nbruite/vacuum/2-采购合同/塑料件/塑料模具报价单/塑料模具报价清单-何国芳.jpg

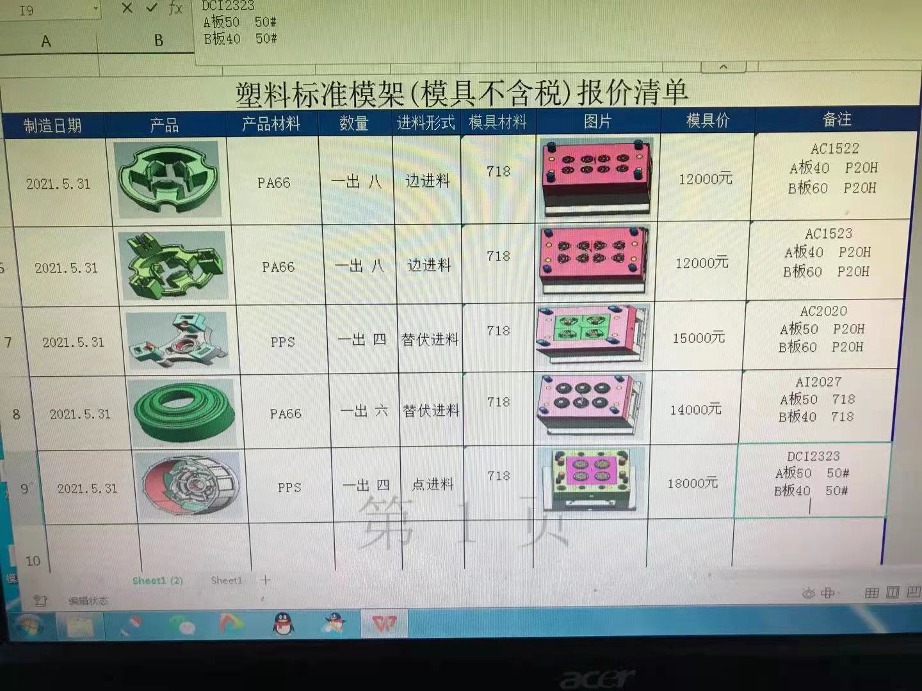
2-采购合同/塑料件/塑料模具报价单/塑料模具报价清单-何国芳.jpg
