nbruite/vacuum/2-采购合同/胶水/科宝胶水1.jpg

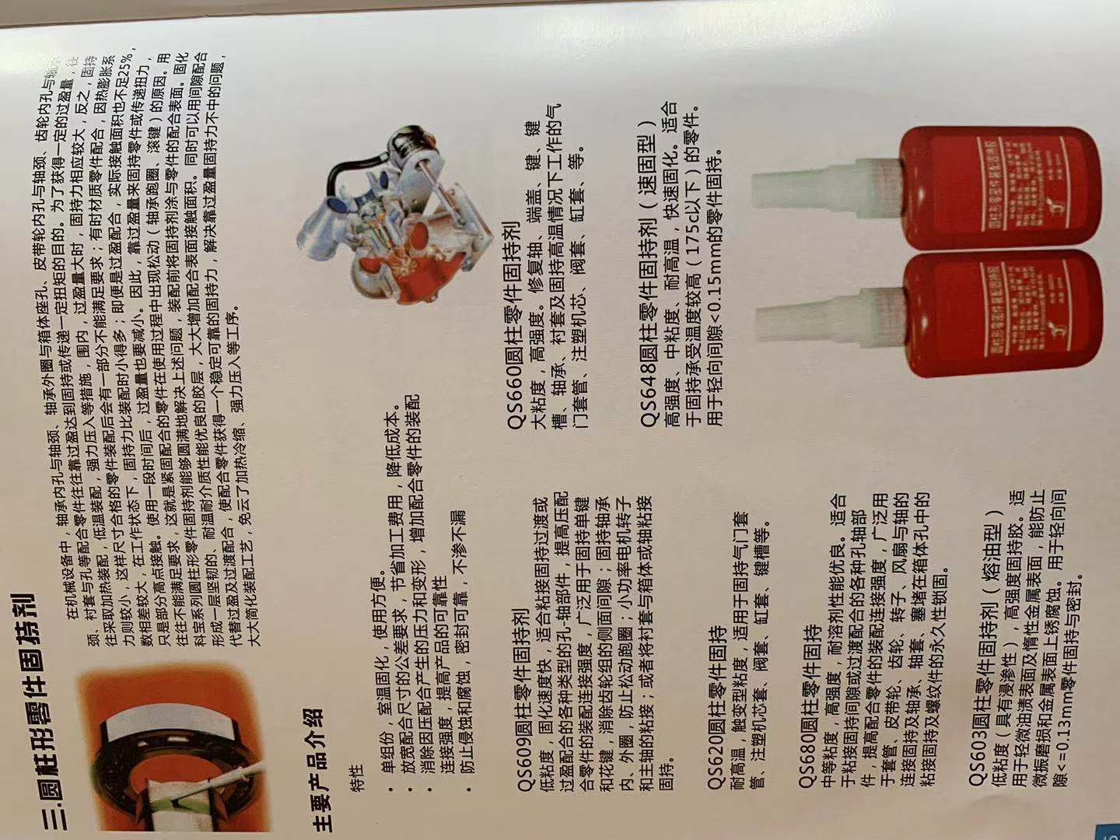
2-采购合同/胶水/科宝胶水1.jpg
