nbruite/vacuum/README.md

# vacuum
吸尘器电机项目 
### 样品阶段  
- 每日更新`吸尘器风机BOM`  
- 每日更新`当前进展&问题`
