nbruite/vacuum/3-加工图纸/2-晨光（A型）/4-方案四/方案4-2021.5.20/方案四图纸说明.txt

方案四图纸说明：
1、T型垫片，由于3D打印误差，高度暂时改为3.5mm，后续开模需要改为3mm；
2、前后端盖部分尺寸由于3D打印误差而放大，后续开模需要重新校对尺寸
