nbruite/vacuum/4-电机测试/塑料成分分析/宁波市海曙锐特冲压制品 成分分析报告2021.6.9前端盖.pdf

# 检 测 报 告

报告编号：NBPTC2106078001005-002MA | 第 1 页 共 2 页

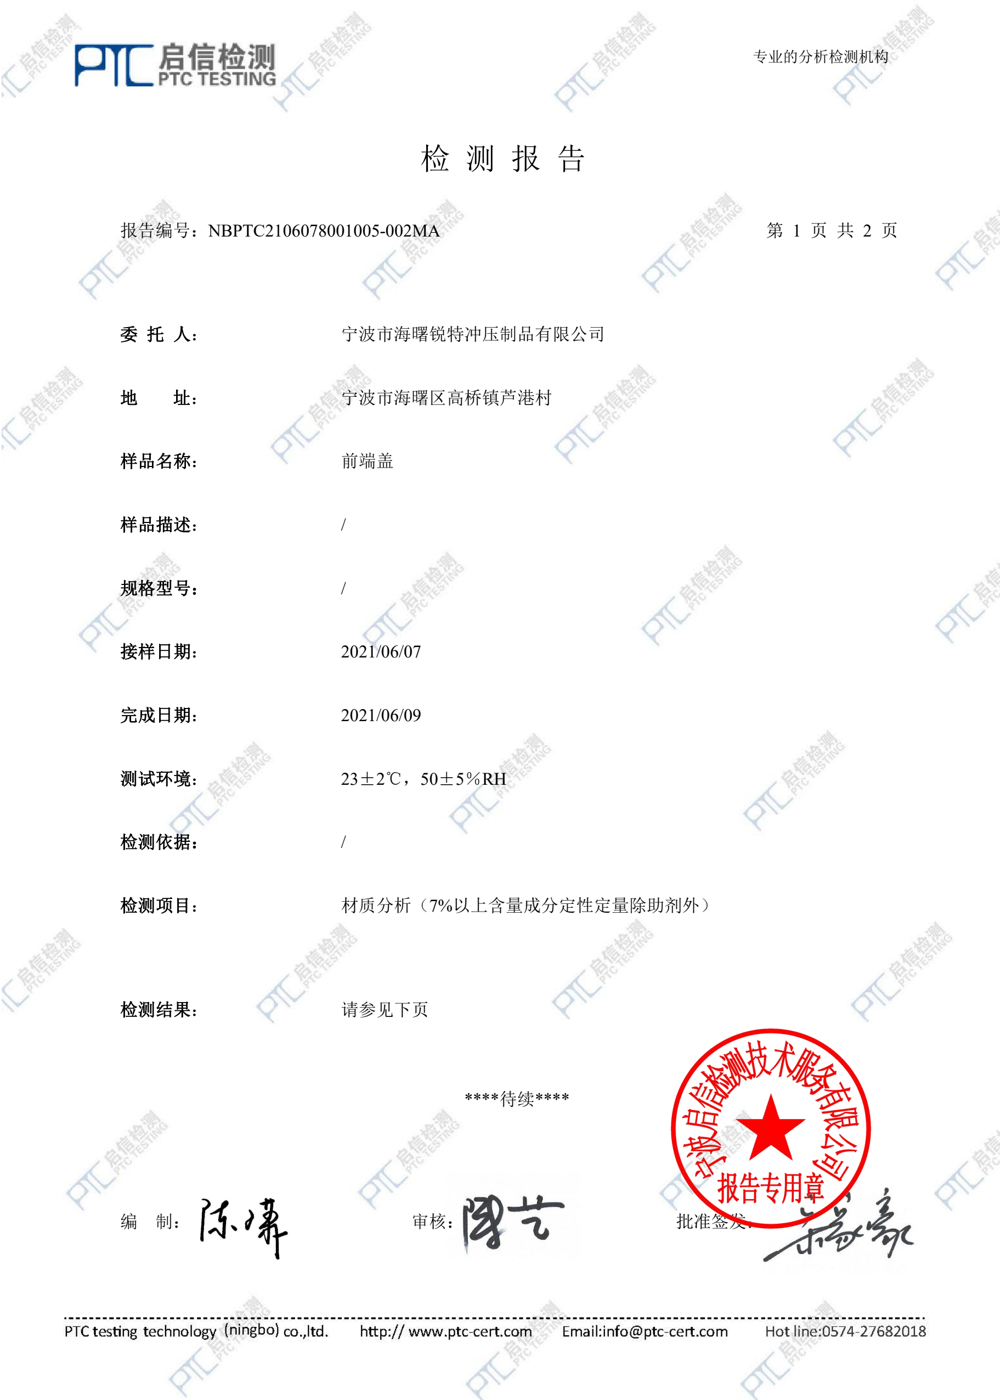
[picture p5: page 1]

专业的分析检测机构

委 托 人： | 宁波市海曙锐特冲压制品有限公司
地 | 址： | 宁波市海曙区高桥镇芦港村
样品名称： | 前端盖
样品描述： | /
规格型号： | /
接样日期： | 2021/06/07
完成日期： | 2021/06/09
测试环境： | 23±2℃，50±5％RH
检测依据： | /
检测项目： | 材质分析（7%以上含量成分定性定量除助剂外）
检测结果： | 请参见下页
****待续**** 编 制： | 审核： | 批准签发：

# 检 测 报 告

报告编号：NBPTC2106078001005-002MA | 第 2 页 共 2 页

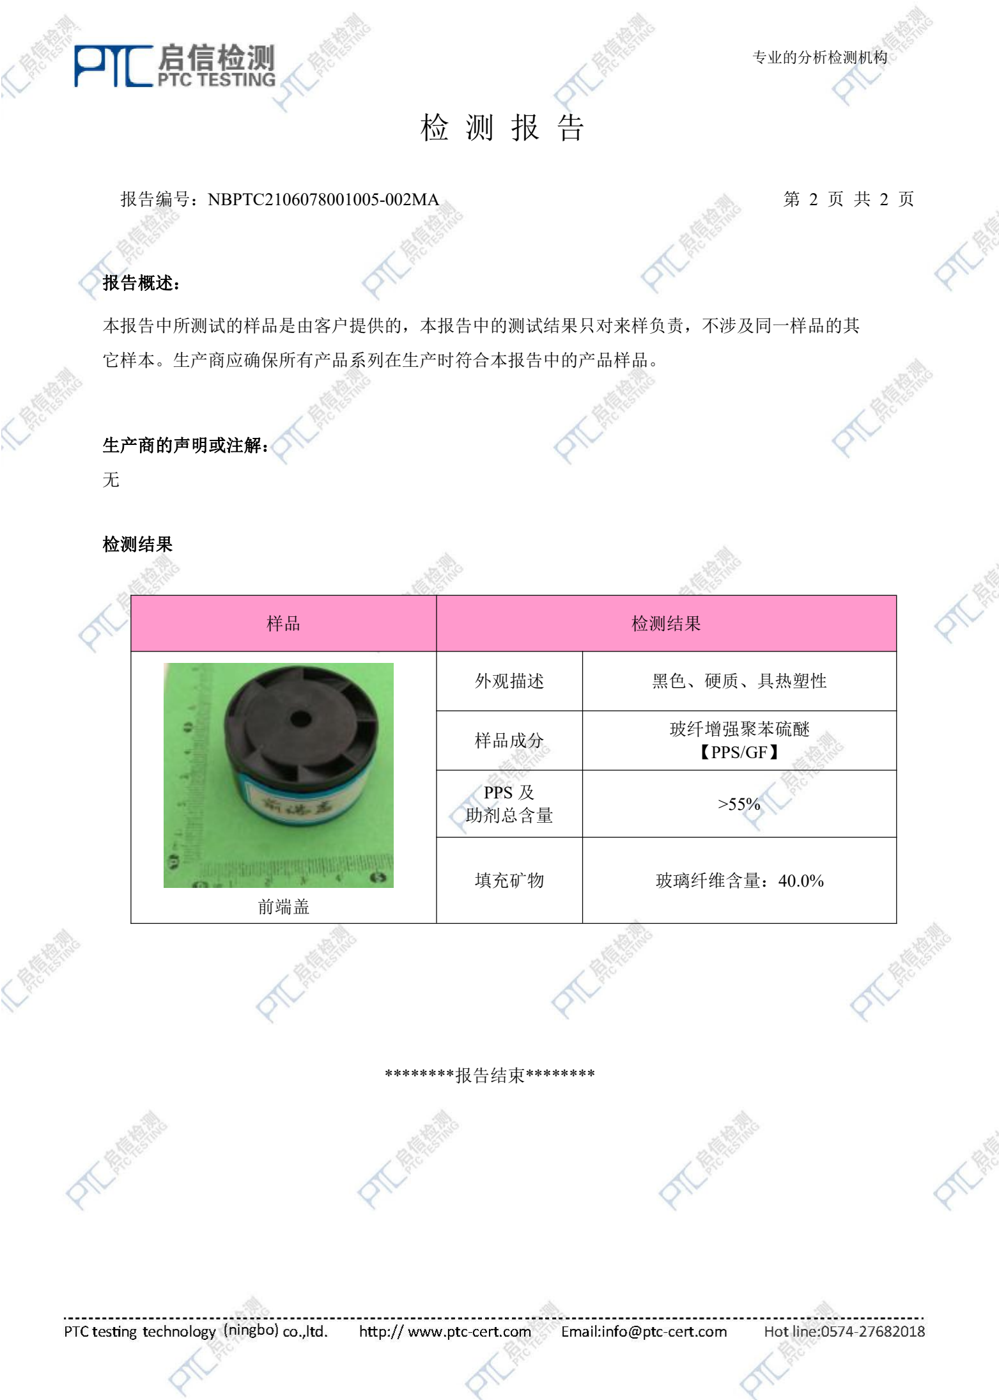
[picture p6: page 2]

专业的分析检测机构

报告概述：

本报告中所测试的样品是由客户提供的，本报告中的测试结果只对来样负责，不涉及同一样品的其

它样本。生产商应确保所有产品系列在生产时符合本报告中的产品样品。

生产商的声明或注解：

无

检测结果

## ********报告结束********

样品 | 检测结果
前端盖 | 外观描述 | 黑色、硬质、具热塑性
| 样品成分 | 玻纤增强聚苯硫醚 【PPS/GF】
| PPS 及 助剂总含量 | >55%
| 填充矿物 | 玻璃纤维含量：40.0%
