nbruite/vacuum/当前进展&问题.md

# 进展说明  

-----
## 2021.3.11  
### 进展：  
1. **磁钢**询问金科和鑫丰磁业，由于尺寸特殊，金科没有现货，鑫丰预计<b><font color=red>3月底</font></b>做完，等待询问永久磁业；  
2. 测绘晨光电机和戈雷姆电机的**前端盖**，<b><font color=red>下周一</font></b>取图纸； 
3. **T型垫柱**买铝棒车，**圆垫片**买铝片激光切割，**铜端子**买铜片激光切割，<b><font color=red>本周</font></b>完成；  
4. **定子铁芯**已出图纸，等待激光切割，<b><font color=red>本周</font></b>完成。    

### 遗留问题：  
1. **nmb轴承**当前零售采购价`3.2元/个`，价格较高，后期需要与厂家协商降低成本；  
2. 等待下周一出图纸后，联系浙大老师评估三款**前端盖风道**好坏；  
3. `M3厚度为4`的**六角螺母**标准件支持最大厚度`2.4`，测试暂时用2个螺母叠加；  
4. 晨光电机使用**漆包线**外径`<0.71`，测试统一暂用`0.71`。  

## 2021.3.12  
### 进展：  
1. **叶轮**联系合丰电器，预计**下周一**寄出`5个`样品；  
2. **风罩**、**前后端盖**、**上下骨架**联系宁波创辉3D打印公司制作，先做`1套`样品，**四个工作日**完成。  

### 遗留问题：  
1. **nmb轴承**当前零售采购价`3.2元/个`，价格较高，后期需要与厂家协商降低成本；  
2. 等待下周一出图纸后，联系浙大老师评估三款**前端盖风道**好坏；  
3. `M3厚度为4`的**六角螺母**标准件支持最大厚度`2.4`，测试暂时用2个螺母叠加；  
4. 晨光电机使用**漆包线**外径`<0.71`，测试统一暂用`0.71`；  
5. 轴承厂还在寻找找到合适的。 

## 2021.3.15  
### 进展：  
1. **叶轮**已发货；  
2. **风道**扫描出图纸，已经联系浙大老师评估；  

### 遗留问题：  
1. **nmb轴承**当前零售采购价`3.2元/个`，价格较高，后期需要与厂家协商降低成本；  
2. `M3厚度为4`的**六角螺母**标准件支持最大厚度`2.4`，测试暂时用2个螺母叠加；  
3. 晨光电机使用**漆包线**外径`<0.71`，测试统一暂用`0.71`；  
4. 轴承厂目前只有宁波奉化荣锋悦五金厂可以做；  
5. **叶轮**需要联系合丰电器要`9个`叶片的样品。   

## 2021.3.16  
### 进展：  
1. 联系合丰电器定了`8`叶片的**叶轮**，苏州弗来特询问后不愿意做；  
2. 新联系**轴**厂家，明天报价。  

### 遗留问题：  
1. **nmb轴承**当前零售采购价`3.2元/个`，价格较高，后期需要与厂家协商降低成本；  
2. `M3厚度为4`的**六角螺母**标准件支持最大厚度`2.4`，测试暂时用2个螺母叠加；  
3. 晨光电机使用**漆包线**外径`<0.71`，测试统一暂用`0.71`。  

## 2021.3.17  
### 进展：  
1. 合丰电器`8`叶片的**叶轮**样品已寄出；  
2. 新联系的**轴**厂家生产任务排满，批量做报价`1.2元`；  
3. 激光切割件预计`3.22`完成；  
4. 3D打印和精雕件已完成，安排寄出。  

### 遗留问题：  
1. **nmb轴承**当前零售采购价`3.2元/个`，价格较高，后期需要与厂家协商降低成本；  
2. `M3厚度为4`的**六角螺母**标准件支持最大厚度`2.4`，测试暂时用2个螺母叠加；  
3. 晨光电机使用**漆包线**外径`<0.71`，测试统一暂用`0.71`。  

## 2021.3.18  
### 进展：  
1. 合丰电器`8`叶片**叶轮**已收到；  
2. 3D打印和精雕件已收到；  
3. 当前除**轴**和**磁钢**要月底左右到位，其余零部件下周内均可到位，可以启动安装调试。  

### 遗留问题：  
1. **nmb轴承**当前零售采购价`3.2元/个`，价格较高，后期需要与厂家协商降低成本；  
2. `M3厚度为4`的**六角螺母**标准件支持最大厚度`2.4`，测试暂时用2个螺母叠加；  
3. 晨光电机使用**漆包线**外径`<0.71`，测试统一暂用`0.71`；  
4. **轴**厂家需要再寻找，月底前完成。  

## 2021.3.26  
### 进展：  
1. 新增`吸尘器电机测试方案`;  
2. **轴**采购订单已下，预计4.12左右完成；  
3. 明天开始定转子装配测试  

### 遗留问题：  
1. **nmb轴承**当前零售采购价`3.2元/个`，价格较高，后期需要与厂家协商降低成本；  
2. `M3厚度为4`的**六角螺母**标准件支持最大厚度`2.4`，测试暂时用2个螺母叠加；  
3. 晨光电机使用**漆包线**外径`<0.71`，测试统一暂用`0.71`；  
4. 测试设备待协调；  
5. **轴**和**磁钢**到位较慢，先暂时用原有拆机件测试
