nbruite/vacuum/2-采购合同/T型垫片&六角螺母/单位名称.docx

单位名称：宁波市海曙古林明顺五金厂

税 号：92330203MA283KTA5Q

地 址：宁波市海曙区古林镇张家潭村 15158345558

开户银行及账号：宁波鄞州农村商业银行股份有限公司古林支行布政分理处 81260201302178626
