nbruite/vacuum/2-采购合同/塑料件/采 购 合 同(1).docx

采 购 合 同

买方：宁波市海曙锐特冲压制品有限公司

卖方：慈溪市掌起镇发发塑料五金厂

一.

产品名称 | 计量单位 | 数量 | 单价 | 备注
绝缘骨架 | 套 | 按订单 | 0.2元 | 上骨架0.07元，下骨架0.13元。上下2个为一套

2． 质量要求，技术标准：卖方按买方提供的技术图纸要求生产供货。
3． 包装标准：双方待定
4． 交货运输：卖方承担
5． 货款结算方式及期限：买方收到发票后，30天内支付货款
6． 解决合同纠纷约定法式：双方协商处理，协商不成依法向人民法院起诉。
7． 其他未尽事宜，双方另行协商。合同一式两份，双方各执一份。双方签字盖章后生效。

买方 ：宁波市海曙锐特冲压制品有限公司 卖方：慈溪市掌起镇发发塑料五金厂

地址： 地址：慈溪市掌起镇青山北1

电话： 电话：

联系人： 联系人：
