nbruite/vacuum/2-采购合同/T型垫片&六角螺母/PO2021080404-明顺五金-扫描.pdf

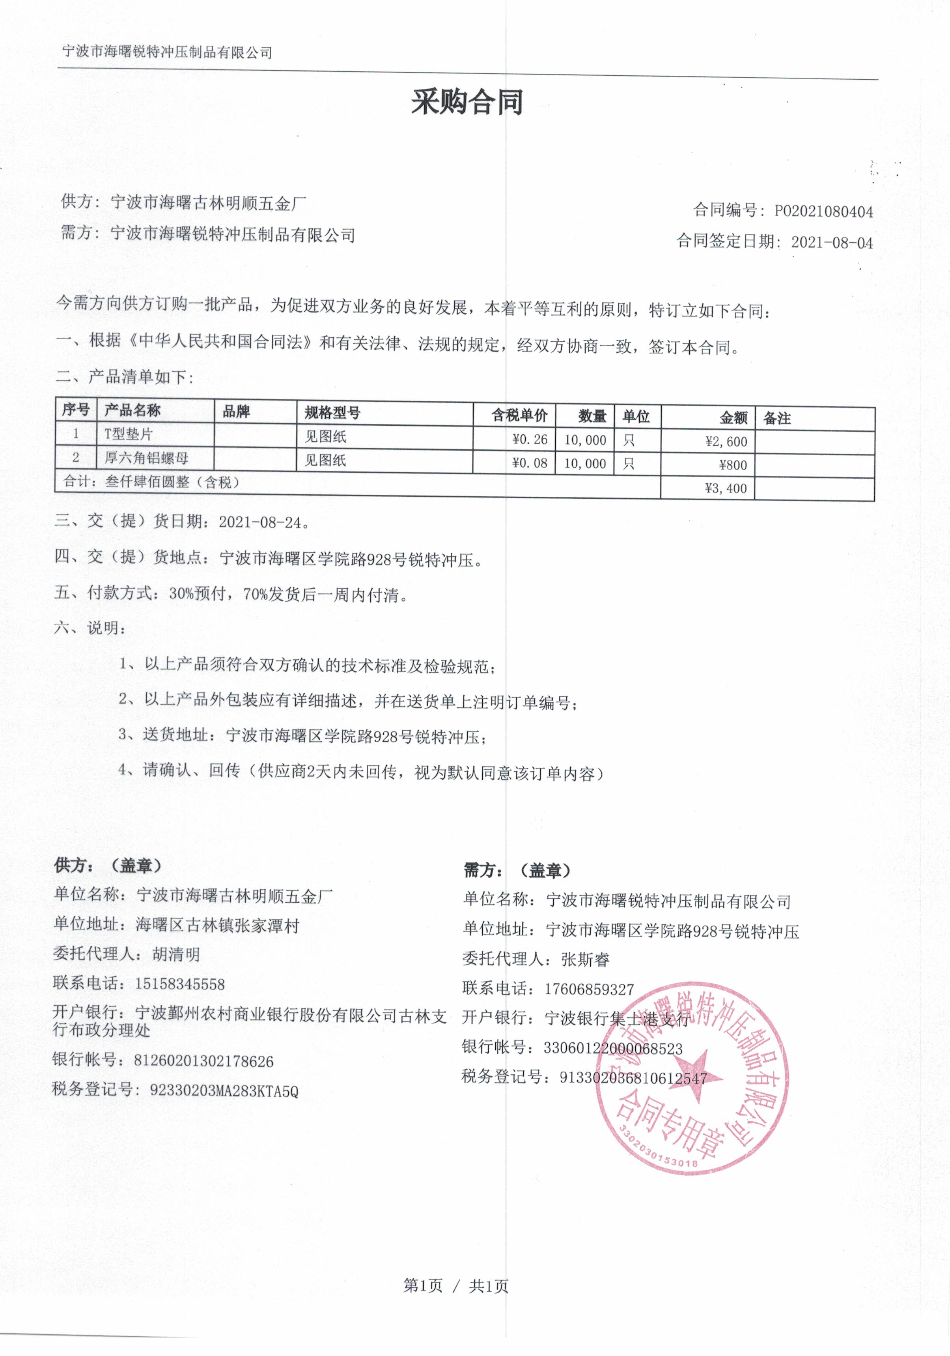
[picture p20: page 1]
