nbruite/vacuum/2-采购合同/动叶轮/C11382100DKCZ图纸-签字盖章.pdf

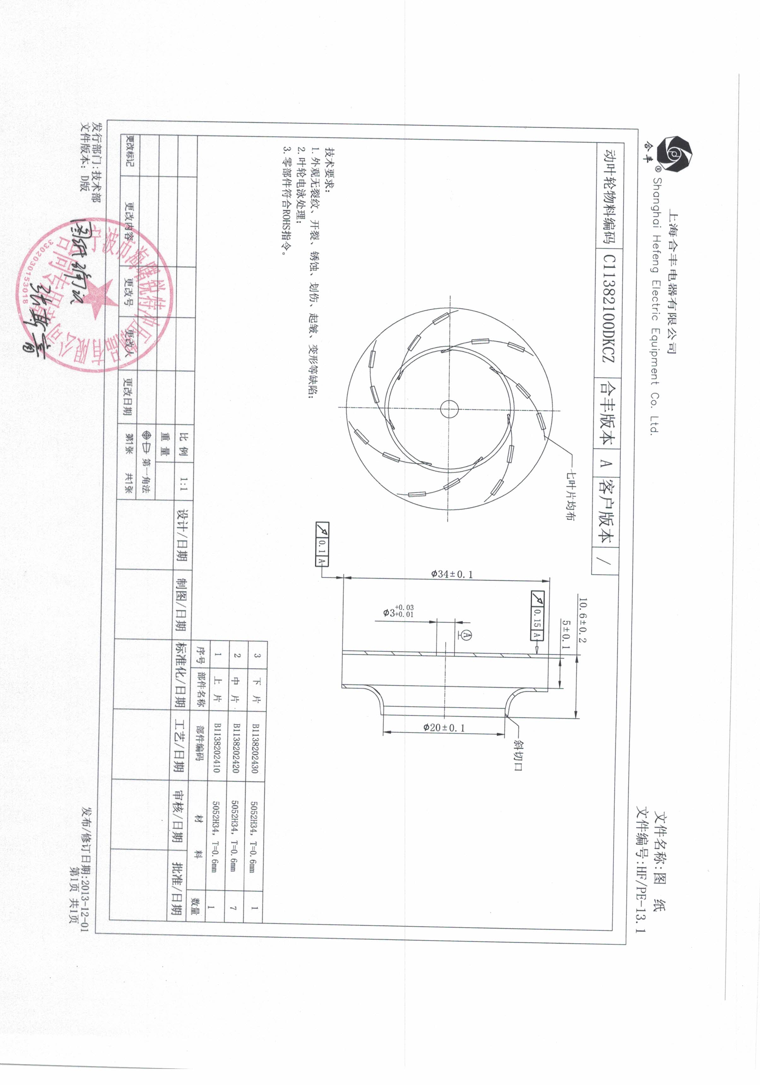
[picture p21: page 1]
