nbruite/vacuum/2-采购合同/动叶轮/PO2021080303-合丰电器采购合同-确认.pdf

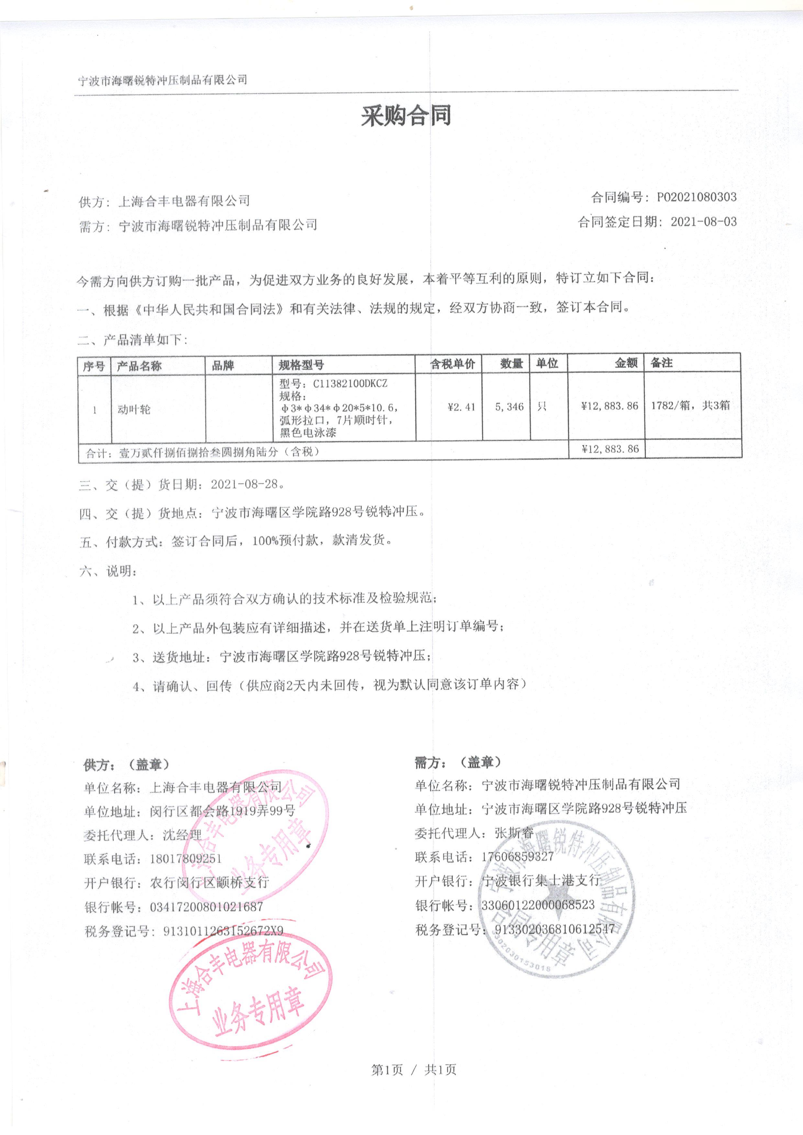
[picture p23: page 1]
