nbruite/vacuum/2-采购合同/动平衡机/动平衡机扫描合同.pdf

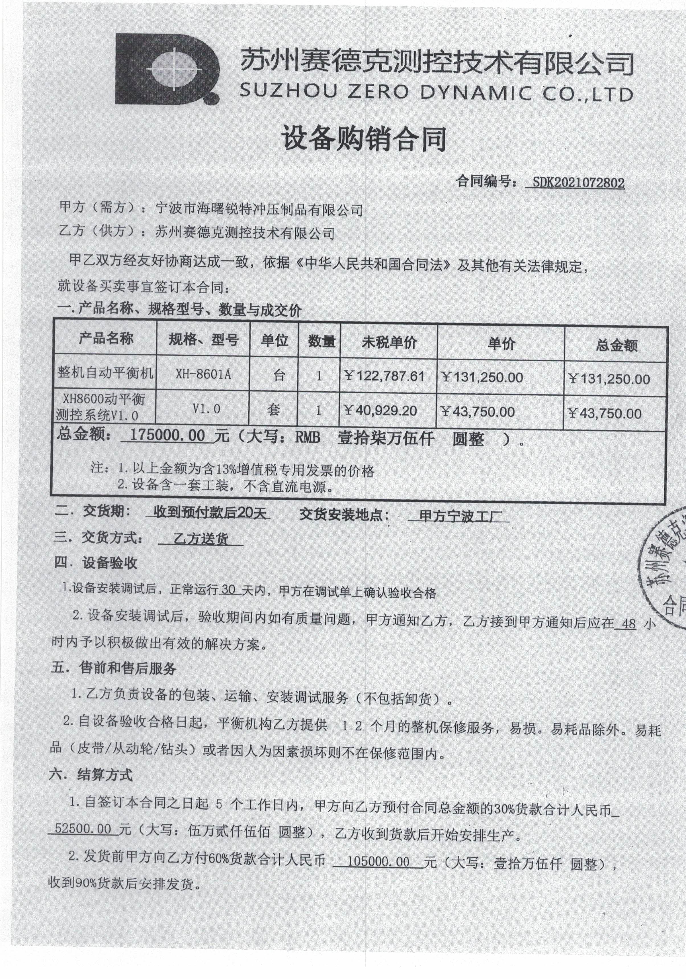
[picture p24: page 1]
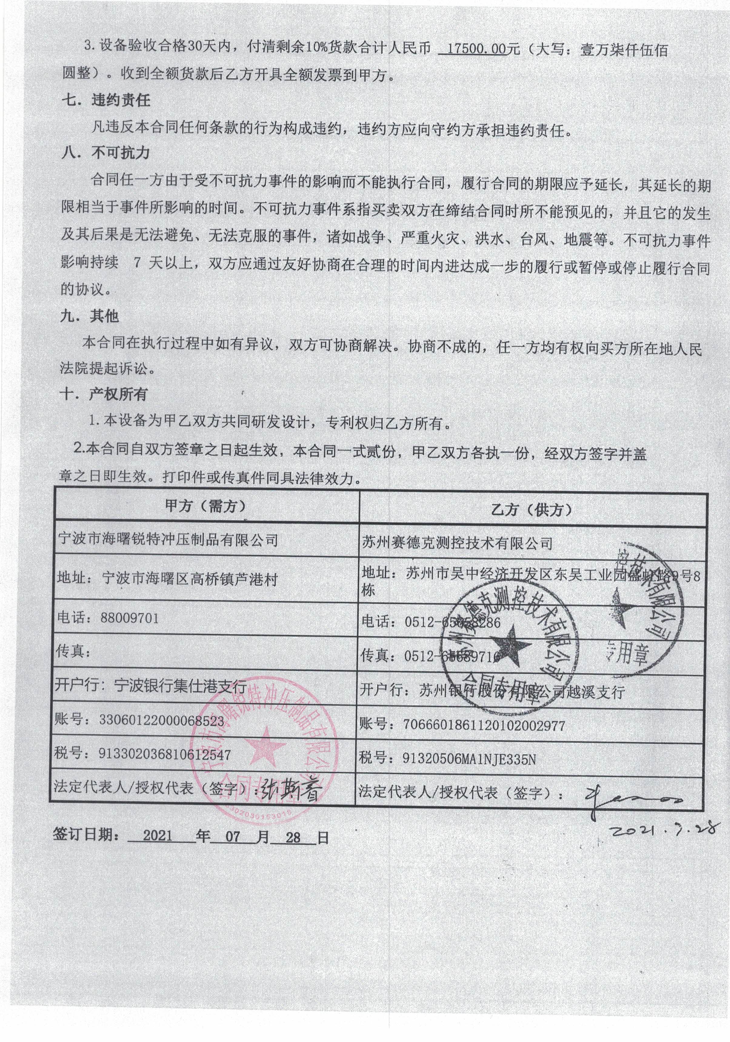
[picture p25: page 2]
