nbruite/vacuum/2-采购合同/磁钢/PO2021080405-慕磁-扫描.pdf

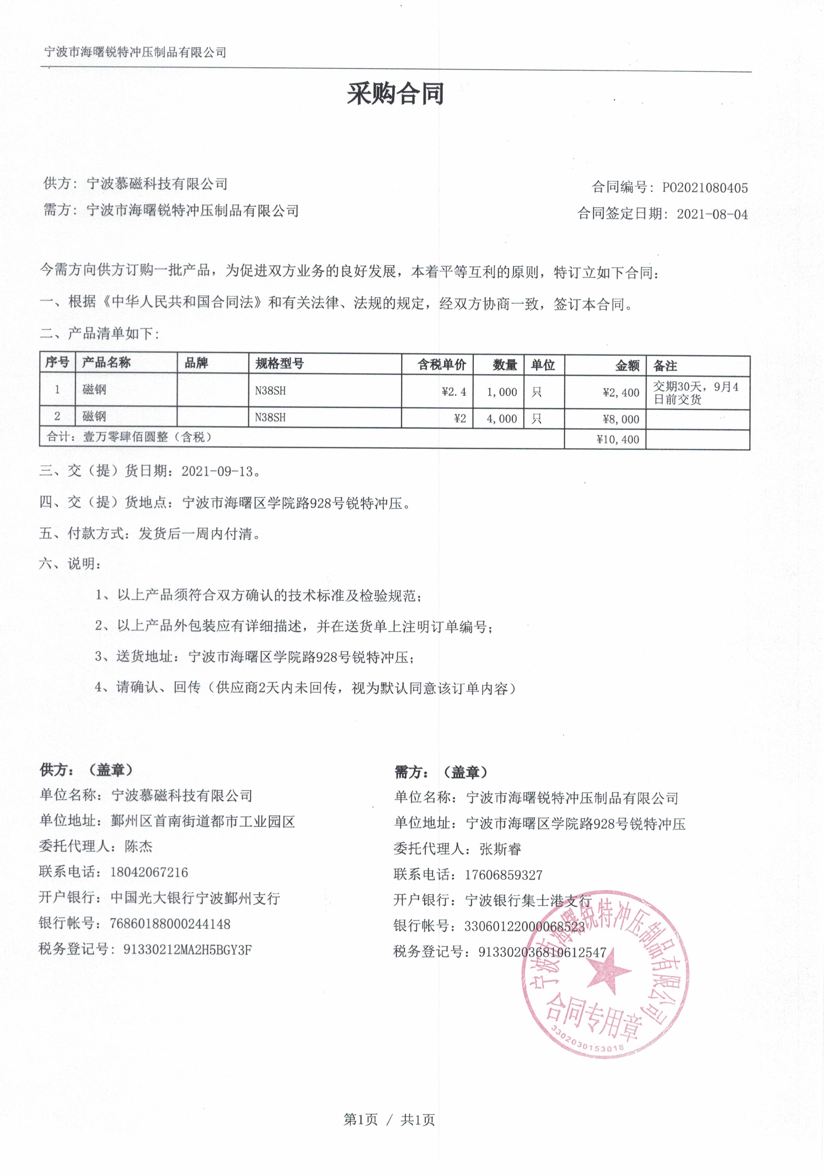
[picture p26: page 1]
