nbruite/vacuum/2-采购合同/磁钢/慕磁开票资料.pdf

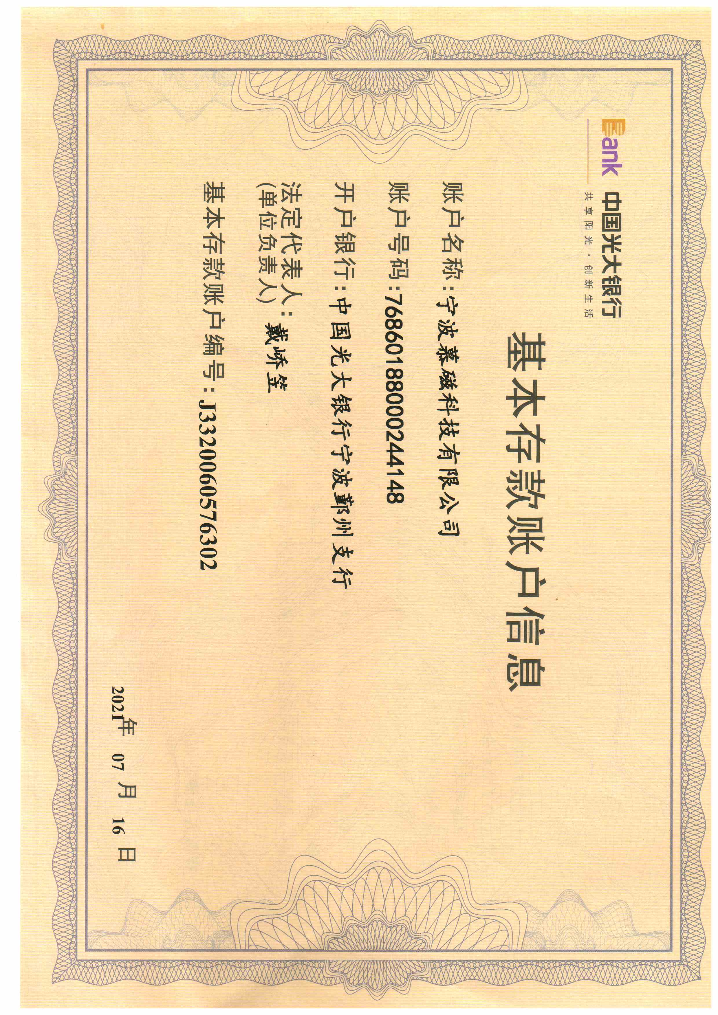
[picture p27: page 1]
