nbruite/vacuum/2-采购合同/磁钢/慕磁营业执照.pdf

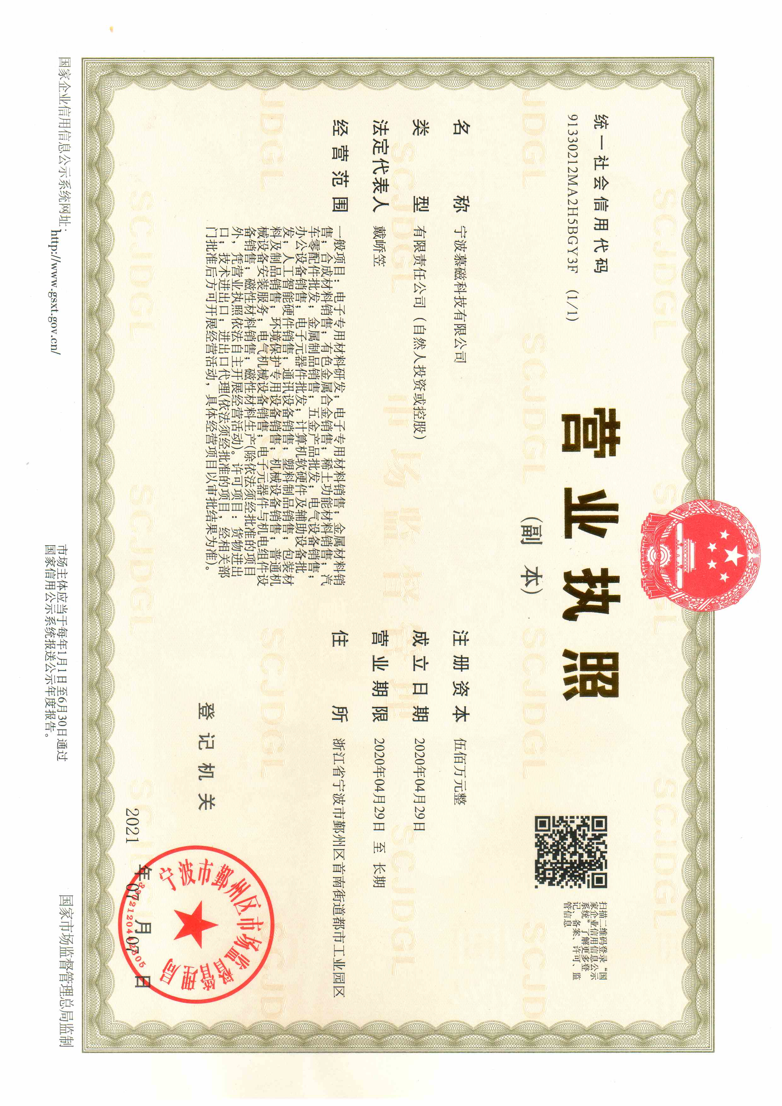
[picture p28: page 1]
