nbruite/vacuum/2-采购合同/紧固件/PO2021081001-利华紧固件-扫描.pdf

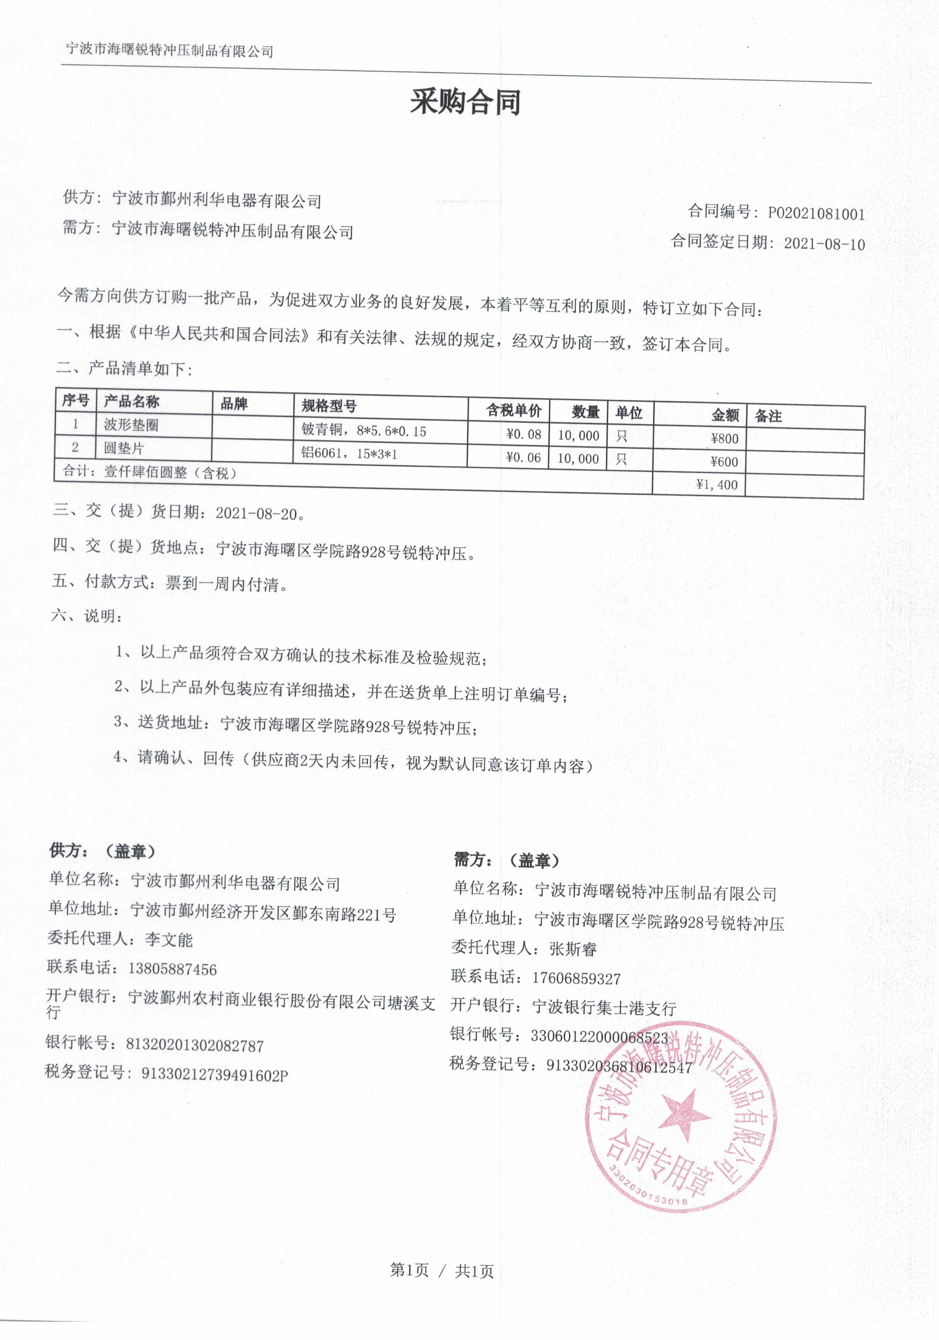
[picture p29: page 1]
