nbruite/vacuum/2-采购合同/轴/PO2021080501-科盛轴业-扫描.pdf

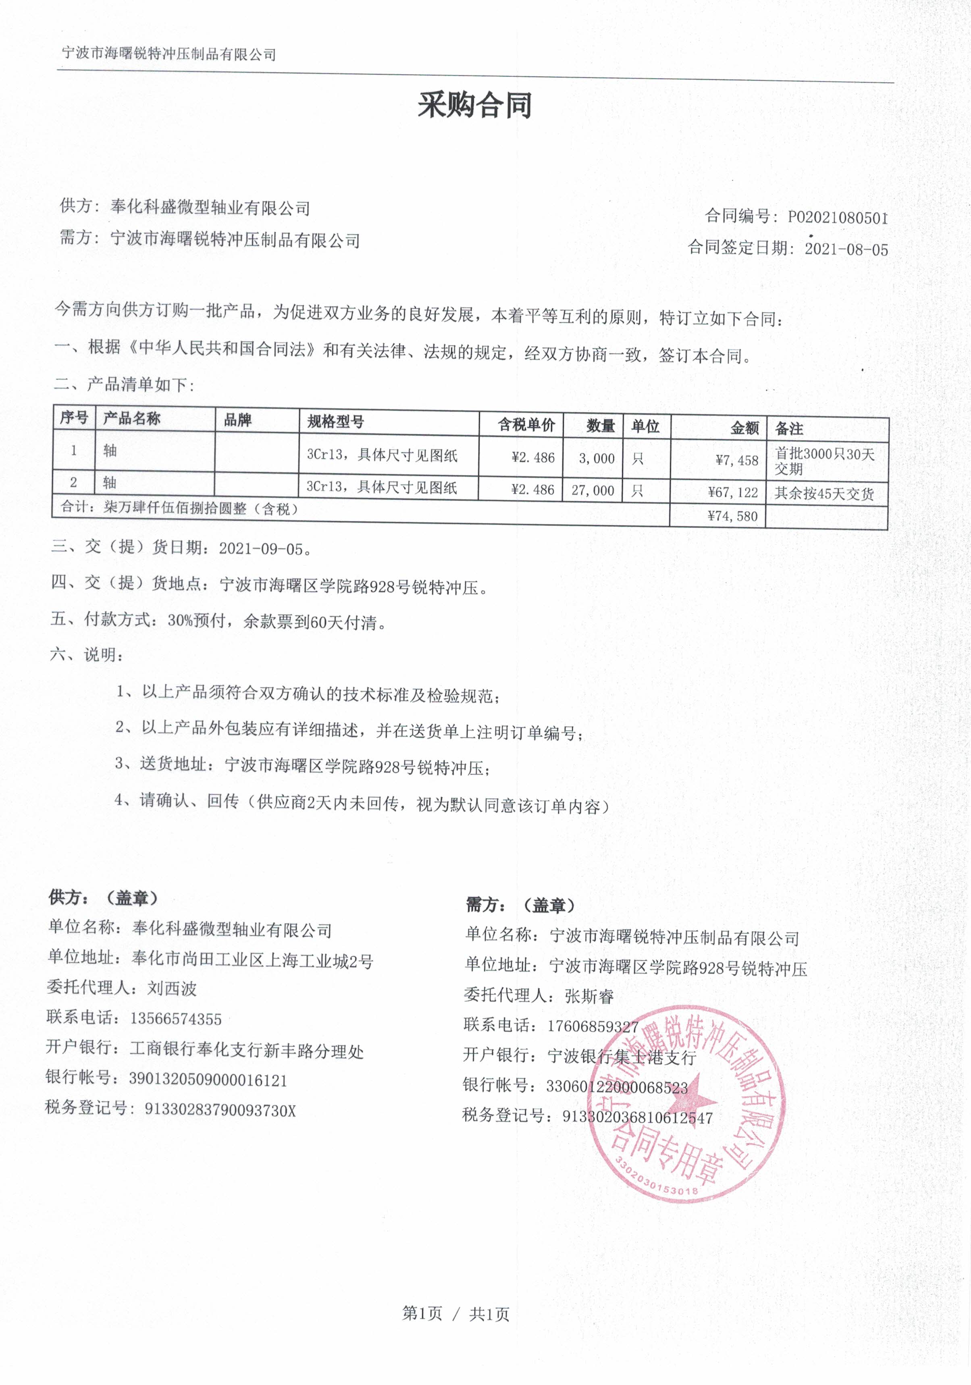
[picture p30: page 1]
