nbruite/vacuum/2-采购合同/轴/奉化科盛IATF16949证书.pdf

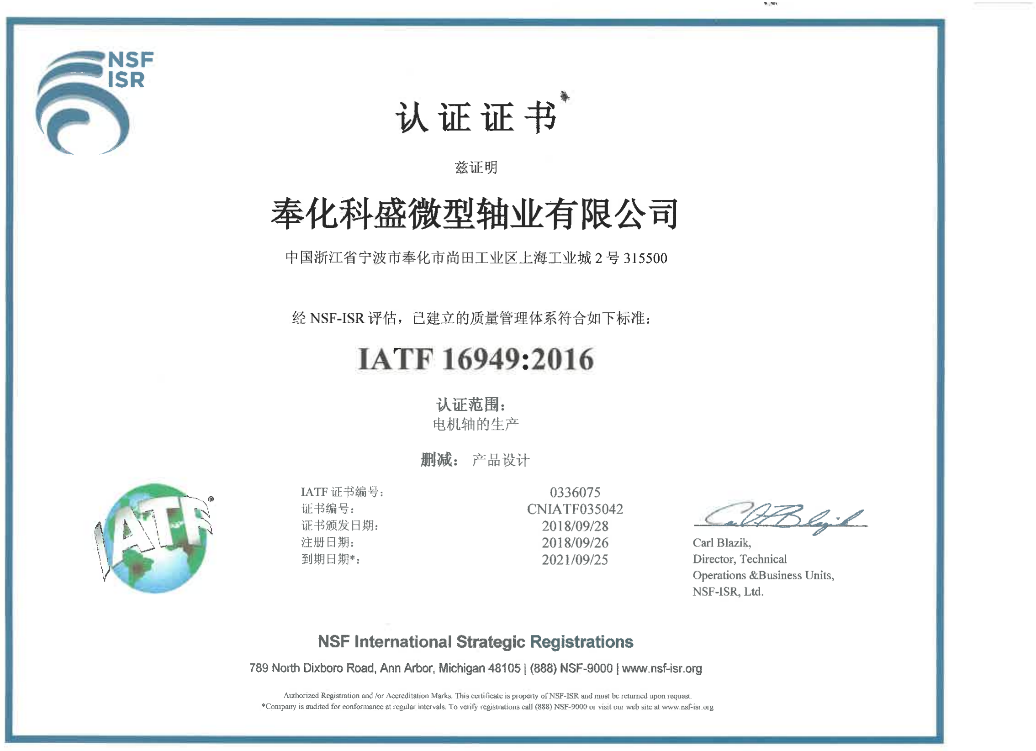
[picture p31: page 1]
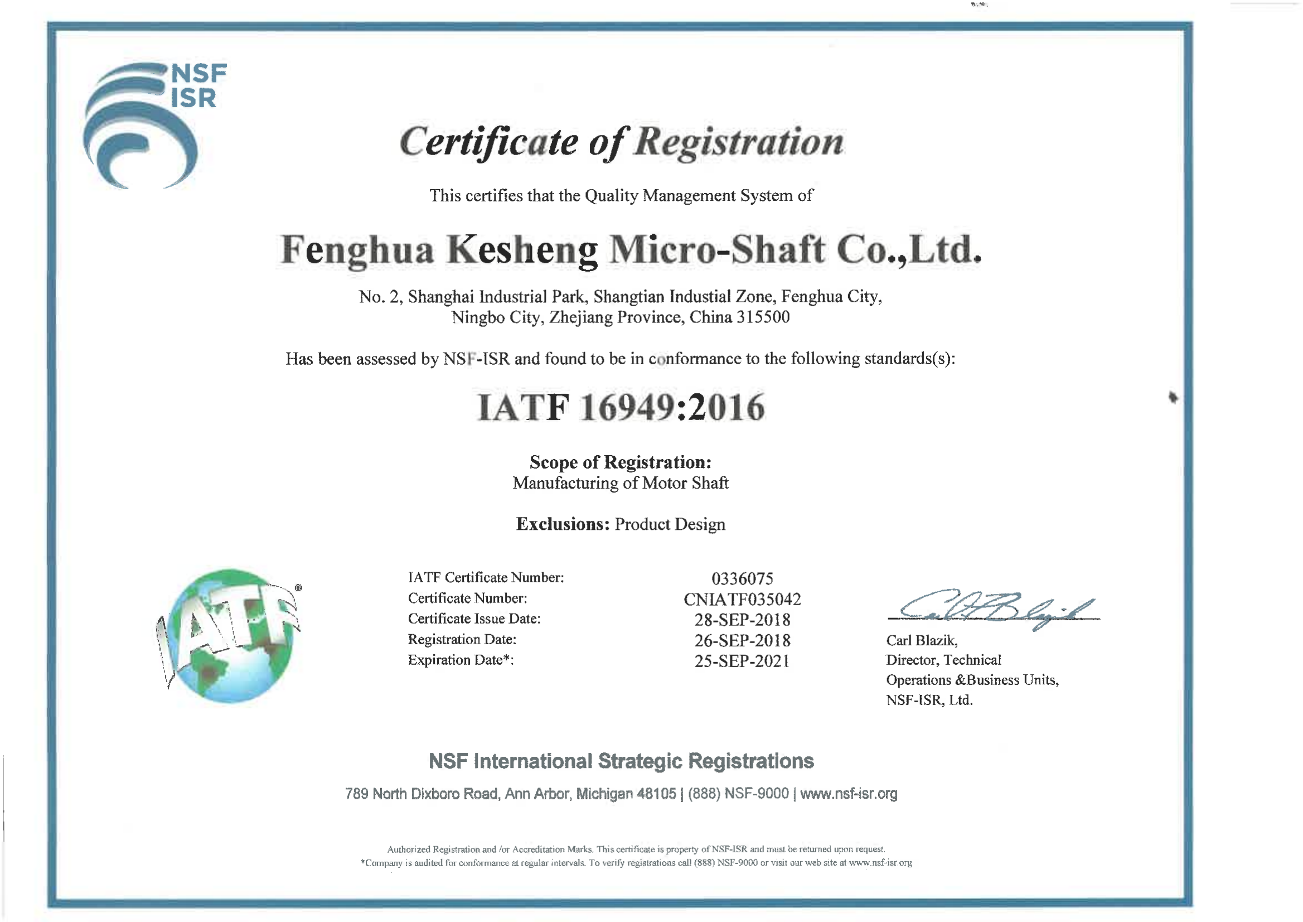
[picture p32: page 2]
