nbruite/vacuum/2-采购合同/动平衡机/8601A合同.pdf

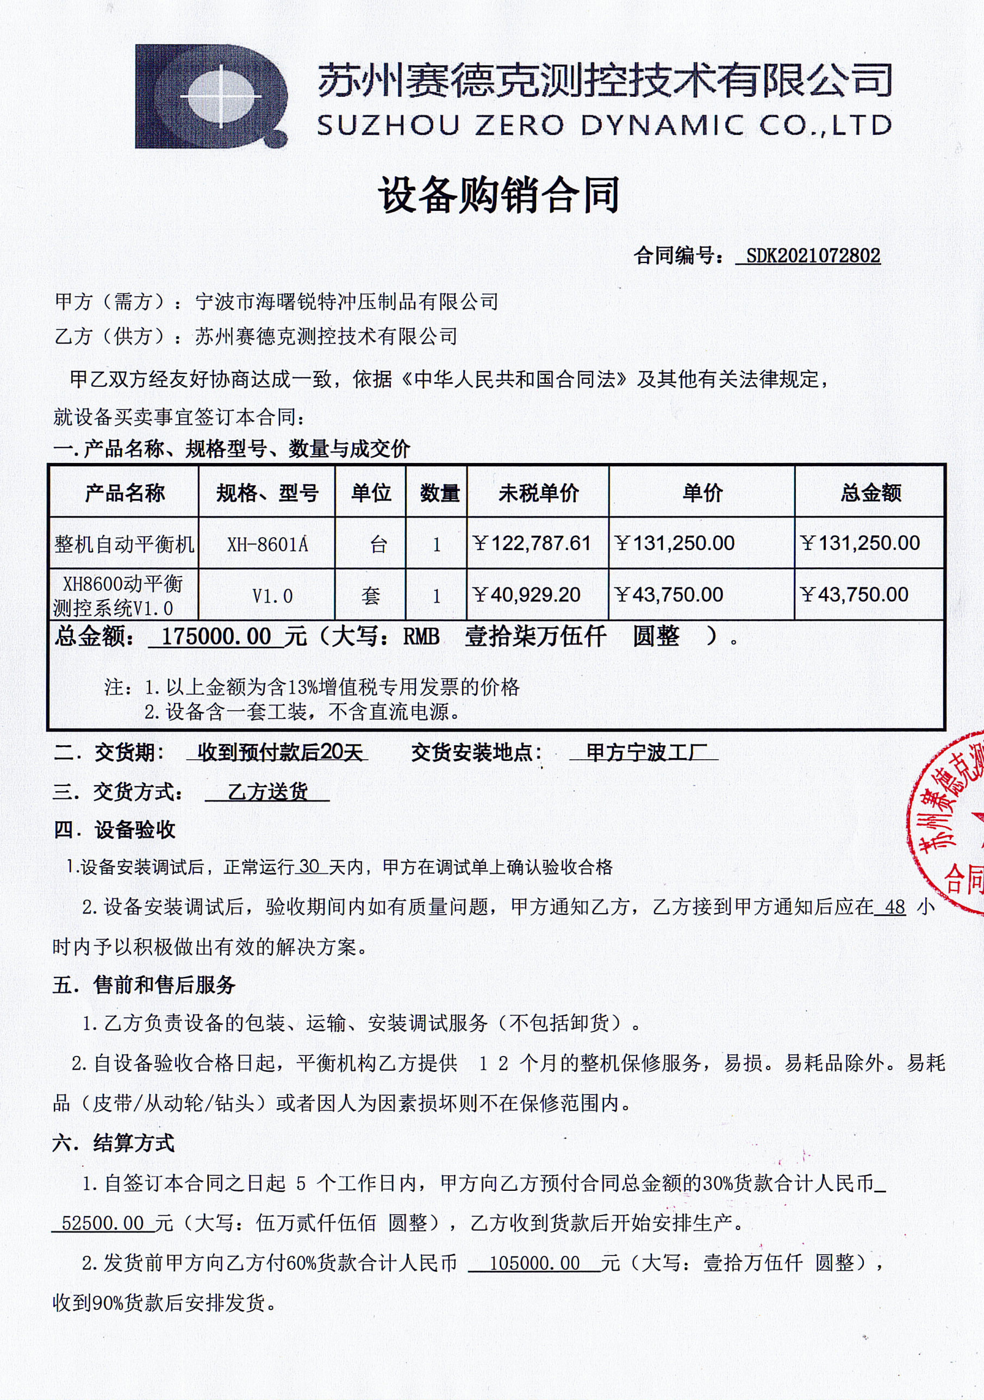
[picture p33: page 1]
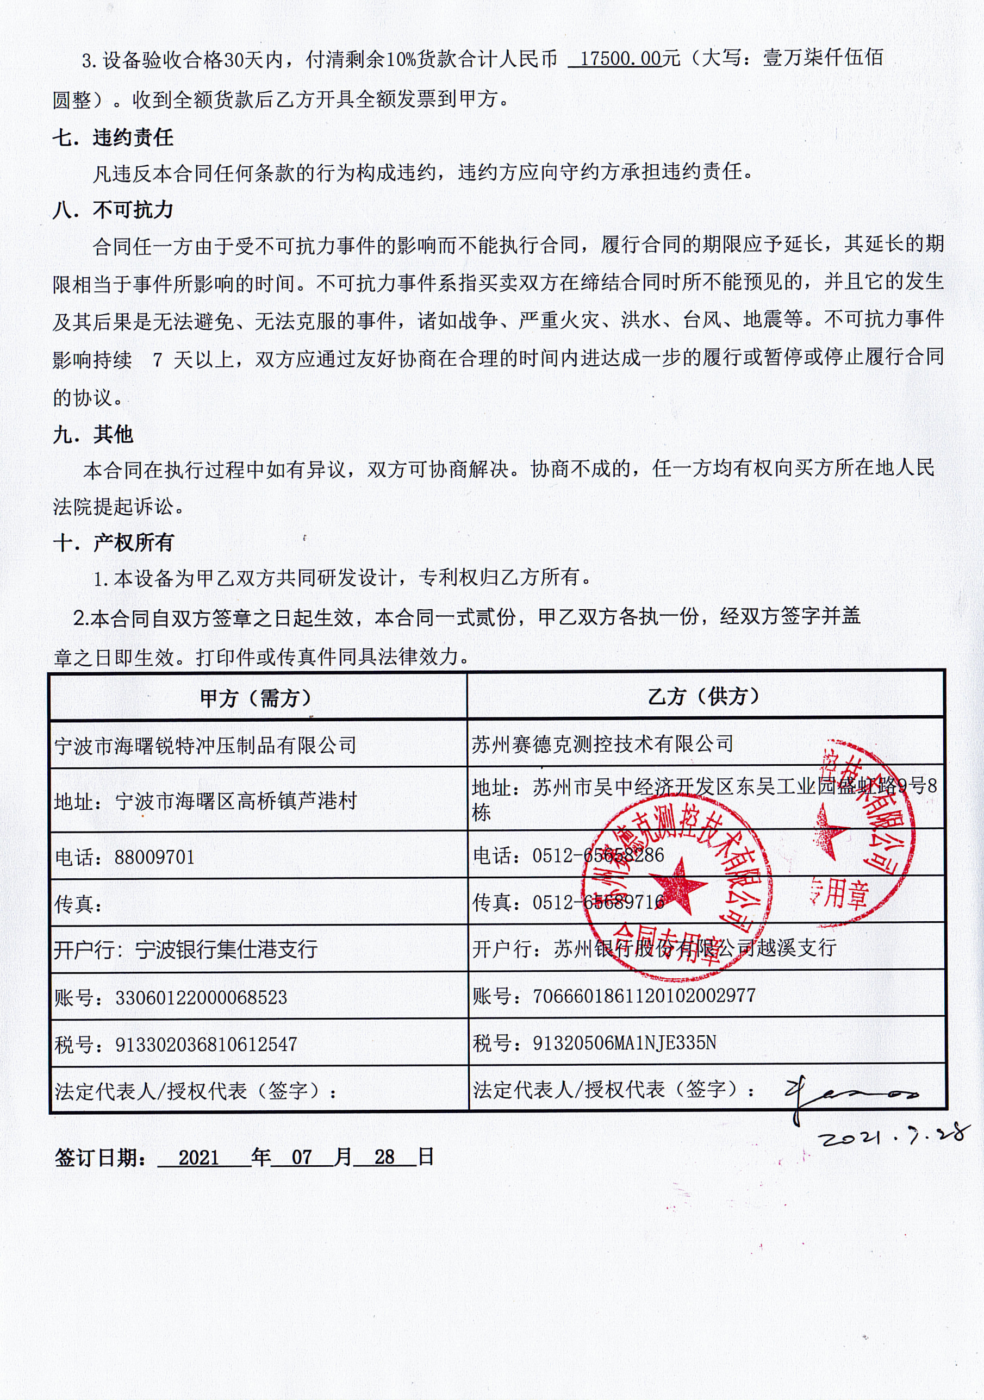
[picture p34: page 2]
