nbruite/vacuum/2-采购合同/磁钢/磁钢检验报告-2021.4.9.pdf

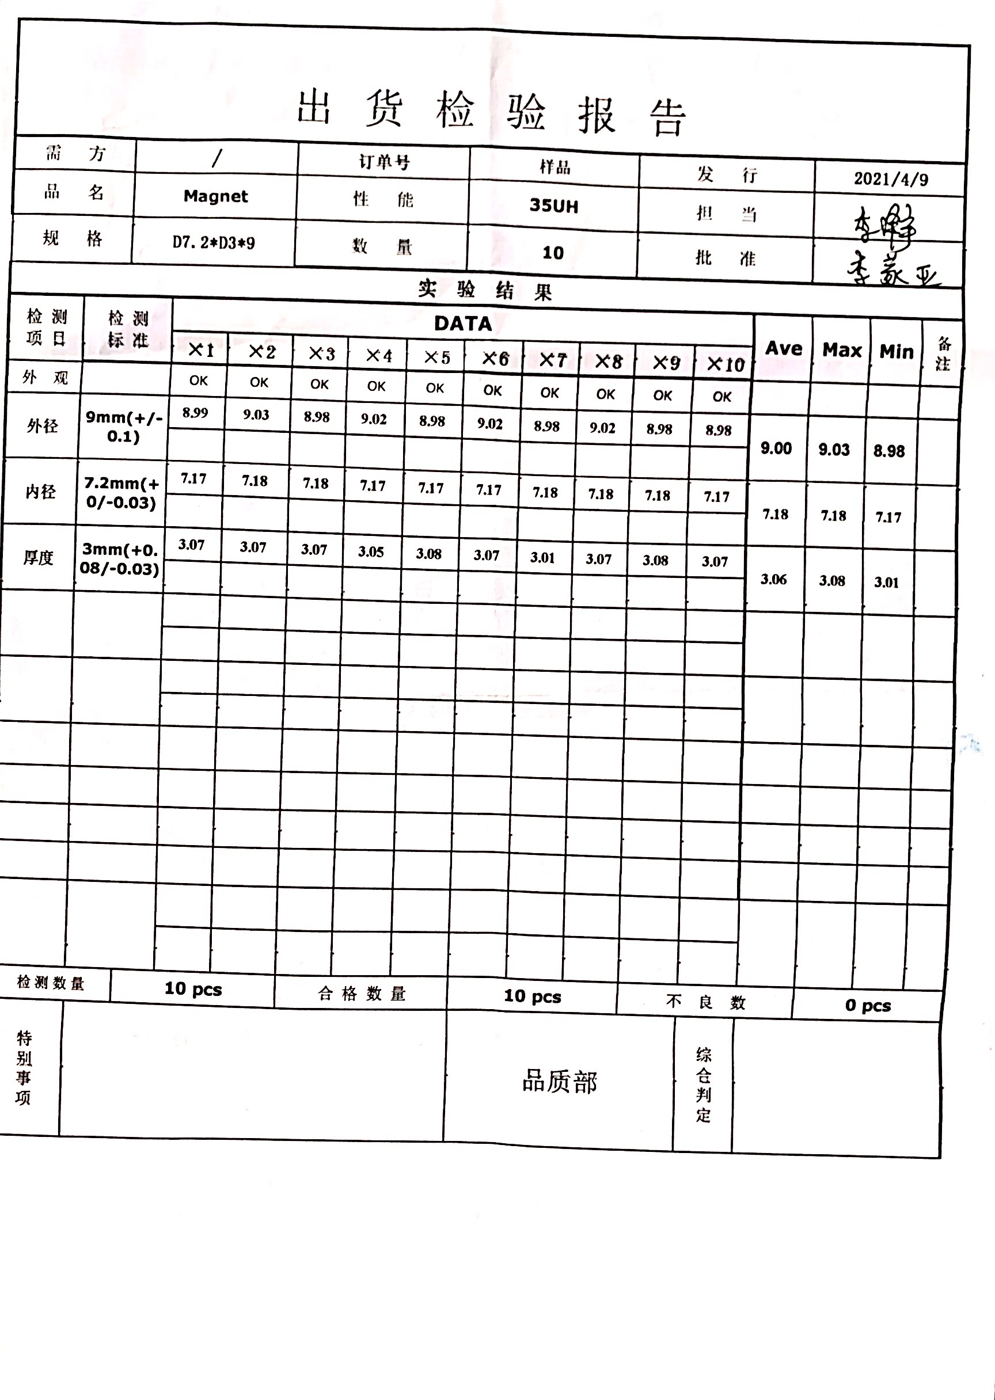
[picture p35: page 1]
