nbruite/vacuum/2-采购合同/磁钢/鑫丰磁业装箱单-2021.4.9.pdf

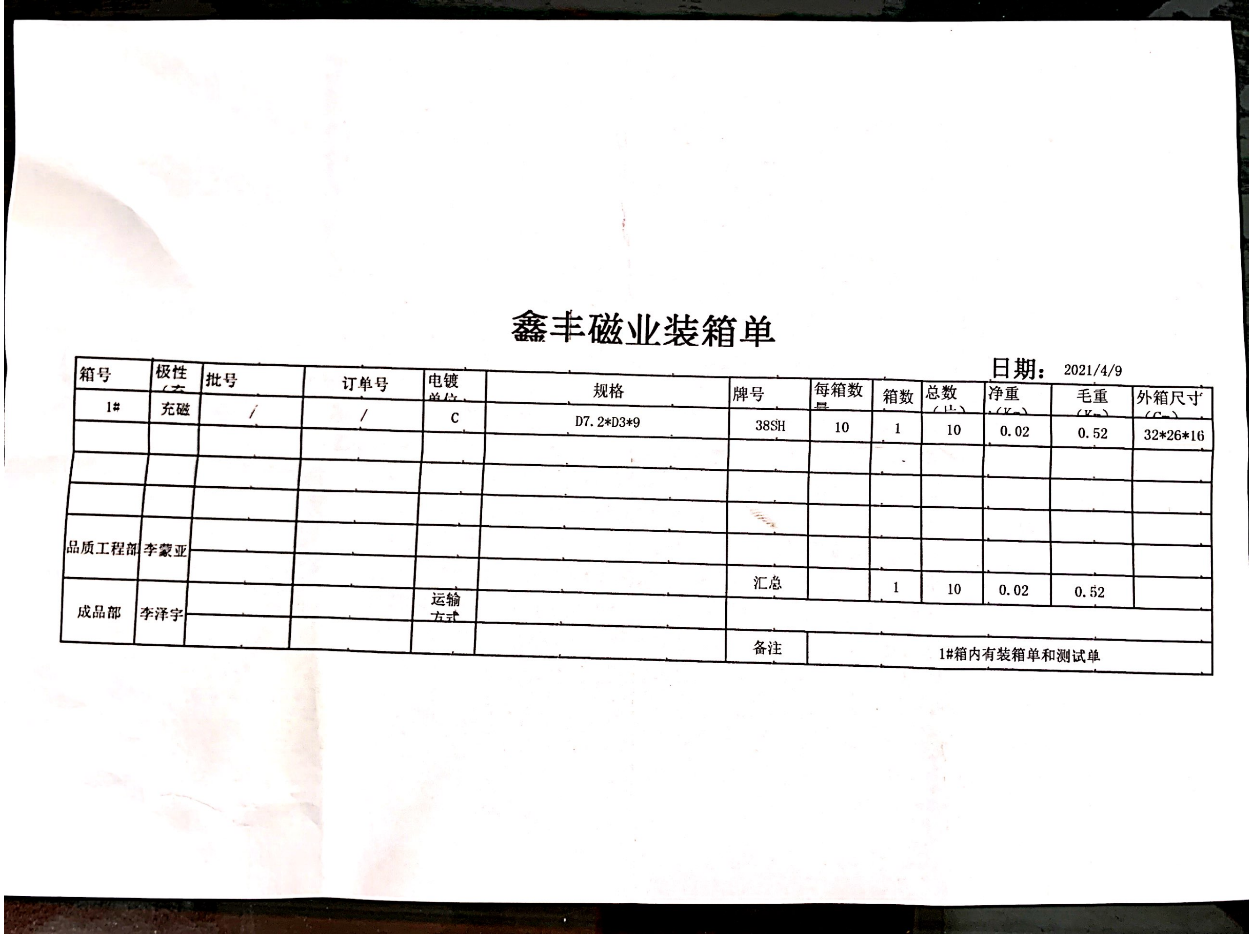
[picture p36: page 1]
