nbruite/vacuum/2-采购合同/轴/科盛电机轴检验报告.pdf

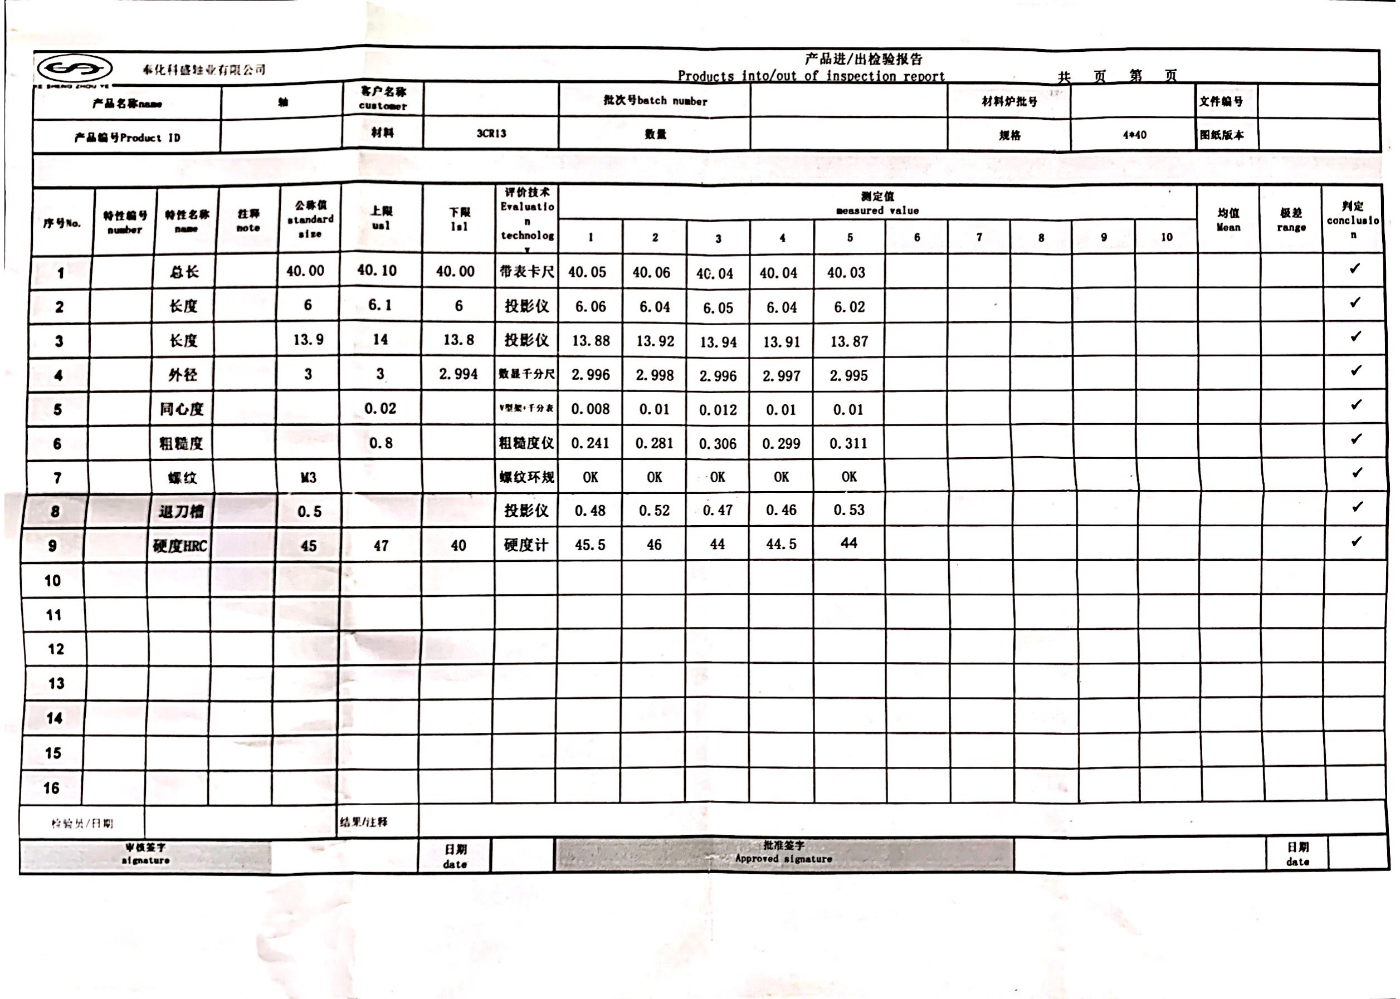
[picture p37: page 1]
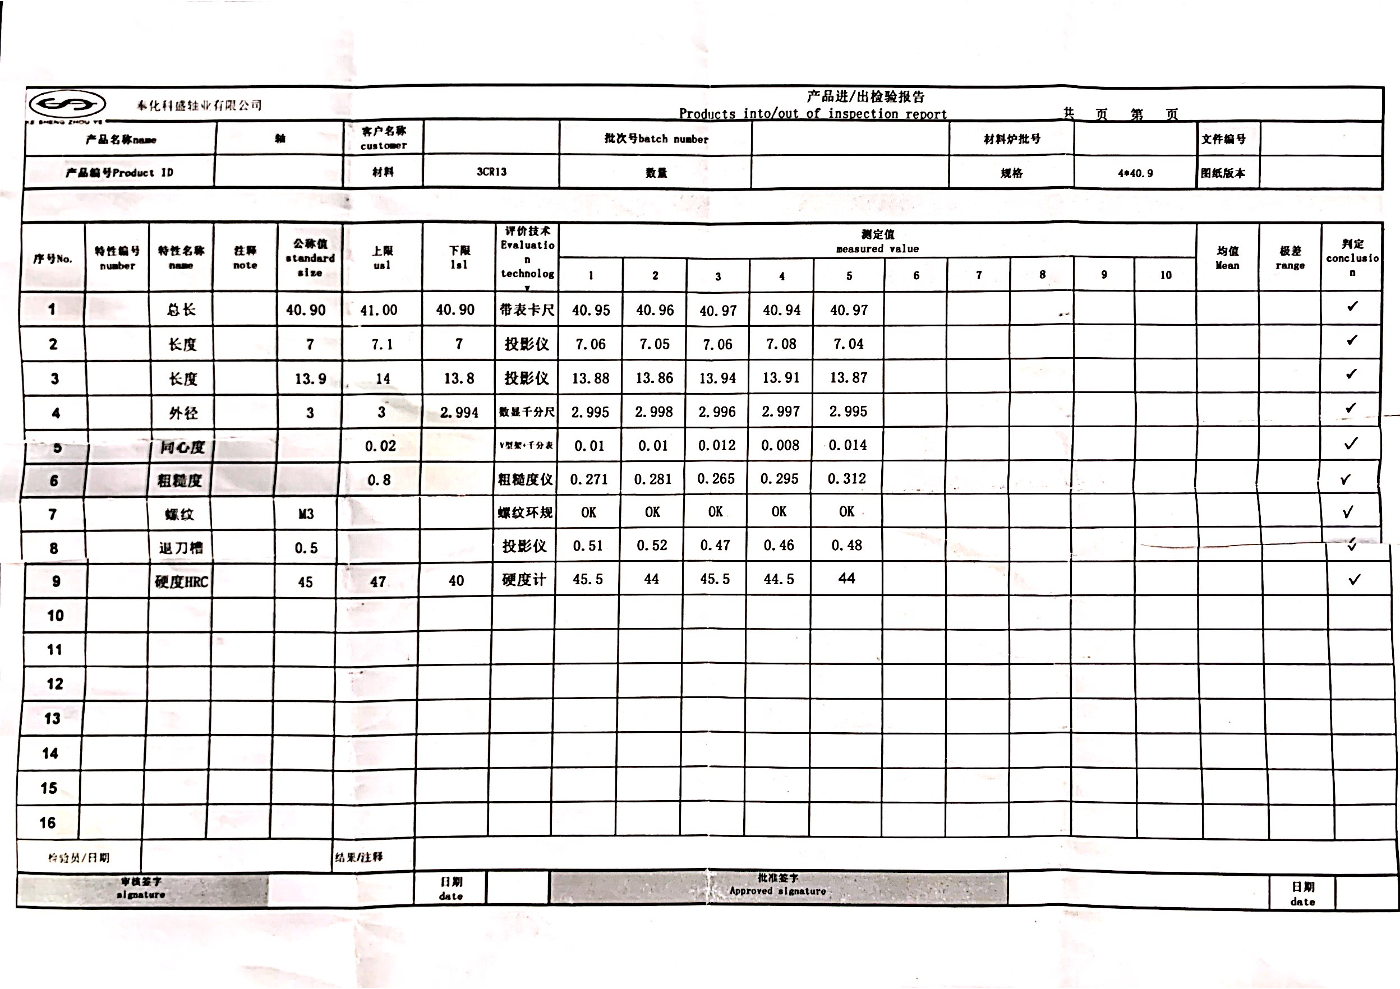
[picture p38: page 2]
