nbruite/vacuum/2-采购合同/动平衡机/XH5601A.pdf

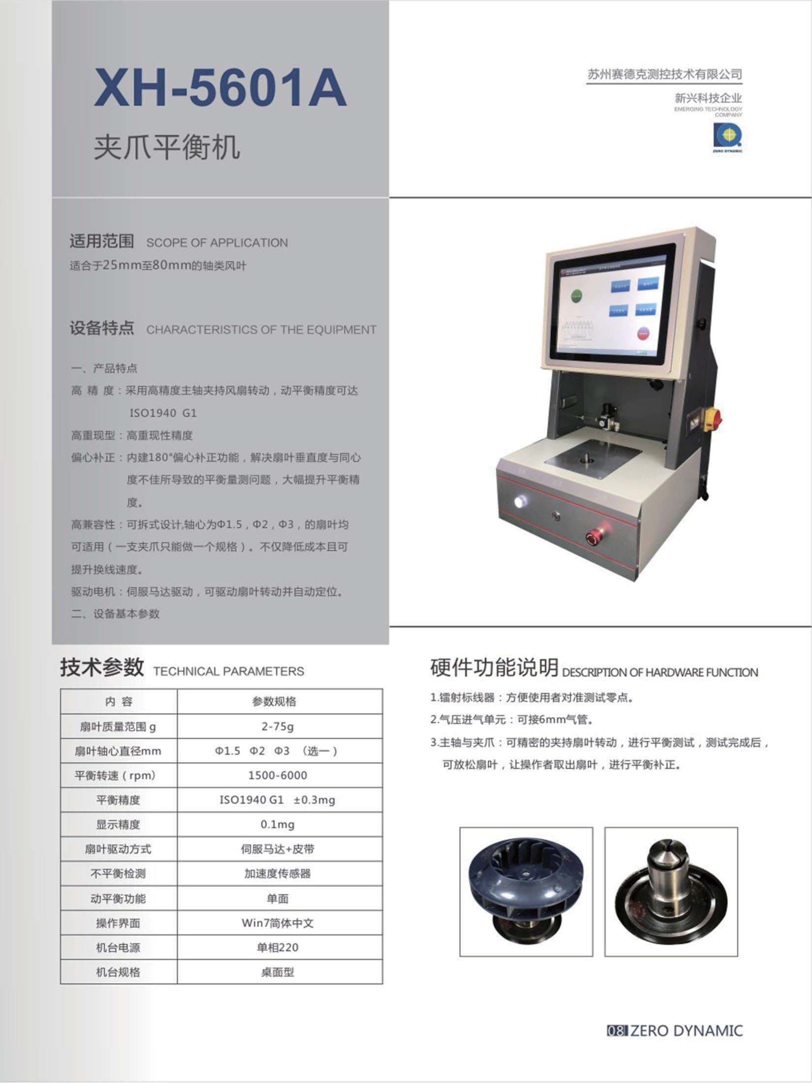
[picture p39: page 1]
