nbruite/vacuum/2-采购合同/动平衡机/动平衡机XH-8601A.pdf

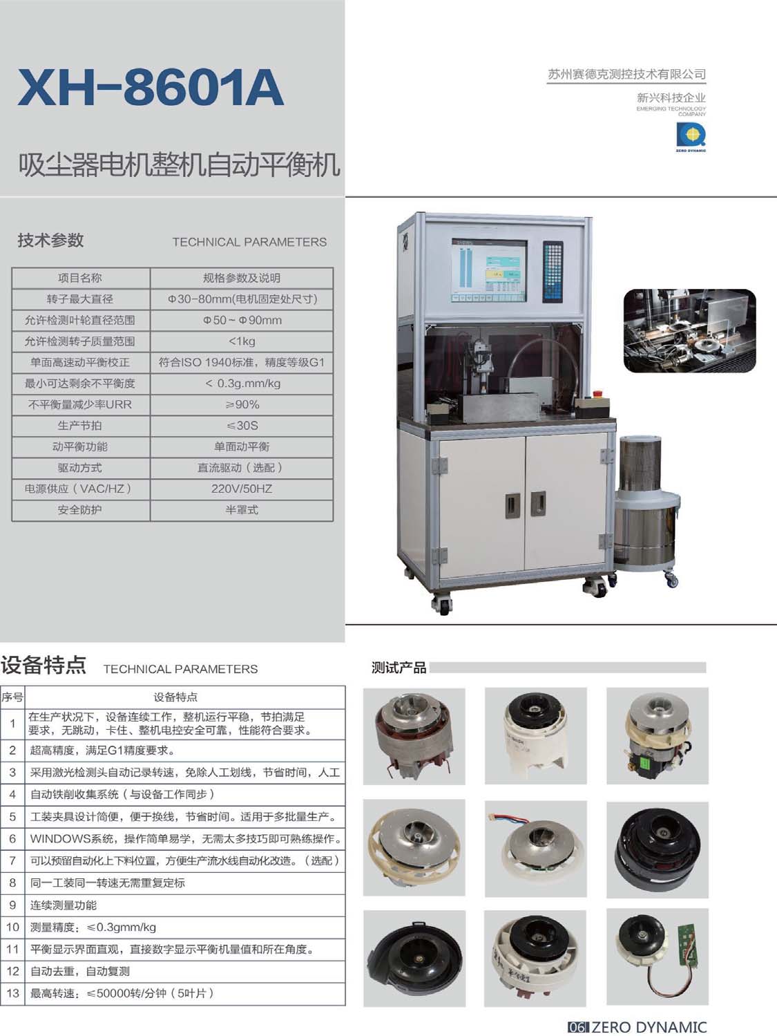
[picture p40: page 1]
