nbruite/vacuum/2-采购合同/轴/宁波锐特公司-轴采购订单.pdf

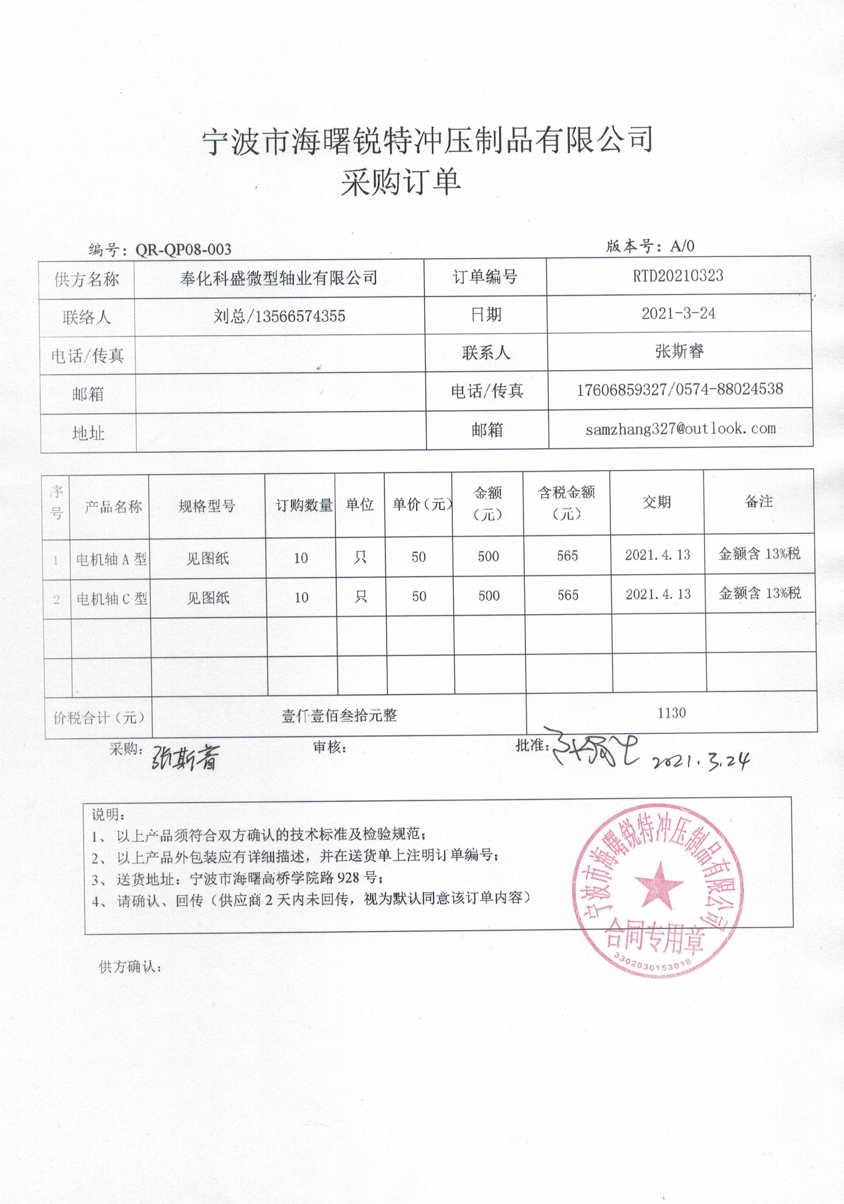
[picture p41: page 1]
