nbruite/vacuum/2-采购合同/塑料件/上下骨架/上下骨架模具合同.pdf

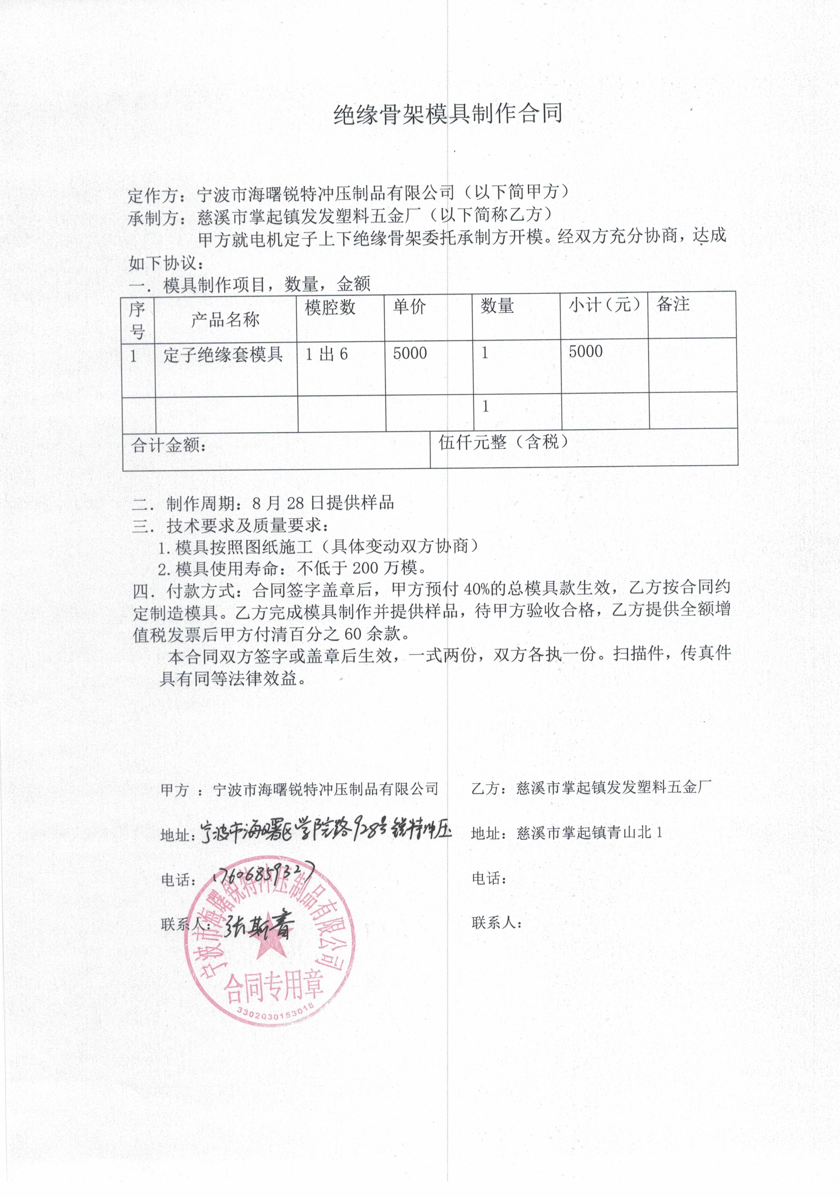
[picture p42: page 1]
