nbruite/vacuum/2-采购合同/塑料件/上下骨架/上下骨架采购合同.pdf

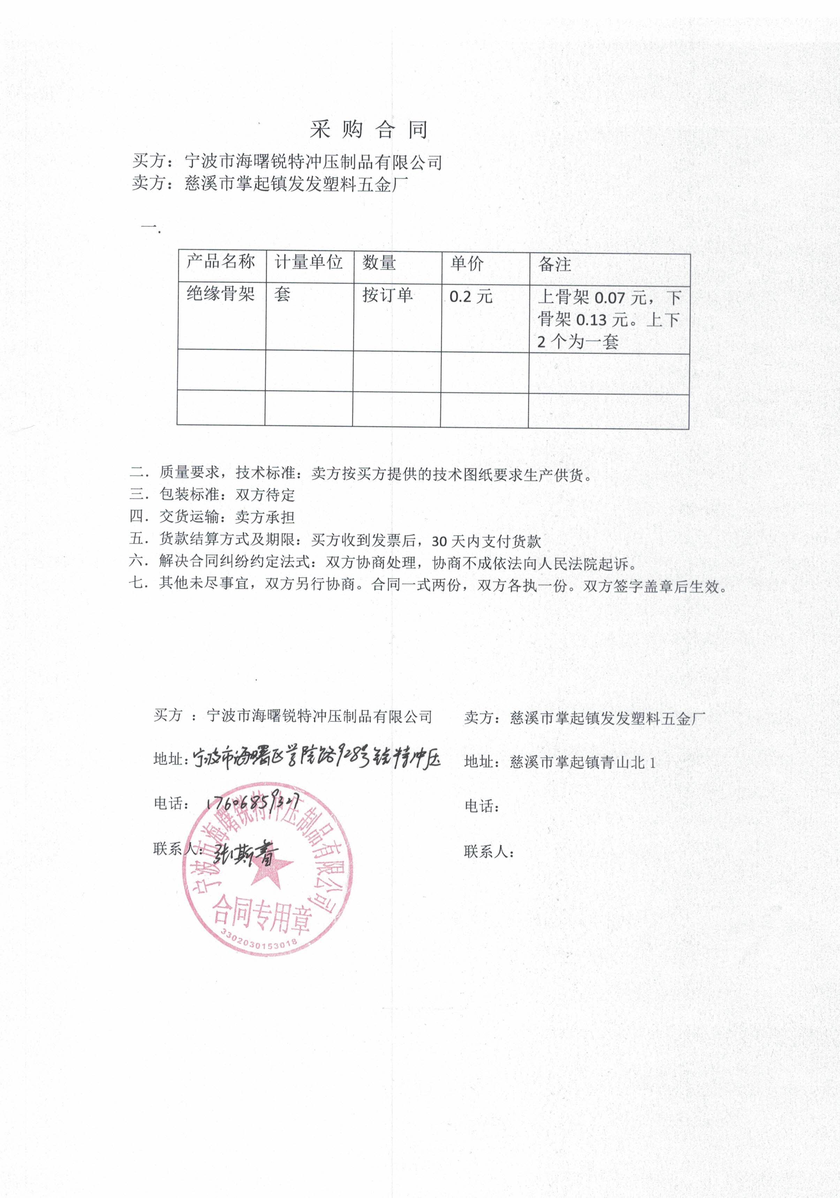
[picture p43: page 1]
