nbruite/vacuum/2-采购合同/铜端子/温州相昱科技/相昱开票资料.pdf.pdf

## 浙江相昱科技有限公司

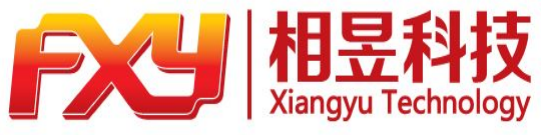
[picture p44: figure]

## 关于更改企业税号的通知

尊敬的客户：

根据国家统一实行五证合一政策，我公司办理五证合一后

随之税号也更改，更改后的新税号为 91330382741047092B 共

### 18 位，老税号为：330382741047092 共 15 位，地址变更为乐

清市清江镇棉花塘村，渡头村。因而自 2016 年 2 月 18 日

后公司统一使用新的税号， 老税号停止使用，企业不接受用老

税号开来的增值税发票及普通发票，望请谅解。谢谢合作！

新开票资料如下：

单位名称：浙江相昱科技有限公司

税 号：91330382741047092B

地址电话：乐清市清江镇棉花塘村，渡头村 0577-62317333

开户行： 工商银行温州乐清虹桥支行

帐 号：1203282419200188857

浙江相昱科技有限公司
财务部

2016-02-18
