nbruite/vacuum/2-采购合同/铜端子/温州相昱科技/采购合同-扫描.pdf

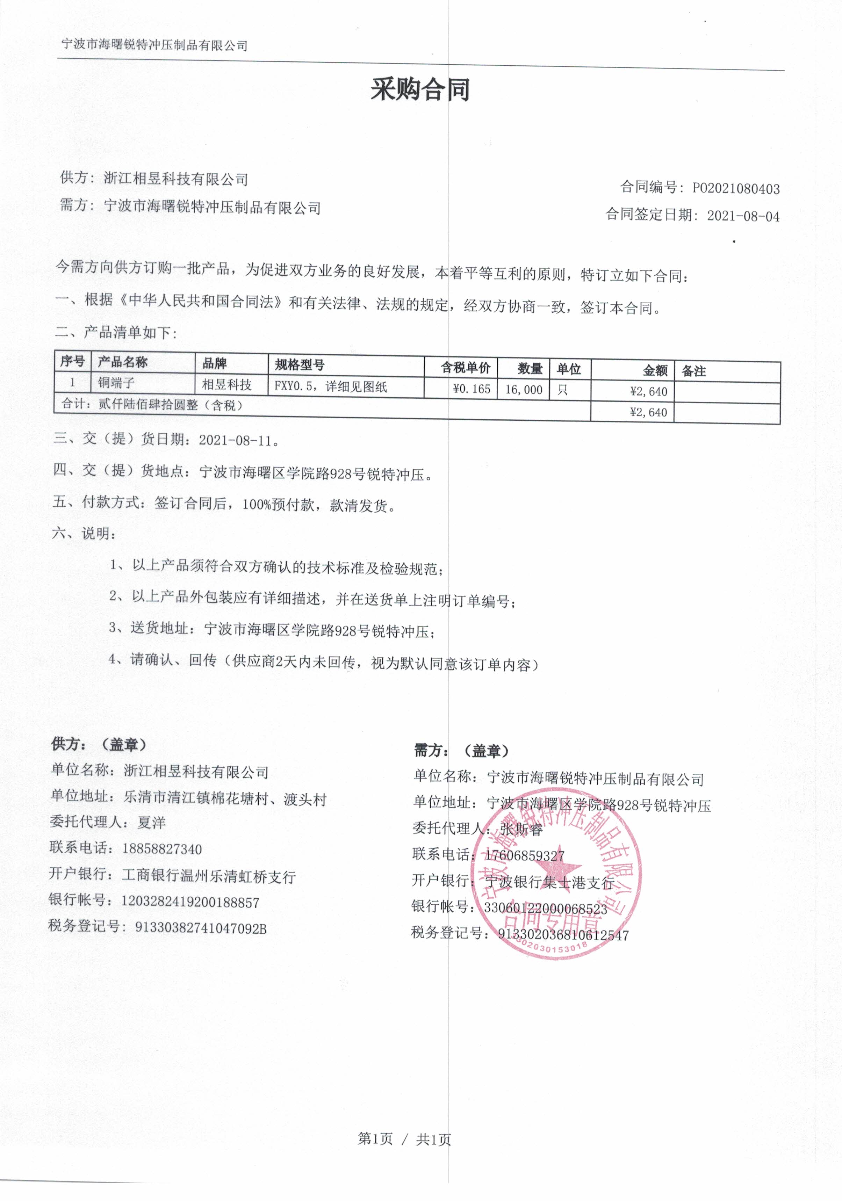
[picture p45: page 1]
