nbruite/vacuum/2-采购合同/绕线机/深圳专诚达/深圳专诚达绕线机合同V3.pdf

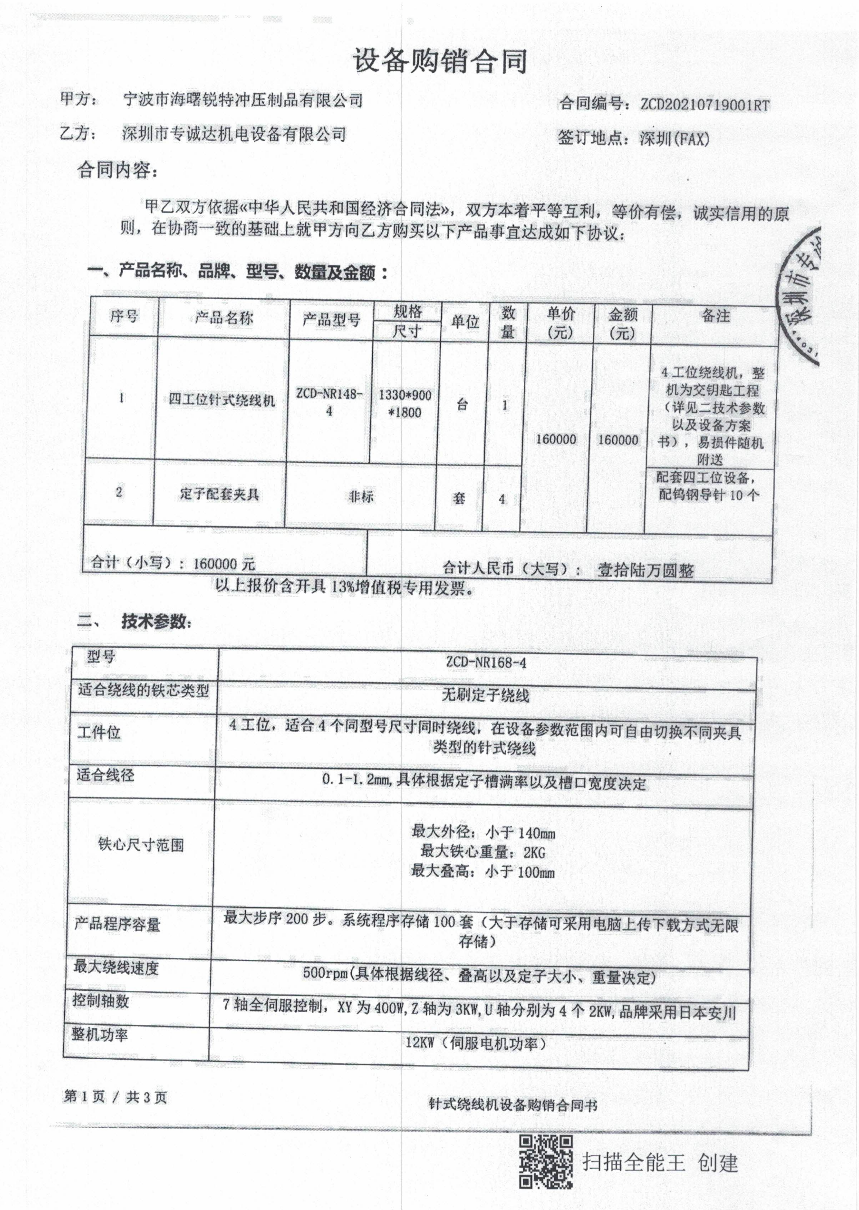
[picture p46: page 1]
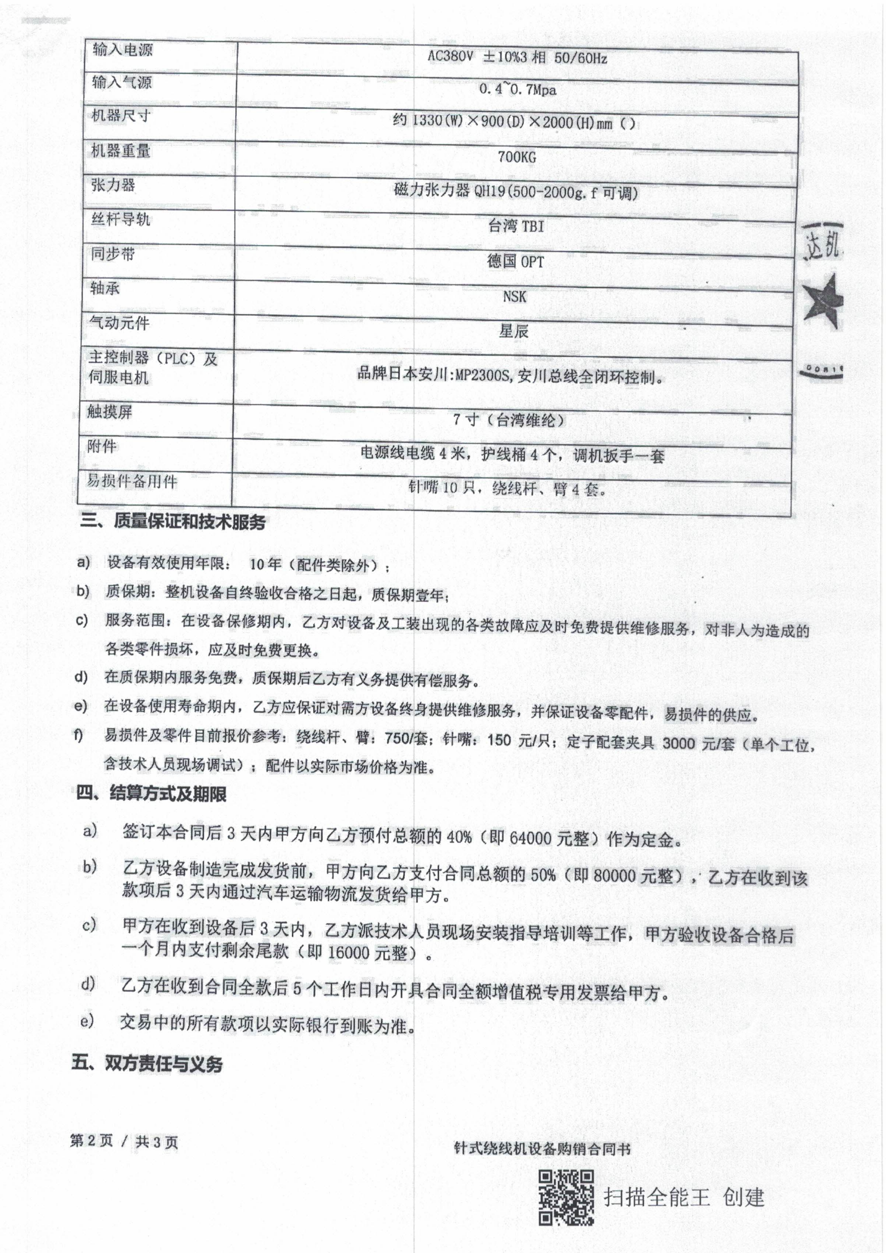
[picture p47: page 2]
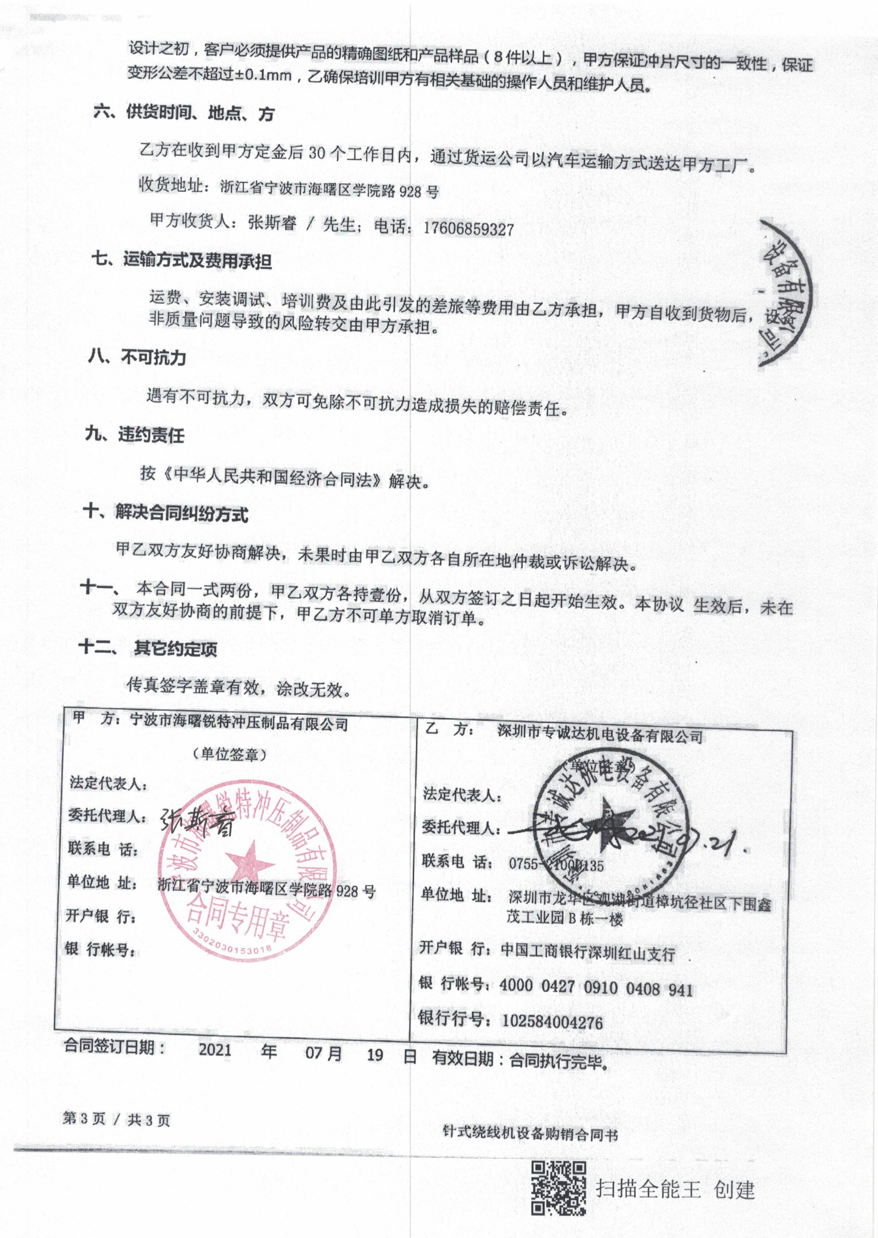
[picture p48: page 3]
