nbruite/vacuum/2-采购合同/轴承/南通山口/山口轴承检验报告.pdf

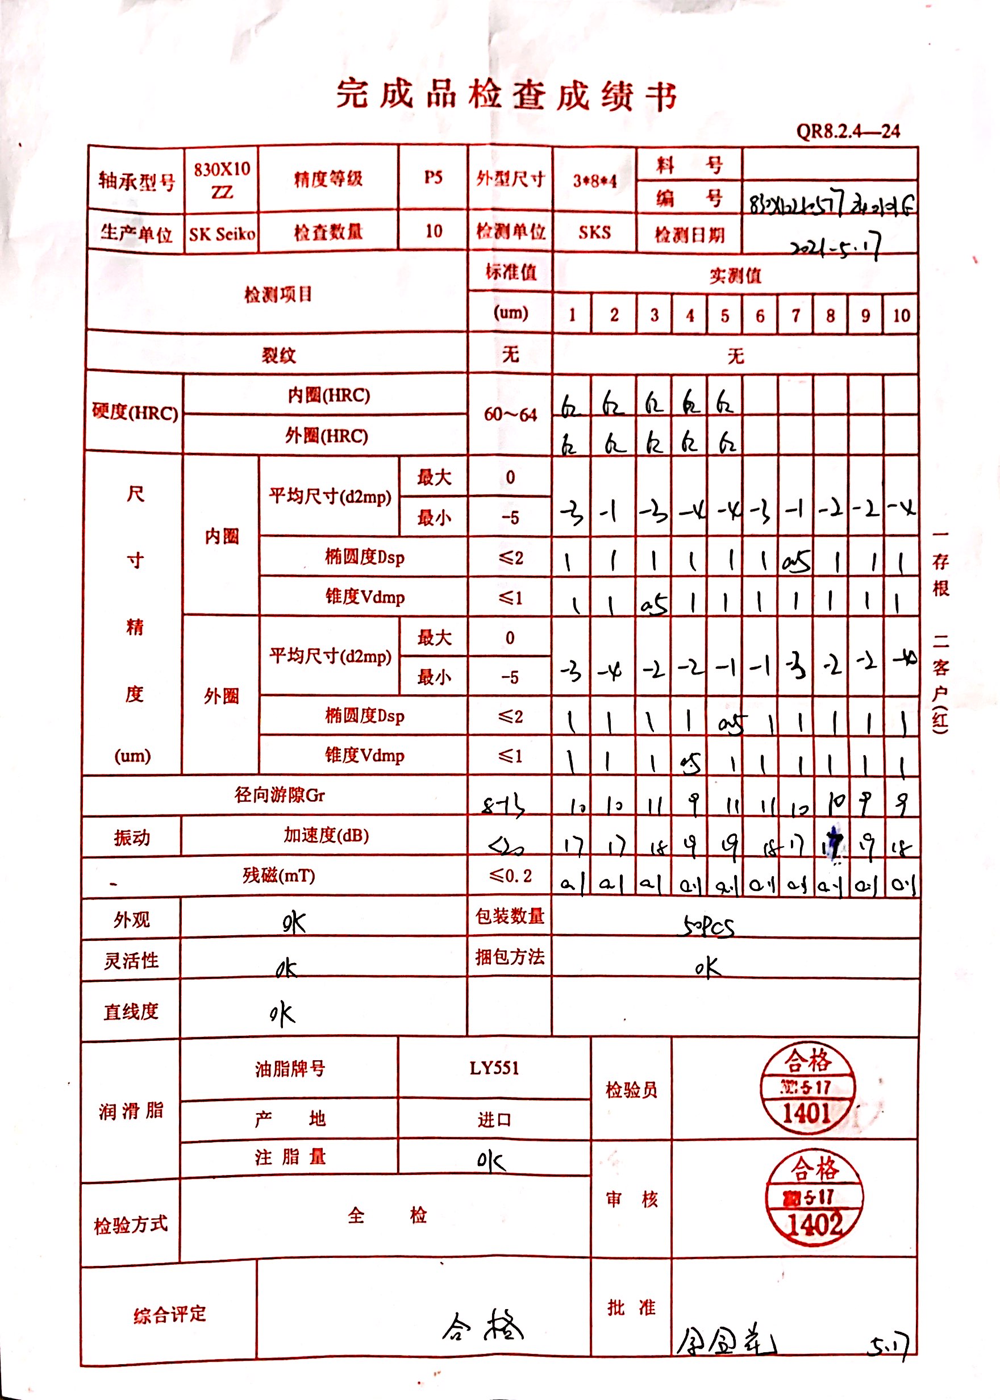
[picture p49: page 1]
