nbruite/vacuum/5-其他/4-行业参考/2-管理参考/品质异常联络单（弗莱斯卡）.pdf

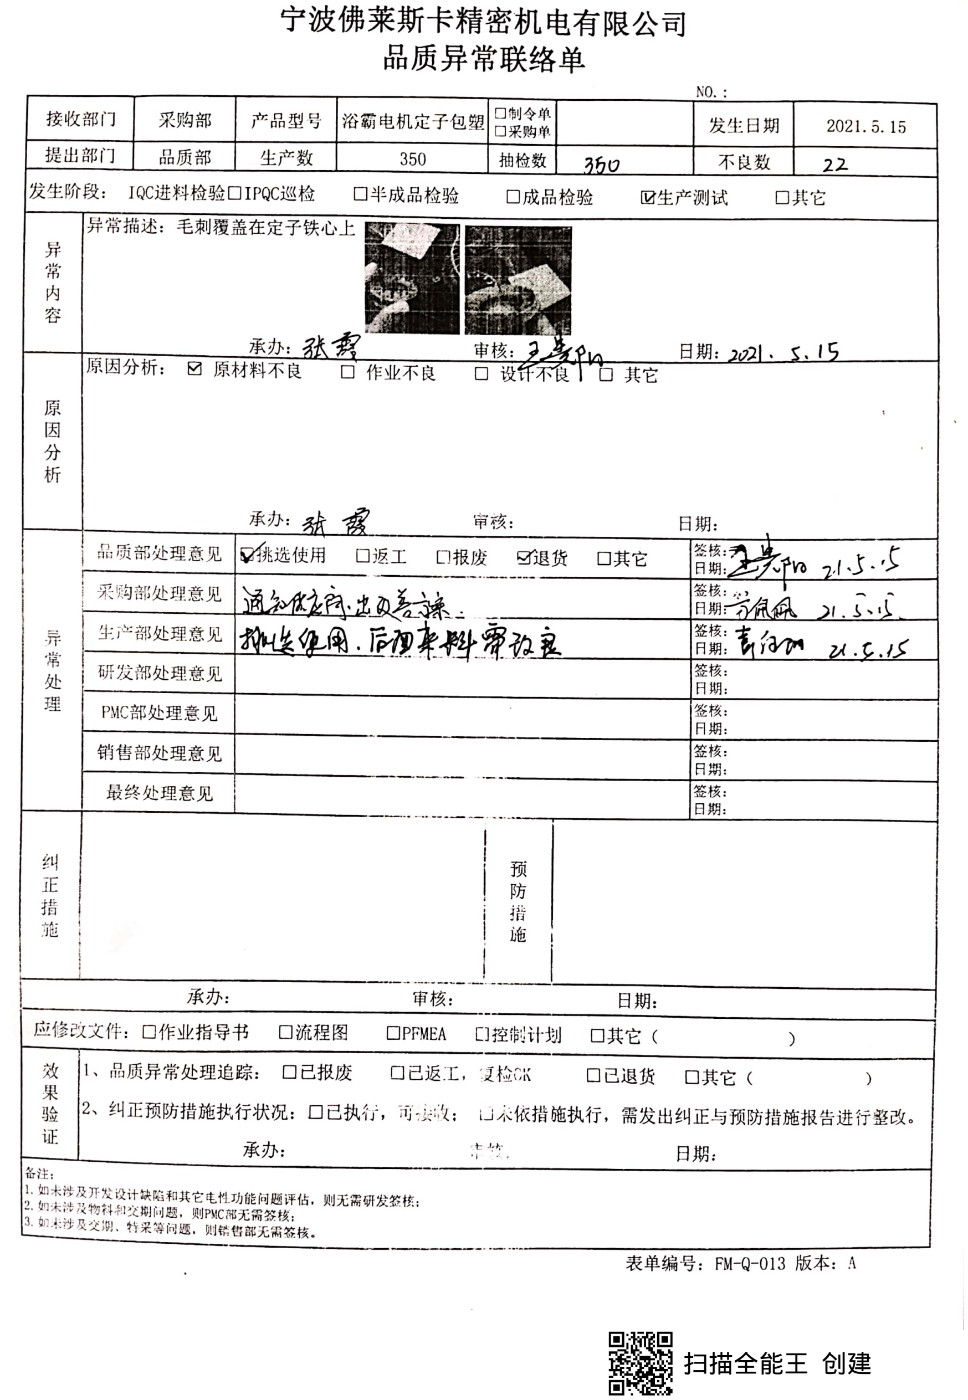
[picture p50: page 1]

扫描全能王 创建
