nbruite/vacuum/5-其他/1-专利/1-晨光专利/CN201721778438-定子固位牢固的直流无刷电机-实用新型.pdf

(19)中华人民共和国国家知识产权局

## (12)实用新型专利

(10)授权公告号
(45)授权公告日
(21)申请号 201721778438 .8

(22)申请日 2017 .12 .19

(73)专利权人 舟山晨光电器有限公司
地址 316200 浙江省舟山市岱山县浪激渚
工业经济开发区

(72)发明人 金建军

(51)Int .Cl .
H02K 1/18(2006 .01)
H02K 11/30(2016 .01)
H02K 3/46(2006 .01)
H02K 1/28(2006 .01)
H02K 9/06(2006 .01)
H02K 5/16(2006 .01)

(54)实用新型名称
定子固位牢固的直流无刷电机
(57)摘要
一种定子固位牢固的直流无刷电机，包括支
架，定子，能相对定子转动的转子，能通电产生磁
场的线圈和控制线圈通电的电路控制板，线圈缠
绕于定子上，线圈、电路控制板与电源构成回路，
定子固定在支架内，转子穿过线圈、定子能转动
地设置在支架上，支架包括上支架与下支架，上
支架与下支架通过螺栓相固定，定子卡置在上支
架与下支架之间，定子侧壁上与螺栓对应位置处
设置有能卡入螺栓杆体的限位凹槽。其优点在
于：定子夹置在上支架与下支架之间，结构牢固，
固定稳定，不易松脱，定子侧壁上设置有能卡入
螺栓杆体的限位凹槽，限位凹槽能将定子定位，
进一步提高定子固定的牢固程度，避免定子松
脱、晃动，能将定子固位牢固的直流无刷电机应
用在高频振动的环境中。

权利要求书2页 说明书4页 附图18页

CN 207782511 U
2018.08.28

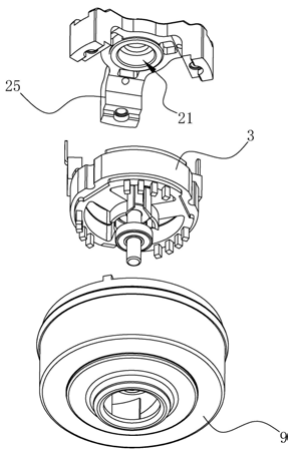
[picture p51: figure]

CN 207782511 U

1 .一种定子固位牢固的直流无刷电机，包括支架(2)，定子(3)，能相对定子(3)转动的 转子(5)，能通电产生磁场的线圈(4)和控制线圈(4)通电的电路控制板(1)，所述线圈(4)缠 绕于定子(3)上，所述线圈(4)、电路控制板(1)与电源构成回路，所述定子(3)固定在支架 (2)内，所述转子(5)穿过线圈(4)、定子(3)能转动地设置在支架(2)上，其特征在于：所述支 架(2)包括上支架与下支架，所述上支架与下支架通过螺栓相固定，所述定子(3)卡置在上 支架与下支架之间，定子侧壁上与螺栓对应位置处设置有能卡入螺栓杆体的限位凹槽 (38)。
2 .根据权利要求1所述的直流无刷电机，其特征在于：所述上支架的周边间隔设置有上 凸部(25)，所述下支架的顶部设置有连接凸环，所述连接凸环的内壁上对应设置有下凸部 (26)，所述定子的上表面顶触在上凸部(25)的底面，所述定子的下表面顶触在下凸部(26) 的顶面，用于连接上支架与下支架的螺栓将上凸部(25)与下凸部(26)插接在一起。
3 .根据权利要求2所述的直流无刷电机，其特征在于：所述上支架的底面与下支架的顶 面上分别设置有上凹腔(21)与下凹腔(22)，所述上凹腔(21)与下凹腔(22)中分别设置有上 轴承(23)与下轴承(24)，所述转子(5)中插置有输出轴(51)，所述输出轴(51)的一端插置在 上轴承(23)中，所述输出轴(51)的另一端穿过下轴承(24)与下凹腔(22)而伸出下支架。 4 .根据权利要求3所述的直流无刷电机，其特征在于：所述输出轴(51)的中部设置有限 位凸部(52)，所述转子(5)的一端面顶触在限位凸部(52)上。
5 .根据权利要求1至4中任一所述的直流无刷电机，其特征在于：所述定子(3)的中部设 置有连接通孔，所述连接通孔的内壁上间隔地向内延伸出支撑臂(31)，所述支撑臂(31)的 端部形成能穿过转子(5)的定位孔(32)，所述定子(3)设置在限位架中，所述限位架固定在 支架(2)内，所述线圈(4)缠绕在支撑臂(31)对应的限位架上，所述限位架上设置有阻止线 圈(4)与转子(5)接触的线圈挡板(33)。
6 .根据权利要求5所述的直流无刷电机，其特征在于：所述限位架的上部设置有导电插 片(6)，电路控制板(1)上与导电插片(6)对应位置处设置有插孔(11)，所述导电插片(6)伸 入电路控制板(1)的插孔(11)中而与电路控制板(1)焊接固定在一起。
7 .根据权利要求6所述的直流无刷电机，其特征在于：所述限位架的上部设置有插架 (34)，所述插架(34)的顶部设置有插槽，所述导电插片(6)能脱卸地插置在插槽中，所述线 圈(4)的端部穿过插架(34)与导电插片(6)相连接。
8 .根据权利要求7所述的直流无刷电机，其特征在于：所述限位架包括上架体(35)与下 架体(36)，所述插架(34)设置在上架体(35)的顶面上，所述下架体(36)的底面上设置有能 缠绕导线防止线圈(4)松脱的绕线柱(37)，所述定子(3)设置在上架体(35)与下架体(36)对 合形成的限位架中。
9 .根据权利要求3或4所述的直流无刷电机，其特征在于：所述输出轴(51)的下端伸出 支架(2)与风叶轮(7)相连接，所述风叶轮(7)包括上盘体(71)，下盘体(72)和间隔设置在上 盘体(71)与下盘体(72)之间的叶片(73)，所述下盘体(72)的中部设置有盘体通孔(74)，所 述上盘体(71)与转子的下端相连接，相邻叶片(73)之间形成的间隙与下盘体(72)的盘体通 孔(74)相连通。
10 .根据权利要求8所述的直流无刷电机，其特征在于：风叶轮侧壁的外侧设置有定叶 轮(8)，所述定叶轮(8)的侧边上间隔设置有将空气引向叶片(73)的导流片(81)，所述支架
权　利　要　求　书 | 1/2 页
CN 207782511 U

(2)的底部设置有连接凸台(28)，所述定叶轮(8)的内壁卡扣在连接凸台(28)上，所述支架 (2)的底部能脱卸地设置有电机罩体(9)，所述电机罩体(9)的底部设置有连通电机罩体内 外的连通孔，所述定叶轮(8)与风叶轮(7)设置在连通孔上部的电机罩体(9)内腔中。

权　利　要　求　书 | 2/2 页

定子固位牢固的直流无刷电机

技术领域
[0001] 本实用新型涉及一种电机制作技术领域，尤其指一种结构紧凑的定子固位牢固的 直流无刷电机。

背景技术
[0002] 现有一种申请号为CN201610952649 .2名称为《一种家用风扇的DC三相无刷电机》 的中国发明专利申请公开了一种家用风扇的DC三相具有转子限位结构的直流无刷电机，包 括有绕线组、磁框、轴承和PCB板，还包括有磁石和基座，所述磁框设置有轴芯，所述绕线组 套设于轴芯，所述磁框套设于绕线组的外表面，所述磁石位于磁框与绕线组之间；所述绕线 组与PCB板连接，所述基座套设于轴芯并穿设于绕线组的内孔，所述基座的一端与磁框接 触，所述基座的另一端凸出于PCB板，所述轴承套设于轴芯并安装于基座内。该发明能够将 220V的AC电压转换成5V的DC电压，并保证该发明在5V电压的驱动下能够达到AC电机的运行 转速及风压风量，既节约了电能，又能满足散热的效果。然而，该装置PCB板靠近绕线组，绕 线组磁场会对PCB板产生磁场干扰影响PCB的正常工作，而且基座、基架和弹性定位片可能 磨损轴芯，进而影响电机的使用寿命，因此该装置的结构还需进一步改进。

发明内容
[0003] 本实用新型所要解决的技术问题是针对上述现有技术现状而提供一种结构紧凑， 坚固耐用，使用寿命长的定子固位牢固的直流无刷电机。
[0004] 本实用新型解决上述技术问题所采用的技术方案为：本定子固位牢固的直流无刷 电机，包括支架，定子，能相对定子转动的转子，能通电产生磁场的线圈和控制线圈通电的 电路控制板，所述线圈缠绕于定子上，所述线圈、电路控制板与电源构成回路，所述定子固 定在支架内，所述转子穿过线圈、定子能转动地设置在支架上，其特征在于：所述支架包括 上支架与下支架，所述上支架与下支架通过螺栓相固定，所述定子卡置在上支架与下支架 之间，定子侧壁上与螺栓对应位置处设置有能卡入螺栓杆体的限位凹槽。
[0005] 作为改进，所述上支架的周边可优选间隔设置有上凸部，所述下支架的顶部设置 有连接凸环，所述连接凸环的内壁上对应设置有下凸部，所述定子的上表面顶触在上凸部 的底面，所述定子的下表面顶触在下凸部的顶面，用于连接上支架与下支架的螺栓将上凸 部与下凸部插接在一起。
[0006] 进一步改进，所述上支架的底面与下支架的顶面上可优选分别设置有上凹腔与下 凹腔，所述上凹腔与下凹腔中分别设置有上轴承与下轴承，所述转子中插置有输出轴，所述 输出轴的一端插置在上轴承中，所述输出轴的另一端穿过下轴承与下凹腔而伸出下支架。
[0007] 进一步改进，所述输出轴的中部可优选设置有限位凸部，所述转子的一端面顶触 在限位凸部上。
[0008] 作为改进，所述定子的中部可优选设置有连接通孔，所述连接通孔的内壁上间隔 地向内延伸出支撑臂，所述支撑臂的端部形成能穿过转子的定位孔，所述定子设置在限位
说　明　书 | 1/4 页

架中，所述限位架固定在支架内，所述线圈缠绕在支撑臂对应的限位架上，所述限位架上设 置有阻止线圈与转子接触的线圈挡板。
[0009] 进一步改进，所述限位架的上部可优选设置有导电插片，电路控制板上与导电插 片对应位置处设置有插孔，所述导电插片伸入电路控制板的插孔中而与电路控制板焊接固 定在一起。
[0010] 进一步改进，所述限位架的上部可优选设置有插架，所述插架的顶部设置有插槽， 所述导电插片能脱卸地插置在插槽中，所述线圈的端部穿过插架与导电插片相连接。
[0011] 进一步改进，所述限位架包括上架体与下架体，所述插架设置在上架体的顶面上， 所述下架体的底面上设置有能缠绕导线防止线圈松脱的绕线柱，所述定子设置在上架体与 下架体对合形成的限位架中。
[0012] 作为改进，所述输出轴的下端伸出支架与风叶轮相连接，所述风叶轮包括上盘体， 下盘体和间隔设置在上盘体与下盘体之间的叶片，所述下盘体的中部设置有盘体通孔，所 述上盘体与转子的下端相连接，相邻叶片之间形成的间隙与下盘体的盘体通孔相连通。
[0013] 进一步改进，风叶轮侧壁的外侧可优选设置有定叶轮，所述定叶轮的侧边上间隔 设置有将空气引向叶片的导流片，所述支架的底部设置有连接凸台，所述定叶轮的内壁卡 扣在连接凸台上，所述支架的底部能脱卸地设置有电机罩体，所述电机罩体的底部设置有 连通电机罩体内外的连通孔，所述定叶轮与风叶轮设置在连通孔上部的电机罩体内腔中。
[0014] 与现有技术相比，本实用新型采用支架包括上支架与下支架，所述上支架与下支 架通过螺栓相固定，所述定子卡置在上支架与下支架之间，定子侧壁上与螺栓对应位置处 设置有能卡入螺栓杆体的限位凹槽，这种结构的优点在于：定子夹置在上支架与下支架之 间，结构牢固，固定稳定，不易松脱，定子侧壁上设置有能卡入螺栓杆体的限位凹槽，限位凹 槽能将定子定位，进一步提高定子固定的牢固程度，避免定子松脱、晃动，从而能将定子固 位牢固的直流无刷电机应用在高频振动的环境中；上支架隔开了定子与电路控制板，套置 在定子上的线圈与电路控制板距离较远，线圈通电时对电路控制板的影响减弱，确保电路 控制板正常工作；线圈套置在支撑臂上，与转子之间距离短，磁感传递效果好，较小能耗实 现转子的快速旋转，提高定子固位牢固的直流无刷电机的使用效率；线圈套置在支撑臂上， 不易松脱，更可以通过线圈挡板进一步限制线圈的位置，功率输出更稳定，使用效果更好； 而且线圈较少地占用除定子以外的支架空间，使定子固位牢固的直流无刷电机结构紧凑， 在不影响转子输出功率的前提下，制作出体积更小的定子固位牢固的直流无刷电机；还有 定子的连接通孔能够减轻定子的重量，进而减轻定子固位牢固的直流无刷电机的重量，降 低制作、运输成本；电路控制板通过插孔与导电插片相插接，线圈通过导电插片与电路控制 板连接相对于线圈的导线端直接与电路控制板连接具有不易断裂，导电性能好，更换方便， 固定稳定，焊接方便的优点；输出轴上设置有限位凸部，限位凸部能顶触在转子上，输出轴 受到外力作用向上移动时，限位凸部能推动转子与输出轴一同移动，避免两者之间发生位 移，保证转子输出稳定，应用效果好；输出轴的上部与下部均套置有轴承，轴承能减小输出 轴与支架之间的磨损，延长输出轴的使用寿命；定叶轮能引导气流沿一个方向向风叶轮流 动，有助于在风叶轮周围形成漩涡加快气流的流动速度，提高电机的效率，导流片能阻挡颗 粒物进入风叶轮，减少杂质的影响，风叶轮不易损坏，延长风叶轮的使用寿命，定叶轮能脱 卸地设置在连接凸台上更换清洗方便；叶片固定在上盘体与下盘体之间，上盘体与下盘体
说　明　书 | 2/4 页

能加固叶片，提高风叶轮的强度，更为坚固耐用；上盘体与输出轴相连接，上盘体与输出轴 的连接面积更大，连接更为稳定，确保风叶轮平稳转动，使用效果更好；风叶轮能降低电机 罩体内空气的温度，减缓电机升温，并在电机罩体内形成上下的气流循环，提高电机的工作 效率。

附图说明
[0015] 图1为本实用新型实施例的立体图；
[0016] 图2为图1的俯视图；
[0017] 图3是图2中沿A-A线的剖面图；
[0018] 图4是图1的结构分解图；
[0019] 图5是图4的进一步结构分解图；
[0020] 图6是图5中未分解部分的结构分解图；
[0021] 图7是图5处于另一个角度的结构分解图；
[0022] 图8是图6中未分解部分的结构分解图；
[0023] 图9是图6处于另一个角度的结构分解图；
[0024] 图10是图8中未分解部分的结构分解图；
[0025] 图11是图10中未分解部分的结构分解图；
[0026] 图12是图4中未分解部分的结构分解图；
[0027] 图13是图4处于另一个角度的结构分解图；
[0028] 图14是图10中转子与输出轴配合的立体图；
[0029] 图15是图14的结构分解图；
[0030] 图16是图10中风叶轮的正面投影图；
[0031] 图17是图16中沿B-B线的剖面图；
[0032] 图18是图8中定叶轮的仰视图。

具体实施方式
[0033] 以下结合附图实施例对本实用新型作进一步详细描述。
[0034] 如图1至图18所示，本实施例的定子固位牢固的直流无刷电机，包括支架2，定子3， 能相对定子3转动的转子5，能通电产生磁场的线圈4和控制线圈4通电的电路控制板1，所述 线圈4缠绕于定子3上，所述线圈4、电路控制板1与电源构成回路，所述定子3固定在支架2 内，所述转子5穿过线圈4、定子3能转动地设置在支架2上，所述支架2包括上支架与下支架， 所述上支架与下支架通过螺栓相固定，所述定子3卡置在上支架与下支架之间，定子侧壁上 与螺栓对应位置处设置有能卡入螺栓杆体的限位凹槽38。所述上支架的周边间隔设置有上 凸部25，所述下支架的顶部设置有连接凸环，所述连接凸环的内壁上对应设置有下凸部26， 所述定子的上表面顶触在上凸部25的底面，所述定子的下表面顶触在下凸部26的顶面，用 于连接上支架与下支架的螺栓将上凸部25与下凸部26插接在一起。所述上支架的底面与下 支架的顶面上分别设置有上凹腔21与下凹腔22，所述上凹腔21与下凹腔22中分别设置有上 轴承23与下轴承24，所述转子5中插置有输出轴51，所述输出轴51的一端插置在上轴承23 中，所述输出轴51的另一端穿过下轴承24与下凹腔22而伸出下支架。所述输出轴51的中部
说　明　书 | 3/4 页

设置有限位凸部52，所述转子5的一端面顶触在限位凸部52上。
[0035] 定子3的中部设置有连接通孔，所述连接通孔的内壁上间隔地向内延伸出支撑臂 31，所述支撑臂31的端部形成能穿过转子5的定位孔32，所述定子3设置在限位架中，所述限 位架固定在支架2内，所述线圈4缠绕在支撑臂31对应的限位架上，所述限位架上设置有阻 止线圈4与转子5接触的线圈挡板33。所述限位架的上部设置有导电插片6，电路控制板1上 与导电插片6对应位置处设置有插孔11，所述导电插片6伸入电路控制板1的插孔11中而与 电路控制板1焊接固定在一起。所述限位架的上部设置有插架34，所述插架34的顶部设置有 插槽，所述导电插片6能脱卸地插置在插槽中，所述线圈4的端部穿过插架34与导电插片6相 连接。所述限位架包括上架体35与下架体36，所述插架34设置在上架体35的顶面上，所述下 架体36的底面上设置有能缠绕导线防止线圈4松脱的绕线柱37，所述定子3设置在上架体35 与下架体36对合形成的限位架中。
[0036] 输出轴51的下端伸出支架2与风叶轮7相连接，所述风叶轮7包括上盘体71，下盘体 72和间隔设置在上盘体71与下盘体72之间的叶片73，所述下盘体72的中部设置有盘体通孔 74，所述上盘体71与转子的下端相连接，相邻叶片73之间形成的间隙与下盘体72的盘体通 孔74相连通。风叶轮侧壁的外侧设置有定叶轮8，所述定叶轮8的侧边上间隔设置有将空气 引向叶片73的导流片81，所述支架2的底部设置有连接凸台28，所述定叶轮8的内壁卡扣在 连接凸台28上，所述支架2的底部能脱卸地设置有电机罩体9，所述电机罩体9的底部设置有 连通电机罩体内外的连通孔，所述定叶轮8与风叶轮5设置在连通孔上部的电机罩体9内腔 中。所述支架2的顶部设置有凸起部27，所述电路控制板1的板体上设置有连接孔，所述连接 孔通过螺钉与相应的凸起部27相连接。导电插片6的底部设置有插接部61，所述插接部61插 置在插接凸部34顶部的插槽中。所述凸起部27为圆柱体，所述圆柱体的中心设置有能与连 接孔相连接的圆柱通孔，所述圆柱体为三个，三个圆柱体分别位于等边三角形的三个顶角 上。
[0037] 工作原理：电路控制板控制线圈通电，在线圈处产生磁场，推动转子转动，输出轴 转动从而带动风叶轮转动，使本定子固位牢固的直流无刷电机正常工作。
说　明　书 | 4/4 页

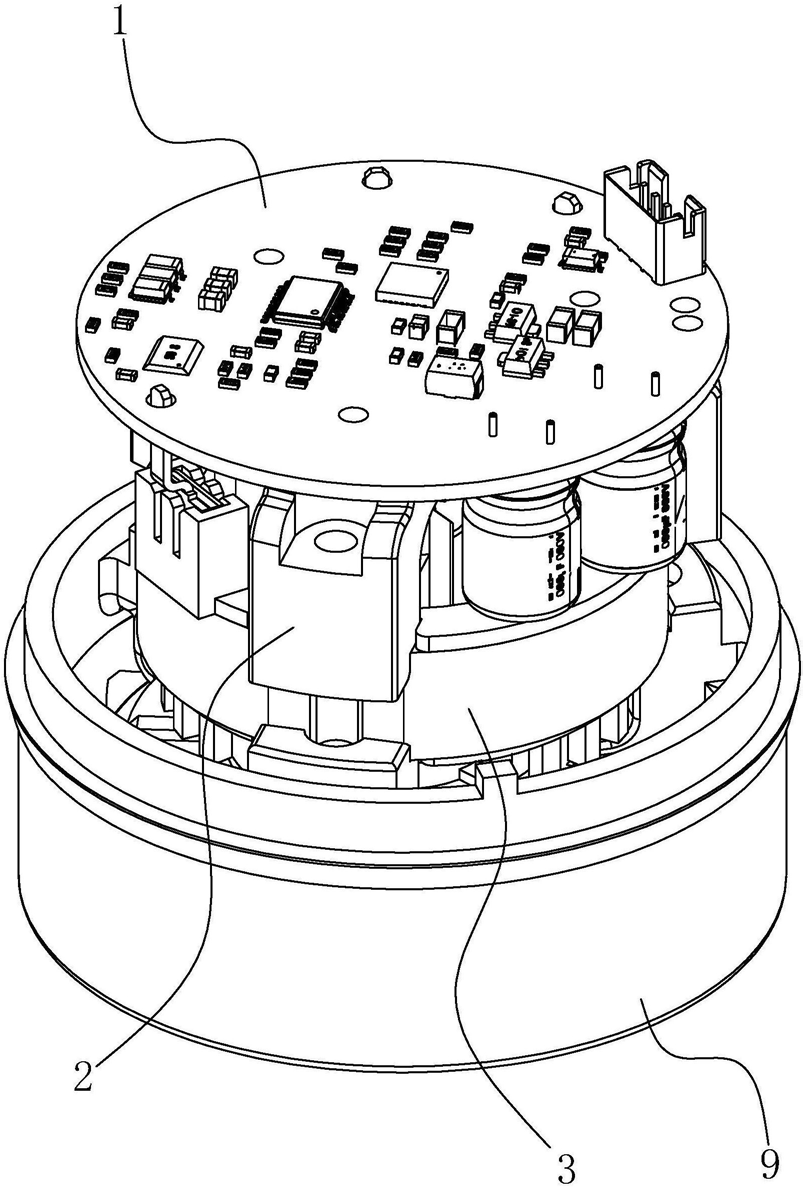
[picture p52: figure]

图1

说　明　书　附　图 | 1/18 页

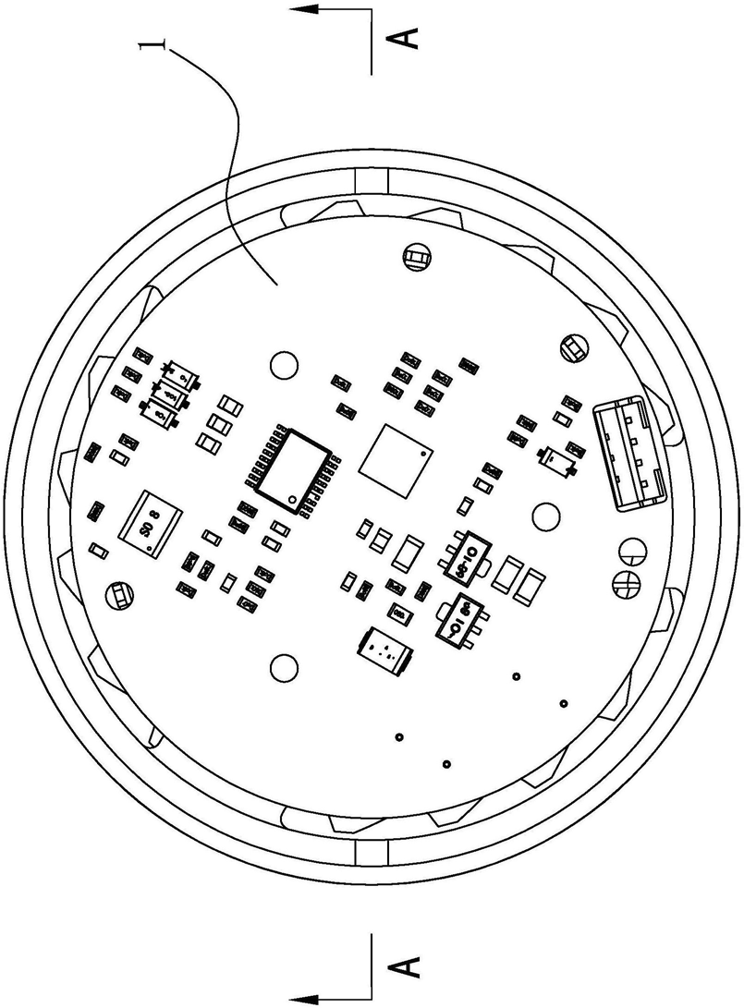
[picture p53: figure]

图2

说　明　书　附　图 | 2/18 页

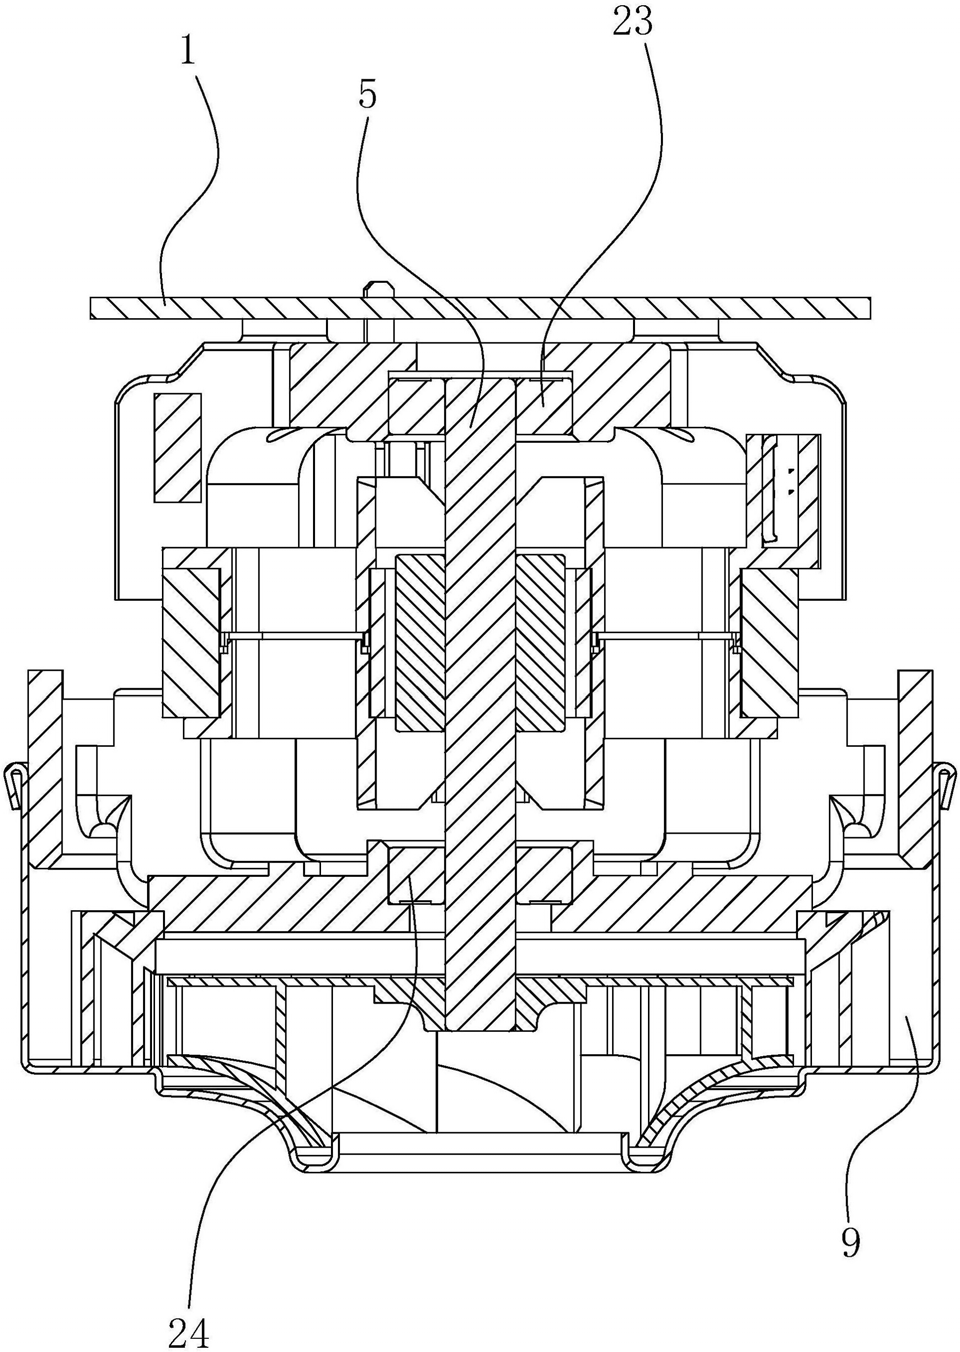
[picture p54: figure]

图3

说　明　书　附　图 | 3/18 页

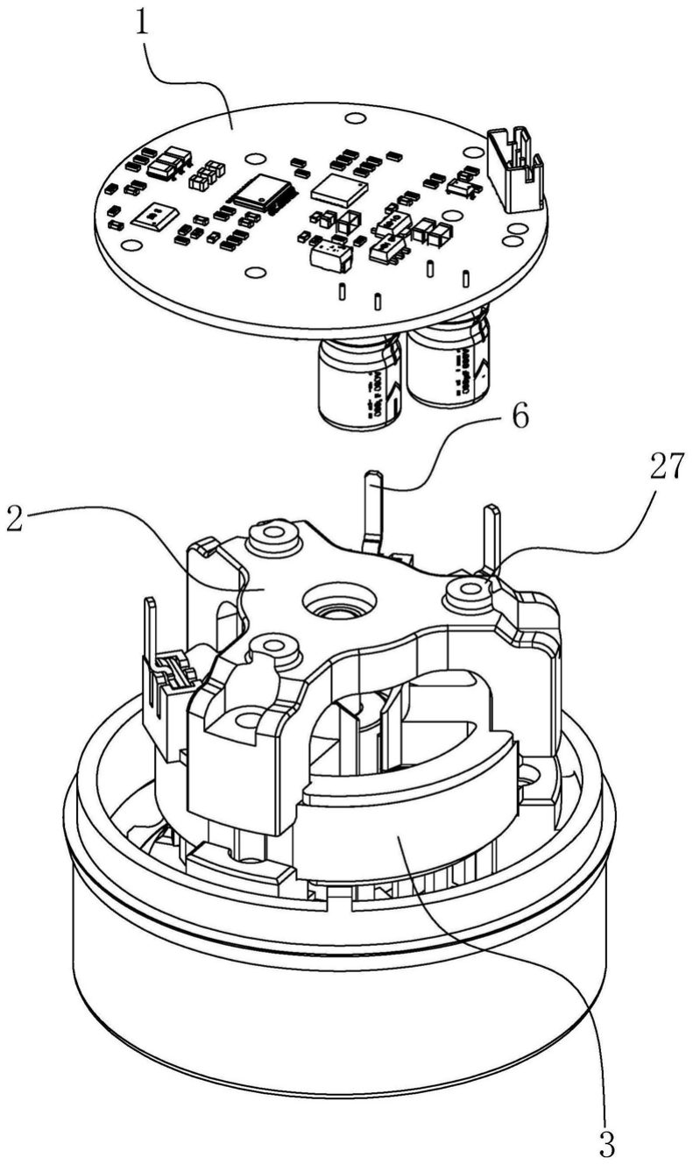
[picture p55: figure]

图4

说　明　书　附　图 | 4/18 页

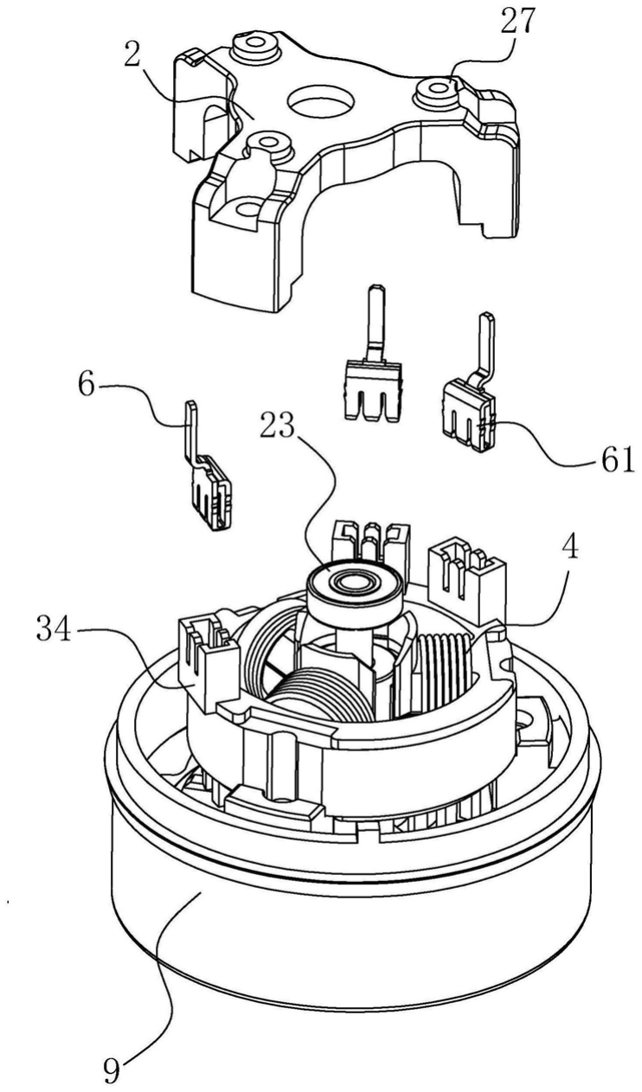
[picture p56: figure]

图5

说　明　书　附　图 | 5/18 页

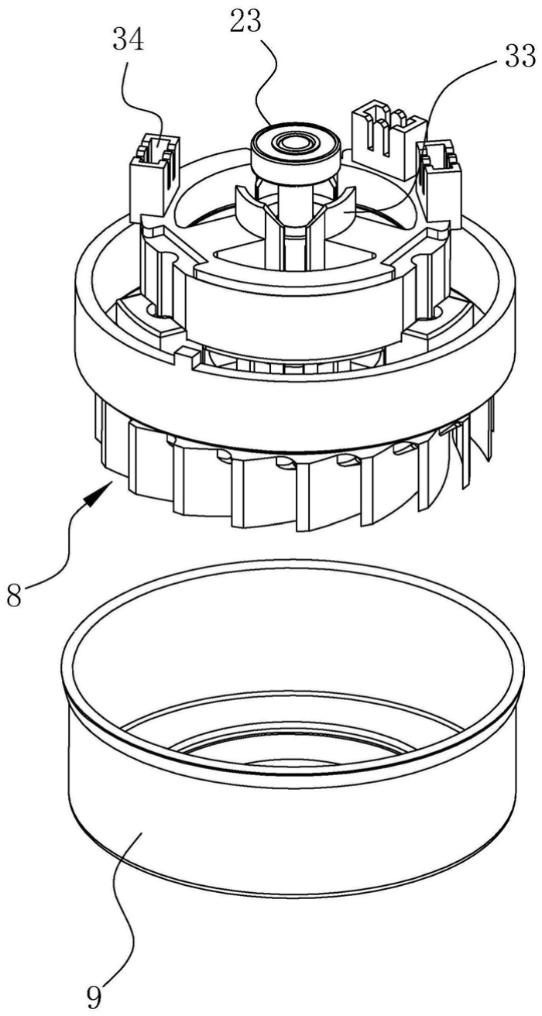
[picture p57: figure]

图6

说　明　书　附　图 | 6/18 页

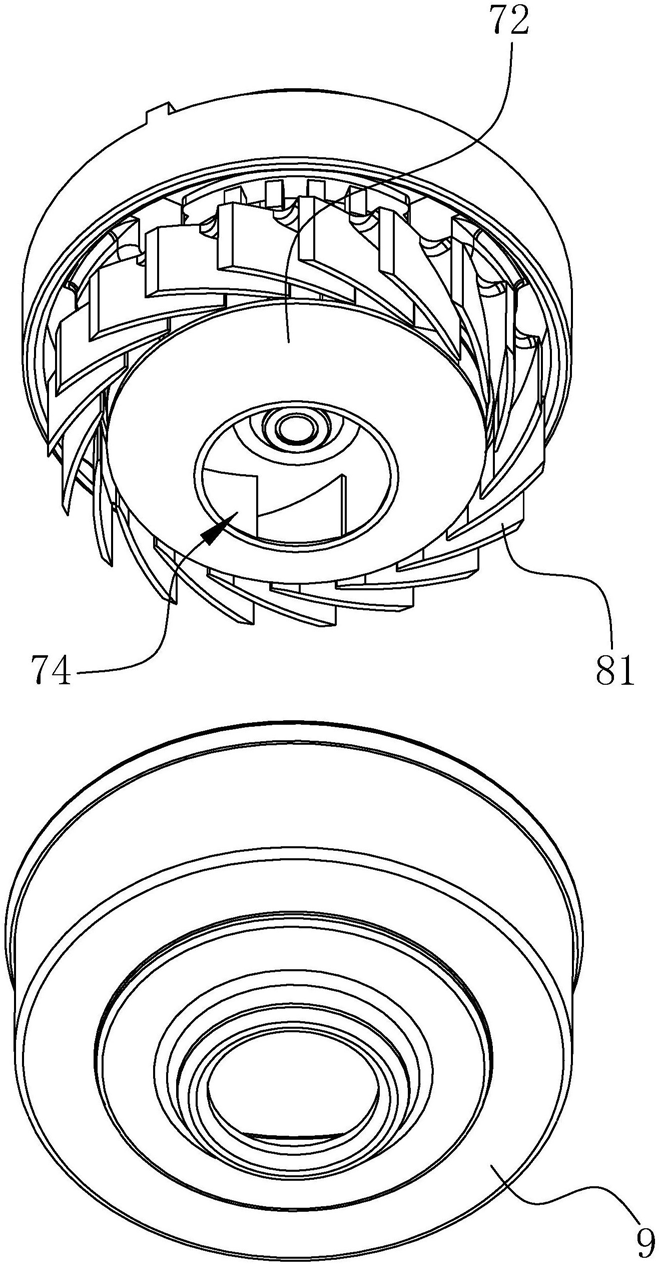
[picture p58: figure]

图7

说　明　书　附　图 | 7/18 页

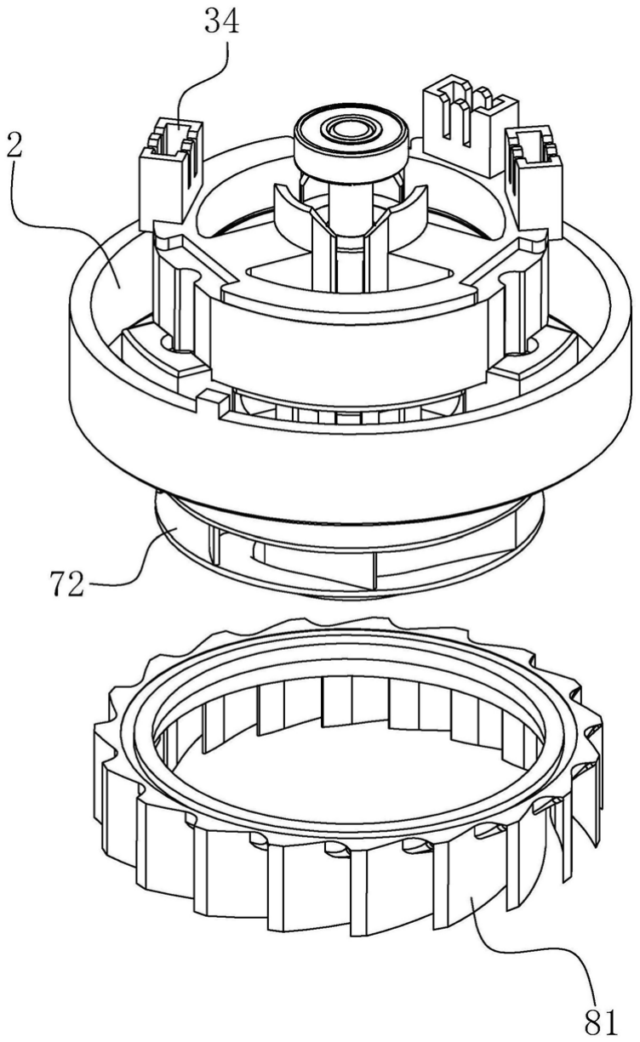
[picture p59: figure]

图8

说　明　书　附　图 | 8/18 页

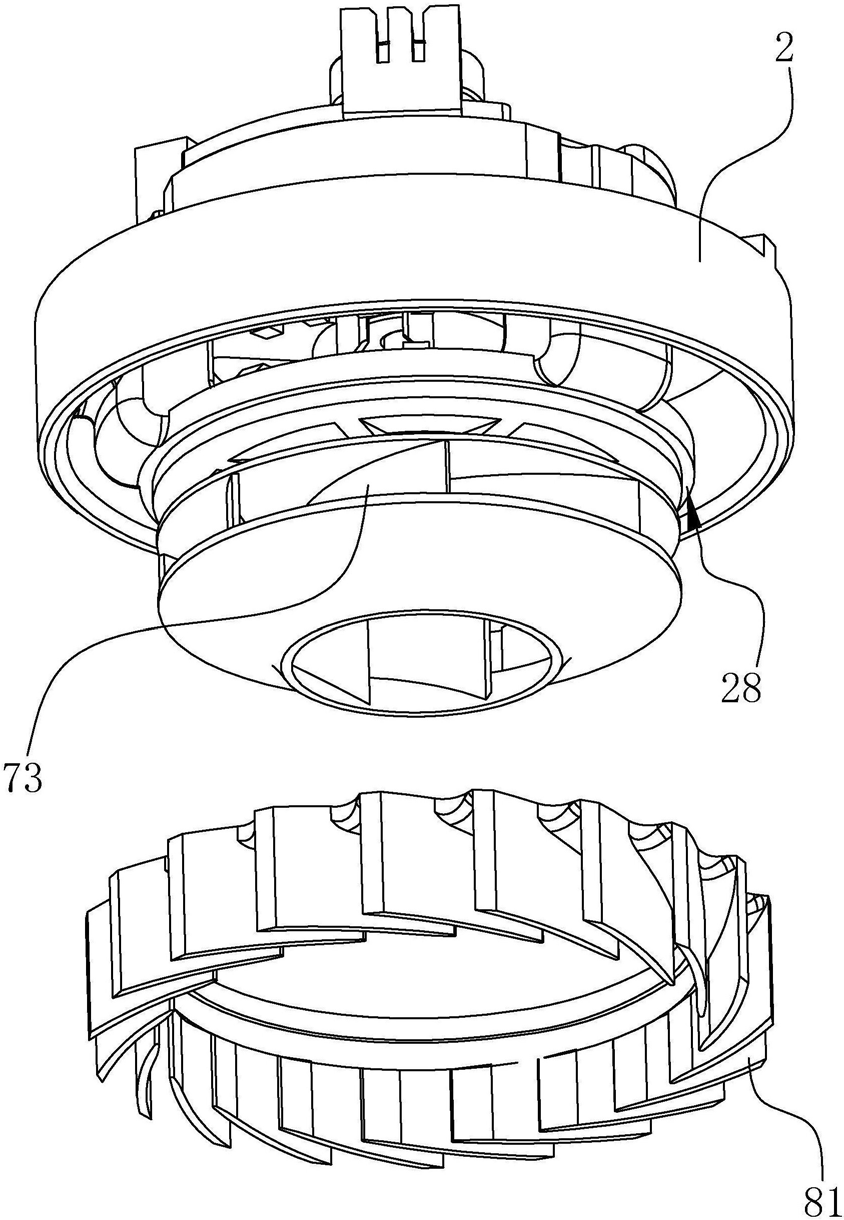
[picture p60: figure]

图9

说　明　书　附　图 | 9/18 页

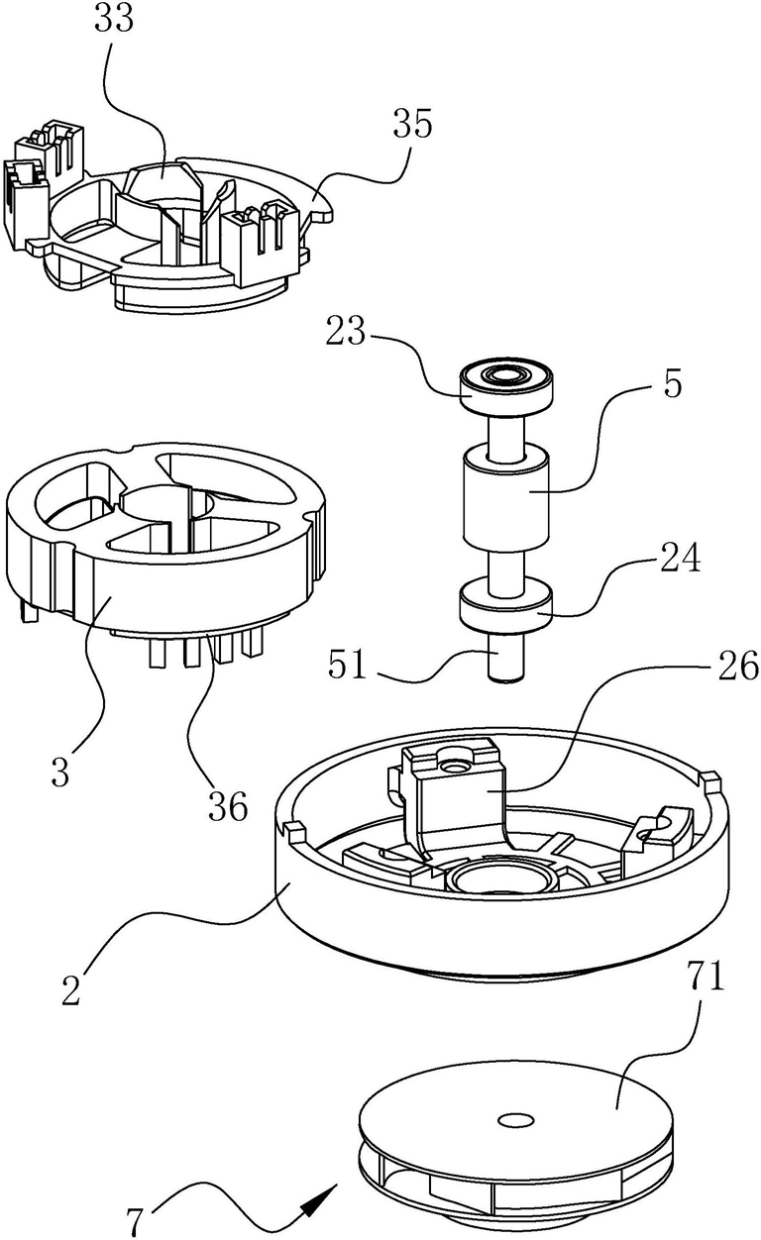
[picture p61: figure]

图10

说　明　书　附　图 | 10/18 页

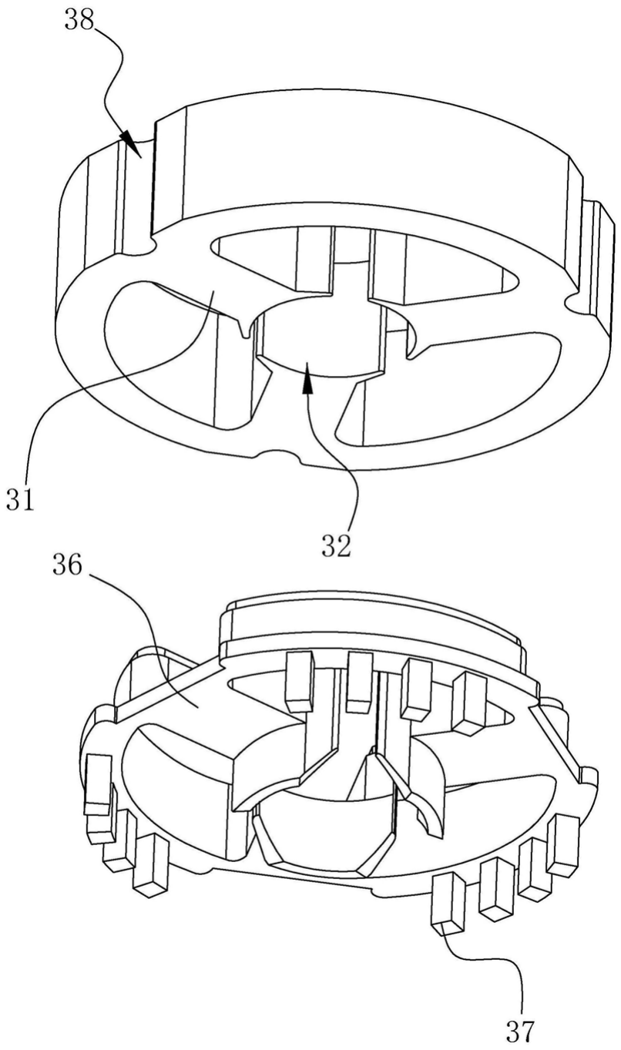
[picture p62: figure]

图11

说　明　书　附　图 | 11/18 页

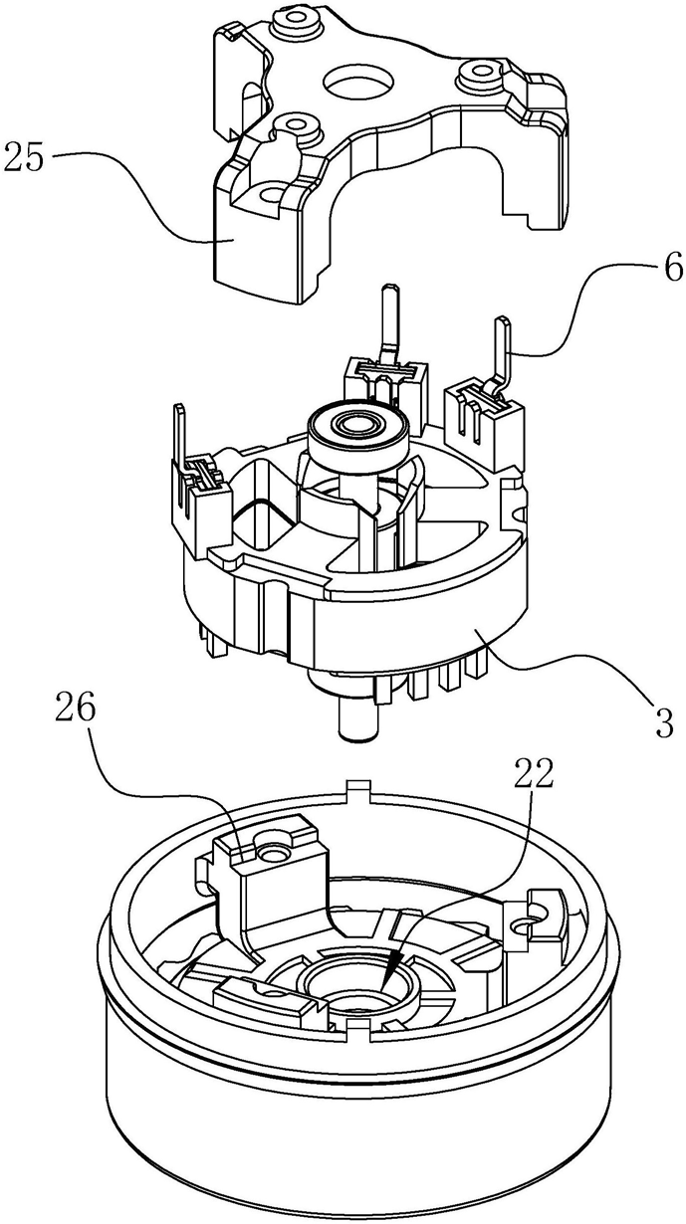
[picture p63: figure]

图12

说　明　书　附　图 | 12/18 页

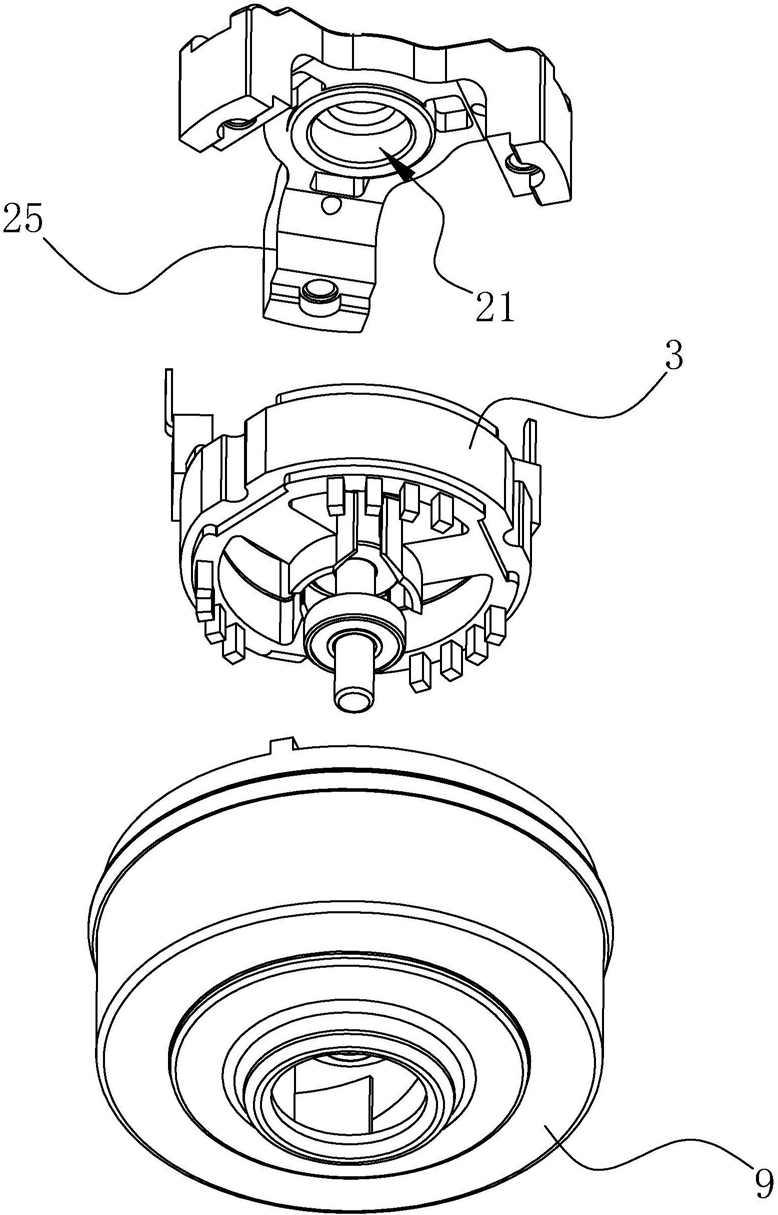
[picture p64: figure]

图13

说　明　书　附　图 | 13/18 页

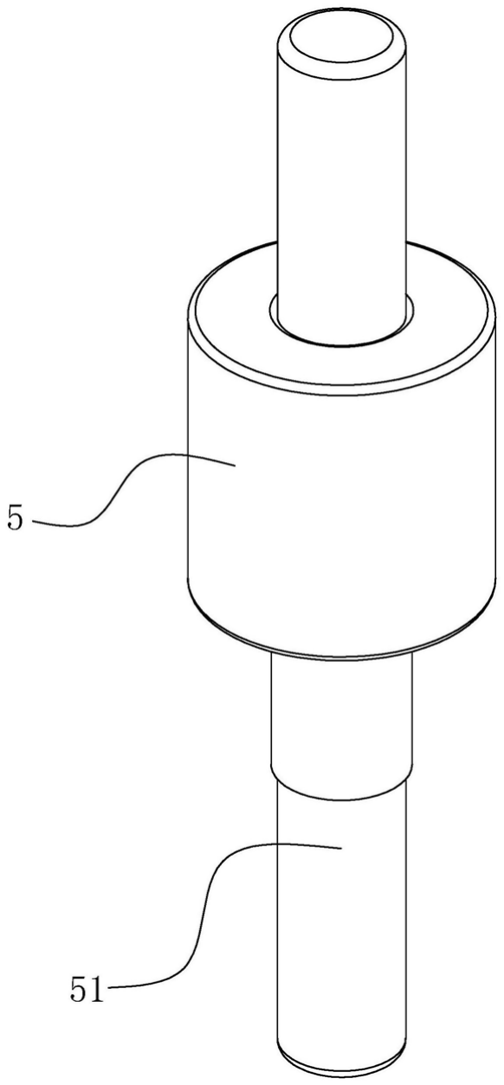
[picture p65: figure]

图14

说　明　书　附　图 | 14/18 页

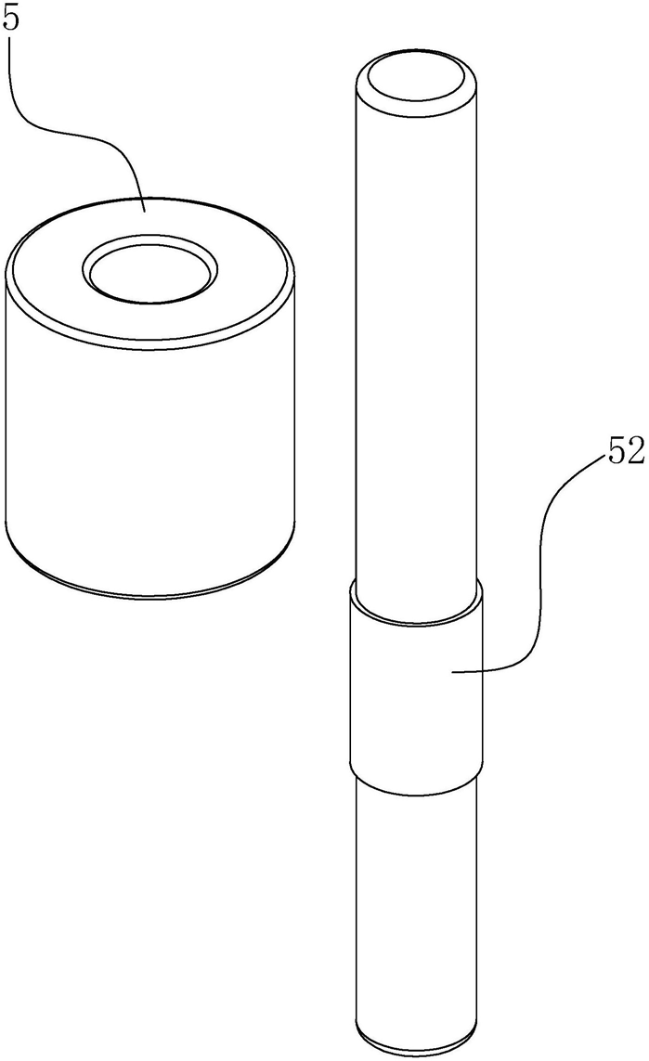
[picture p66: figure]

图15

说　明　书　附　图 | 15/18 页

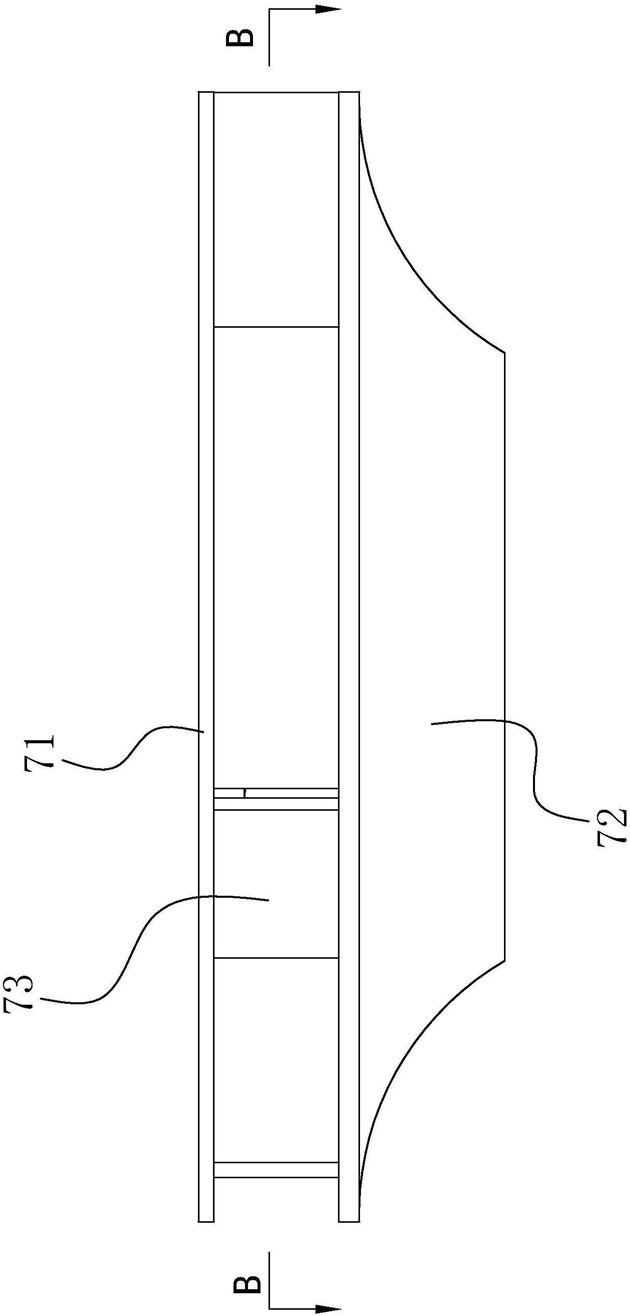
[picture p67: figure]

图16

说　明　书　附　图 | 16/18 页

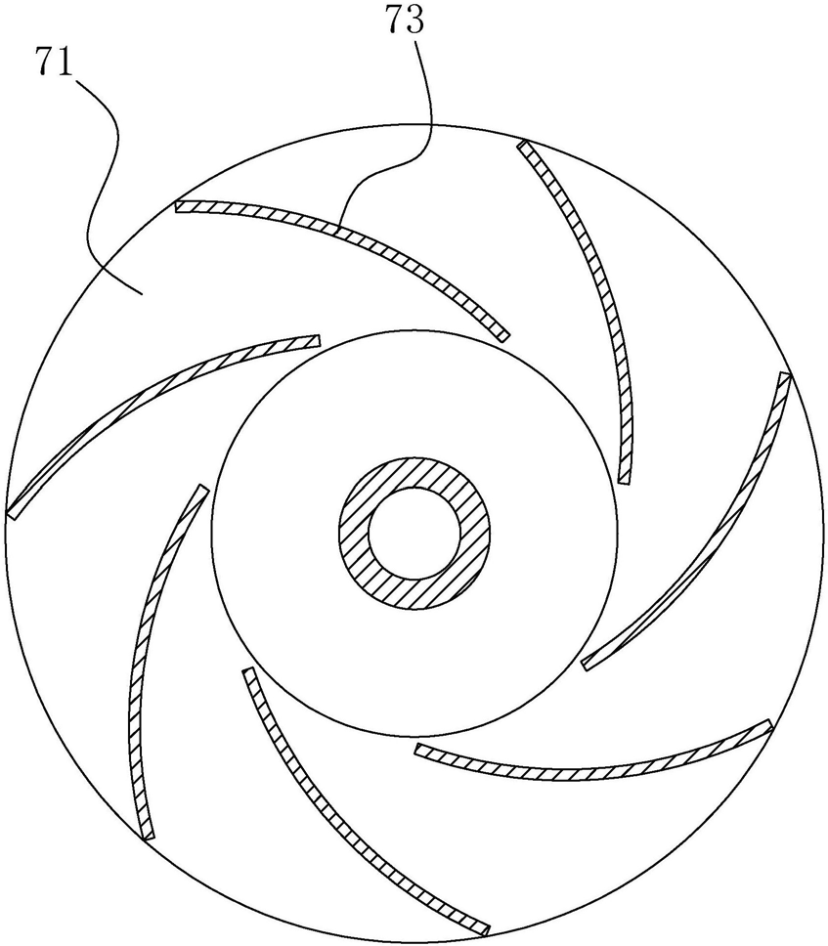
[picture p68: figure]

图17

说　明　书　附　图 | 17/18 页

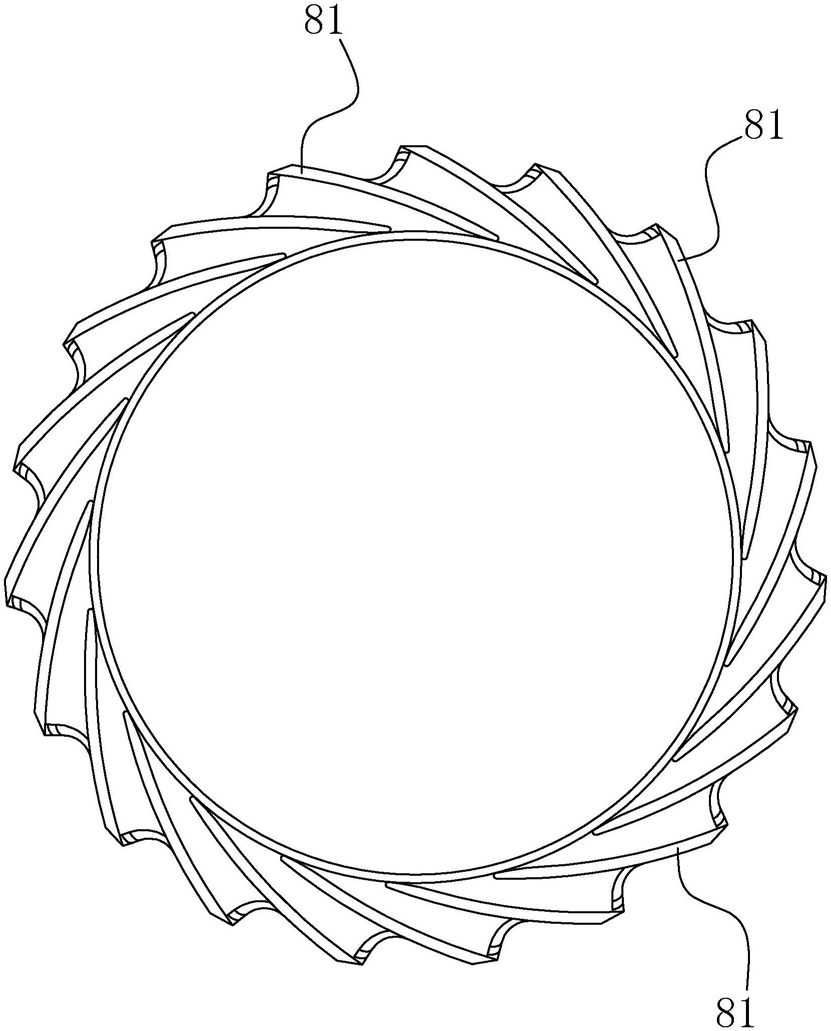
[picture p69: figure]

图18

说　明　书　附　图 | 18/18 页
