nbruite/vacuum/5-其他/1-专利/1-晨光专利/CN201721778645-定叶轮连接结构的无刷电机-实用新型.pdf

(19)中华人民共和国国家知识产权局

## (12)实用新型专利

(10)授权公告号
(45)授权公告日
(21)申请号 201721778645 .3

(22)申请日 2017 .12 .19

(73)专利权人 舟山晨光电器有限公司
地址 316200 浙江省舟山市岱山县浪激渚
工业经济开发区

(72)发明人 金建军

(51)Int .Cl .
H02K 7/14(2006 .01)

(54)实用新型名称
定叶轮连接结构的无刷电机
(57)摘要
一种定叶轮连接结构的无刷电机，包括支
架，定子，能相对定子转动的转子，能产生磁场的
线圈和控制线圈通电的电路控制板，线圈缠绕于
定子上，所述线圈、电路控制板与电源构成回路，
定子固定在支架内，转子穿过线圈、定子能转动
地设置在支架上，转子中插置有转轴，转轴的一
端穿过支架与风叶轮相连接，风叶轮外周面的外
部支架端面上设置有定叶轮，定叶轮的侧边上间
隔设置有将空气引向风叶轮的导风片。其优点在
于：定叶轮能引导气流沿一个方向向风叶轮流
动，有助于在风叶轮周围形成漩涡加快气流的流
动速度，提高电机的效率，并起到冷却电机降低
电机温度的作用，导风片还能阻挡颗粒物进入风
叶轮，减少杂质的影响，风叶轮不易损坏，延长风
叶轮的使用寿命。

权利要求书2页 说明书4页 附图16页

CN 207968200 U
2018.10.12

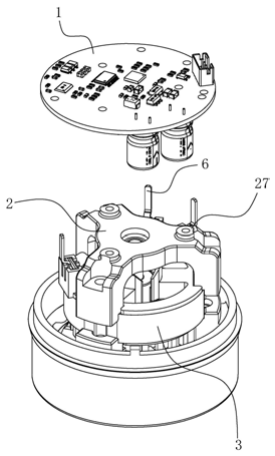
[picture p70: figure]

CN 207968200 U

1 .一种定叶轮连接结构的无刷电机，包括支架(2)，定子(3)，能相对定子(3)转动的转 子(5)，能通电产生磁场的线圈(4)和控制线圈(4)通电的电路控制板(1)，所述线圈(4)缠绕 于定子(3)上，所述线圈(4)、电路控制板(1)与电源构成回路，所述定子(3)固定在支架(2) 内，所述转子(5)穿过线圈(4)、定子(3)能转动地设置在支架(2)上，其特征在于：所述转子 (5)中插置有转轴(51)，所述转轴(51)的一端穿过支架(2)与风叶轮(7)相连接，风叶轮(7) 外周面的外部支架端面上设置有定叶轮(8)，所述定叶轮(8)的侧边上间隔设置有将空气引 向风叶轮的导风片(81)。
2 .根据权利要求1所述的无刷电机，其特征在于：所述导风片(81)等间隔地设置在定叶 轮(8)的侧边上，所述导风片(81)的俯视投影呈弧形，且相邻导风片(81)侧壁之间形成的通 道进口宽而出口窄。
3 .根据权利要求2所述的无刷电机，其特征在于：所述支架(2)的底部设置有连接凸台 (28)，所述定叶轮(8)的内壁卡扣在连接凸台(28)上。
4 .根据权利要求1至3中任一所述的无刷电机，其特征在于：所述支架(2)的底部能脱卸 地设置有电机罩体(9)，所述电机罩体(9)的底部设置有连通电机罩体内外的连通孔，所述 定叶轮(8)与风叶轮(7)设置在连通孔上部的电机罩体(9)内腔中。
5 .根据权利要求1至3中任一所述的无刷电机，其特征在于：所述定子(3)的中部设置有 连接通孔，所述连接通孔的内壁上间隔地向内延伸出支撑臂(31)，所述支撑臂(31)的端部 形成能穿过转子(5)的定位孔(32)，所述定子(3)设置在限位架中，所述限位架固定在支架 (2)内，所述线圈(4)缠绕在支撑臂(31)对应的限位架上，所述限位架上设置有阻止线圈(4) 与转子(5)接触的线圈挡板(33)。
6 .根据权利要求5所述的无刷电机，其特征在于：所述限位架的上部设置有导电插片 (6)，电路控制板(1)上与导电插片(6)对应位置处设置有插孔(11)，所述导电插片(6)伸入 电路控制板(1)的插孔(11)中而与电路控制板(1)焊接固定在一起。
7 .根据权利要求6所述的无刷电机，其特征在于：所述限位架的上部设置有插接凸部 (34)，所述插接凸部(34)的顶端设置有插槽，所述导电插片(6)能脱卸地插置在插槽中，所 述线圈(4)的端部穿过插接凸部(34)与导电插片(6)相连接。
8 .根据权利要求7所述的无刷电机，其特征在于：所述限位架包括上架体(35)与下架体 (36)，所述插接凸部(34)设置在上架体(35)的顶面上，所述下架体(36)的底面上设置有能 缠绕导线防止线圈(4)松脱的绕线柱(37)，所述定子(3)设置在上架体(35)与下架体(36)对 合后形成的限位架中。
9 .根据权利要求1至3中任一所述的无刷电机，其特征在于：所述风叶轮(7)包括上盘体 (71)，下盘体(72)和间隔设置在上盘体(71)与下盘体(72)之间的叶片(73)，所述下盘体 (72)的中部设置有盘体通孔(74)，所述上盘体(71)与转子的下端相连接，相邻叶片(73)之 间形成的间隙与下盘体(72)的盘体通孔(74)相连通。
10 .根据权利要求1至3中任一所述的无刷电机，其特征在于：所述支架(2)包括上支架 与下支架，所述上支架与下支架通过螺栓相固定，所述定子卡置在上支架与下支架之间，所 述控制板(1)连接在上支架的顶面上，所述上支架的底面与下支架的顶面上分别设置有上 凹腔(21)与下凹腔(22)，所述上凹腔(21)与下凹腔(22)中分别设置有上轴承(23)与下轴承 (24)，所述转轴(51)的一端插入上轴承(23)中，所述转轴(51)的另一端穿过下轴承(24)与
权　利　要　求　书 | 1/2 页
CN 207968200 U

下凹腔(22)而伸出下支架。

权　利　要　求　书 | 2/2 页

定叶轮连接结构的无刷电机

技术领域
[0001] 本实用新型涉及一种电机制作技术领域，尤其指一种定叶轮连接结构的无刷电 机。

背景技术
[0002] 现有一种申请号为CN201610952649 .2名称为《一种家用风扇的DC三相无刷电机》 的中国发明专利申请公开了一种家用风扇的DC三相具有转子限位结构的直流无刷电机，包 括有绕线组、磁框、轴承和PCB板，还包括有磁石和基座，所述磁框设置有轴芯，所述绕线组 套设于轴芯，所述磁框套设于绕线组的外表面，所述磁石位于磁框与绕线组之间；所述绕线 组与PCB板连接，所述基座套设于轴芯并穿设于绕线组的内孔，所述基座的一端与磁框接 触，所述基座的另一端凸出于PCB板，所述轴承套设于轴芯并安装于基座内。该发明能够将 220V的AC电压转换成5V的DC电压，并保证该发明在5V电压的驱动下能够达到AC电机的运行 转速及风压风量，既节约了电能，又能满足散热的效果。然而，该无刷电机的冷却结构不合 进，即冷却效果差，因此该装置的结构还需进一步改进。

发明内容
[0003] 本实用新型所要解决的技术问题是针对上述现有技术现状而提供一种定叶轮连 接结构的无刷电机，本无刷电机的定叶轮连接结构巧妙、合理，固定牢固，进风效果好且不 易损坏，使用寿命长。
[0004] 本实用新型解决上述技术问题所采用的技术方案为：本定叶轮连接结构的无刷电 机，包括支架，定子，能相对定子转动的转子，能通电产生磁场的线圈和控制线圈通电的电 路控制板，所述线圈缠绕于定子上，所述线圈、电路控制板与电源构成回路，所述定子固定 在支架内，所述转子穿过线圈、定子能转动地设置在支架上，其特征在于：所述转子中插置 有转轴，所述转轴的一端穿过支架与风叶轮相连接，风叶轮外周面的外部支架端面上设置 有定叶轮，所述定叶轮的侧边上间隔设置有将空气引向风叶轮的导风片。
[0005] 作为改进，所述导风片可优选等间隔地设置在定叶轮的侧边上，所述导风片的俯 视投影呈弧形，且相邻导风片侧壁之间形成的通道进口宽而出口窄。
[0006] 进一步改进，所述支架的底部设置有连接凸台，所述定叶轮的内壁卡扣在连接凸 台上。
[0007] 作为改进，所述支架的底部可优选能脱卸地设置有电机罩体，所述电机罩体的底 部设置有连通电机罩体内外的连通孔，所述定叶轮与风叶轮设置在连通孔上部的电机罩体 内腔中。
[0008] 作为改进，所述定子的中部可优选设置有连接通孔，所述连接通孔的内壁上间隔 地向内延伸出支撑臂，所述支撑臂的端部形成能穿过转子的定位孔，所述定子设置在限位 架中，所述限位架固定在支架内，所述线圈缠绕在支撑臂对应的限位架上，所述限位架上设 置有阻止线圈与转子接触的线圈挡板。
说　明　书 | 1/4 页

[0009] 进一步改进，所述限位架的上部可优选设置有导电插片，电路控制板上与导电插 片对应位置处设置有插孔，所述导电插片伸入电路控制板的插孔中而与电路控制板焊接固 定在一起。
[0010] 进一步改进，所述限位架的上部可优选设置有插接凸部，所述插接凸部的顶端设 置有插槽，所述导电插片能脱卸地插置在插槽中，所述线圈的端部穿过插接凸部与导电插 片相连接。
[0011] 进一步改进，所述限位架包括上架体与下架体，所述插接凸部设置在上架体的顶 面上，所述下架体的底面上设置有能缠绕导线防止线圈松脱的绕线柱，所述定子设置在上 架体与下架体对合后形成的限位架中。
[0012] 作为改进，所述风叶轮可优选为风叶轮，所述风叶轮包括上盘体，下盘体和间隔设 置在上盘体与下盘体之间的叶片，所述下盘体的中部设置有盘体通孔，所述上盘体与转子 的下端相连接，相邻叶片之间形成的间隙与下盘体的盘体通孔相连通。
[0013] 作为改进，所述支架包括上支架与下支架，所述上支架与下支架通过螺栓相固定， 所述定子卡置在上支架与下支架之间，所述控制板连接在上支架的顶面上，所述上支架的 底面与下支架的顶面上分别设置有上凹腔与下凹腔，所述上凹腔与下凹腔中分别设置有上 轴承与下轴承，所述转轴的一端插入上轴承中，所述转轴的另一端穿过下轴承与下凹腔而 伸出下支架。
[0014] 与现有技术相比，本实用新型采用转子中插置有转轴，所述转轴的一端穿过支架 与风叶轮相连接，风叶轮外周面的外部支架端面上设置有定叶轮，所述定叶轮的侧边上间 隔设置有将空气引向风叶轮的导风片，这种结构的优点在于：定叶轮能引导气流沿一个方 向向风叶轮流动，有助于在风叶轮周围形成漩涡加快气流的流动速度，提高电机的效率，并 起到冷却电机降低电机温度的作用，导风片还能阻挡颗粒物进入风叶轮，减少杂质的影响， 风叶轮不易损坏，延长风叶轮的使用寿命，定叶轮能脱卸地设置在连接凸台上更换清洗方 便；叶片固定在上盘体与下盘体之间，上盘体与下盘体能加固叶片，提高风叶轮的强度，更 为坚固耐用，还能减缓叶片的损坏，延长叶片的使用寿命；上盘体与转轴相连接，连接面积 更大，连接更为稳定，确保风叶轮平稳转动，使用效果更好；下盘体的中部设置有盘体通孔， 从风叶轮侧部进入风叶轮的气流能从盘体通孔中排出，从而在风叶轮下部形成上下的气流 循环，提高电机的工作效率。

附图说明
[0015] 图1为为本实用新型实施例的立体图；
[0016] 图2为图1的俯视图；
[0017] 图3是图2中沿A-A线的剖面图；
[0018] 图4是图1的结构分解图；
[0019] 图5是图4的进一步结构分解图；
[0020] 图6是图5中未分解部分的结构分解图；
[0021] 图7是图5处于另一个角度的结构分解图；
[0022] 图8是图6中未分解部分的结构分解图；
[0023] 图9是图6处于另一个角度的结构分解图；
说　明　书 | 2/4 页

[0024] 图10是图8中未分解部分的结构分解图；
[0025] 图11是图10中未分解部分的结构分解图；
[0026] 图12是图4中未分解部分的结构分解图；
[0027] 图13是图4处于另一个角度的结构分解图；
[0028] 图14是图10中风叶轮的正面投影图；
[0029] 图15是图14中沿B-B线的剖面图；
[0030] 图16是图8中定叶轮的仰视图。

具体实施方式
[0031] 以下结合附图实施例对本实用新型作进一步详细描述。
[0032] 如图1至图16所示，本实施例的定叶轮连接结构的无刷电机，包括支架2，定子3，能 相对定子3转动的转子5，能通电产生磁场的线圈4和控制线圈4通电的电路控制板 1，所述 线圈4缠绕于定子3上，所述线圈4、电路控制板1与电源构成回路，所述定子 3固定在支架2 内，所述转子5穿过线圈4、定子3能转动地设置在支架2上，所述转子5中插置有转轴51，所述 转轴51的一端穿过支架2与风叶轮相连接，风叶轮外周面的外部支架端面上设置有定叶轮 8，所述定叶轮8的侧边上间隔设置有将空气引向风叶轮的导风片81。所述导风片81等间隔 地设置在定叶轮8的侧边上，所述导风片81的俯视投影呈弧形，且相邻导风片81侧壁之间形 成的通道进口宽而出口窄。所述支架2的底部设置有连接凸台28，所述定叶轮8的内壁卡扣 在连接凸台28上。
[0033] 支架2的底部能脱卸地设置有电机罩体9，所述电机罩体9的底部设置有连通电机 罩体内外的连通孔，所述定叶轮8与风叶轮7设置在连通孔上部的电机罩体9内腔中。定子3 的中部设置有连接通孔，所述连接通孔的内壁上间隔地向内延伸出支撑臂31，所述支撑臂 31的端部形成能穿过转子5的定位孔32，所述定子3设置在限位架中，所述限位架固定在支 架2内，所述线圈4缠绕在支撑臂31对应的限位架上，所述限位架上设置有阻止线圈4与转子 5接触的线圈挡板33。所述限位架的上部设置有导电插片6，电路控制板1上与导电插片6对 应位置处设置有插孔11，所述导电插片6伸入电路控制板1的插孔11中而与电路控制板1焊 接固定在一起。所述限位架的上部设置有插接凸部34，所述插接凸部34的顶端设置有插槽， 所述导电插片6能脱卸地插置在插槽中，所述线圈4的端部穿过插接凸部34与导电插片6相 连接。所述限位架包括上架体35与下架体36，所述插接凸部34设置在上架体35的顶面上，所 述下架体36的底面上设置有能缠绕导线防止线圈4松脱的绕线柱37，所述定子3设置在上架 体35与下架体36 对合后形成的限位架中。
[0034] 上述风叶轮7包括上盘体71，下盘体72和间隔设置在上盘体71与下盘体72之间的 叶片73，所述下盘体72的中部设置有盘体通孔74，所述上盘体71与转子的下端相连接，相邻 叶片73之间形成的间隙与下盘体72的盘体通孔74相连通。所述支架2包括上支架与下支架， 所述上支架与下支架通过螺栓相固定，所述定子卡置在上支架与下支架之间，所述控制板1 连接在上支架的顶面上，所述上支架的底面与下支架的顶面上分别设置有上凹腔21与下凹 腔22，所述上凹腔21与下凹腔22中分别设置有上轴承23 与下轴承24，所述转轴51的一端插 入上轴承23中，所述转轴51的另一端穿过下轴承 24与下凹腔22而伸出下支架。所述上支架 的周边间隔设置有上凸部25，所述下支架的顶部设置有连接凸环，所述连接凸环的内壁上
说　明　书 | 3/4 页

对应设置有下凸部26，所述定子的上表面顶触在上凸部25的底面，所述定子的下表面顶触 在下凸部26的顶面，用于连接上支架与下支架的螺栓将上凸部25与下凸部26插接在一起。 所述定子的侧壁上设置有限位凹槽38，用以固定上支架与下支架的螺栓的杆体卡置在限位 凹槽38中。转轴中部的设置有限位凸部，所述转子5的下表面顶触在限位凸部上。所述支架2 的顶部设置有凸起部 27，所述电路控制板1的板体上设置有连接孔，所述连接孔通过螺钉 与相应的凸起部27 相连接。导电插片6的底部设置有插接部61，所述插接部61插置在插接 凸部34顶部的插槽中。所述凸起部27为圆柱体，所述圆柱体的中心设置有能与连接孔相连 接的圆柱通孔，所述圆柱体为三个，三个圆柱体分别位于等边三角形的三个顶角上。

说　明　书 | 4/4 页

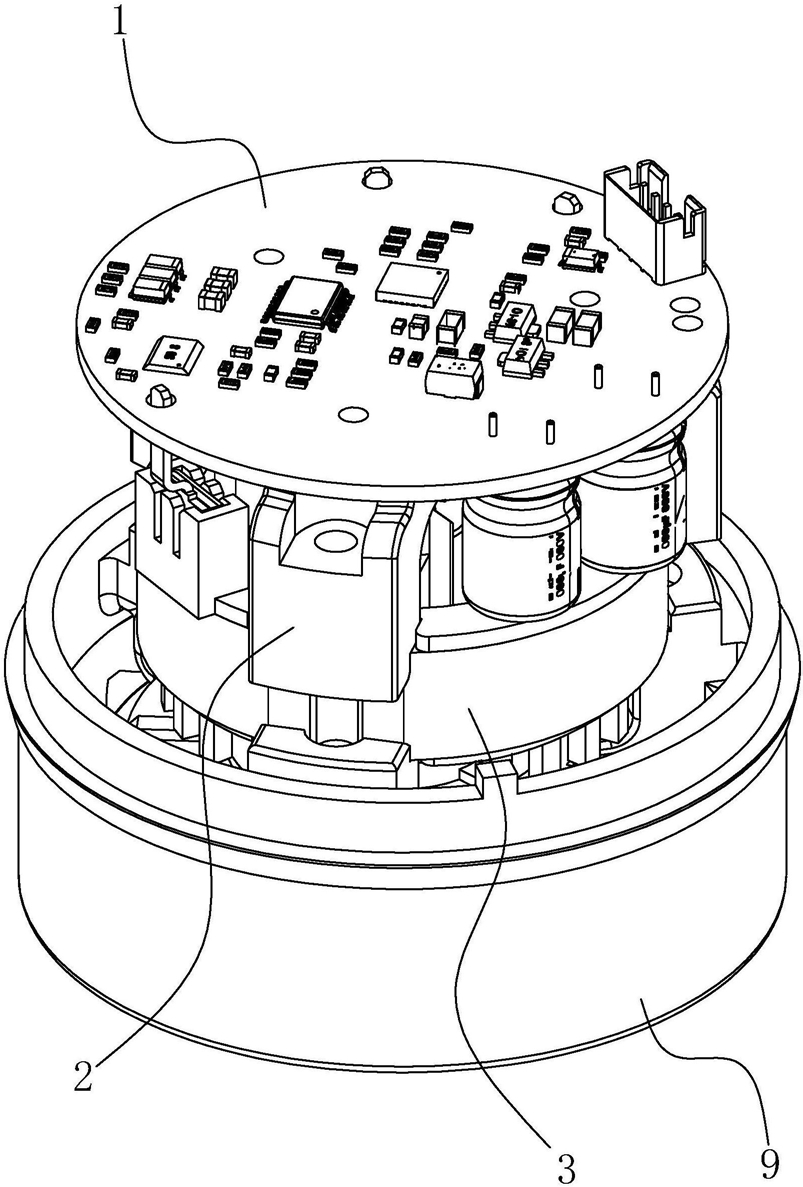
[picture p71: figure]

图1

说　明　书　附　图 | 1/16 页

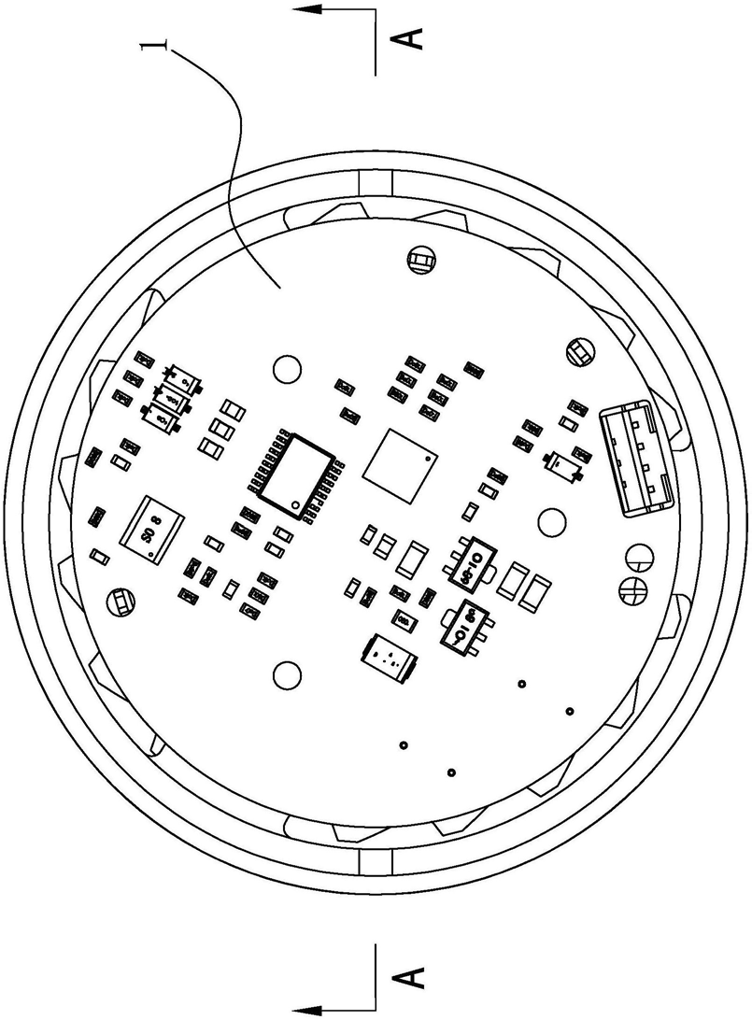
[picture p72: figure]

图2

说　明　书　附　图 | 2/16 页

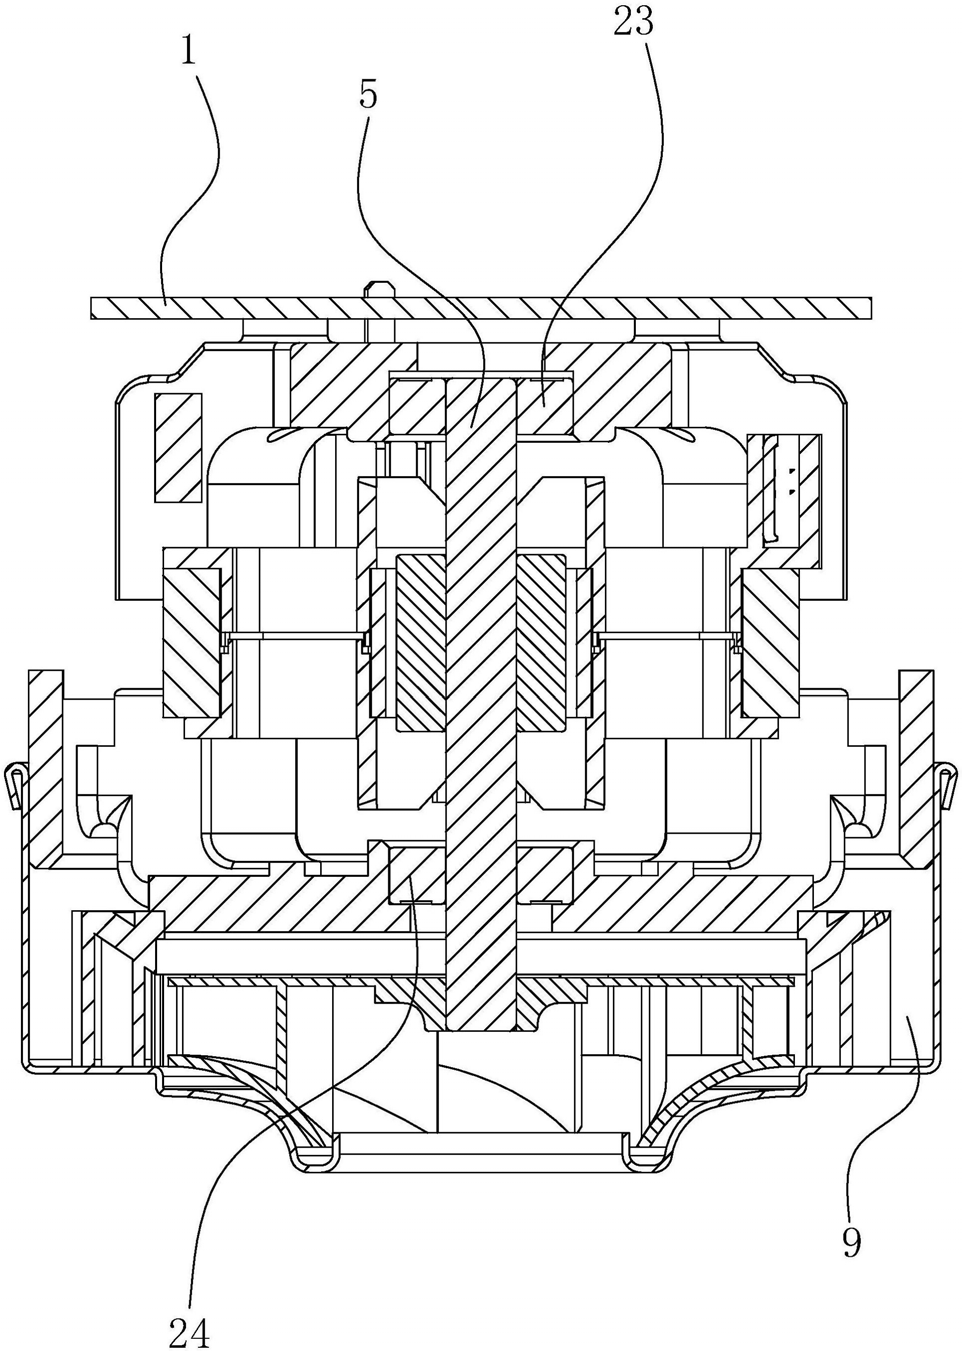
[picture p73: figure]

图3

说　明　书　附　图 | 3/16 页

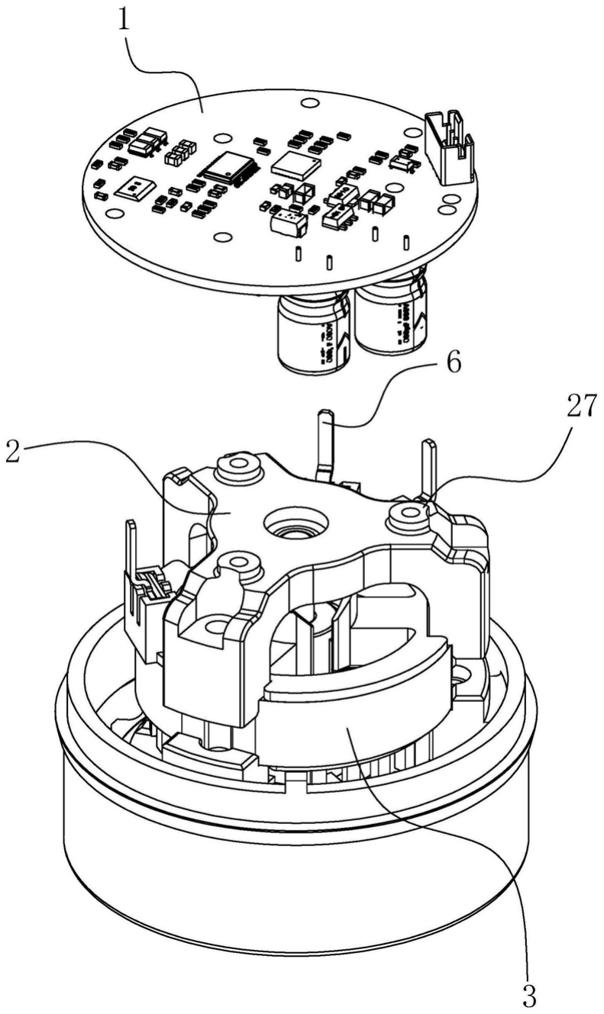
[picture p74: figure]

图4

说　明　书　附　图 | 4/16 页

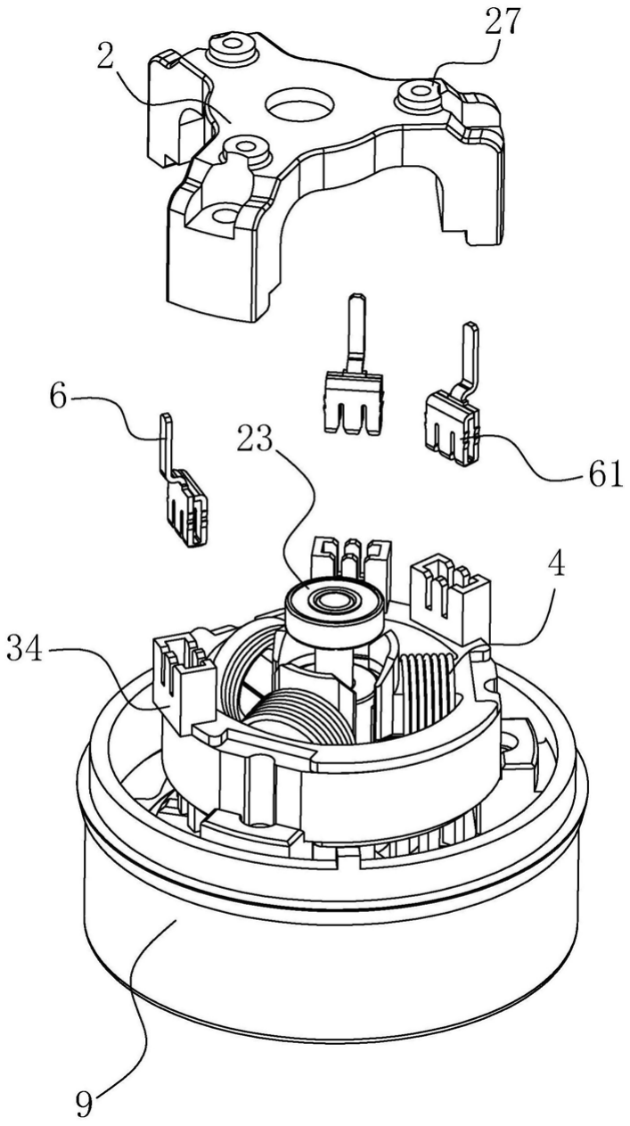
[picture p75: figure]

图5

说　明　书　附　图 | 5/16 页

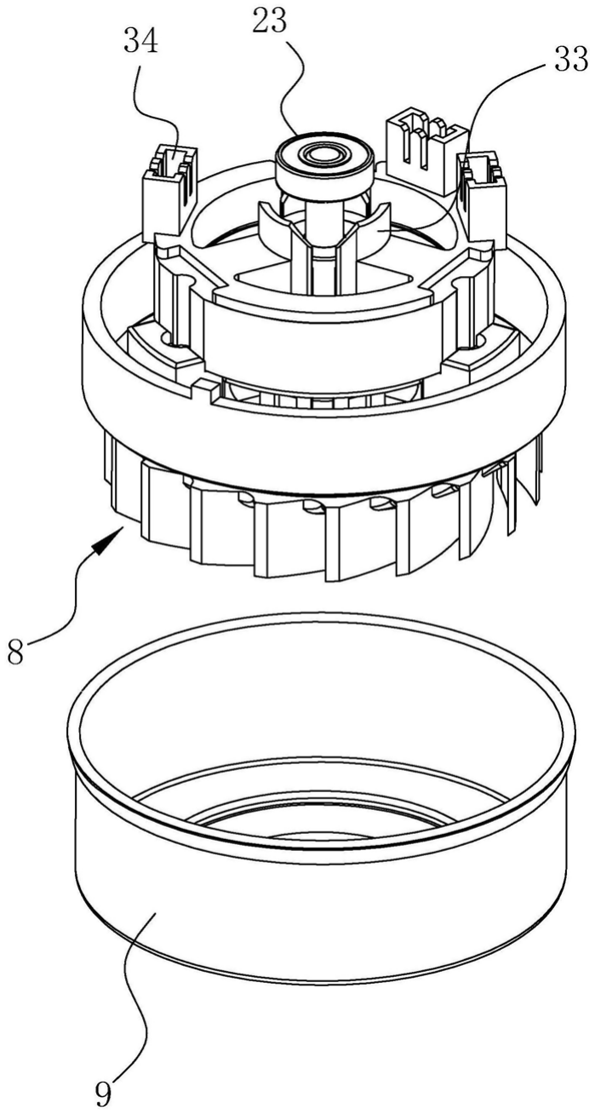
[picture p76: figure]

图6

说　明　书　附　图 | 6/16 页

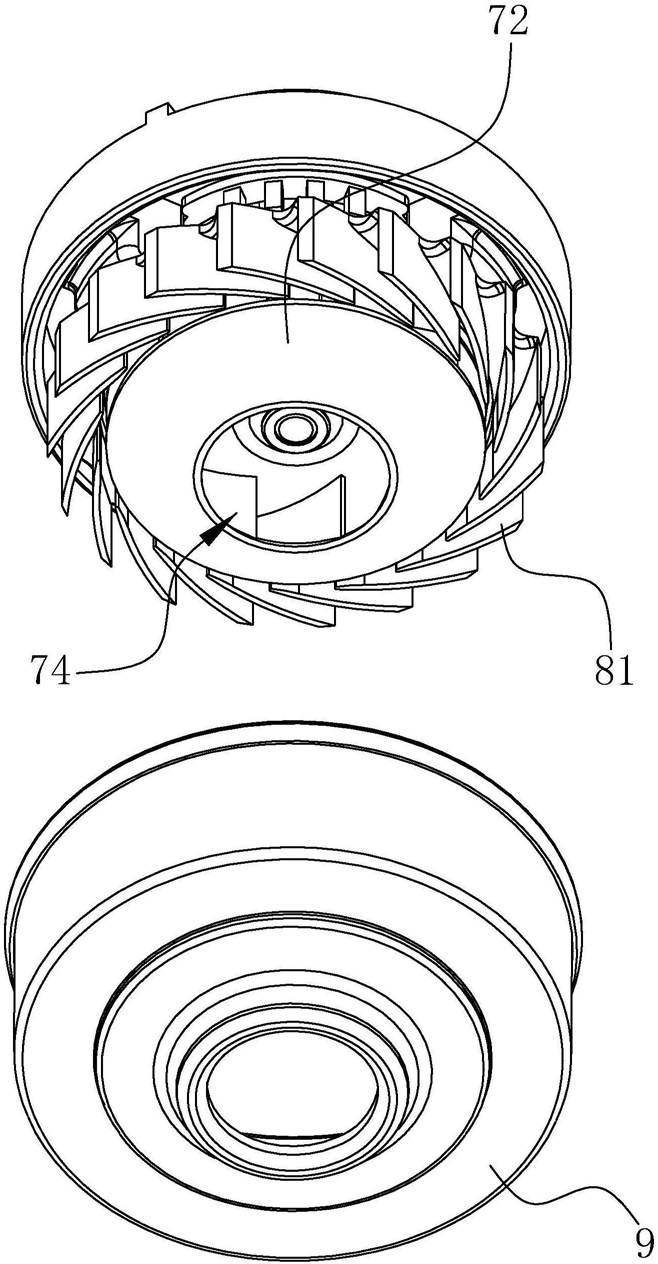
[picture p77: figure]

图7

说　明　书　附　图 | 7/16 页

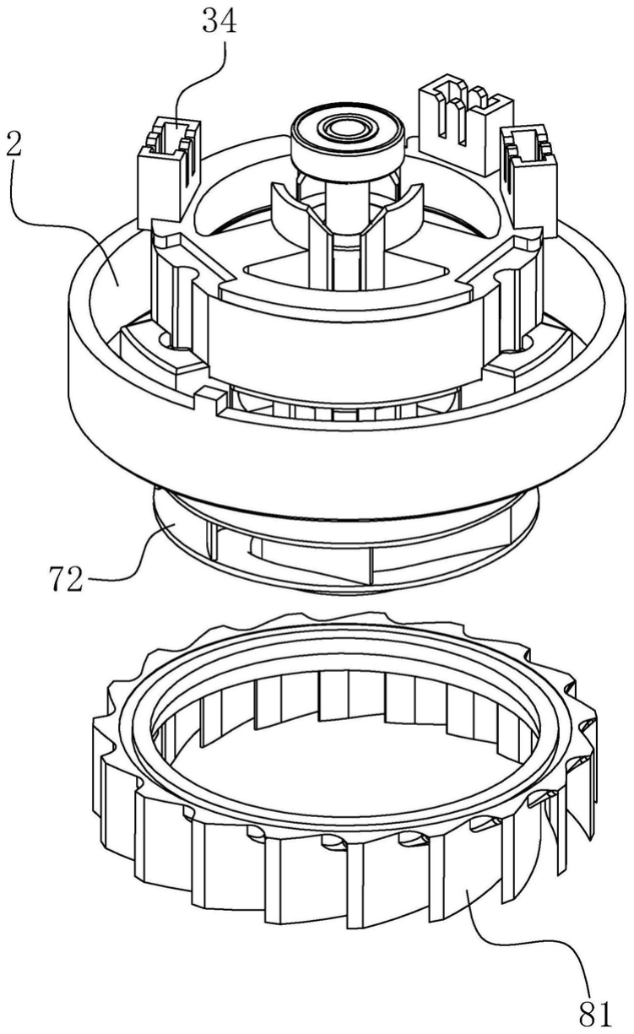
[picture p78: figure]

图8

说　明　书　附　图 | 8/16 页

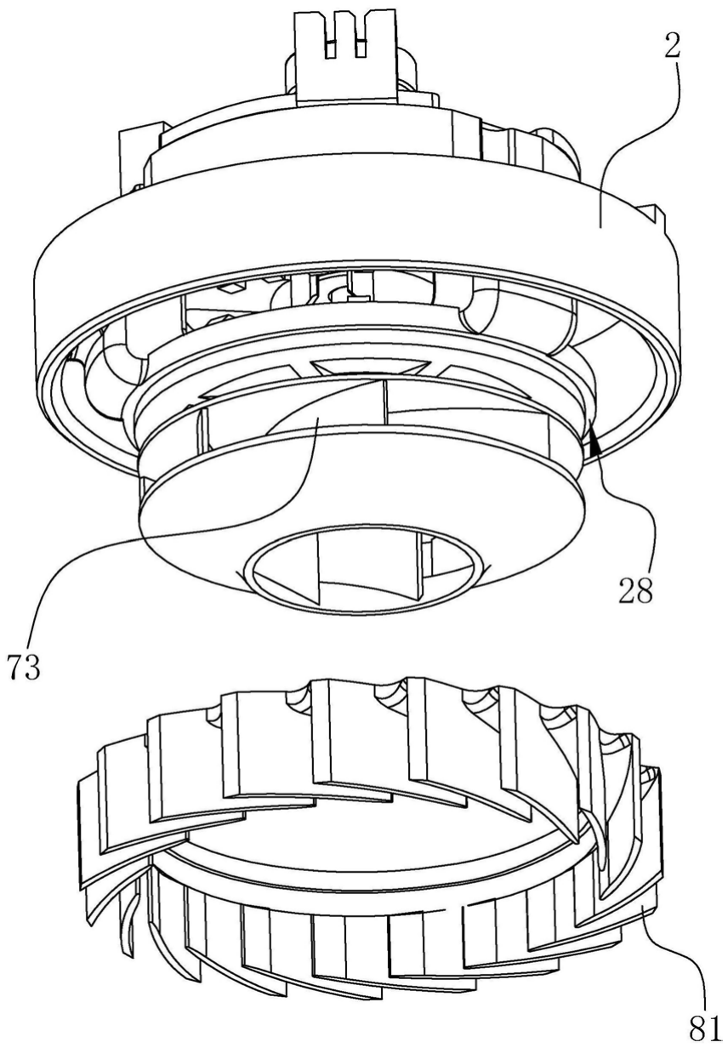
[picture p79: figure]

图9

说　明　书　附　图 | 9/16 页

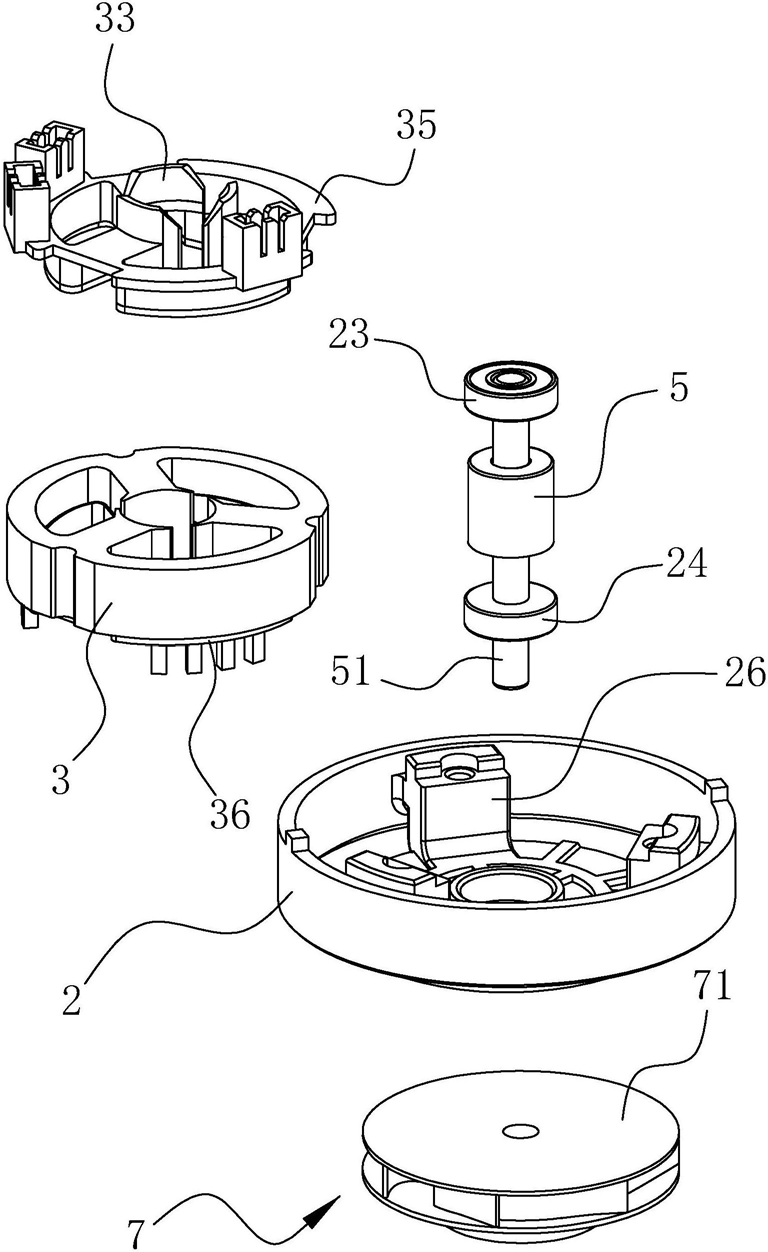
[picture p80: figure]

图10

说　明　书　附　图 | 10/16 页

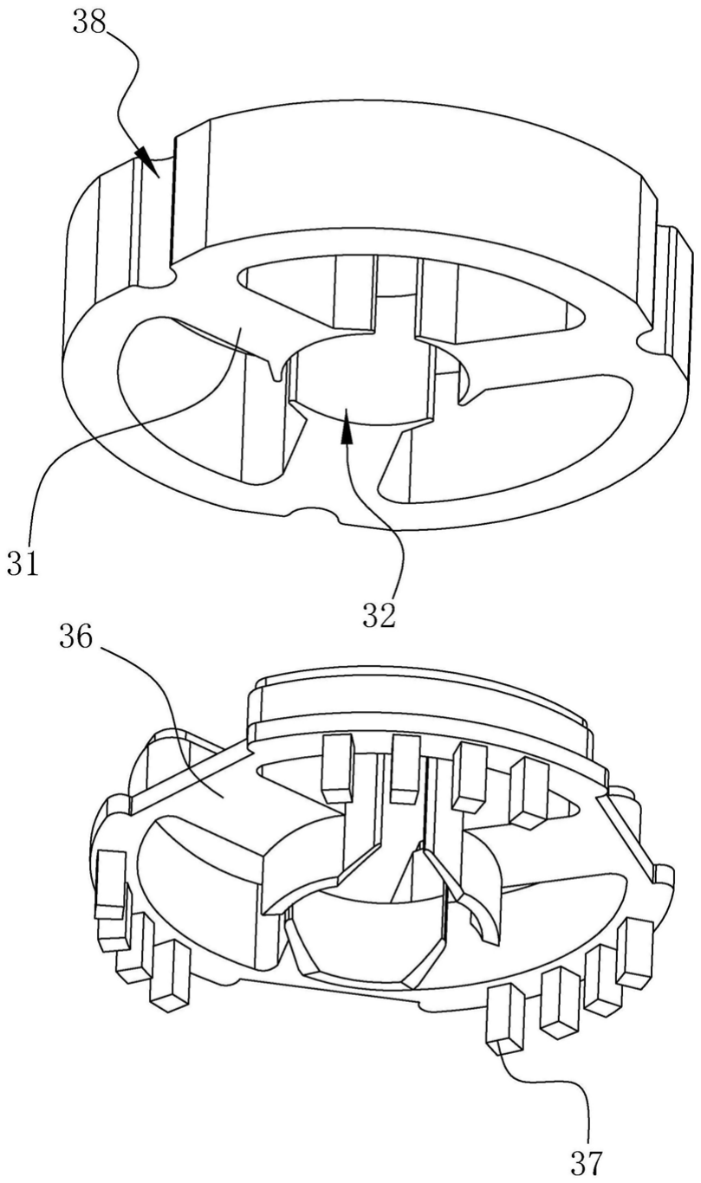
[picture p81: figure]

图11

说　明　书　附　图 | 11/16 页

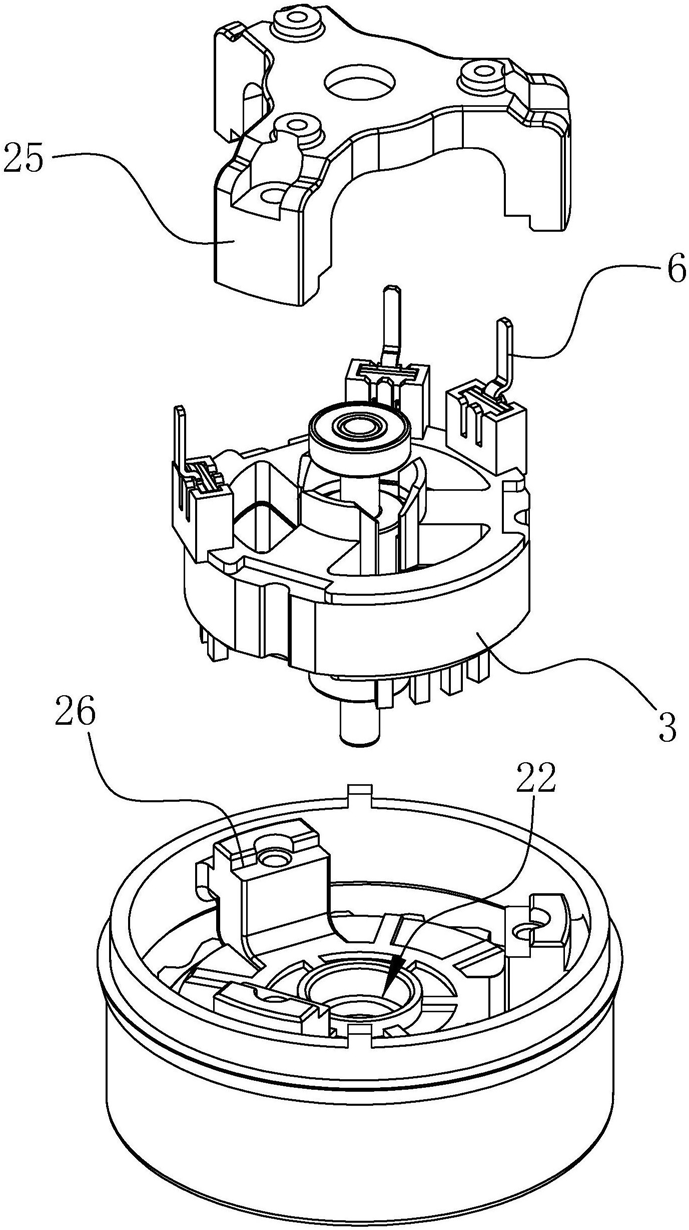
[picture p82: figure]

图12

说　明　书　附　图 | 12/16 页

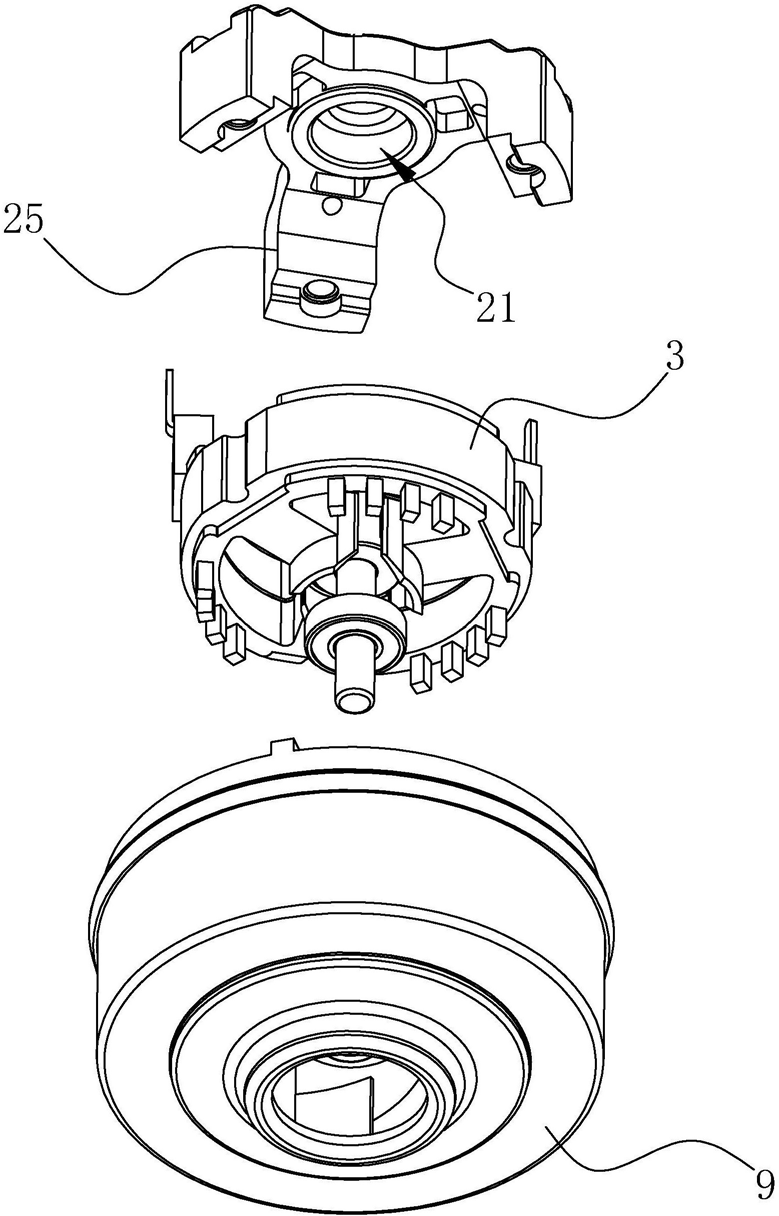
[picture p83: figure]

图13

说　明　书　附　图 | 13/16 页

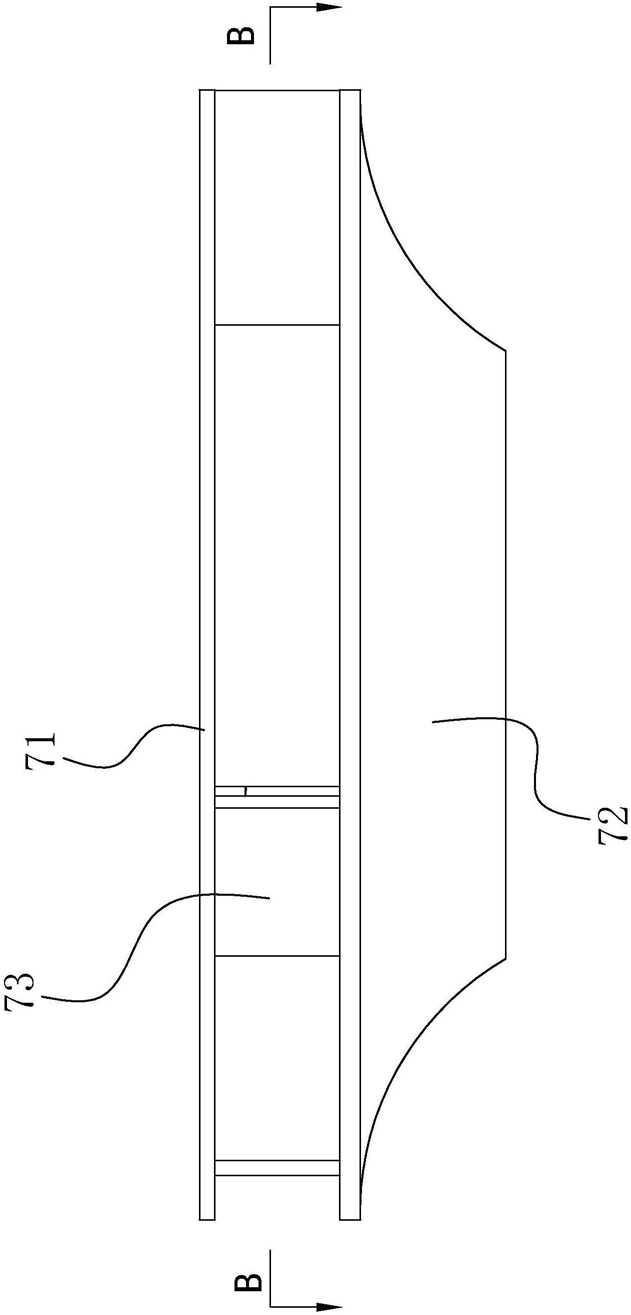
[picture p84: figure]

图14

说　明　书　附　图 | 14/16 页

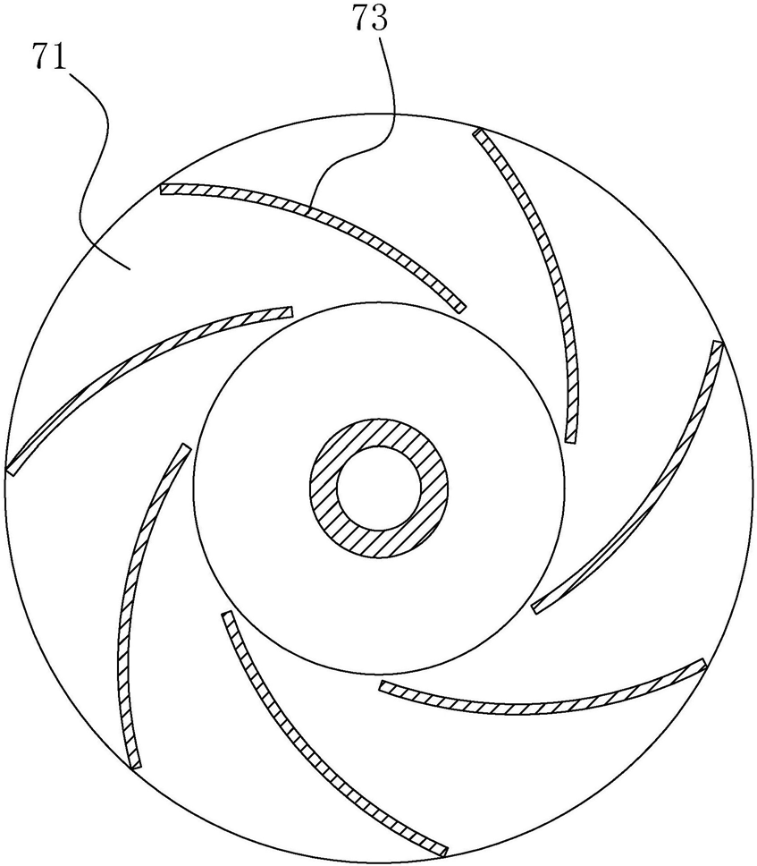
[picture p85: figure]

图15

说　明　书　附　图 | 15/16 页

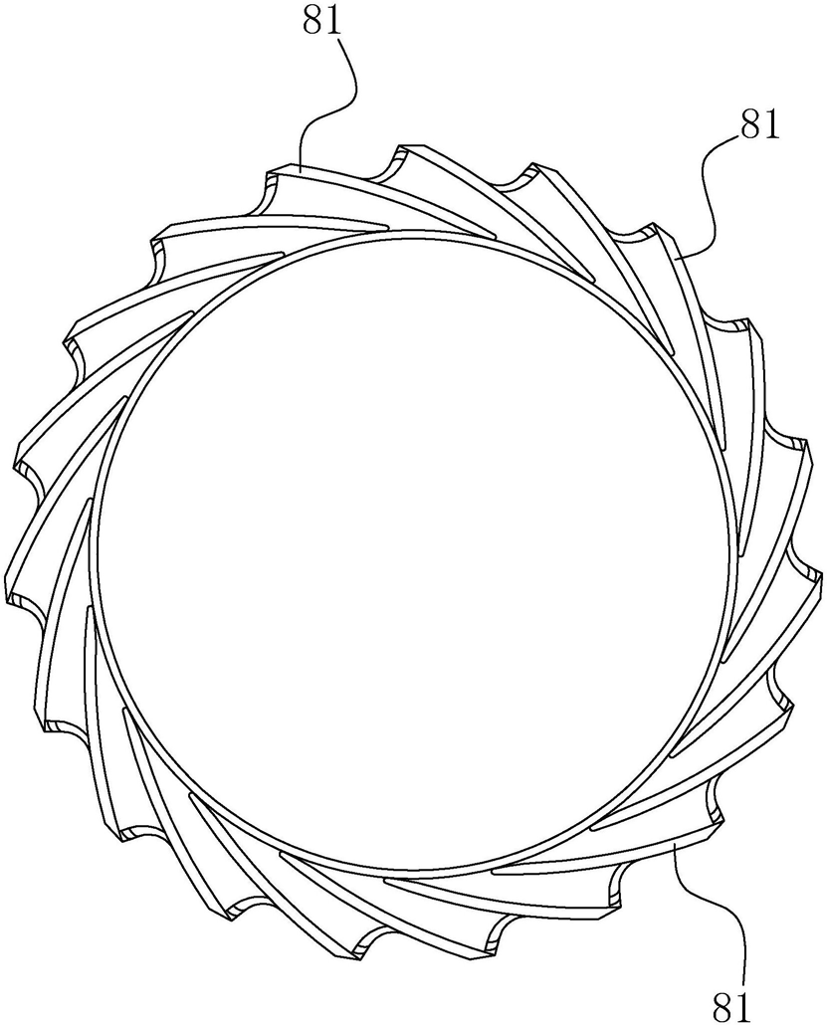
[picture p86: figure]

图16

说　明　书　附　图 | 16/16 页
