nbruite/vacuum/2-采购合同/T型垫片&六角螺母/营业执照-明顺五金.jpg

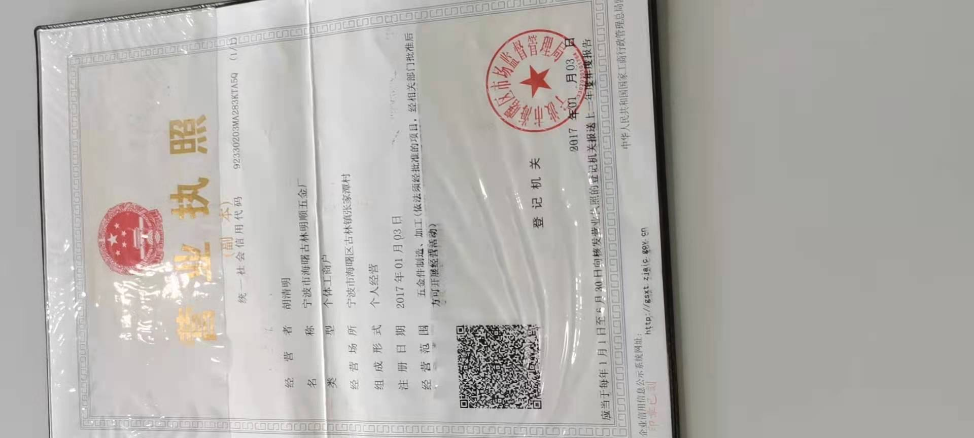
2-采购合同/T型垫片&六角螺母/营业执照-明顺五金.jpg
