nbruite/vacuum/2-采购合同/T型垫片&六角螺母/采购合同20210804.jpg

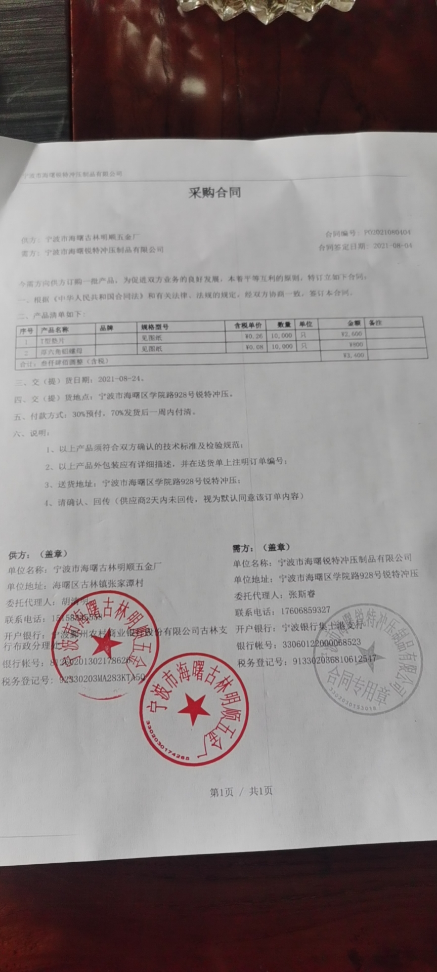
2-采购合同/T型垫片&六角螺母/采购合同20210804.jpg
