nbruite/vacuum/2-采购合同/塑料件/上下骨架/模具合同（双方盖章）.jpg

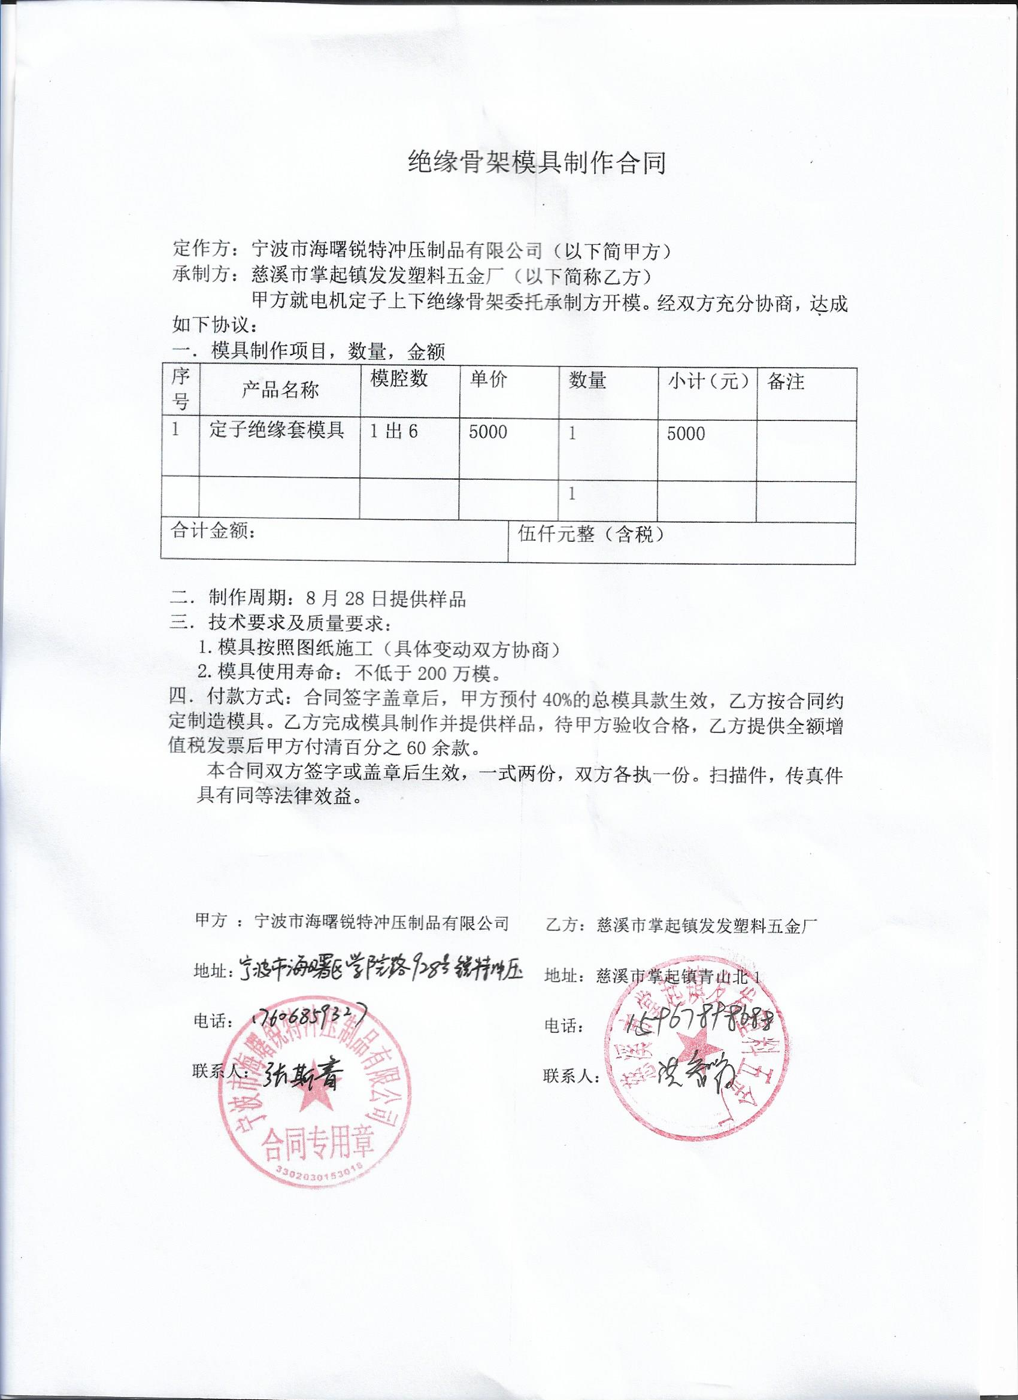
2-采购合同/塑料件/上下骨架/模具合同（双方盖章）.jpg
