nbruite/vacuum/2-采购合同/塑料件/上下骨架/营业执照-发发.jpg

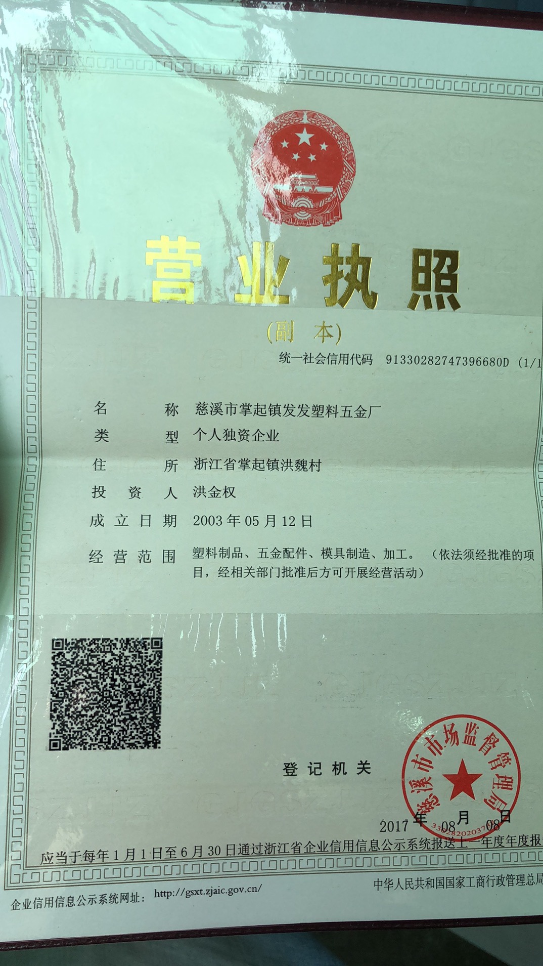
2-采购合同/塑料件/上下骨架/营业执照-发发.jpg
