nbruite/vacuum/2-采购合同/磁钢/磁钢.jpg

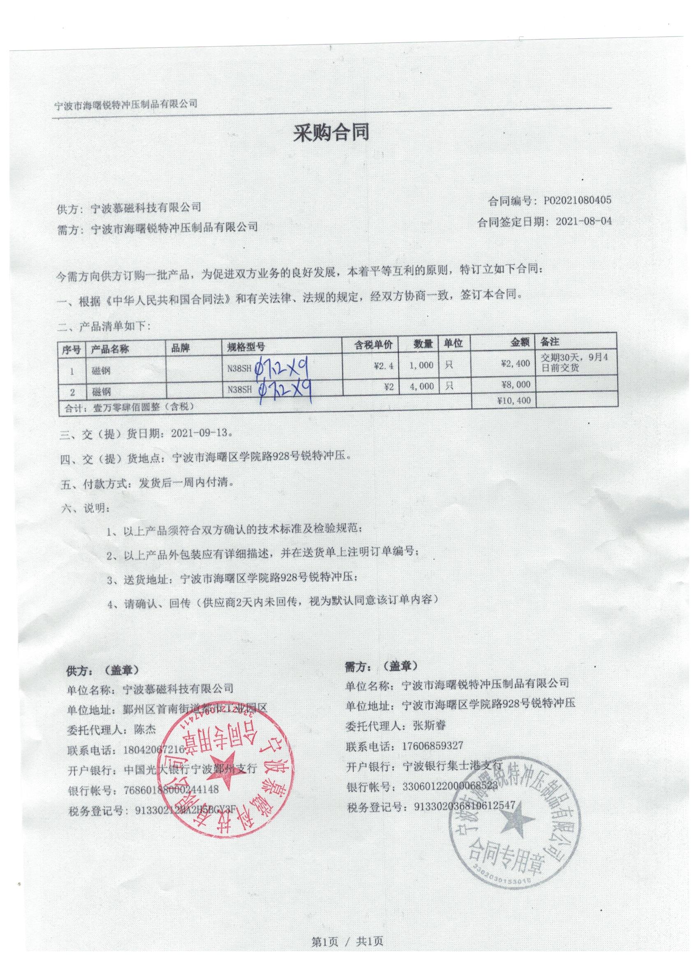
2-采购合同/磁钢/磁钢.jpg
