nbruite/vacuum/2-采购合同/紧固件/营业执照-鄞州利华.jpg

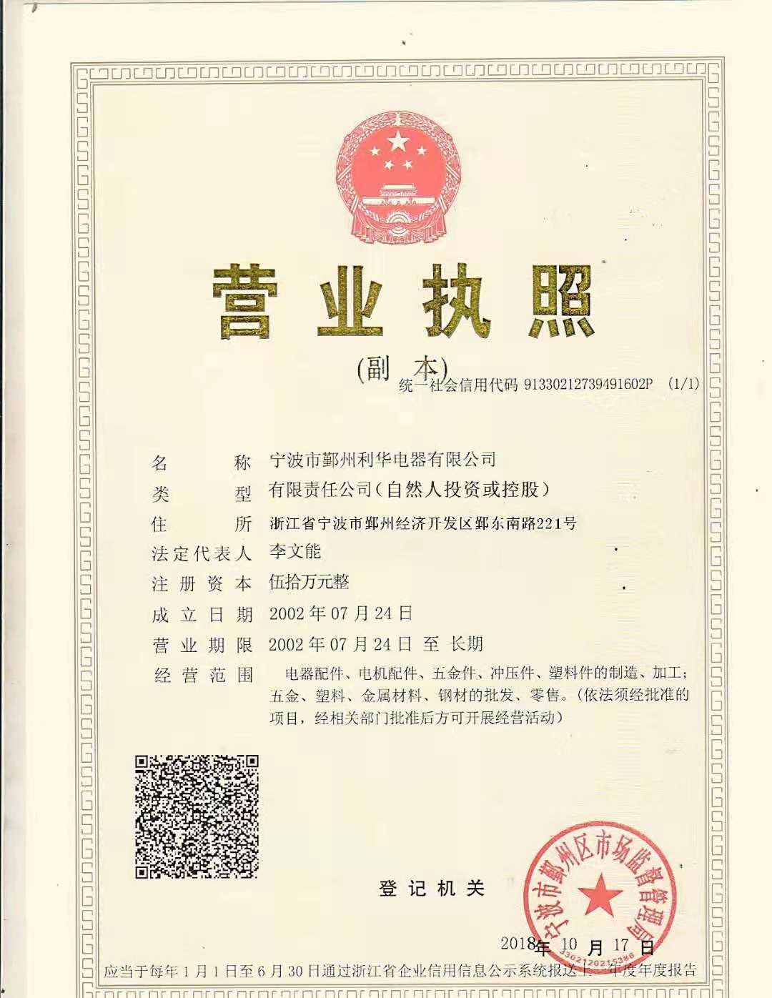
2-采购合同/紧固件/营业执照-鄞州利华.jpg
