nbruite/vacuum/2-采购合同/紧固件/采购合同.jpg

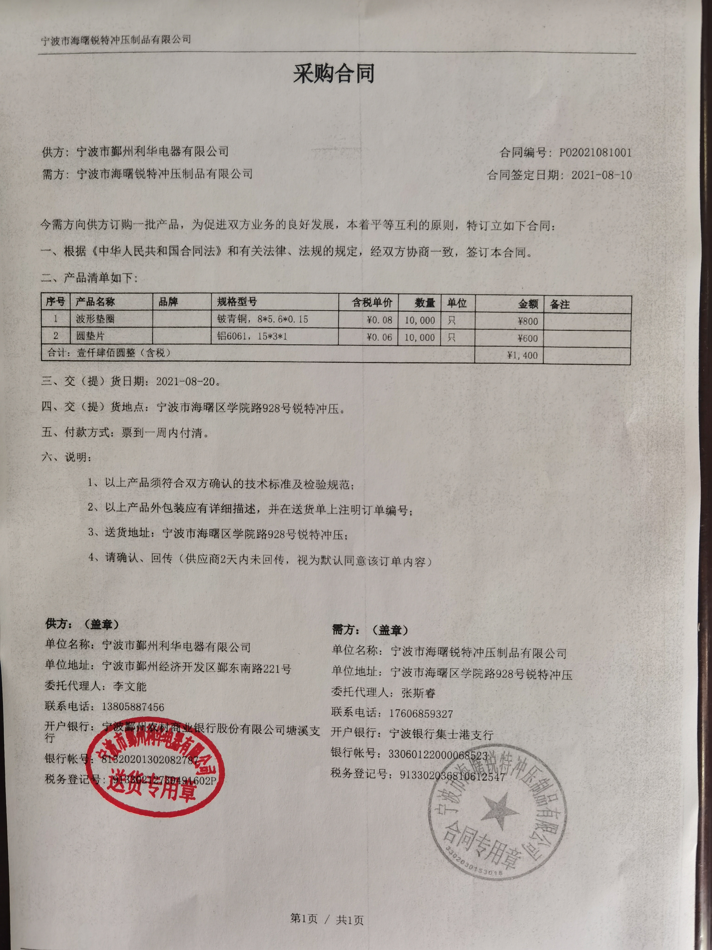
2-采购合同/紧固件/采购合同.jpg
