nbruite/vacuum/2-采购合同/胶水/科宝胶水3.jpg

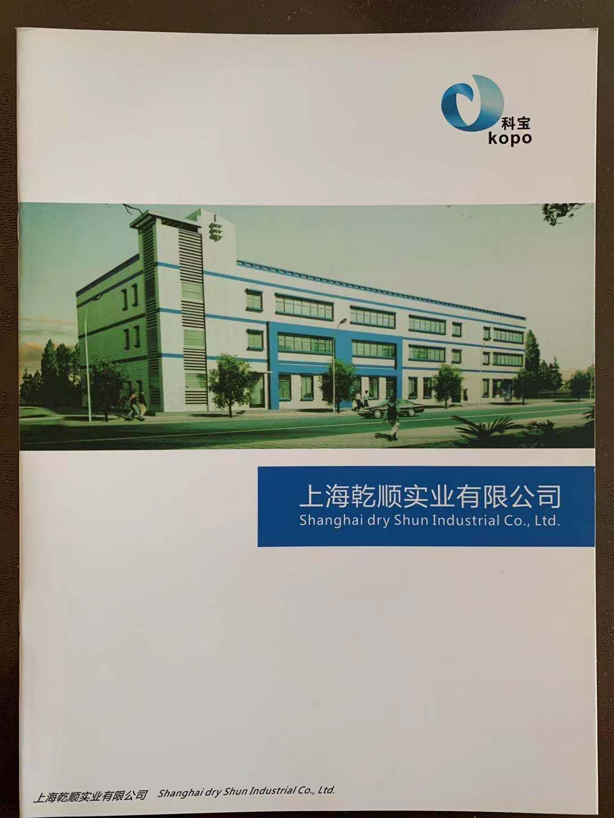
2-采购合同/胶水/科宝胶水3.jpg
