nbruite/vacuum/2-采购合同/轴/PO2021080501-科盛轴业-确认.jpg

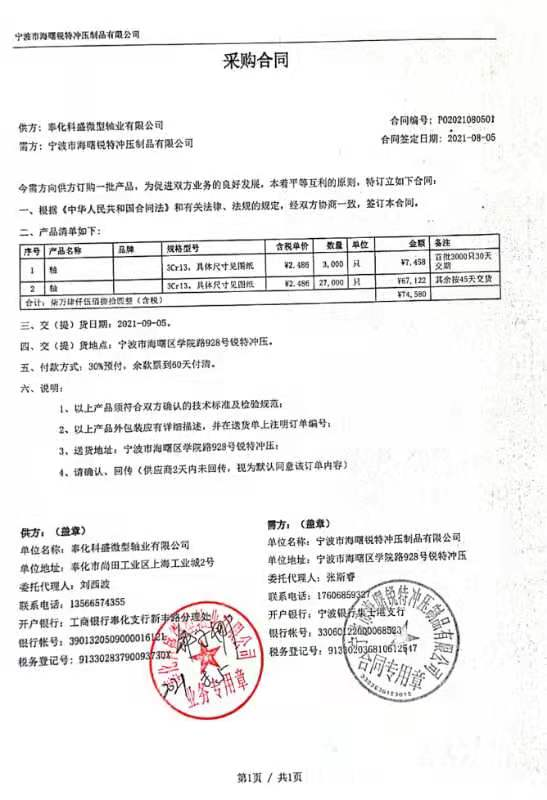
2-采购合同/轴/PO2021080501-科盛轴业-确认.jpg
