nbruite/vacuum/2-采购合同/轴/营业执照.jpg

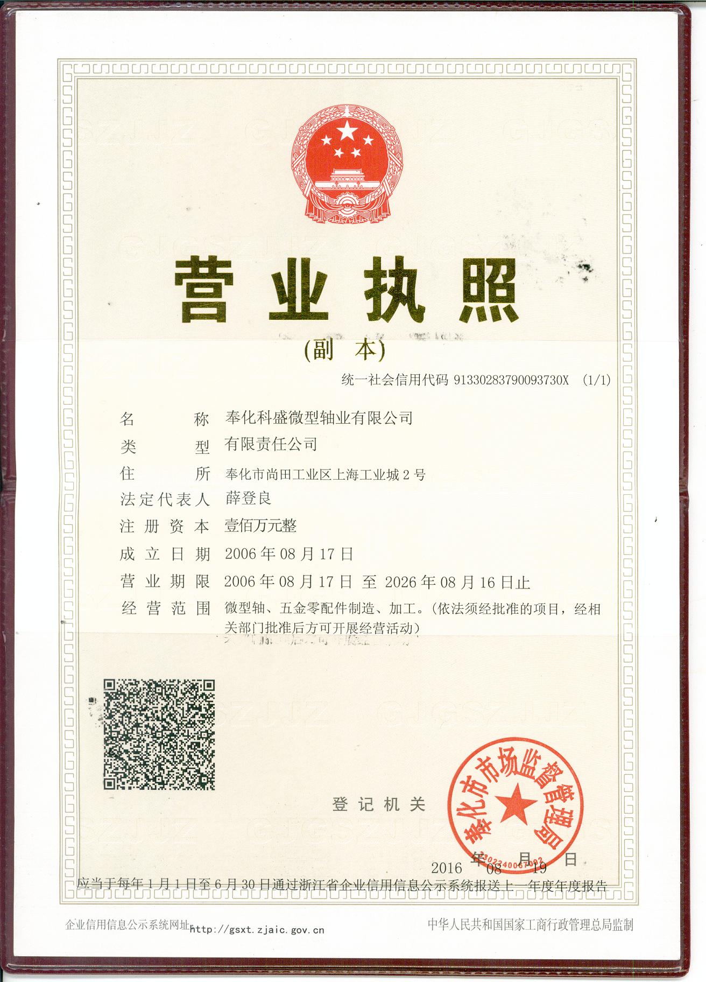
2-采购合同/轴/营业执照.jpg
