nbruite/vacuum/2-采购合同/铜端子/乐清市恒邦电气有限公司/名片.jpg

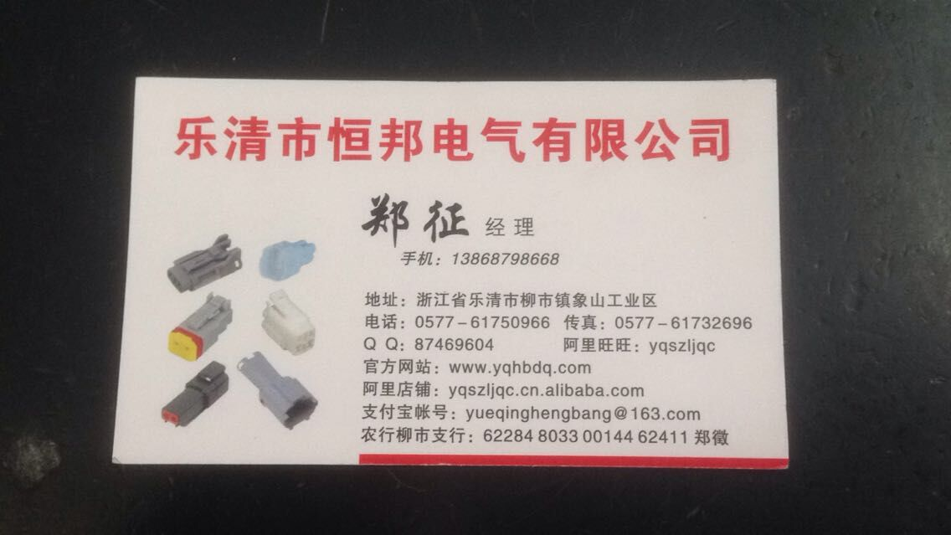
2-采购合同/铜端子/乐清市恒邦电气有限公司/名片.jpg
