nbruite/vacuum/2-采购合同/铜端子/温州相昱科技/铜端子图纸.png

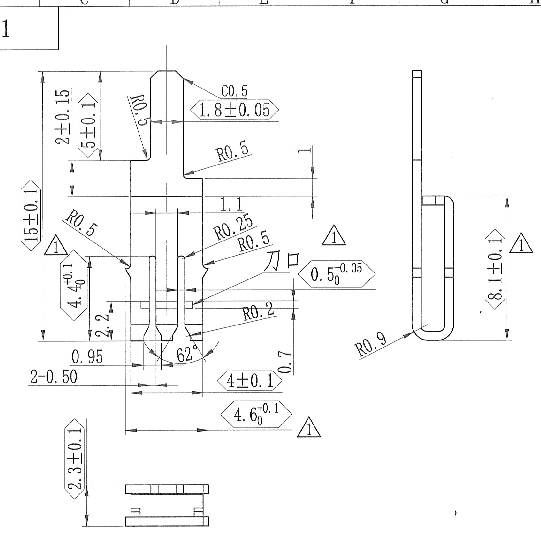
2-采购合同/铜端子/温州相昱科技/铜端子图纸.png
