nbruite/vacuum/3-加工图纸/1-冉工提供（C型）/图片/下骨架4.jpg

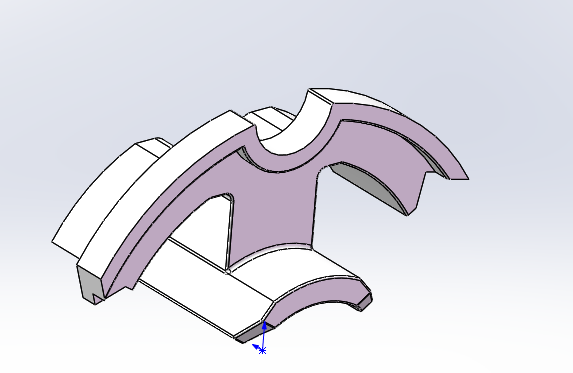
3-加工图纸/1-冉工提供（C型）/图片/下骨架4.jpg
