nbruite/vacuum/3-加工图纸/1-冉工提供（C型）/图片/后端盖3.jpg

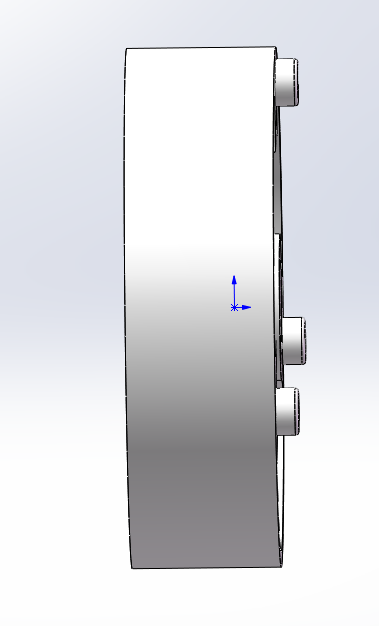
3-加工图纸/1-冉工提供（C型）/图片/后端盖3.jpg
