nbruite/vacuum/3-加工图纸/1-冉工提供（C型）/图片/风罩2.jpg

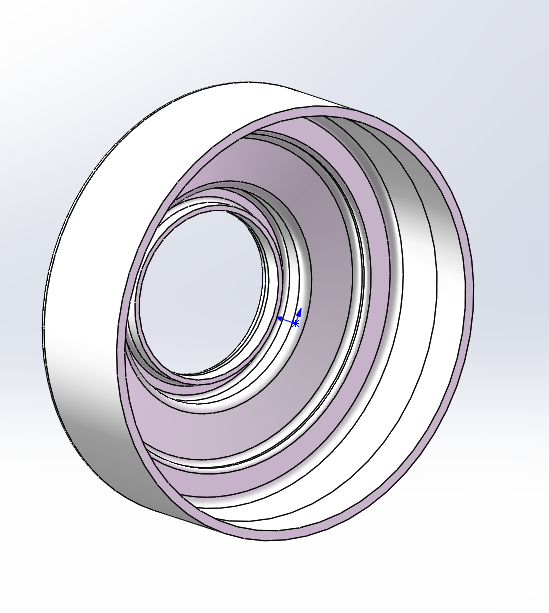
3-加工图纸/1-冉工提供（C型）/图片/风罩2.jpg
