nbruite/vacuum/3-加工图纸/2-晨光（A型）/磁钢退磁曲线.jpg

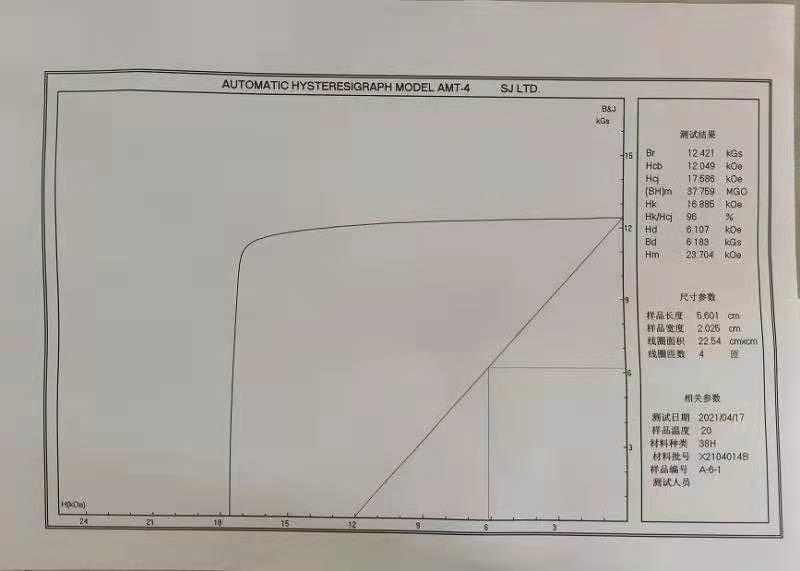
3-加工图纸/2-晨光（A型）/磁钢退磁曲线.jpg
