nbruite/vacuum/4-电机测试/电机工作安排.png

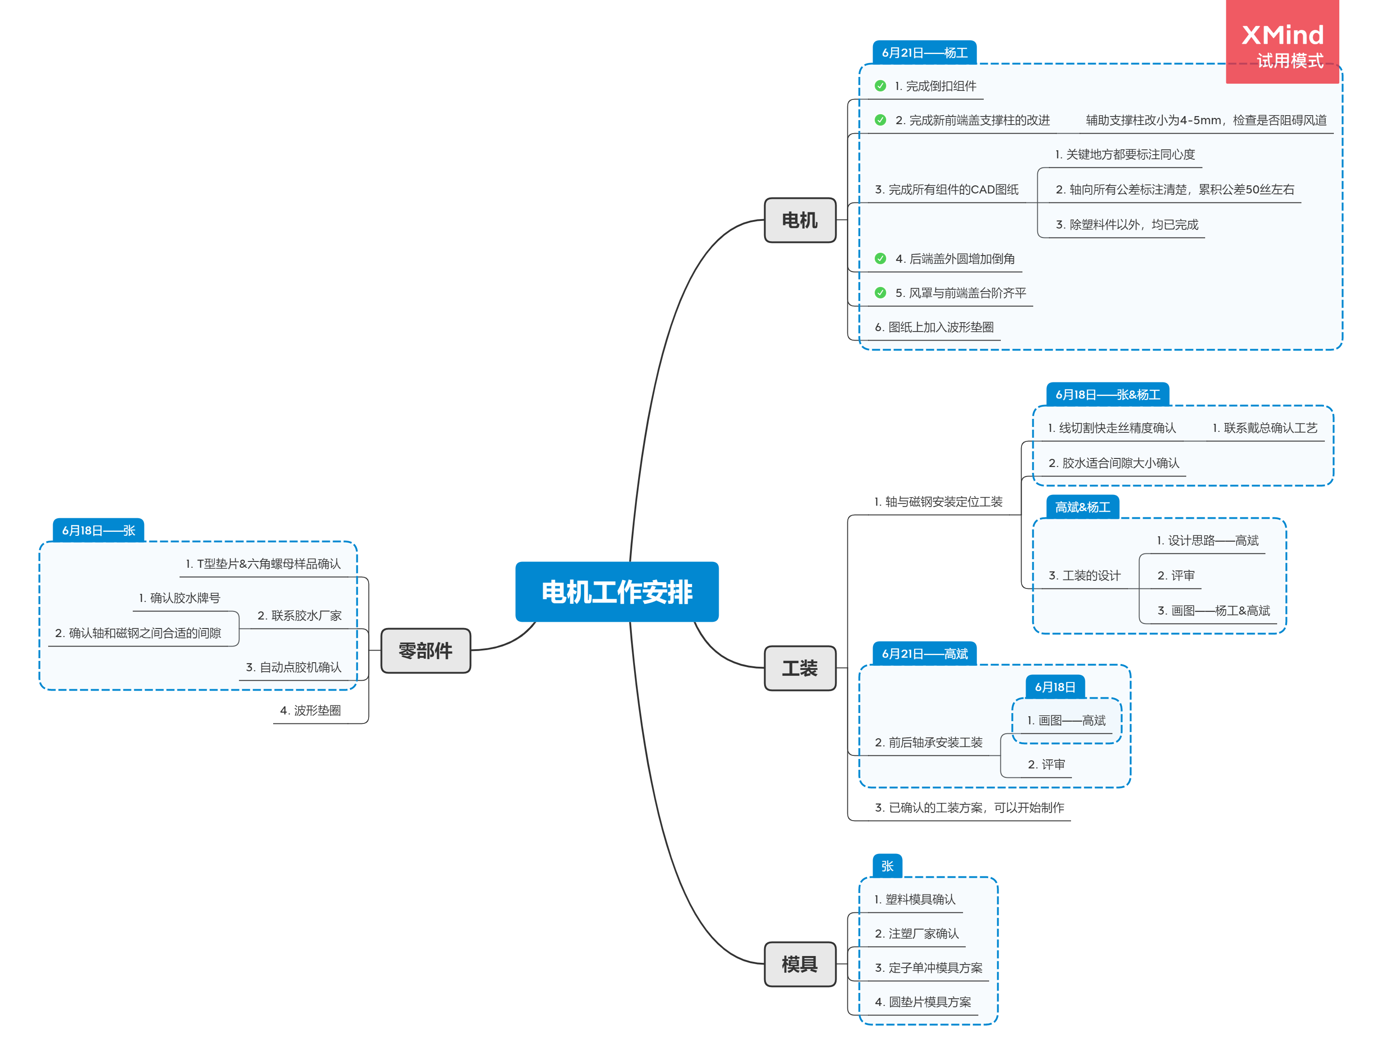
4-电机测试/电机工作安排.png
