nbruite/vacuum/5-其他/5-3C认证/3C认证-冉工/龚佳.jpg

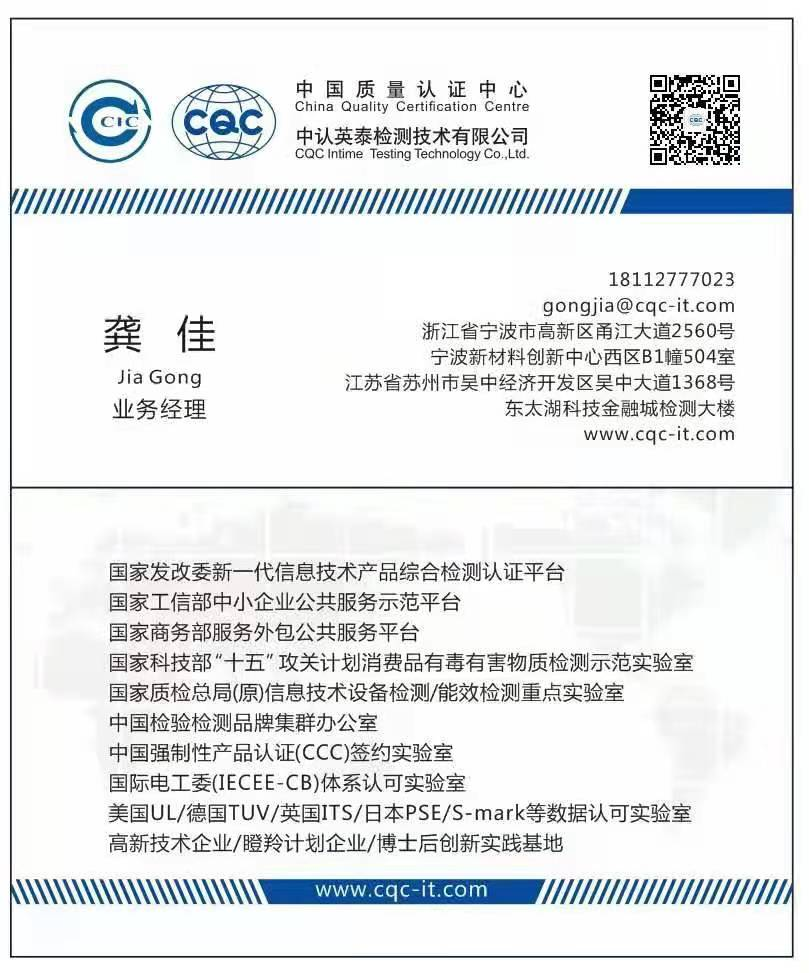
5-其他/5-3C认证/3C认证-冉工/龚佳.jpg
