nbruite/vacuum/5-其他/5-3C认证/3C认证-冉工/认监委/附件1. 不再实施强制性产品认证管理的产品清单.docx

附件1

不再实施强制性产品认证管理的产品清单

序号 | 产品名称
| 产品大类 | 产品种类和代码
1 | 电线电缆 | 交流额定电压3kV及以下铁路机车车辆用电线电缆（0103）
2 | 电动工具 | 电动螺丝刀和冲击扳手（0502）
3 | | 砂光机（0504）
4 | | 圆锯（0505）
5 | 电焊机 | 小型交流弧焊机（0601）
6 | | 交流弧焊机（0602）
7 | | 埋弧焊机（0606）
8 | | 等离子弧焊机（0608）
9 | | 弧焊变压器防触电装置（0609）
10 | | 焊接电缆耦合装置（0610）
11 | | 电阻焊机（0611）
12 | 音视频设备 | 各种广播波段的调谐接收机、收音机（0804）
13 | | 监视器（0809）
14 | 机动车辆及 安全附件 | 汽车内饰件（1111）
15 | | 汽车门锁及门保持件（1112）
16 | 安全玻璃 | 铁道车辆安全玻璃（1303）
17 | 电信终端设备 | 固定电话终端及电话机附加装置（1603）
18 | | 集团电话（1605）
