nbruite/vacuum/1-零件清单/A型电机BOM（批量阶段）.xlsx

Sheet: 锐特
A型电机批量生产BOM表（锐特）
序号 | 名称 | 材料/型号 | 数量 | 单位 | 单价 | 合计 | 模具费用/一次性投入 | 备注
1 | 风罩 | PPS+40%GF | 1 | PCS | 1.15 | 1.15 |  | 10g
2 | 叶轮 |  | 1 | PCS | 2.4 | 2.4 | 0 | 上海合丰电器直接采购
3 | 六角螺母 | 铝6061 | 1 | PCS | 0.08 | 0.08 | 0 | M3，厚度4
4 | 圆垫片 | 铝6061 | 1 | PCS | 0.06 | 0.06 | 0
5 | T型垫片 | 铝6061 | 1 | PCS | 0.26 | 0.26 | 0
6 | 波形垫片 | 铍青铜 | 1 | PCS | 0.08 | 0.08 | 0
7 | 前端盖 | PPS+40%GF | 1 | PCS | 1.85 | 1.85 |  | 17g
8 | 轴承 | NMB:R830ZZ | 2 | PCS | 3 | 6 | 0 | 备选：南通山口、镇海银球
9 | 定子铁芯 | B20AT1500 | 1 | PCS |  |  | 70000
10 | 上骨架 | PA66+30%GF | 1 | PCS | 0.07 | 0.07 | 5000 | 发发
11 | 下骨架 | PA66+30%GF | 1 | PCS | 0.13 | 0.13 | 5500 | 发发
12 | 漆包线 | 铜 | 15 | g |  |  | 0 | φ0.65
13 | 轴 | 3Cr13 | 1 | PCS | 2.2 | 2.2 | 0 | 奉化科盛轴业，2元/只（不含税）
14 | 磁钢 | 钕铁硼N38SH | 1 | PCS | 2 | 2 | 0 | 戴总报价1.7元
15 | 后端盖 | PPS+40%GF | 1 | PCS | 0.7 | 0.7 |  | 5.5g
16 | 接线端子 | 镀锡磷青铜 | 3 | PCS | 0.165 | 0.495 | 0 | 温州相昱科技（含税）
17 | 自攻螺丝 | 镀锌 | 3 | PCS |  |  | 0 | M3*20
18 | 密封垫圈 |  | 1 | PCS |  |  | 0
19 | 泰克示波器 | TBS1202C | 1 | SET | 6799 |  | 6799
20 | 迈斯泰克直流电源 | DP6020 | 1 | SET | 1398 |  | 1398
21 | 威博真空度测量仪 | WB-2C | 1 | SET | 1860 |  | 1860
22 | 温度测量仪 | 8路/热电偶 | 1 | SET | 1750 |  | 1750
23 | 整机动平衡机 |  | 1 | SET | 185000 |  | 185000 | 苏州赛德克
24 | 4工位自动绕线机 |  | 1 | SET | 170000 |  | 170000 | 深圳专诚达
25 | 自动甩胶机 |  | 1 | SET | 15000 |  | 15000 | 嵊州三科
26 | 自动点胶机 |  | 1 | SET | 25000 |  | 25000
 |  |  |  |  | 合计： | 17.475 | 487307
备注： | 黄色表示核心零部件，绿色表示塑料件，蓝色表示仪器设备

Sheet: 冉工
A型电机批量生产BOM表（冉工参考）
序号 | 名称 | 材料/型号 | 数量 | 单位 | 单价 | 合计 | 模具费用/一次性投入 | 备注
1 | 风罩 | PPA+30%GF | 1 | PCS | 2 | 2 | 8000
2 | 叶轮 |  | 1 | PCS | 2 | 2 | 10000
3 | 六角螺母 | 铝 | 1 | PCS | 0.1 | 0.1
4 | 圆垫片 | 铝 | 1 | PCS | 0.08 | 0.08
5 | T型垫片 | 铝 | 1 | PCS | 0.5 | 0.5
6 | 前端盖 | PPA+30%GF | 1 | PCS | 4.5 | 4.5 | 30000
7 | 轴承 | NMB:R830ZZ | 2 | PCS | 4 | 8
8 | 定子铁芯 | B20AT1500 | 1 | PCS | 2.5 | 2.5 | 70000
9 | 上骨架 | PA66+30%GF | 1 | PCS | 0.9 | 0.9 | 6000
10 | 下骨架 | PA66+30%GF | 1 | PCS | 0.9 | 0.9
11 | 漆包线 | 铜 | 15 | g | 0.1 | 1.5
12 | 轴 | 3Cr13 | 1 | PCS | 2 | 2
13 | 磁钢 | 钕铁硼N38SH | 1 | PCS | 2.5 | 2.5
14 | 后端盖 | PPS+30%GF | 1 | PCS | 2.5 | 2.5 | 8000
15 | 后盖 |  | 1 | PCS | 1.5 | 1.5 | 3000
16 | 接线端子 | 黄铜 | 3 | PCS | 0.5 | 1.5 | 2000
17 | 驱动器 |  | 1 | PCS
18 | 包装 |  | 1 | PCS | 0.5 | 0.5
19 | 泰克示波器 | TBS1202C | 1 | SET | 6799 |  | 6799
20 | 迈斯泰克直流电源 | DP6020 | 1 | SET | 1398 |  | 1398
21 | 威博真空度测量仪 | WB-2C | 1 | SET | 1860 |  | 1860
22 | 温度测量仪 | 8路/热电偶 | 1 | SET | 1750 |  | 1750
23 | 叶轮动平衡机 |  | 1 | SET | 60000 |  | 60000
24 | 整机动平衡机 |  | 1 | SET | 60000 |  | 60000
25 | 4工位自动绕线机 |  | 1 | SET | 120000 |  | 120000
26 | 自动点胶机 |  | 1 | SET
 |  |  |  |  | 合计： | 31.98 | 388807
备注： | 黄色表示核心零部件，绿色表示塑料件，蓝色表示仪器设备
