nbruite/vacuum/1-零件清单/来电科技前期投入费用汇总.xlsx

Sheet: 汇总
来电智能科技电机前期费用投入
固定资产 | 模具 | 零部件采购 | 打样 | 其他 | 总计
346807 | 111000 |  | 7826.4 | 20000 | 485633.4

Sheet: 固定资产
固定资产投入
费用总计： |  |  | 346807
序号 | 名称 | 时间 | 单价（含税） | 数量 | 总价 | 采购单位 | 用途 | 备注
1 | 绕线机 | 2021-07-21 | 160000 | 1 | 160000 | 深圳专诚达 | 定转子绕线 | 先支付64000元定金；发货前再支付80000元；收到货后支付16000元
2 | 动平衡机 | 2021-07-28 | 175000 | 1 | 175000 | 苏州赛德克 | 整机动平衡
3 | 示波器 | 2021-05-01 | 6799 | 1 | 6799 | 泰克 | 测转速
4 | 直流电源 | 2021-05-02 | 1398 | 1 | 1398 | 迈斯泰克 | 电源
5 | 真空度测量仪 | 2021-05-03 | 1860 | 1 | 1860 | 威博 | 真空度测量
6 | 热电偶温度测量仪 | 2021-05-04 | 1750 | 1 | 1750 |  | 电机测温

Sheet: 模具
模具投入
费用总计： |  |  | 111000
序号 | 名称 | 时间 | 规格 | 价格 | 厂家 | 备注
1 | 前端盖模具 | 2021-07-12 | 1出2 | 17000 | 庆钢模塑 | 2021年7月21日支付模具款25500元，剩下50%产品合格后支付
2 | 风罩模具 |  | 1出4 | 16000
3 | 后端盖模具 |  | 1出4 | 18000
4 | 定子高速冲模具 | 2021-07-28 | 1出2 | 60000 | 宁波华誉模具科技有限公司
5 | 上下骨架模具

Sheet: 零部件采购
零部件采购

Sheet: 打样
样品研发费用
费用总计： |  |  | 7826.4
序号 | 名称 | 规格 | 单价（含税） | 数量 | 总价 | 采购商 | 备注
1 | 3D打印 | ABS |  |  | 4170 | 创辉3D打印
2 | 轴 | 见图纸 | 56.5 | 20 | 1130 | 奉化科盛微型轴业有限公司
3 | 轴承 | NMB830ZZ | 3.2 | 42 | 134.4 | 上海新日升传动科技股份有限公司
4 | 塑料成分检测 | 常规 | 636 | 2 | 1272 | 宁波启信检测技术服务有限公司
5 | 塑料件扫描建模 | 常规 | 300 | 2 | 600 | 宁波汉克三维
6 | 无线吹尘枪 | 普通款 | 251 | 1 | 251 | awkici | 拆解研发用
7 | 无线吹尘枪 | 普通款 | 269 | 1 | 269 | OPOLAR

Sheet: 其他
其他费用支出
费用总计： |  | 20000
序号 | 名称 | 时间 | 总价 | 用途描述 | 备注
1 | 冉工研发支出 | 2021-05-01 | 20000 | 冉工研发费用
