nbruite/vacuum/6-新电机/崔总小风机BOM.xlsx

小风机 B O M 表
机种 |  | 发行日期 | 2021-07-21 | 版次 | V01
序号 | 名称 | 材料 | 规格 | 数量 | 单位 | 预估单价 | 合计 | 模具费用 | 备注
1 | 定子铁芯 | B35A270 | 见图纸 | 1 | PCS | ￥1.50 | ￥1.50 | 80000
2 | 漆包线 | 铜 | QZY-2/180 xxx |  | g | ￥1.80 | ￥1.80
3 | 定子铜支架 | 黄铜 | 见图纸 | 1 | PCS | ￥3.00 | ￥3.00
4 | 定子上下骨架 | PA66+30GF |  | 1 | PCS | ￥0.30 | ￥0.30 | 15000
5 | 安装板 | 铁镀锌 |  | 1 | PCS | ￥0.65 | ￥0.65 | 10000
6 | 磁环 | 粘接钕铁硼 | 见图纸 | 1 | PCS | ￥6.50 | ￥6.50 | 3000
7 | 轴 | GCr15 | 见图纸 | 1 | PCS | ￥2.00 | ￥2.00
8 | 铁骨架 | SPCC | 见图纸 | 1 | PCS | ￥1.30 | ￥1.30 | 15000
9 | 轴承 | 轴承钢 |  | 2 | PCS | ￥3.00 | ￥6.00
10 | 上风罩 | PC | 见图纸 | 1 | PCS | ￥1.10 | ￥1.10 | 12000
11 | 下风罩 | PC | 见图纸 | 1 | PCS | ￥1.30 | ￥1.30 | 18000
12 | 叶轮 | PPS+30GF | 见图纸 | 1 | PCS | ￥2.00 | ￥2.00 | 20000
13 | 铜T型垫圈 |  |  | 1 | PCS | ￥0.50 | ￥0.50
14 | 自攻螺钉 | SUS304 |  | 3 | PCS | ￥0.05 | ￥0.15
15 | 乐泰326胶水 |  |  |  |  | ￥0.20 | ￥0.20
16 | 乐泰螺纹紧固胶 |  |  |  |  | ￥0.10 | ￥0.10
 |  |  |  |  |  | 合计 | 28.4 | ¥173000.00
