nbruite/vacuum/6-新电机/戴总小电机BOM.xlsx

小电机BOM
序号 | 名称 | 材料 | 数量 | 单位 | 预估单价 | 合计 | 备注
1 | 壳体 |  | 1
 | 轴 |  | 1
 | 铁芯（包含涂覆） |  | 1
 | 漆包线 |  | 1
 | 轴承 |  | 2
 | 轴承套 |  | 1
 | 波形垫圈 |  | 1
 | 卡扣 |  | 1
