nbruite/vacuum/6-新电机/小风机BOM.xlsx

小风机 B O M 表
机种 |  |  |  | 发行日期 | 2021-07-20 | 版次 | V01
序号 | 物料代码 | 件号 | 名称 | 材料 | 规格 | 数量 | 单位 | 预估单价 | 合计 | 模具费用 | 备注 | 样机加工方式 | 供应商 | 联系方式
1 |  |  | 定子铁芯（涂覆绝缘） | 20WTG1500 | 见图纸 | 1 | PCS | ￥3.50 | ￥3.50
2 |  |  | 漆包线 | 铜 | QZY-2/180 xxx |  | g | ￥2.00 | ￥2.00
3 |  |  | 定子支架 | 黄铜 | 见图纸 | 1 | PCS | ￥3.50 | ￥3.50
4 |  |  | PCB连接板 | Fr4 |  | 1 | PCS | ￥1.50 | ￥1.50
5 |  |  | 霍尔元件（贴片霍尔） |  |  | 3 | PCS | ￥0.80 | ￥2.40
6 |  |  | 磁环 | 粘接钕铁硼 | 见图纸 | 1 | PCS | ￥4.50 | ￥4.50
7 |  |  | 轴 | GCr15 | 见图纸 | 1 | PCS | ￥3.00 | ￥3.00
8 |  |  | 机壳 | SPCC | 见图纸 | 1 | PCS | ￥2.50 | ￥2.50
9 |  |  | 轴承 | 轴承钢 |  | 2 | PCS | ￥4.00 | ￥8.00
10 |  |  | 上风罩 | PC | 见图纸 | 1 | PCS | ￥4.00 | ￥4.00
11 |  |  | 下风罩 | PC | 见图纸 | 1 | PCS | ￥4.00 | ￥4.00
12 |  |  | 叶轮 |  | 见图纸 | 1 | PCS | ￥5.00 | ￥5.00
13 |  |  | 线束（含接插件） |  |  | 1 | PCS | ￥2.00 | ￥2.00
14 |  |  | 自攻螺钉 | SUS304 |  | 3 | PCS | ￥0.05 | ￥0.15 |  | 上下风罩连接
15 |  |  | 乐泰326胶水 |  |  |  |  | ￥0.20 | ￥0.20 |  | 粘磁钢 |  |  |  | 或者市场件也可
16 |  |  | 乐泰螺纹紧固胶 |  |  |  |  | ￥0.10 | ￥0.10
 |  |  |  |  |  |  |  | 合计 | 46.35
