nbruite/vacuum/1-零件清单/吸尘器电机零部件库存明细.xlsx

电机零部件库存明细
序号 | 名称 | 数量 | 单位 | 备注
1 | 叶轮8-电泳 | 5 | 个
2 | 叶轮8-锁螺母 | 5 | 个
3 | 叶轮7-电泳 | 5 | 个
4 | 定子C | 5 | 个
5 | 定子A | 5 | 个
6 | 风罩C-铝合金 | 1 | 个
7 | 后端盖C-铝合金 | 1 | 个
8 | 前端盖A-尼龙玻纤 | 1 | 个
9 | 前端盖B-尼龙玻纤 | 1 | 个
10 | 上骨架C-尼龙玻纤 | 4 | 套 | 每套3只，已废弃
11 | 下骨架C-尼龙玻纤 | 4 | 套 | 每套3只，已废弃
12 | 上骨架A-ABS | 9 | 套 | 每套1只
13 | 下骨架A-ABS | 9 | 套 | 每套1只
14 | 前端盖A-ABS | 1 | 个
15 | 前端盖C-ABS | 1 | 个
16 | 上骨架C-ABS | 3 | 套 | 每套3只
17 | 下骨架C-ABS | 3 | 套 | 每套3只
18 | 圆垫片-铝 | 10 | 个
19 | T型垫片-铝 | 10 | 个
20 | 康达5050胶水 | 1 | 瓶
21 | 康达5071胶水 | 1 | 瓶
22 | 风罩A-ABS | 3 | 个
23 | 风罩B-ABS | 3 | 个
24 | 风罩C-ABS | 3 | 个
25 | 前端盖A-ABS | 3 | 个
26 | 前端盖C-ABS | 3 | 个
