nbruite/vacuum/2-采购合同/塑料件/塑料模具报价单/塑料模具报价清单-余姚.xlsx

塑料模具（不含税）报价清单
序号 | 产品名称 | 产品材料 | 进料方式 | 模具穴数 | 模具材料 | 模具价格 | 备注
1 | 前端盖 | PPS+40%GF | 边进料 | 1出2 | S136 | 1.8W
2 | 风罩 | PPS+40%GF | 边进料 | 1出2 | S136 | 1.8W
3 | 后端盖 | PPS+40%GF | 边进料 | 1出4 | S136 | 1.6W
