nbruite/vacuum/2-采购合同/塑料件/塑料模具报价单/塑料模具报价清单-发发.xlsx

塑料标准模架（模具不含税）报价清单
序号 | 产品名称 | 产品材料 | 进料形式 | 模具穴数 | 模具材料 | 模具价格 | 备注
1 | 前端盖 | PPS+40%GF | 待定 | 一模三穴 | H13 | 10000
2 | 风罩 | PPS+40%GF | 待定 | 一模六穴 | H13 | 6000
3 | 后端盖 | PPS+40%GF | 待定 | 一模六穴 | H13 | 5000
4 | 上骨架 | PA66+30%GF | 待定 | 一模六穴 | H13 | 5000
5 | 下骨架 | PA66+30%GF | 待定 | 一模六穴 | H13 | 5500
