nbruite/vacuum/2-采购合同/塑料件/塑料模报价单+图纸/塑料模具报价清单.xlsx

塑料标准模架（模具不含税）报价清单
序号 | 产品名称 | 产品材料 | 进料形式 | 模具穴数 | 模具材料 | 模具价格 | 备注
1 | 前端盖 | PPS+40%GF
2 | 风罩 | PPS+40%GF
3 | 后端盖 | PPS+40%GF
