nbruite/vacuum/3-加工图纸/2-晨光（A型）/4-方案四/PPS打印/塑料模具报价/塑料模具报价清单.xlsx

塑料标准模架（模具不含税）报价清单
序号 | 产品名称 | 产品材料 | 进料形式 | 模具穴数 | 模具材料 | 模具价格 | 备注
1 | 前端盖 | PPS+40%GF
2 | 风罩 | PPS+40%GF
3 | 后端盖 | PPS+40%GF
4 | 上骨架 | PA66+30%GF
5 | 下骨架 | PA66+30%GF
