nbruite/vacuum/3-加工图纸/2-晨光（A型）/2-方案二/吸尘器-电机+风叶--方案A/装配体-叶轮.SLDASM

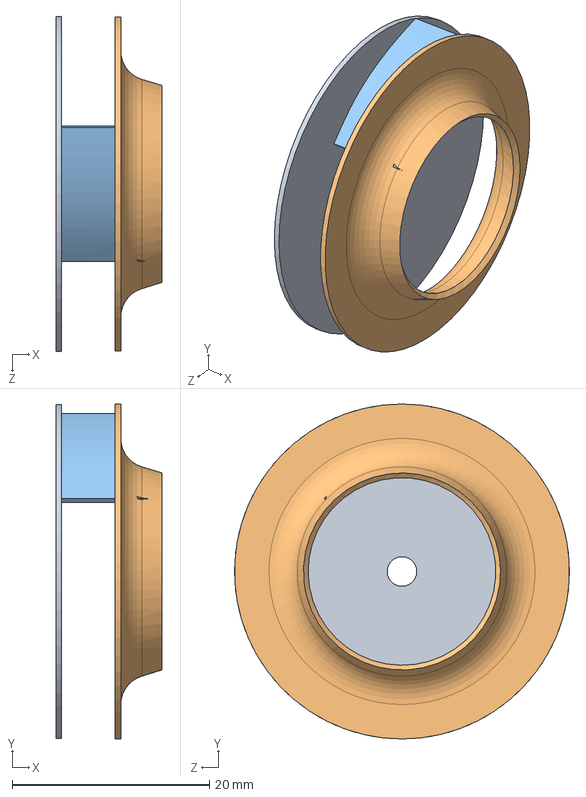
[picture p141: CAD file, 2021-05-14]
3-加工图纸/2-晨光（A型）/2-方案二/吸尘器-电机+风叶--方案A/装配体-叶轮.SLDASM
10.8 x 34.0 x 34.0 mm
风叶轮-1
风叶轮-2
叶片-1
