nbruite/vacuum/3-加工图纸/2-晨光（A型）/4-方案四/倒扣/装配体-前端子自扣.SLDASM

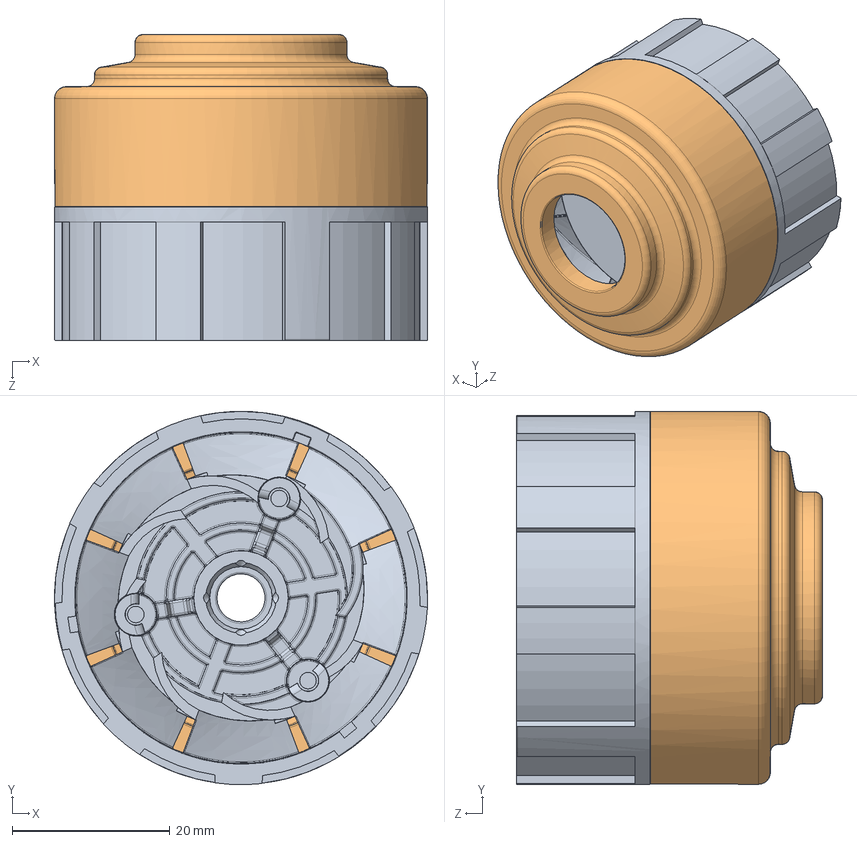
[picture p142: CAD file, 2021-06-11]
3-加工图纸/2-晨光（A型）/4-方案四/倒扣/装配体-前端子自扣.SLDASM
47.3 x 47.3 x 38.8 mm
前端盖A-RT-自扣结构
前端风罩-塑料-斜面-RT--自扣结构
