nbruite/vacuum/3-加工图纸/2-晨光（A型）/1-原厂方案/晨光方案3D图纸/装配体-晨光.SLDASM

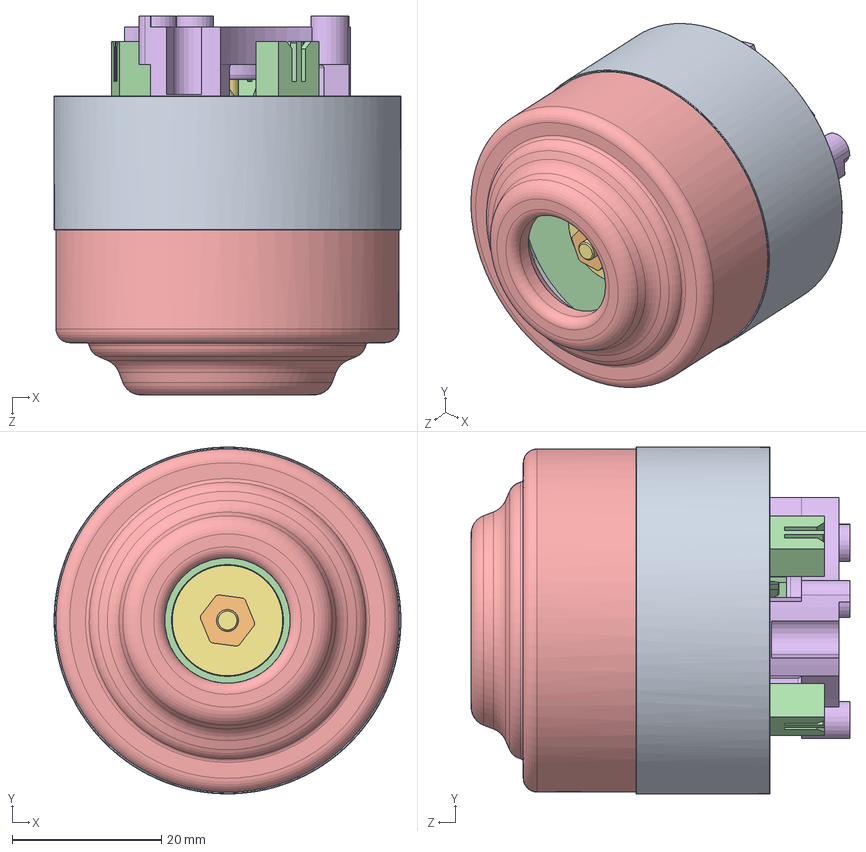
[picture p144: CAD file, 2021-05-14]
3-加工图纸/2-晨光（A型）/1-原厂方案/晨光方案3D图纸/装配体-晨光.SLDASM
46.5 x 46.5 x 50.8 mm
前端盖A-晨光-设计-2021.4.16
电机定子铁芯-201500-A型
电机绕线骨架1-A型
电机绕线骨架2-带接线头-A型
前端风罩-A型-晨光-加厚-塑料
后端盖-A型-晨光-测绘
轴A-晨光
磁环A-晨光
轴承3x8x4-晨光 x 2
M3螺母（厚）-A晨光
T型垫柱A-晨光
风叶轮-1
风叶轮-2
叶片-1
圆垫片3x15x1
