nbruite/vacuum/3-加工图纸/2-晨光（A型）/1-原厂方案/晨光方案3D图纸/装配体1-晨光安装+冉工偏心.SLDASM

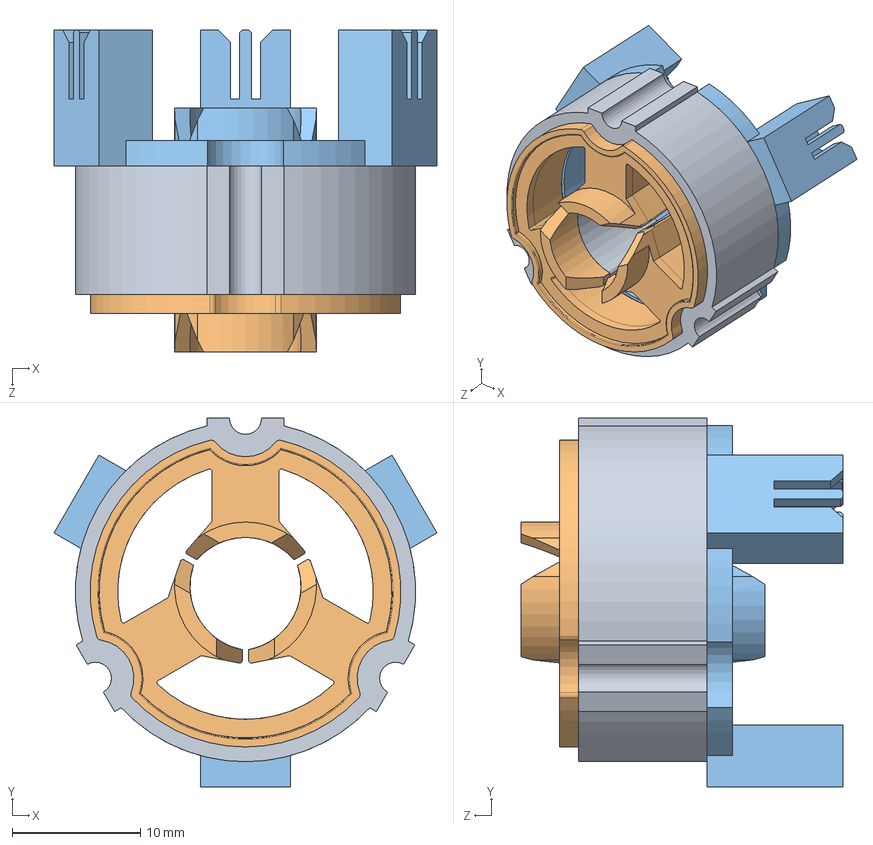
[picture p145: CAD file, 2021-05-14]
3-加工图纸/2-晨光（A型）/1-原厂方案/晨光方案3D图纸/装配体1-晨光安装+冉工偏心.SLDASM
29.8 x 28.7 x 25.1 mm
吸尘器电机-定子-结构-晨光安装+冉工偏心
电机绕线骨架1-A型-角度82
电机绕线骨架2-带接线头-A型-角度82
