nbruite/vacuum/3-加工图纸/2-晨光（A型）/3-方案三/吸尘器-电机+风叶--方案A/装配体-叶轮-方案3.SLDASM

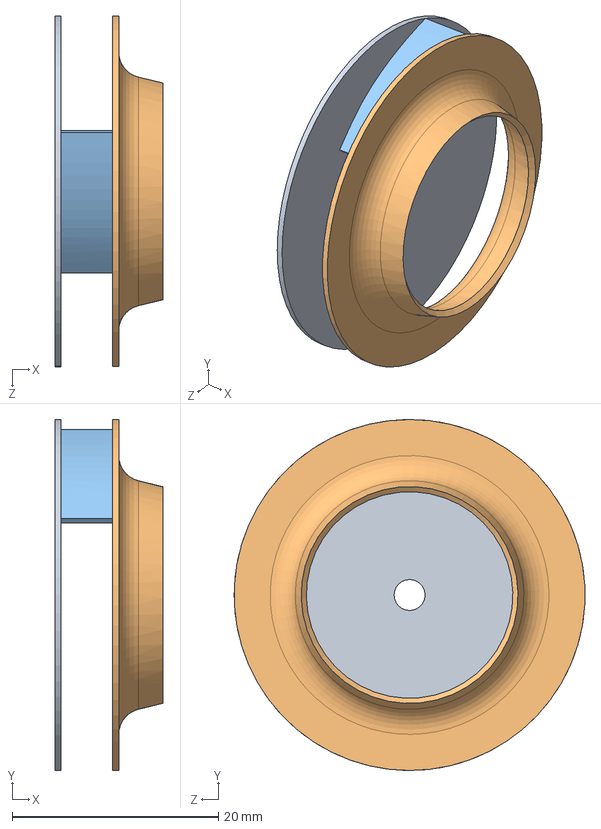
[picture p146: CAD file, 2021-05-14]
3-加工图纸/2-晨光（A型）/3-方案三/吸尘器-电机+风叶--方案A/装配体-叶轮-方案3.SLDASM
10.5 x 34.0 x 34.0 mm
风叶轮-1-方案3
风叶轮-2-方案3
叶片-1-方案3
