nbruite/vacuum/3-加工图纸/2-晨光（A型）/6-方案六/01/定子组件/装配体-电机定子-RT.SLDASM

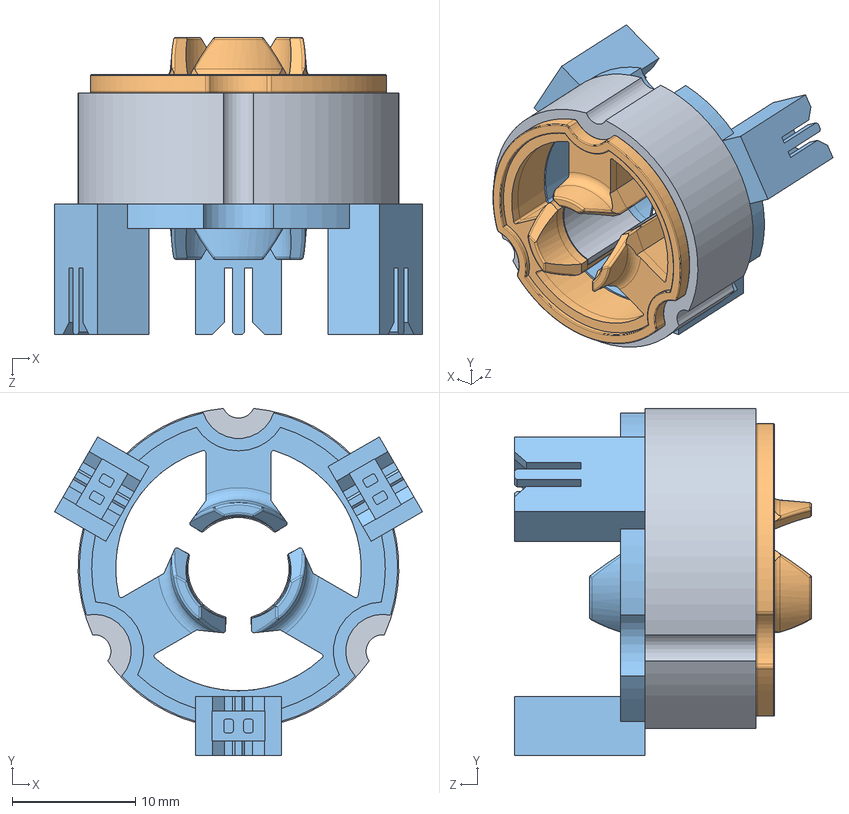
[picture p147: CAD file, 2021-07-22]
3-加工图纸/2-晨光（A型）/6-方案六/01/定子组件/装配体-电机定子-RT.SLDASM
29.8 x 28.1 x 24.1 mm
电机定子铁芯-RT-方案5
电机绕线骨架1-RT-方案5
电机绕线骨架2-带接线头-RT-方案5
