nbruite/vacuum/3-加工图纸/2-晨光（A型）/4-方案四/方案4-2021.5.20/装配体1-电机定子-A型-方案3-方案4.SLDASM

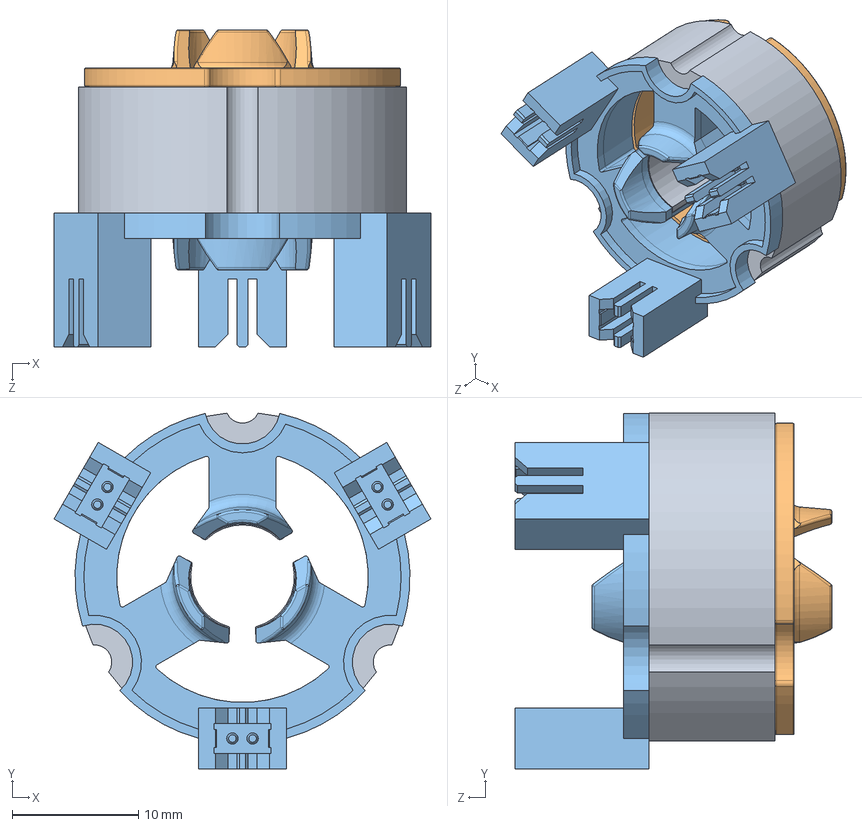
[picture p148: CAD file, 2021-05-22]
3-加工图纸/2-晨光（A型）/4-方案四/方案4-2021.5.20/装配体1-电机定子-A型-方案3-方案4.SLDASM
29.8 x 28.1 x 25.1 mm
电机定子铁芯-201500-A型-方案3-方案4
电机绕线骨架1-A型-方案3-方案4
电机绕线骨架2-带接线头-A型-方案3-方案4
