nbruite/vacuum/3-加工图纸/2-晨光（A型）/4-方案四/方案4-2021.5.20/装配体-晨光-方案2-方案3-方案4.SLDASM

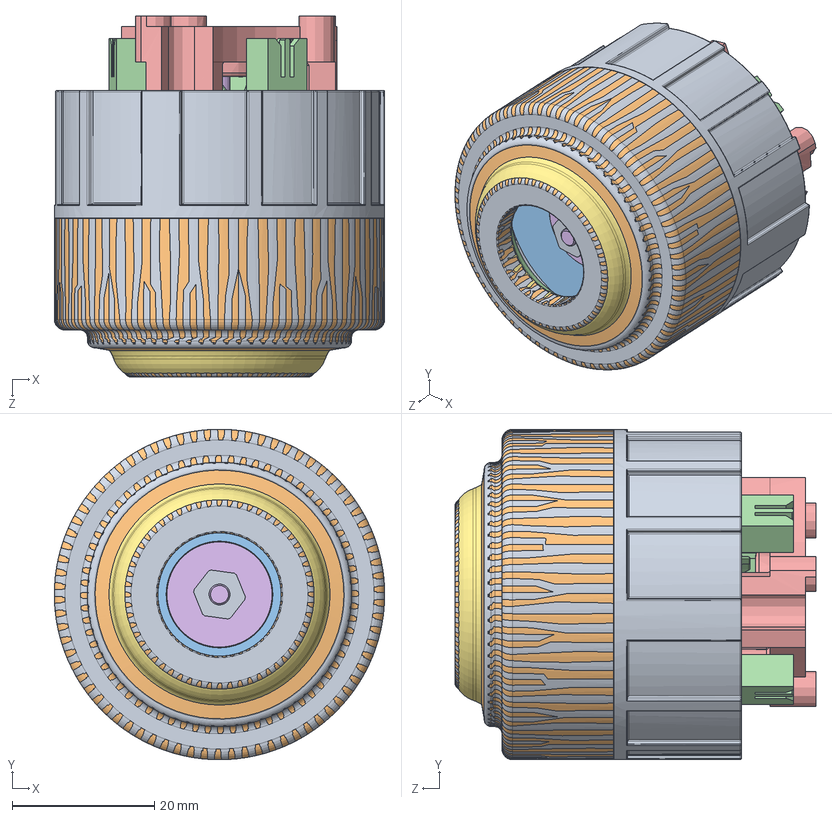
[picture p150: CAD file, 2021-05-22]
3-加工图纸/2-晨光（A型）/4-方案四/方案4-2021.5.20/装配体-晨光-方案2-方案3-方案4.SLDASM
46.5 x 46.5 x 50.8 mm
前端盖A-晨光-设计-2021.4.16+圆周筋条-方案3-方案4
电机定子铁芯-201500-A型-方案3-方案4
电机绕线骨架1-A型-方案3-方案4
电机绕线骨架2-带接线头-A型-方案3-方案4
后端盖-A型-晨光-测绘+圆周定位-方案3-方案4
轴A-晨光-方案3-方案4
磁环A-晨光-方案3-方案4
轴承3x8x4-晨光-方案3-方案4 x 2
M3螺母（厚）-A晨光-方案3-方案4
T型垫柱A-晨光-方案3-方案4
风叶轮-1-方案3-方案4
风叶轮-2-方案3-方案4
叶片-1-方案3-方案4
圆垫片3x15x1-方案3-方案4
密封棉-方案3-方案4
前端风罩-塑料-斜面-方案3-方案4
