nbruite/vacuum/3-加工图纸/2-晨光（A型）/1-原厂方案/晨光方案3D图纸/装配体1.SLDASM

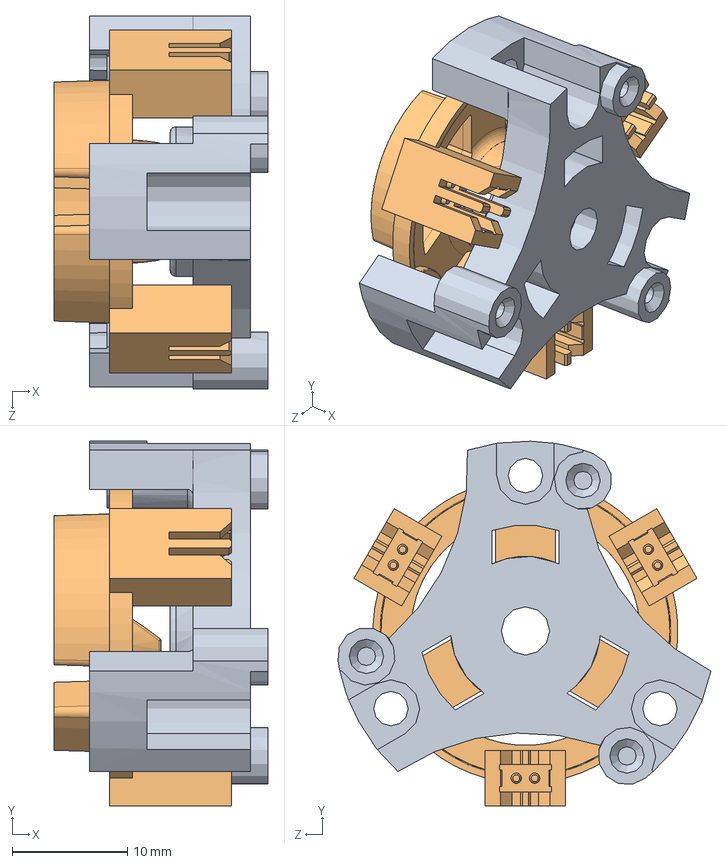
[picture p151: CAD file, 2021-05-14]
3-加工图纸/2-晨光（A型）/1-原厂方案/晨光方案3D图纸/装配体1.SLDASM
18.6 x 31.7 x 32.4 mm
后端盖-A型-晨光-测绘
电机绕线骨架2-带接线头-A型-2021.3.25
