nbruite/vacuum/3-加工图纸/2-晨光（A型）/7-定稿图纸/吸尘器电机2021.7.23/装配体-吸尘器电机-RT-改进-2021.6.15-方案5.SLDASM

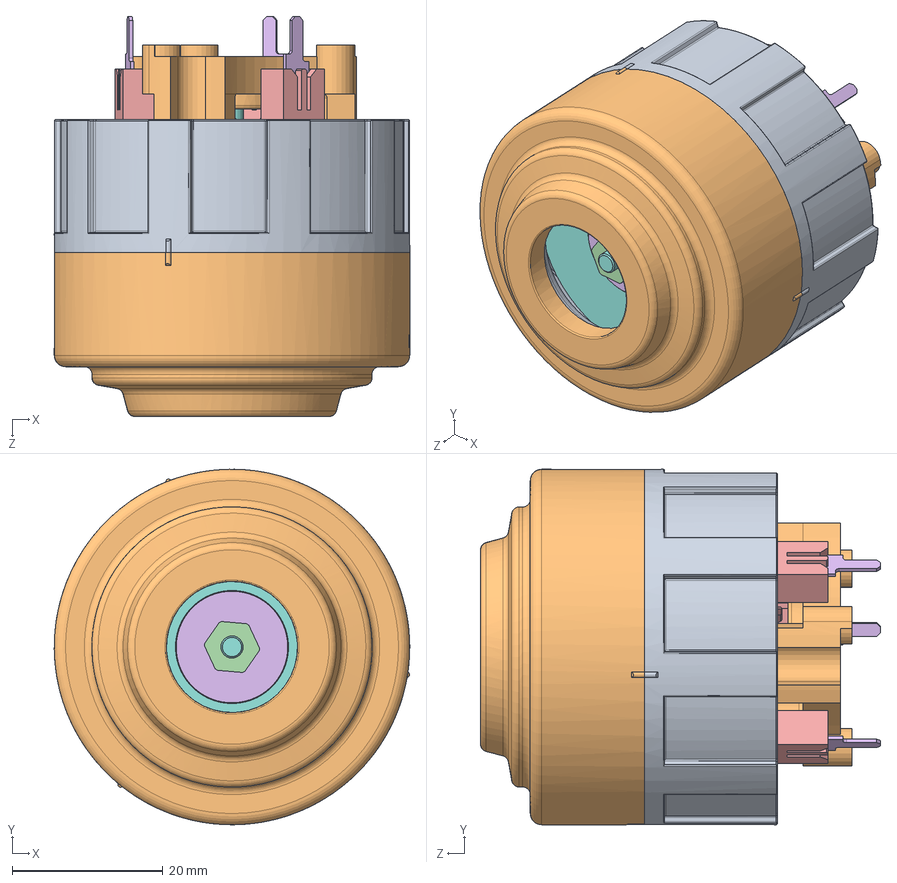
[picture p152: CAD file, 2021-07-23]
3-加工图纸/2-晨光（A型）/7-定稿图纸/吸尘器电机2021.7.23/装配体-吸尘器电机-RT-改进-2021.6.15-方案5.SLDASM
47.2 x 47.2 x 53.1 mm
前端盖A-RT-自扣结构+改进-方案5
前端风罩-塑料-斜面-RT--自扣结构-方案5
电机定子铁芯-RT-方案5
电机绕线骨架1-RT-方案5
电机绕线骨架2-带接线头-RT-方案5
接线铜端子-晨光-2021.6.15-方案5 x 3
轴承3x8x4-晨光-方案3-方案4-方案5 x 2
轴A-晨光-方案3-方案4-方案5
磁环A-晨光-方案3-方案4-方案5
后端盖-A型-晨光-测绘+圆周定位-方案3-方案4-方案5
波形垫圈5.6x8x0.15-方案5
M3螺母（厚）-RT-方案5
密封棉-RT-方案5
圆垫片3x15x1-RT-方案5
T型垫柱A-RT-方案5
风叶轮-1-RT-方案5
风叶轮-2-RT-方案5
叶片-1-RT-方案5
