nbruite/vacuum/3-加工图纸/2-晨光（A型）/3-方案三/装配体1-电机定子-A型-方案3.SLDASM

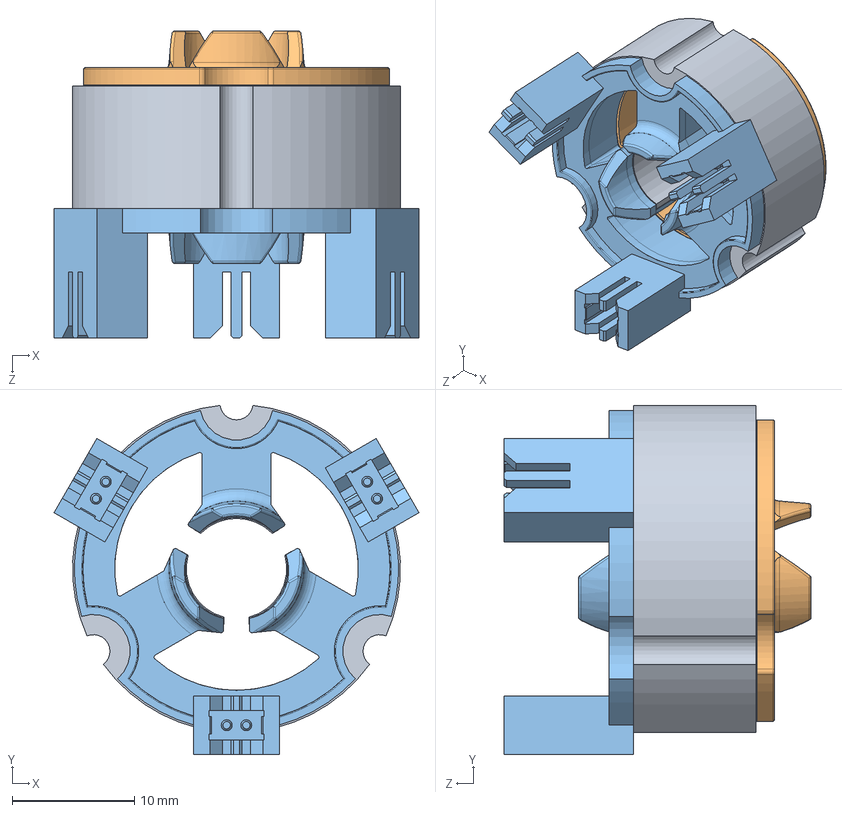
[picture p153: CAD file, 2021-05-14]
3-加工图纸/2-晨光（A型）/3-方案三/装配体1-电机定子-A型-方案3.SLDASM
29.8 x 28.5 x 25.1 mm
电机定子铁芯-201500-A型-方案3
电机绕线骨架1-A型-方案3
电机绕线骨架2-带接线头-A型-方案3
