nbruite/vacuum/2-采购合同/3D打印/2021-3-31打印/前端盖C（修改）.STEP

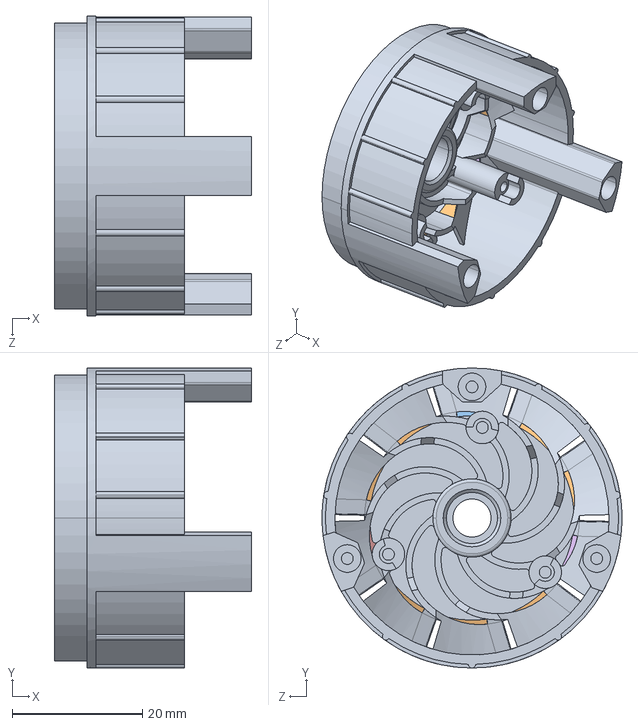
[picture p154: CAD file, 2021-03-31]
2-采购合同/3D打印/2021-3-31打印/前端盖C（修改）.STEP
30.3 x 46.1 x 46.1 mm
