nbruite/vacuum/2-采购合同/3D打印/2021-4-5打印/后端盖-B型-测绘-戈雷姆.STEP

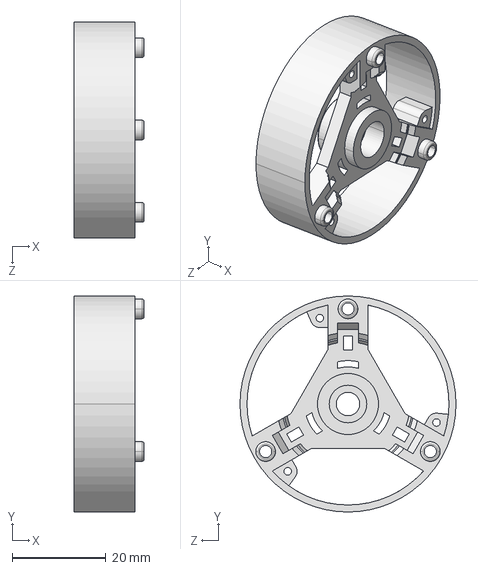
[picture p155: CAD file, 2021-04-19]
2-采购合同/3D打印/2021-4-5打印/后端盖-B型-测绘-戈雷姆.STEP
15.0 x 46.0 x 46.0 mm
