nbruite/vacuum/2-采购合同/塑料件/塑料模报价单+图纸/前端盖.STEP

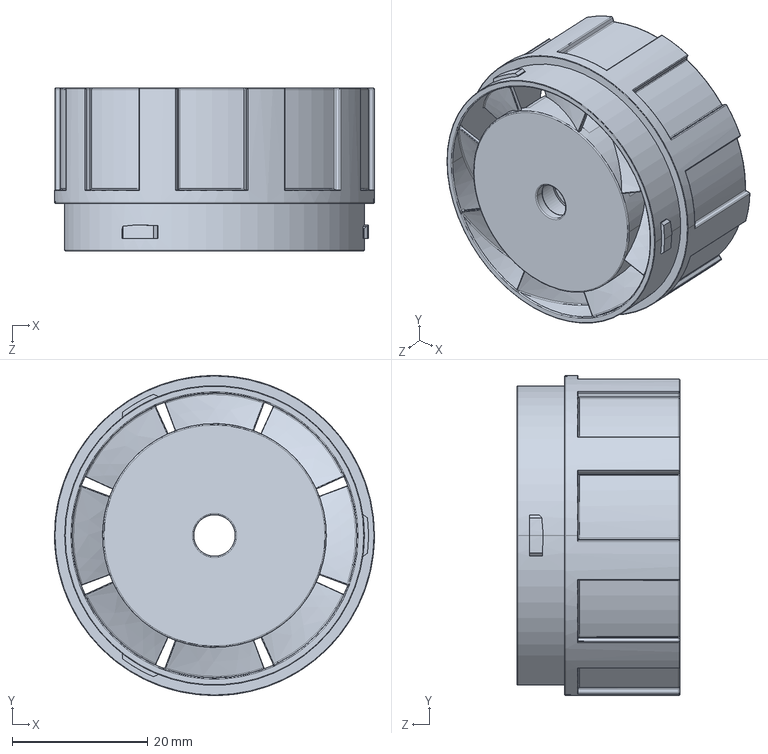
[picture p156: CAD file, 2021-06-21]
2-采购合同/塑料件/塑料模报价单+图纸/前端盖.STEP
47.2 x 47.2 x 24.0 mm
