nbruite/vacuum/3-加工图纸/2-晨光（A型）/1-原厂方案/晨光方案3D图纸/前端风罩-A型-晨光-金属.SLDPRT

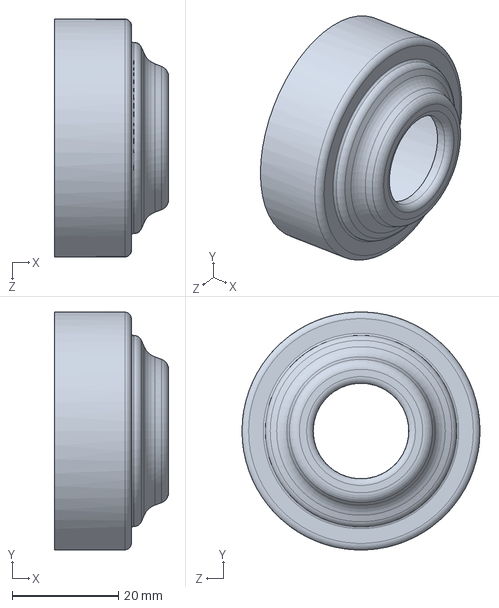
[picture p157: CAD file, 2021-05-14]
3-加工图纸/2-晨光（A型）/1-原厂方案/晨光方案3D图纸/前端风罩-A型-晨光-金属.SLDPRT
21.5 x 44.8 x 44.8 mm
