nbruite/vacuum/3-加工图纸/2-晨光（A型）/2-方案二/前端盖A-设计-2021.4.16+圆周筋条+1mm筋.STEP

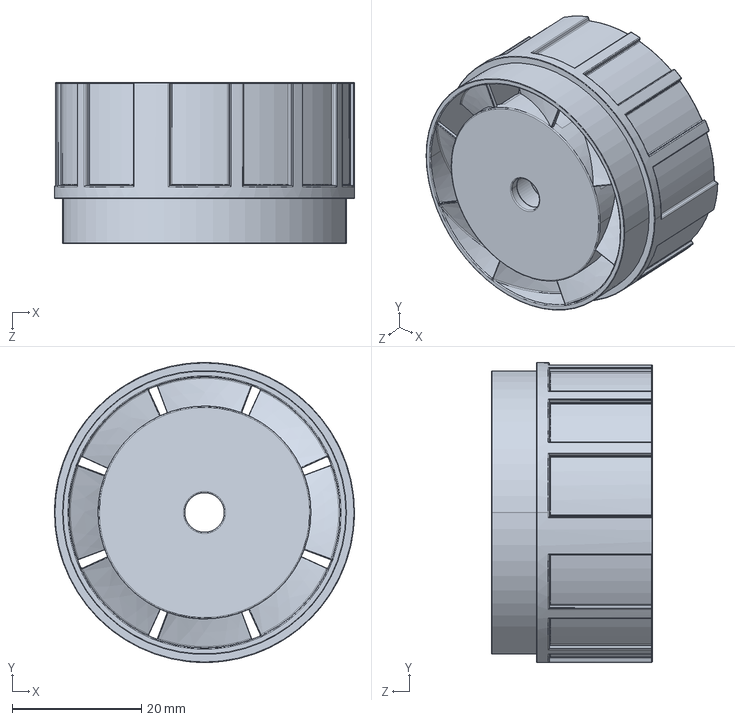
[picture p158: CAD file, 2021-05-14]
3-加工图纸/2-晨光（A型）/2-方案二/前端盖A-设计-2021.4.16+圆周筋条+1mm筋.STEP
46.5 x 46.5 x 25.0 mm
