nbruite/vacuum/3-加工图纸/2-晨光（A型）/3-方案三/M3螺母（厚）-A晨光-方案3.SLDPRT

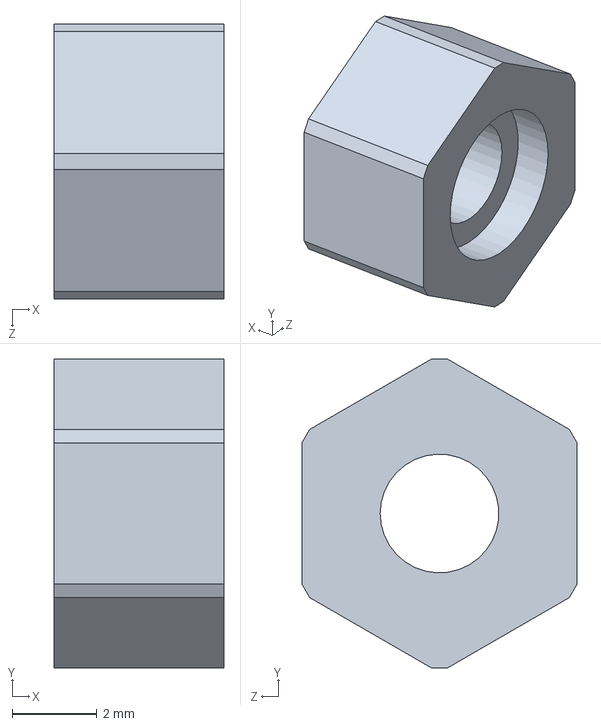
[picture p159: CAD file, 2021-05-14]
3-加工图纸/2-晨光（A型）/3-方案三/M3螺母（厚）-A晨光-方案3.SLDPRT
4.00 x 7.29 x 6.50 mm
