nbruite/vacuum/3-加工图纸/2-晨光（A型）/4-方案四/PPS打印/塑料模具报价/后端盖.STEP

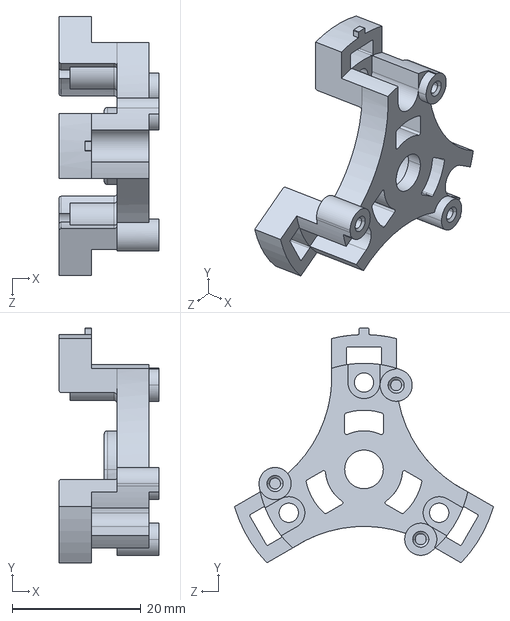
[picture p161: CAD file, 2021-06-16]
3-加工图纸/2-晨光（A型）/4-方案四/PPS打印/塑料模具报价/后端盖.STEP
15.5 x 36.5 x 40.3 mm
