nbruite/vacuum/3-加工图纸/2-晨光（A型）/4-方案四/方案4-2021.5.20/吸尘器-电机+风叶--方案A/T型垫柱A-晨光-方案3-方案4.SLDPRT

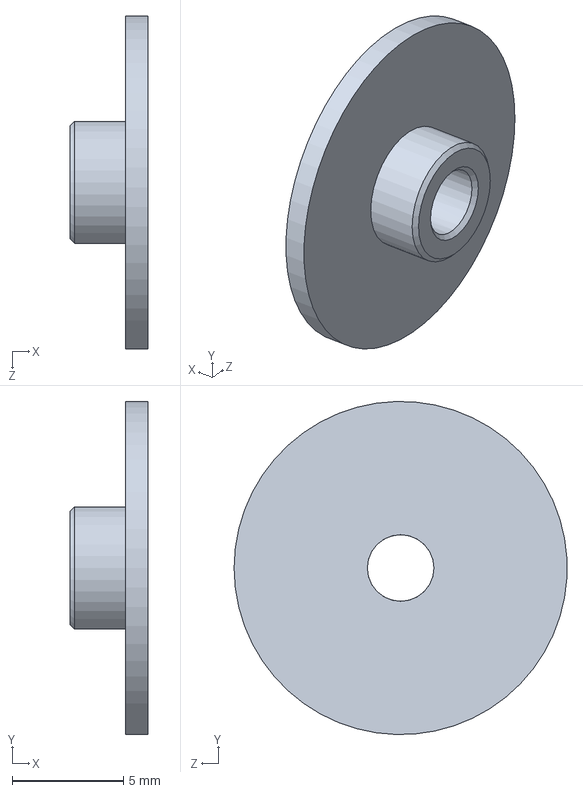
[picture p162: CAD file, 2021-05-22]
3-加工图纸/2-晨光（A型）/4-方案四/方案4-2021.5.20/吸尘器-电机+风叶--方案A/T型垫柱A-晨光-方案3-方案4.SLDPRT
3.50 x 15.0 x 15.0 mm
