nbruite/vacuum/3-加工图纸/2-晨光（A型）/4-方案四/波形垫圈5.6x8x0.15.STEP

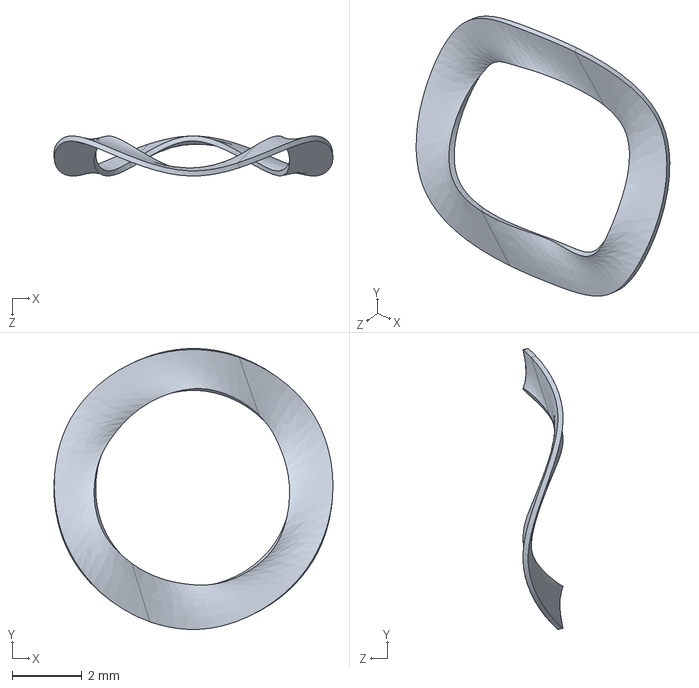
[picture p163: CAD file, 2021-06-18]
3-加工图纸/2-晨光（A型）/4-方案四/波形垫圈5.6x8x0.15.STEP
7.97 x 8.03 x 1.15 mm
