nbruite/vacuum/3-加工图纸/2-晨光（A型）/5-方案五/V26-方案5-2021.6.21-样板件/3D打印/风罩.STEP

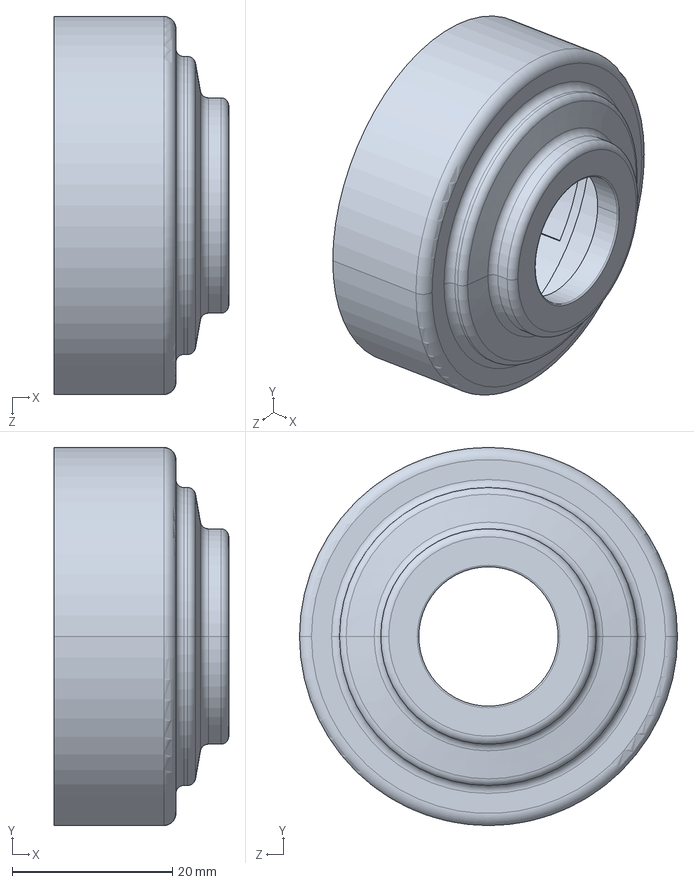
[picture p164: CAD file, 2021-06-21]
3-加工图纸/2-晨光（A型）/5-方案五/V26-方案5-2021.6.21-样板件/3D打印/风罩.STEP
21.8 x 47.2 x 47.2 mm
