nbruite/vacuum/3-加工图纸/2-晨光（A型）/6-方案六/前端盖-加定位标记.SLDPRT

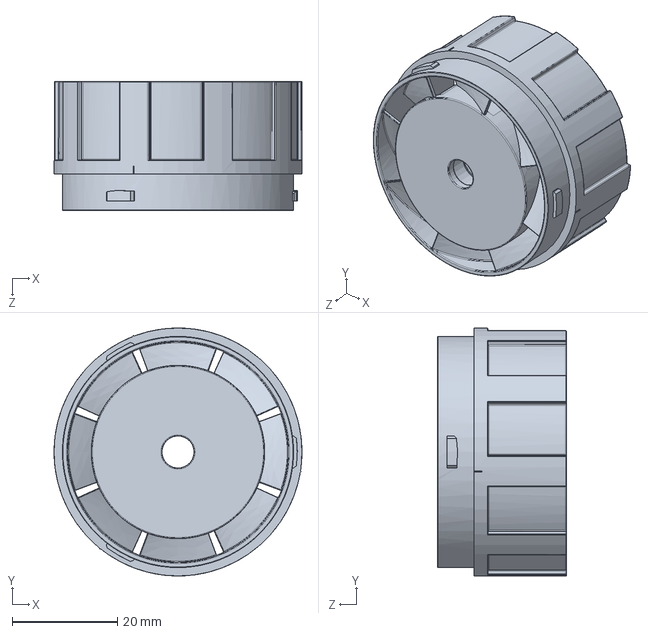
[picture p165: CAD file, 2021-07-22]
3-加工图纸/2-晨光（A型）/6-方案六/前端盖-加定位标记.SLDPRT
47.2 x 47.2 x 24.6 mm
