nbruite/vacuum/5-其他/2-设计参考/R20-001电机包胶铁芯.SLDPRT

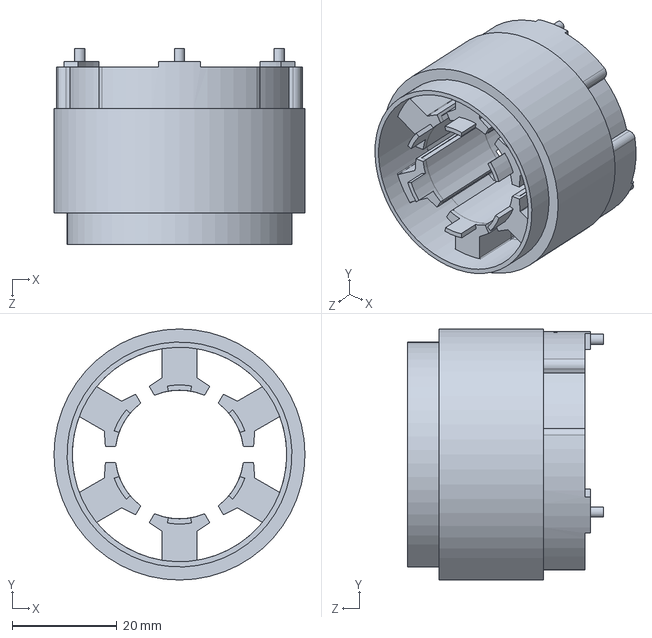
[picture p166: CAD file, 2021-05-14]
5-其他/2-设计参考/R20-001电机包胶铁芯.SLDPRT
48.0 x 48.0 x 37.5 mm
