nbruite/vacuum/2-采购合同/3D打印/2021-3-31打印/风罩-戈雷姆-B型.STEP

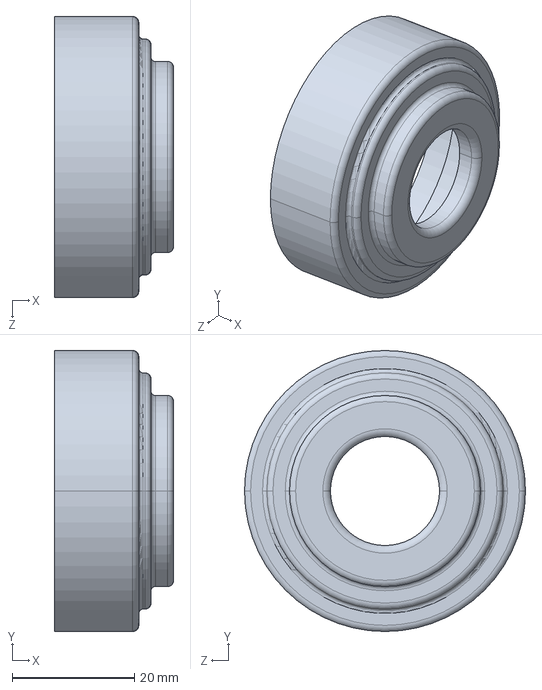
[picture p167: CAD file, 2021-03-31]
2-采购合同/3D打印/2021-3-31打印/风罩-戈雷姆-B型.STEP
19.5 x 45.9 x 45.9 mm
