nbruite/vacuum/2-采购合同/塑料件/塑料模报价单+图纸/后端盖.STEP

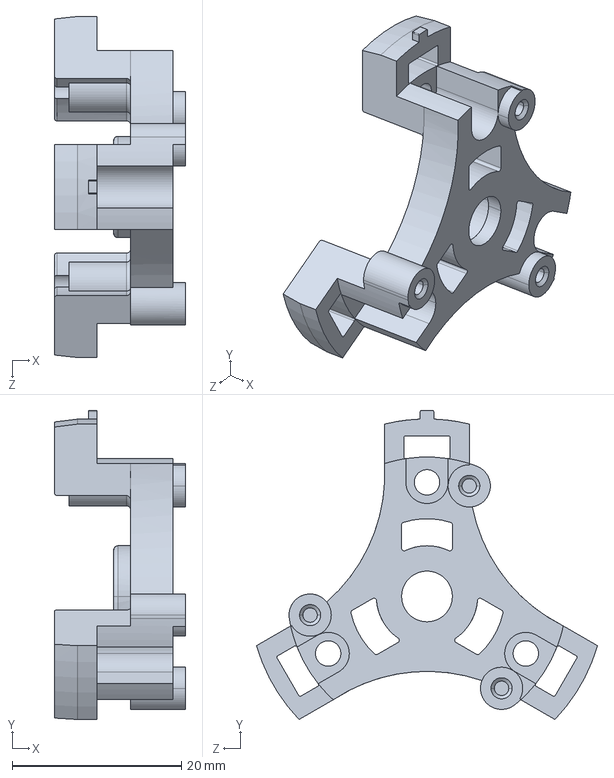
[picture p168: CAD file, 2021-06-21]
2-采购合同/塑料件/塑料模报价单+图纸/后端盖.STEP
15.5 x 36.6 x 40.4 mm
