nbruite/vacuum/3-加工图纸/2-晨光（A型）/2-方案二/吸尘器-电机+风叶--方案A/T型垫柱A-晨光.SLDPRT

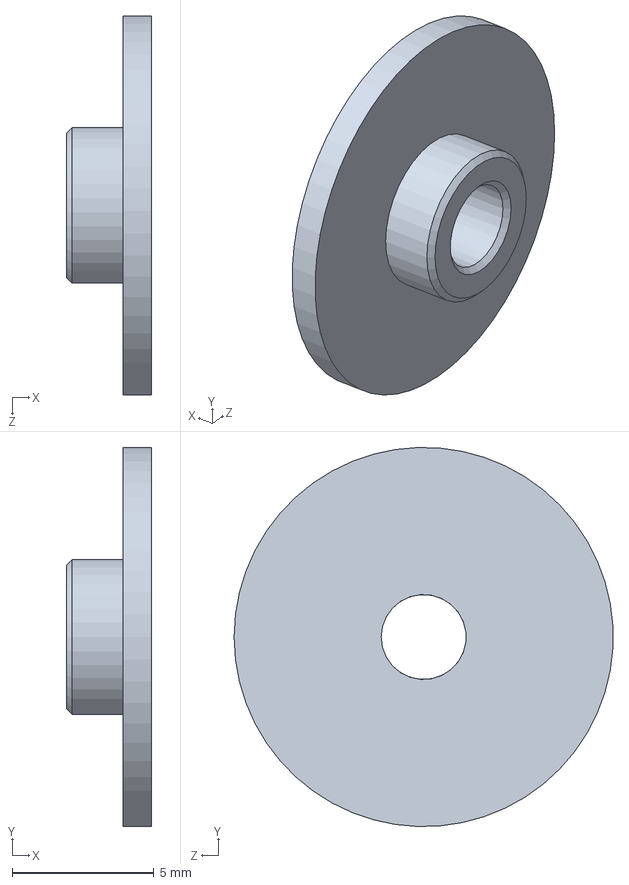
[picture p169: CAD file, 2021-05-14]
3-加工图纸/2-晨光（A型）/2-方案二/吸尘器-电机+风叶--方案A/T型垫柱A-晨光.SLDPRT
3.00 x 13.4 x 13.4 mm
