nbruite/vacuum/3-加工图纸/2-晨光（A型）/3-方案三/密封棉-方案3.SLDPRT

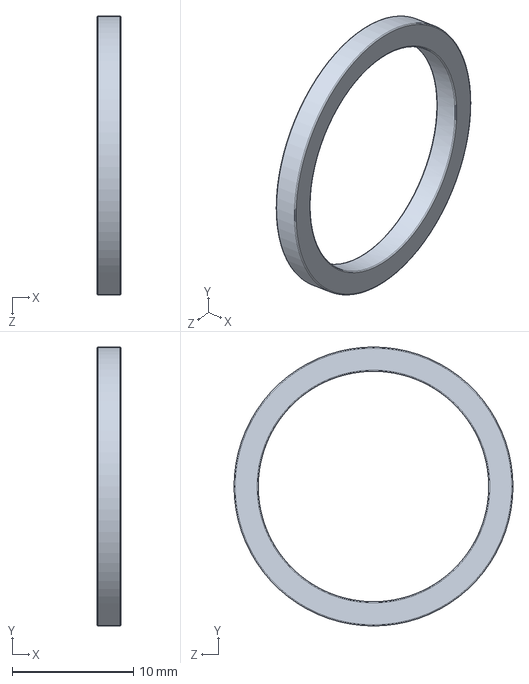
[picture p170: CAD file, 2021-05-14]
3-加工图纸/2-晨光（A型）/3-方案三/密封棉-方案3.SLDPRT
2.00 x 23.0 x 23.0 mm
