nbruite/vacuum/3-加工图纸/2-晨光（A型）/4-方案四/PPS打印/塑料模具报价/风罩.STEP

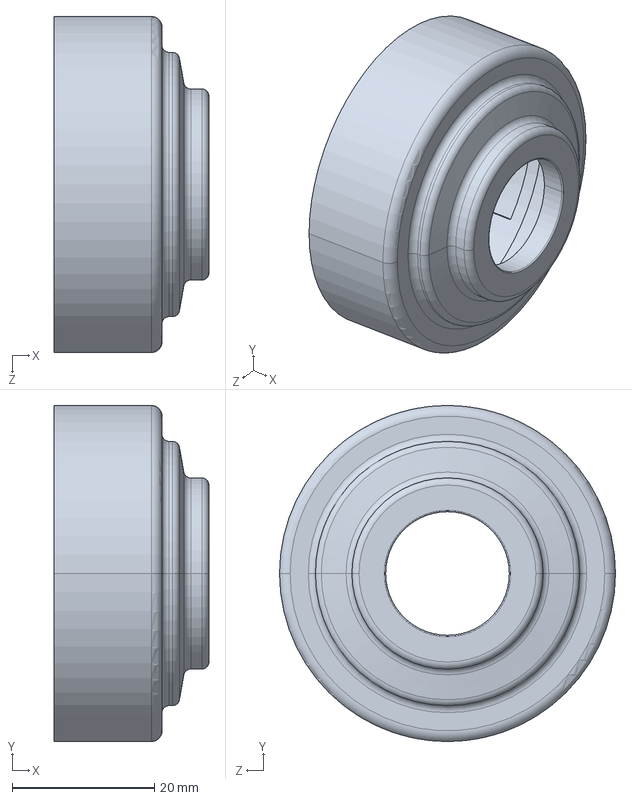
[picture p171: CAD file, 2021-06-16]
3-加工图纸/2-晨光（A型）/4-方案四/PPS打印/塑料模具报价/风罩.STEP
21.8 x 47.3 x 47.3 mm
