nbruite/vacuum/3-加工图纸/2-晨光（A型）/5-方案五/V26-方案5-2021.6.21-样板件/3D打印/电机绕线骨架2.STEP

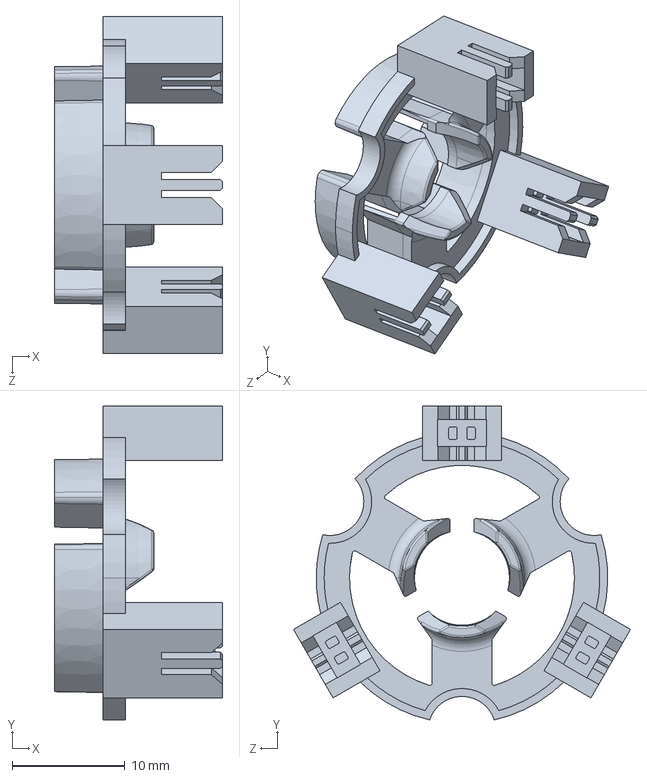
[picture p172: CAD file, 2021-06-21]
3-加工图纸/2-晨光（A型）/5-方案五/V26-方案5-2021.6.21-样板件/3D打印/电机绕线骨架2.STEP
14.9 x 27.8 x 29.8 mm
