nbruite/vacuum/3-加工图纸/2-晨光（A型）/6-方案六/方案6.1（去掉扣点）/风罩.SLDPRT

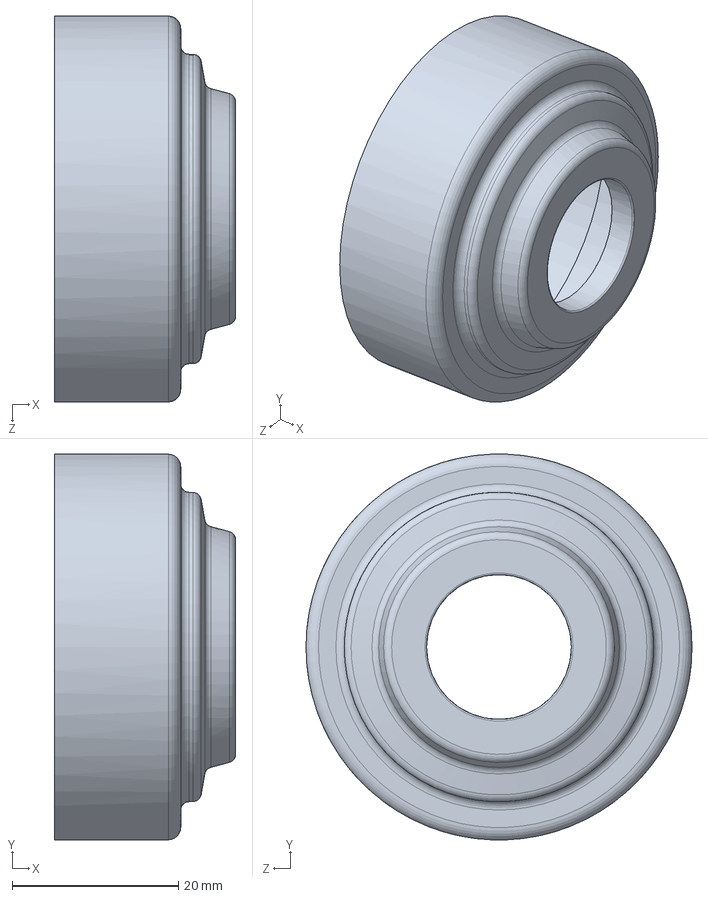
[picture p173: CAD file, 2021-07-14]
3-加工图纸/2-晨光（A型）/6-方案六/方案6.1（去掉扣点）/风罩.SLDPRT
21.8 x 46.4 x 46.4 mm
