nbruite/vacuum/3-加工图纸/2-晨光（A型）/7-定稿图纸/吸尘器电机2021.7.23/定子铁芯.STEP

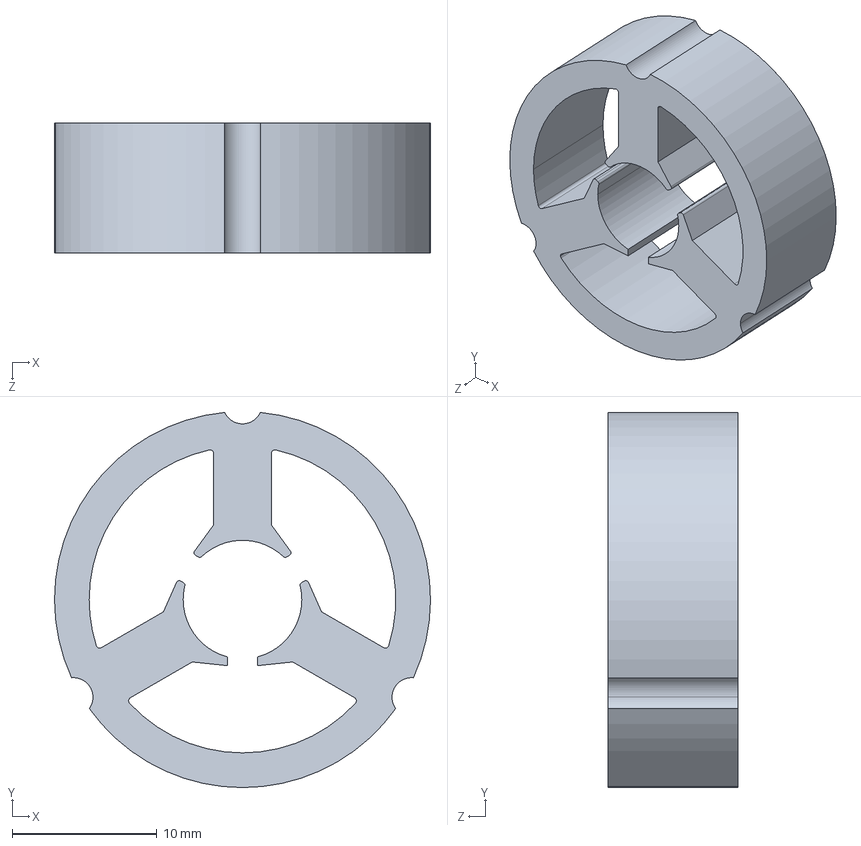
[picture p174: CAD file, 2021-08-10]
3-加工图纸/2-晨光（A型）/7-定稿图纸/吸尘器电机2021.7.23/定子铁芯.STEP
26.0 x 25.9 x 9.00 mm
