nbruite/vacuum/2-采购合同/3D打印/2021-3-31打印/风罩.STEP

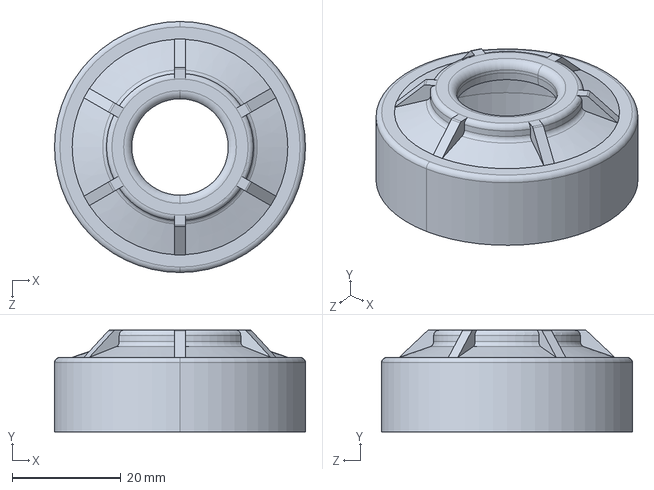
[picture p175: CAD file, 2021-03-25]
2-采购合同/3D打印/2021-3-31打印/风罩.STEP
46.1 x 18.7 x 46.1 mm
