nbruite/vacuum/3-加工图纸/1-冉工提供（C型）/3D打印/上骨架.STEP

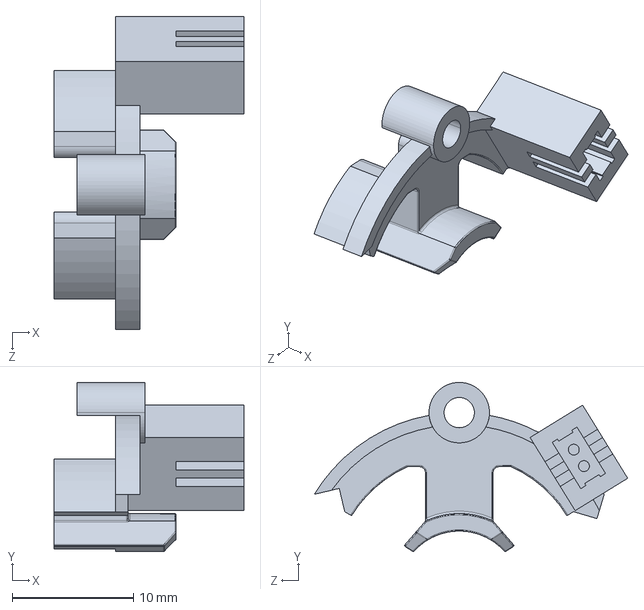
[picture p176: CAD file, 2021-03-25]
3-加工图纸/1-冉工提供（C型）/3D打印/上骨架.STEP
15.7 x 14.0 x 25.9 mm
