nbruite/vacuum/3-加工图纸/2-晨光（A型）/2-方案二/后端盖-A型-晨光-测绘+圆周定位.SLDPRT

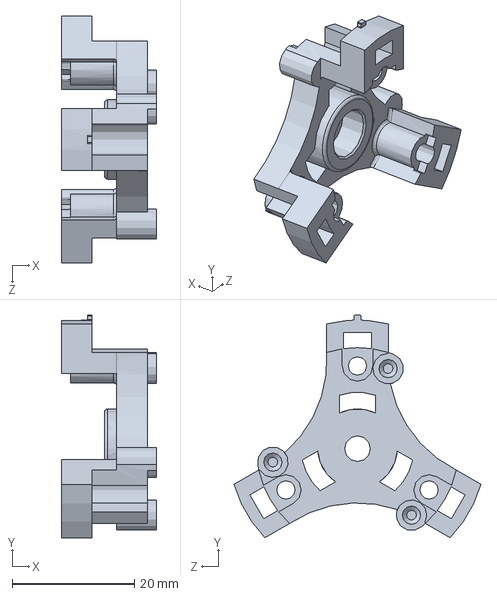
[picture p177: CAD file, 2021-05-14]
3-加工图纸/2-晨光（A型）/2-方案二/后端盖-A型-晨光-测绘+圆周定位.SLDPRT
15.5 x 36.4 x 40.4 mm
