nbruite/vacuum/3-加工图纸/2-晨光（A型）/2-方案二/吸尘器-电机+风叶--方案A/风叶轮-2.SLDPRT

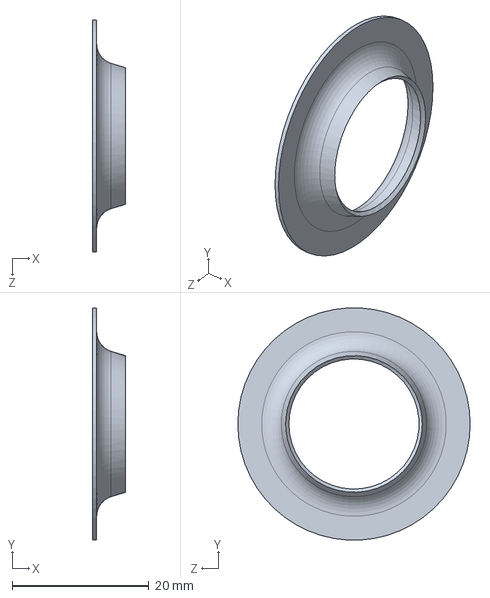
[picture p178: CAD file, 2021-05-14]
3-加工图纸/2-晨光（A型）/2-方案二/吸尘器-电机+风叶--方案A/风叶轮-2.SLDPRT
4.80 x 33.9 x 34.0 mm
