nbruite/vacuum/3-加工图纸/1-冉工提供（C型）/3D打印/下骨架.STEP

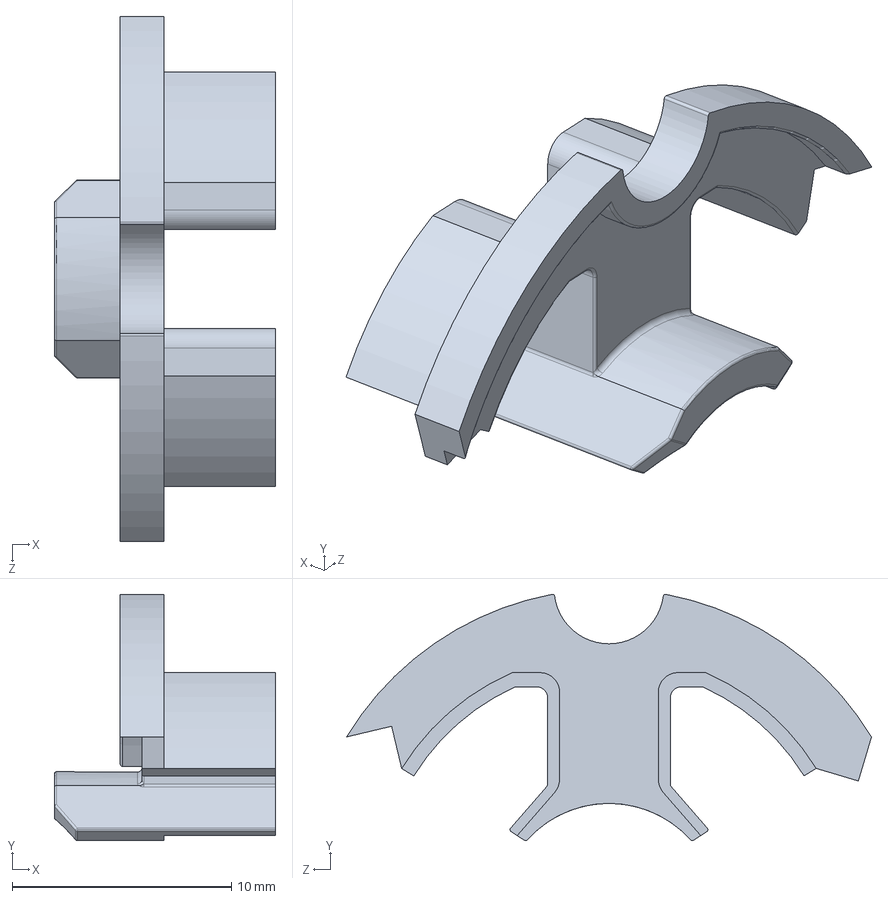
[picture p179: CAD file, 2021-03-25]
3-加工图纸/1-冉工提供（C型）/3D打印/下骨架.STEP
10.1 x 11.2 x 24.0 mm
