nbruite/vacuum/3-加工图纸/2-晨光（A型）/1-原厂方案/后端盖-A型-晨光-测绘.STEP

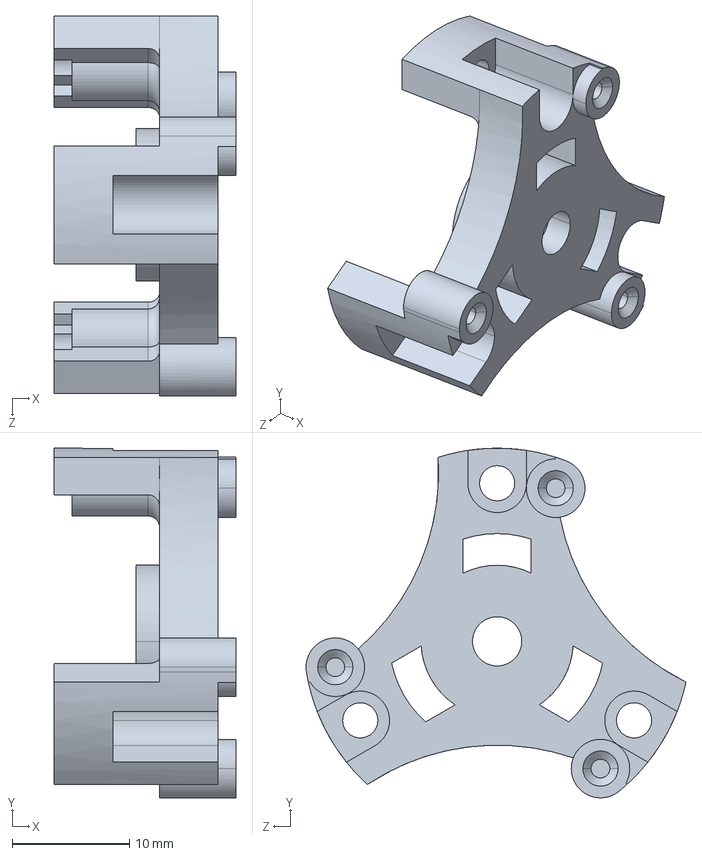
[picture p180: CAD file, 2021-04-19]
3-加工图纸/2-晨光（A型）/1-原厂方案/后端盖-A型-晨光-测绘.STEP
15.5 x 29.9 x 32.5 mm
