nbruite/vacuum/3-加工图纸/2-晨光（A型）/2-方案二/吸尘器-电机+风叶--方案A/叶片-1.SLDPRT

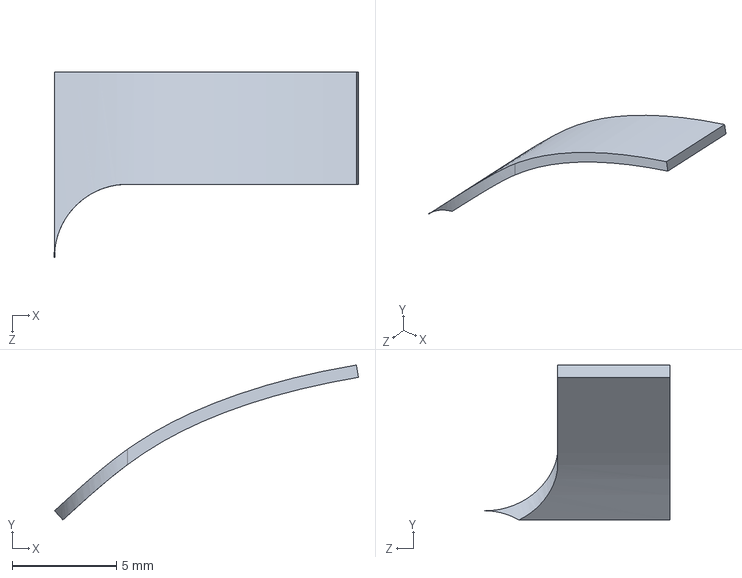
[picture p182: CAD file, 2021-05-14]
3-加工图纸/2-晨光（A型）/2-方案二/吸尘器-电机+风叶--方案A/叶片-1.SLDPRT
14.6 x 7.44 x 8.90 mm
