nbruite/vacuum/3-加工图纸/2-晨光（A型）/3-方案三/吸尘器-电机+风叶--方案A/叶片-1-方案3.SLDPRT

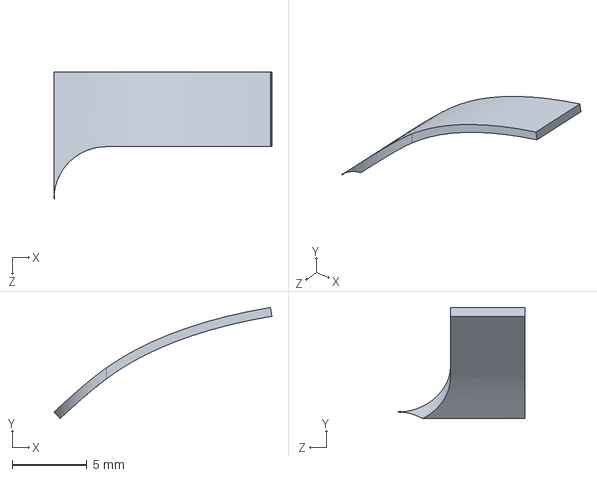
[picture p183: CAD file, 2021-05-14]
3-加工图纸/2-晨光（A型）/3-方案三/吸尘器-电机+风叶--方案A/叶片-1-方案3.SLDPRT
14.6 x 7.44 x 8.50 mm
