nbruite/vacuum/3-加工图纸/2-晨光（A型）/3-方案三/轴A-晨光-方案3.SLDPRT

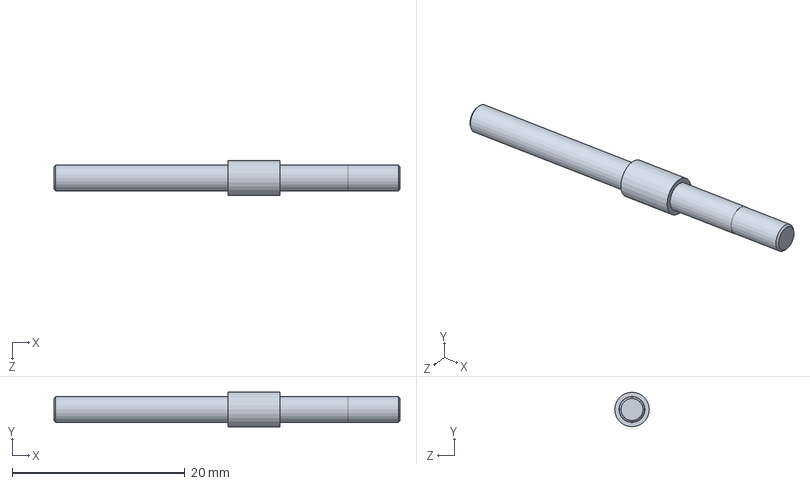
[picture p184: CAD file, 2021-05-14]
3-加工图纸/2-晨光（A型）/3-方案三/轴A-晨光-方案3.SLDPRT
40.0 x 4.00 x 4.00 mm
