nbruite/vacuum/3-加工图纸/1-冉工提供（C型）/3D打印/上骨架-改锥型-2021.3.25.SLDPRT

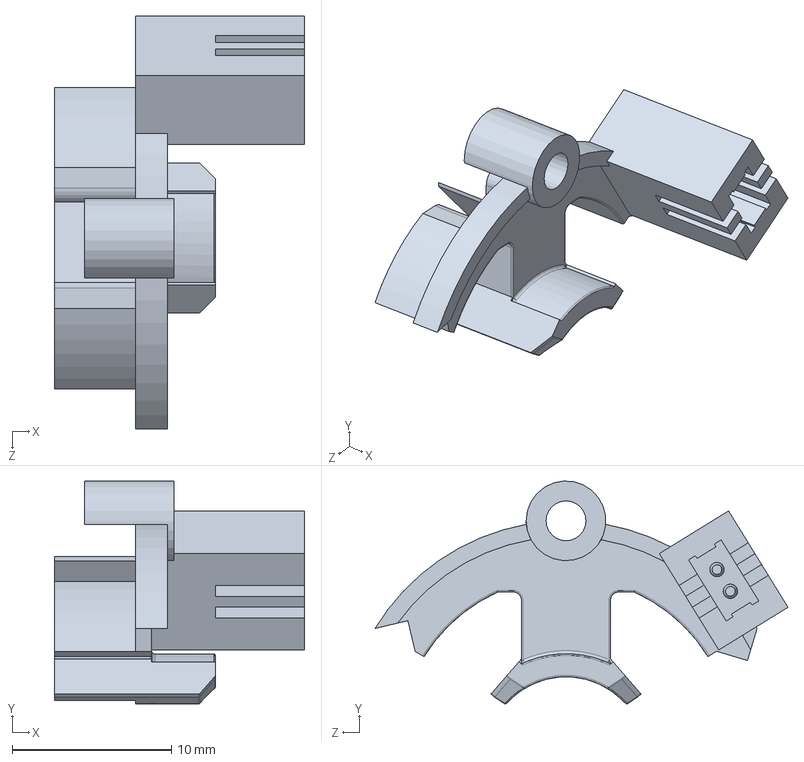
[picture p186: CAD file, 2021-03-25]
3-加工图纸/1-冉工提供（C型）/3D打印/上骨架-改锥型-2021.3.25.SLDPRT
15.7 x 14.0 x 25.9 mm
