nbruite/vacuum/3-加工图纸/2-晨光（A型）/1-原厂方案/前端风罩-A型-晨光-加厚-塑料.STEP

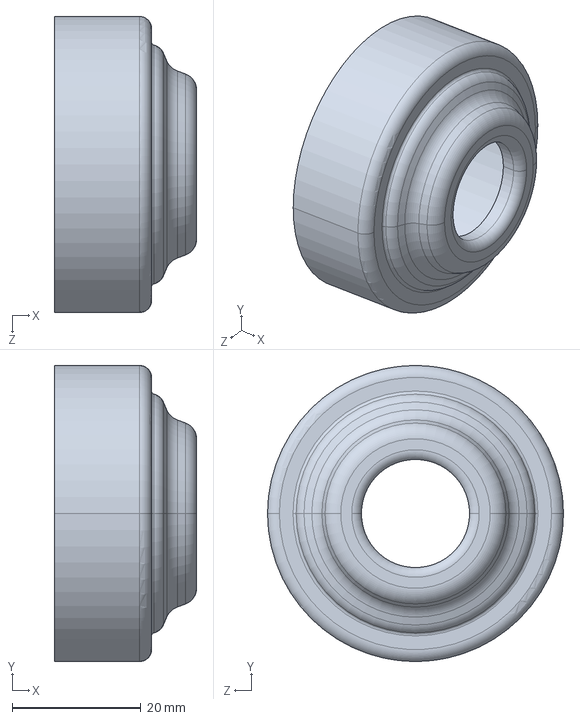
[picture p187: CAD file, 2021-04-19]
3-加工图纸/2-晨光（A型）/1-原厂方案/前端风罩-A型-晨光-加厚-塑料.STEP
22.1 x 46.0 x 46.0 mm
