nbruite/vacuum/3-加工图纸/2-晨光（A型）/1-原厂方案/晨光方案3D图纸/电机定子铁芯-201500-A型.SLDPRT

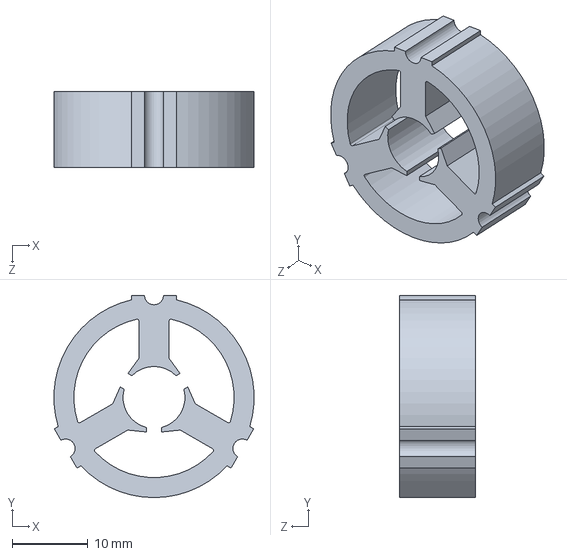
[picture p188: CAD file, 2021-05-14]
3-加工图纸/2-晨光（A型）/1-原厂方案/晨光方案3D图纸/电机定子铁芯-201500-A型.SLDPRT
26.5 x 26.8 x 10.0 mm
