nbruite/vacuum/3-加工图纸/2-晨光（A型）/2-方案二/电机绕线骨架1-A型.SLDPRT

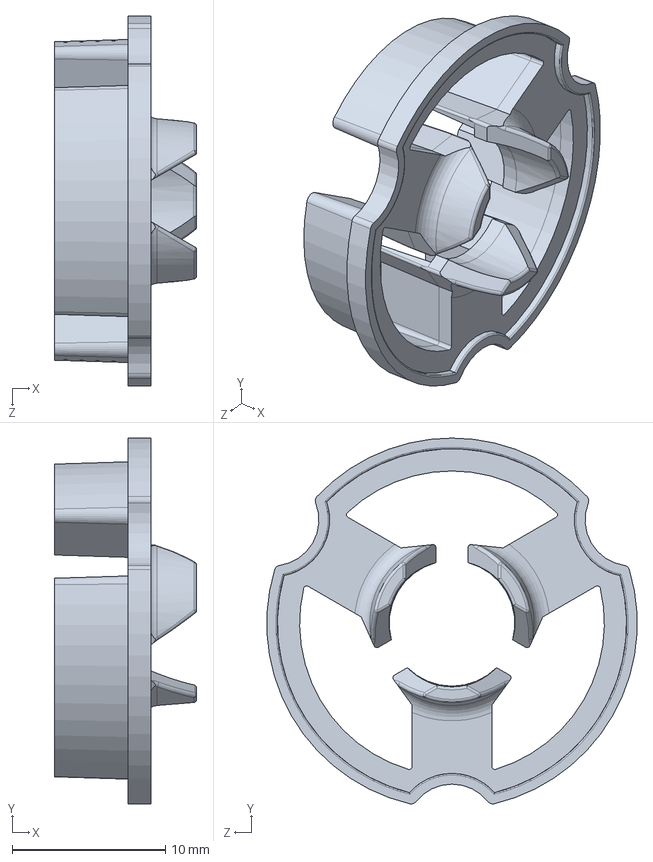
[picture p189: CAD file, 2021-05-14]
3-加工图纸/2-晨光（A型）/2-方案二/电机绕线骨架1-A型.SLDPRT
9.30 x 23.9 x 24.2 mm
