nbruite/vacuum/3-加工图纸/2-晨光（A型）/3-方案三/磁环A-晨光-方案3.SLDPRT

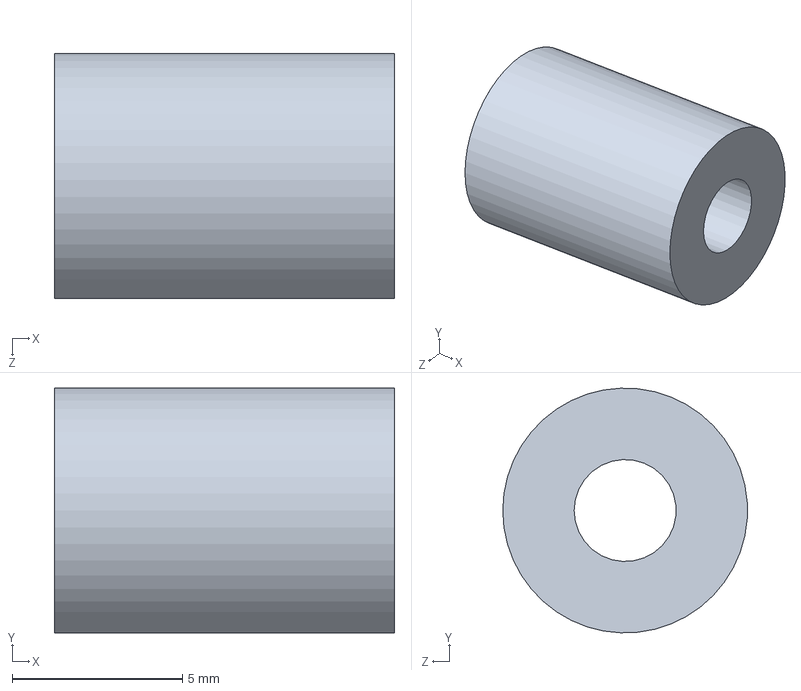
[picture p191: CAD file, 2021-05-14]
3-加工图纸/2-晨光（A型）/3-方案三/磁环A-晨光-方案3.SLDPRT
10.0 x 7.20 x 7.19 mm
