nbruite/vacuum/3-加工图纸/2-晨光（A型）/4-方案四/PPS打印/塑料模具报价/上骨架.STEP

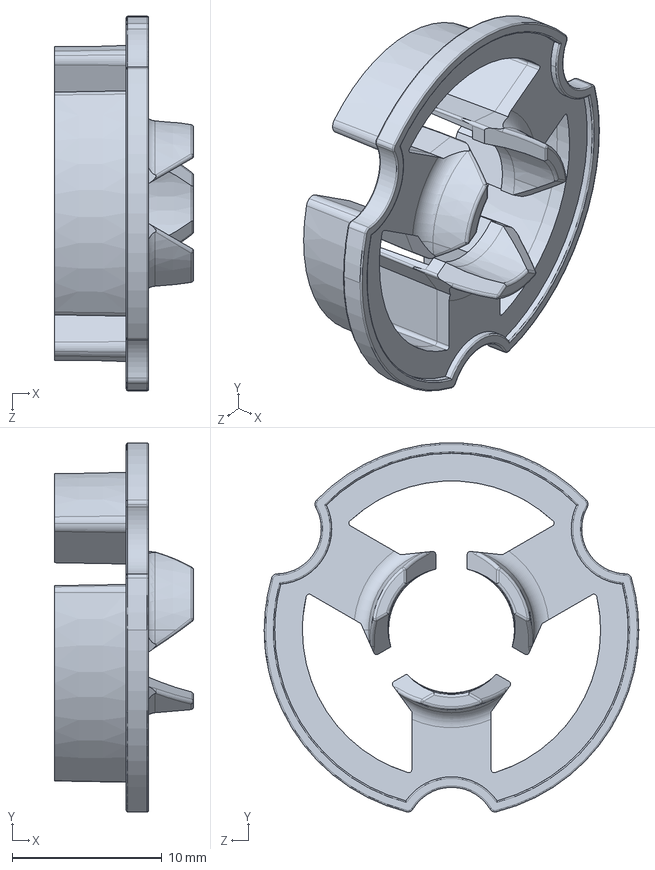
[picture p192: CAD file, 2021-06-16]
3-加工图纸/2-晨光（A型）/4-方案四/PPS打印/塑料模具报价/上骨架.STEP
9.30 x 24.6 x 25.0 mm
