nbruite/vacuum/3-加工图纸/2-晨光（A型）/7-定稿图纸/吸尘器电机2021.7.23/电机绕线骨架.STEP

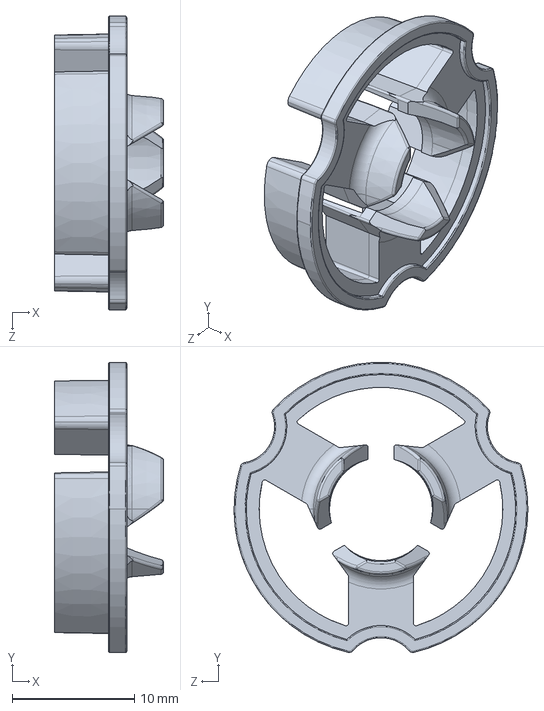
[picture p193: CAD file, 2021-08-10]
3-加工图纸/2-晨光（A型）/7-定稿图纸/吸尘器电机2021.7.23/电机绕线骨架.STEP
8.90 x 23.7 x 24.0 mm
