nbruite/vacuum/3-加工图纸/2-晨光（A型）/3-方案三/后端盖-A型-晨光-测绘+圆周定位-方案3.STEP

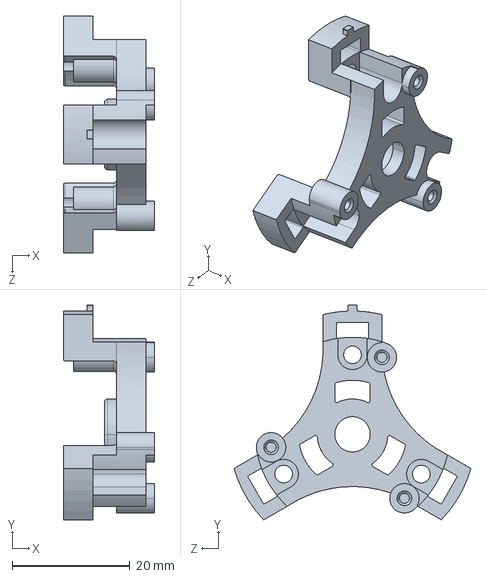
[picture p194: CAD file, 2021-05-14]
3-加工图纸/2-晨光（A型）/3-方案三/后端盖-A型-晨光-测绘+圆周定位-方案3.STEP
15.5 x 36.5 x 40.3 mm
