nbruite/vacuum/3-加工图纸/2-晨光（A型）/3-方案三/吸尘器-电机+风叶--方案A/圆垫片3x15x1-方案3.SLDPRT

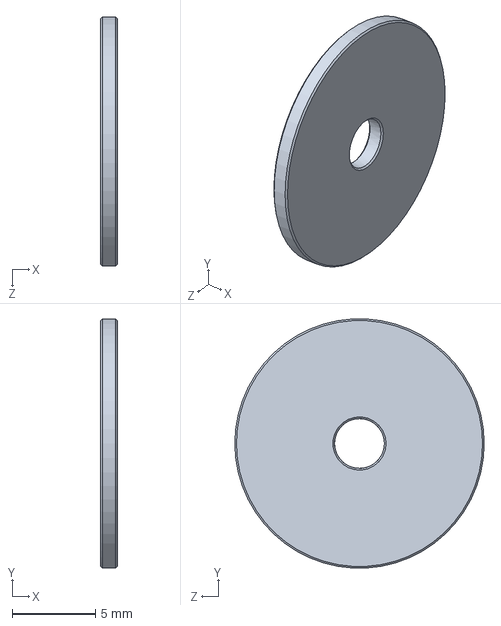
[picture p195: CAD file, 2021-05-14]
3-加工图纸/2-晨光（A型）/3-方案三/吸尘器-电机+风叶--方案A/圆垫片3x15x1-方案3.SLDPRT
1.00 x 15.0 x 15.0 mm
