nbruite/vacuum/3-加工图纸/2-晨光（A型）/1-原厂方案/晨光方案3D图纸/电机绕线骨架2-带接线头-A型.SLDPRT

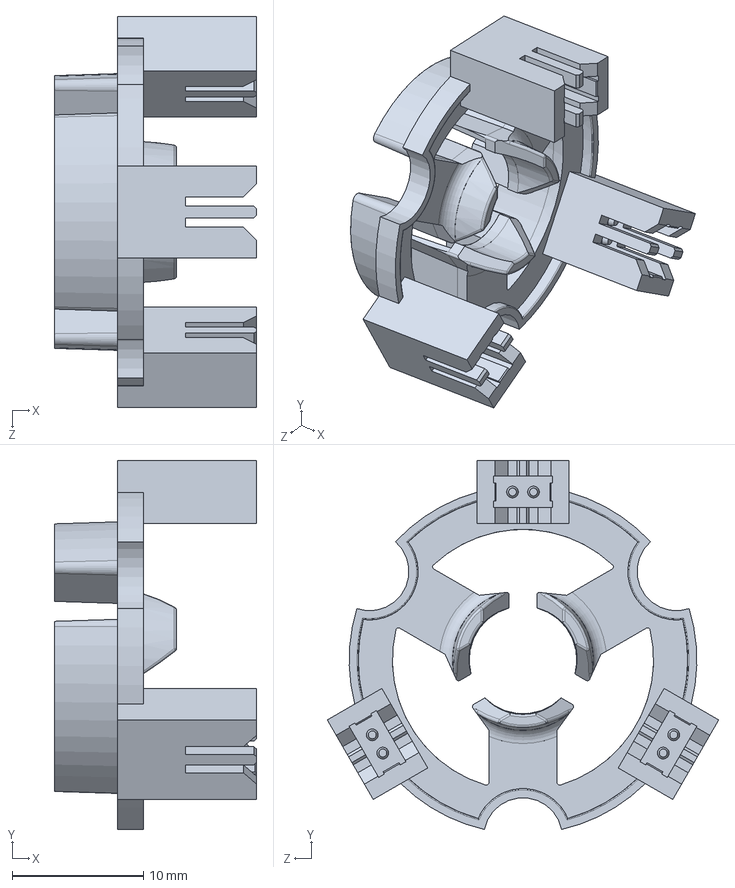
[picture p197: CAD file, 2021-05-14]
3-加工图纸/2-晨光（A型）/1-原厂方案/晨光方案3D图纸/电机绕线骨架2-带接线头-A型.SLDPRT
15.4 x 28.1 x 29.8 mm
