nbruite/vacuum/3-加工图纸/2-晨光（A型）/3-方案三/前端风罩-塑料-方案3.SLDPRT

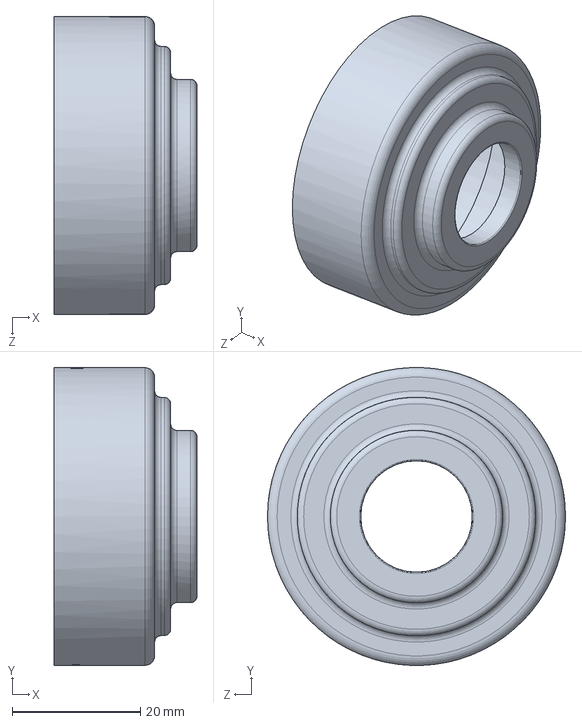
[picture p198: CAD file, 2021-05-14]
3-加工图纸/2-晨光（A型）/3-方案三/前端风罩-塑料-方案3.SLDPRT
22.3 x 46.5 x 46.5 mm
