nbruite/vacuum/3-加工图纸/2-晨光（A型）/2-方案二/后端盖-A型-晨光-测绘.SLDPRT

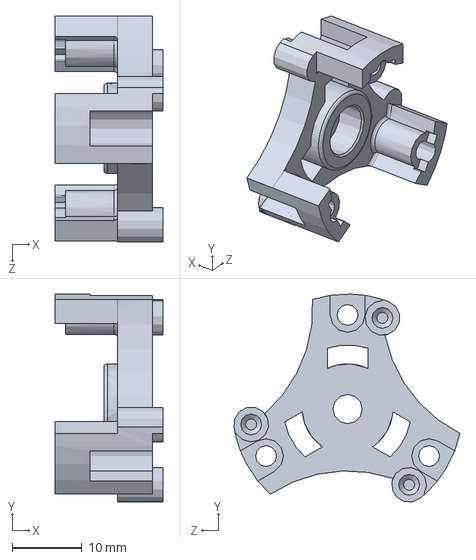
[picture p199: CAD file, 2021-05-14]
3-加工图纸/2-晨光（A型）/2-方案二/后端盖-A型-晨光-测绘.SLDPRT
15.5 x 29.8 x 32.4 mm
