nbruite/vacuum/3-加工图纸/2-晨光（A型）/4-方案四/方案4-2021.5.20/前端风罩-塑料-斜面-方案3-方案4.SLDPRT

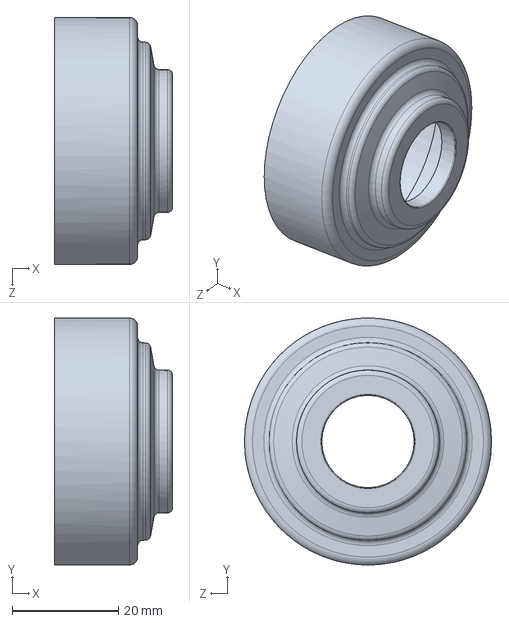
[picture p200: CAD file, 2021-05-22]
3-加工图纸/2-晨光（A型）/4-方案四/方案4-2021.5.20/前端风罩-塑料-斜面-方案3-方案4.SLDPRT
22.3 x 46.5 x 46.5 mm
