nbruite/vacuum/3-加工图纸/2-晨光（A型）/7-定稿图纸/吸尘器电机2021.7.23/后端盖-A型-晨光-测绘+圆周定位-方案3-方案4-方案5.SLDPRT

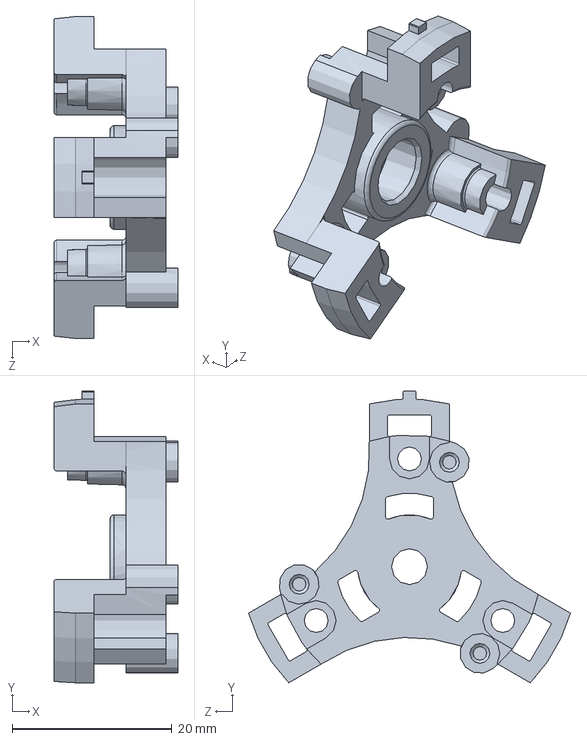
[picture p201: CAD file, 2021-07-23]
3-加工图纸/2-晨光（A型）/7-定稿图纸/吸尘器电机2021.7.23/后端盖-A型-晨光-测绘+圆周定位-方案3-方案4-方案5.SLDPRT
15.5 x 36.5 x 40.4 mm
