nbruite/vacuum/3-加工图纸/2-晨光（A型）/4-方案四/方案4-2021.5.20/电机定子铁芯-201500-A型-方案3-方案4.SLDPRT

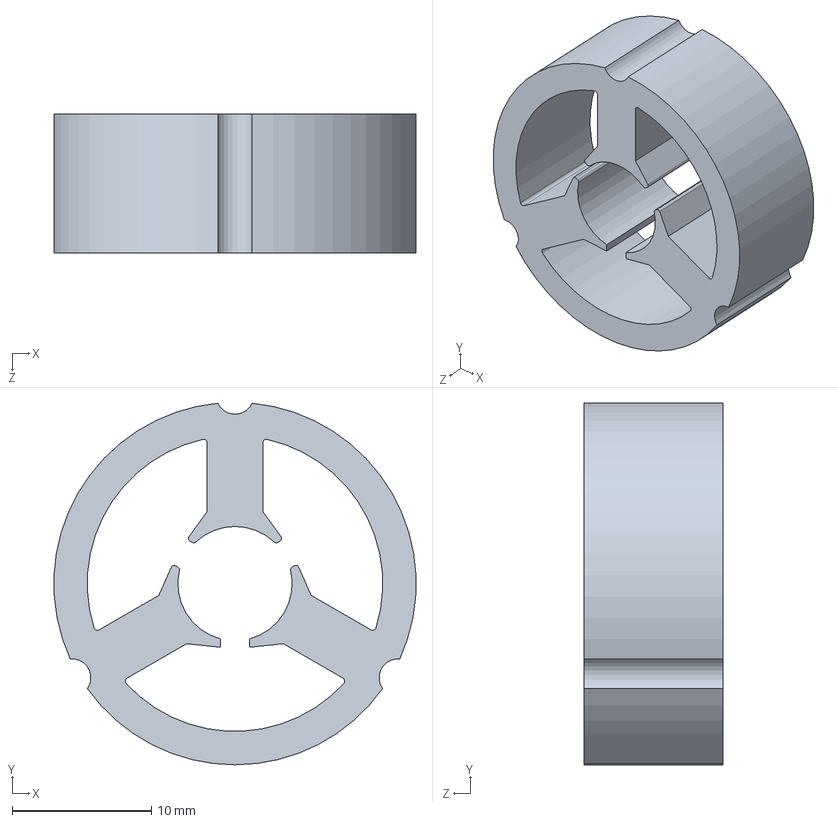
[picture p202: CAD file, 2021-05-22]
3-加工图纸/2-晨光（A型）/4-方案四/方案4-2021.5.20/电机定子铁芯-201500-A型-方案3-方案4.SLDPRT
26.0 x 25.9 x 10.0 mm
