nbruite/vacuum/3-加工图纸/2-晨光（A型）/4-方案四/方案4-2021.5.20/前端风罩-A型-晨光-加厚-塑料+导风槽-方案3-方案4.SLDPRT

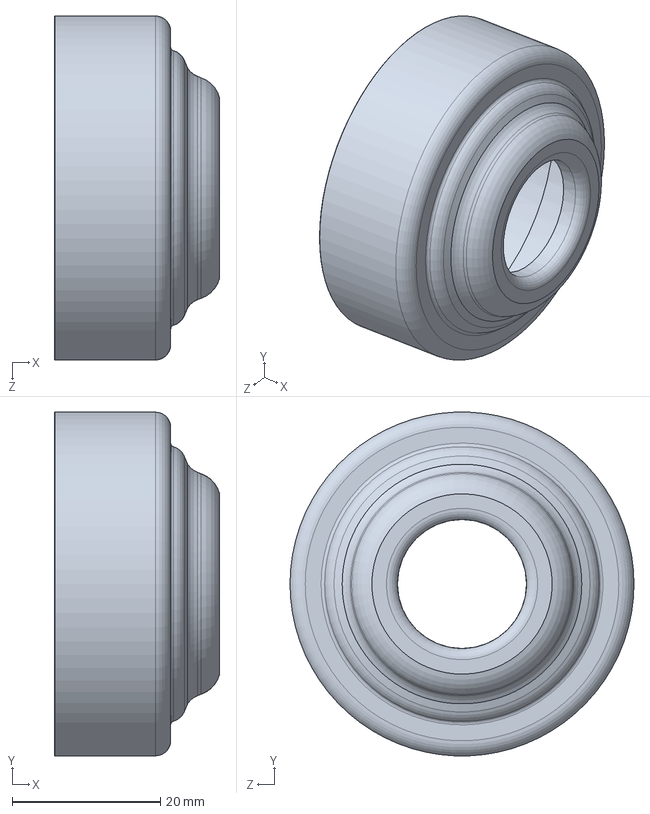
[picture p203: CAD file, 2021-05-22]
3-加工图纸/2-晨光（A型）/4-方案四/方案4-2021.5.20/前端风罩-A型-晨光-加厚-塑料+导风槽-方案3-方案4.SLDPRT
22.3 x 46.4 x 46.4 mm
