nbruite/vacuum/3-加工图纸/2-晨光（A型）/3-方案三/轴承3x8x4-晨光-方案3.SLDPRT

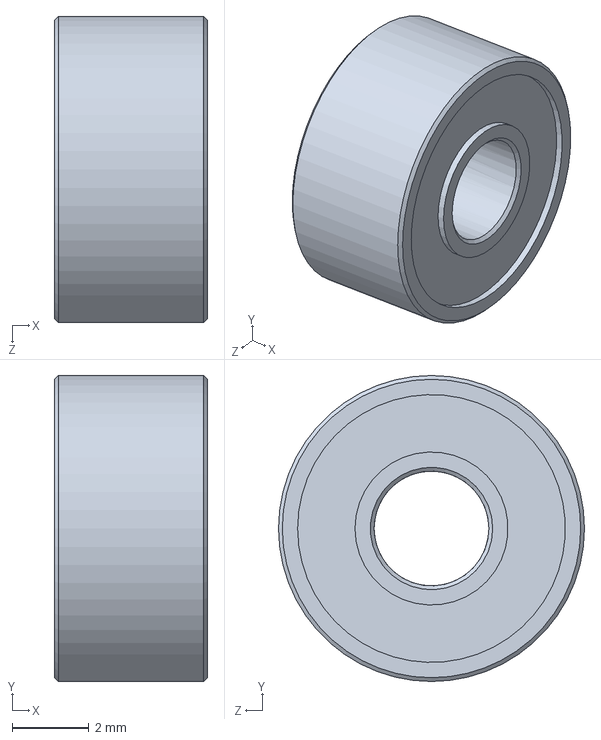
[picture p204: CAD file, 2021-05-14]
3-加工图纸/2-晨光（A型）/3-方案三/轴承3x8x4-晨光-方案3.SLDPRT
4.00 x 8.00 x 8.00 mm
