nbruite/vacuum/3-加工图纸/2-晨光（A型）/1-原厂方案/晨光方案3D图纸/电机绕线骨架1-A型-角度82.SLDPRT

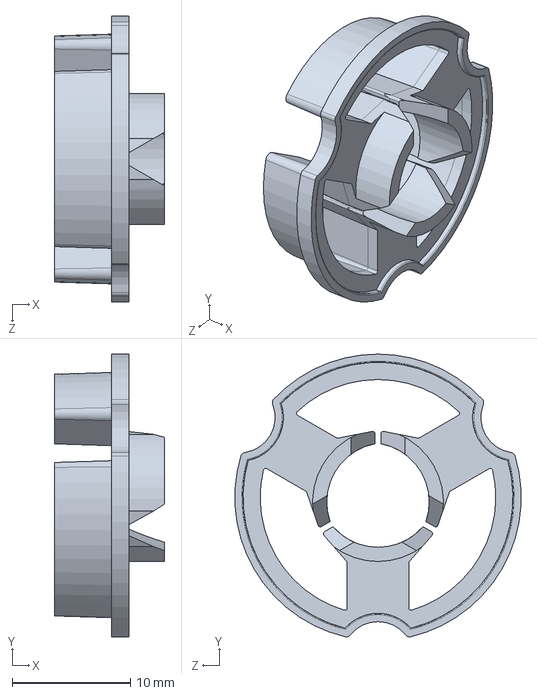
[picture p205: CAD file, 2021-05-14]
3-加工图纸/2-晨光（A型）/1-原厂方案/晨光方案3D图纸/电机绕线骨架1-A型-角度82.SLDPRT
9.30 x 23.9 x 24.2 mm
