nbruite/vacuum/3-加工图纸/2-晨光（A型）/7-定稿图纸/吸尘器电机2021.7.23/磁环A-晨光-方案3-方案4-方案5.SLDPRT

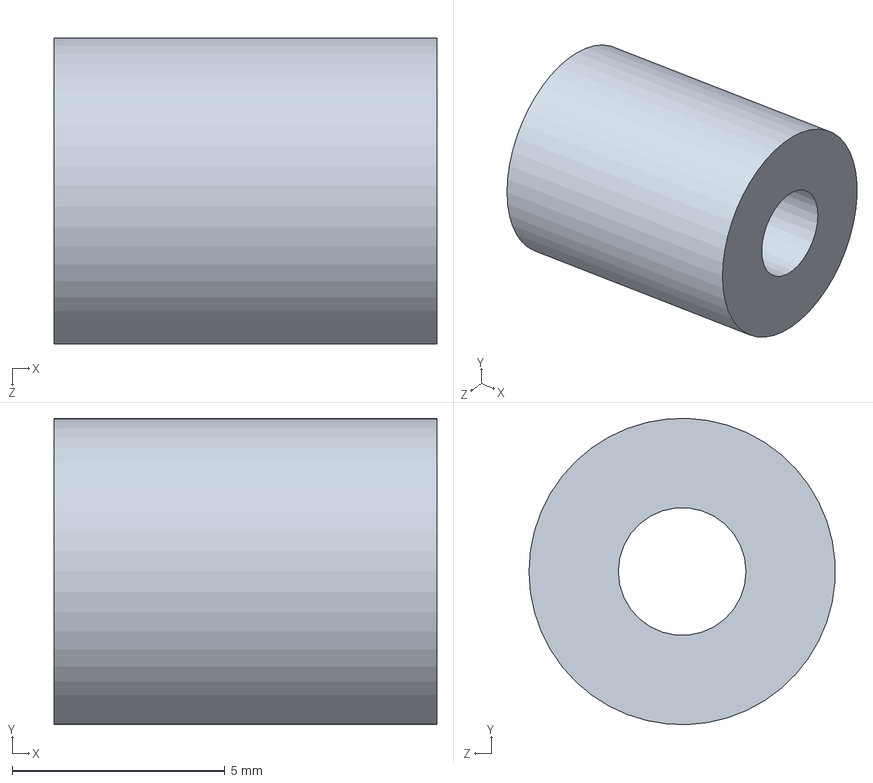
[picture p206: CAD file, 2021-07-22]
3-加工图纸/2-晨光（A型）/7-定稿图纸/吸尘器电机2021.7.23/磁环A-晨光-方案3-方案4-方案5.SLDPRT
9.00 x 7.20 x 7.19 mm
