nbruite/vacuum/3-加工图纸/2-晨光（A型）/7-定稿图纸/吸尘器电机2021.7.23/接线铜端子-晨光-2021.6.15-方案5.SLDPRT

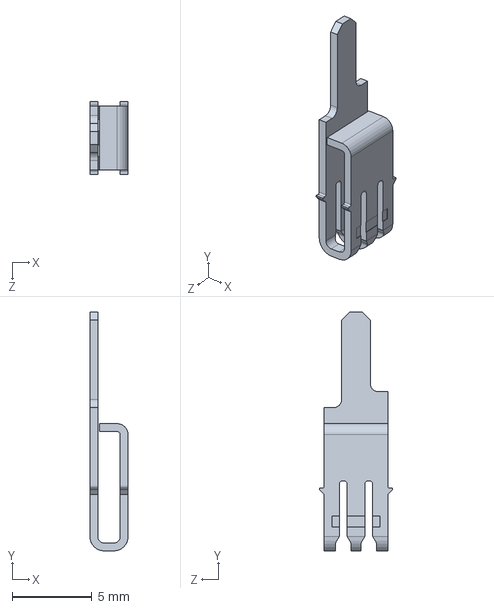
[picture p208: CAD file, 2021-07-22]
3-加工图纸/2-晨光（A型）/7-定稿图纸/吸尘器电机2021.7.23/接线铜端子-晨光-2021.6.15-方案5.SLDPRT
2.40 x 15.0 x 4.60 mm
