nbruite/vacuum/3-加工图纸/2-晨光（A型）/4-方案四/方案4-2021.5.20/吸尘器-电机+风叶--方案A/装配体-叶轮-方案3-方案4.SLDASM

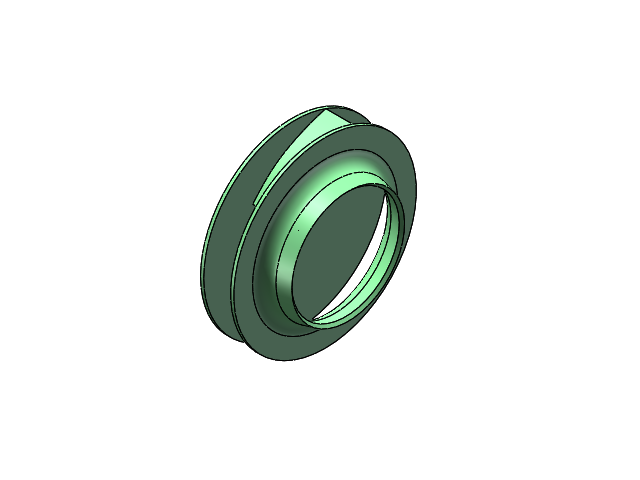
[picture p209: CAD file, 2021-05-22]
3-加工图纸/2-晨光（A型）/4-方案四/方案4-2021.5.20/吸尘器-电机+风叶--方案A/装配体-叶轮-方案3-方案4.SLDASM
风叶轮-1-方案3-方案4
风叶轮-2-方案3-方案4
叶片-1-方案3-方案4
