nbruite/vacuum/(list of files, cad)

Other CAD files:
3-加工图纸/2-晨光（A型）/1-原厂方案/晨光方案3D图纸/装配体-叶轮A-晨光.SLDASM
3-加工图纸/2-晨光（A型）/7-定稿图纸/吸尘器电机2021.7.23/装配体-叶轮-RT-方案5.SLDASM
3-加工图纸/2-晨光（A型）/7-定稿图纸/吸尘器电机2021.7.23/装配体-电机定子-RT-方案5.SLDASM
3-加工图纸/2-晨光（A型）/3-方案三/装配体-晨光-方案2-方案3.SLDASM
3-加工图纸/2-晨光（A型）/1-原厂方案/晨光方案3D图纸/装配体1-电机定子-A型.SLDASM
3-加工图纸/2-晨光（A型）/2-方案二/装配体1-电机定子-A型.SLDASM
3-加工图纸/1-冉工提供（C型）/吸尘器电机-冉工提供（全部）.dwg
3-加工图纸/1-冉工提供（C型）/线切割/铜端子-2021.3.25-2004.dwg
3-加工图纸/2-晨光（A型）/1-原厂方案/吸尘器电机-晨光.dwg
3-加工图纸/2-晨光（A型）/4-方案四/方案4-2021.5.20/T型垫柱+M3厚螺母-2004.dwg
3-加工图纸/2-晨光（A型）/5-方案五/总装配体-吸尘器电机.dwg
3-加工图纸/2-晨光（A型）/6-方案六/定子组件/定子组件.dwg
3-加工图纸/2-晨光（A型）/6-方案六/方案6.1（去掉扣点）/前端盖（带加强筋）.SLDPRT
3-加工图纸/2-晨光（A型）/7-定稿图纸/吸尘器电机2021.7.23/电路板外形图.dwg
3-加工图纸/2-晨光（A型）/8-其他/φ26.8定子.dwg
3-加工图纸/60W电机PCB板.dwg
2-采购合同/3D打印/2021-4-5打印/后端盖.STEP
3-加工图纸/1-冉工提供（C型）/3D打印/前端盖.STEP
3-加工图纸/1-冉工提供（C型）/线切割/定子铁芯.dwg
3-加工图纸/2-晨光（A型）/1-原厂方案/电机定子铁芯-晨光原版-2021.4.24.dwg
3-加工图纸/2-晨光（A型）/2-方案二/前端盖A-晨光-设计-2021.4.16+圆周筋条+1mm筋.SLDPRT
3-加工图纸/2-晨光（A型）/3-方案三/吸尘器-电机+风叶--方案A/T型垫柱A-晨光-方案3.SLDPRT
3-加工图纸/2-晨光（A型）/4-方案四/倒扣/前端风罩-塑料-斜面-RT--自扣结构.SLDPRT
3-加工图纸/2-晨光（A型）/4-方案四/方案4-2021.5.20/前端盖-A型-方案4-加点胶槽.SLDPRT
3-加工图纸/2-晨光（A型）/4-方案四/波形垫圈8x5.6x0.15.dwg
3-加工图纸/2-晨光（A型）/5-方案五/总装配体-吸尘器电机-RT-2004.dwg
3-加工图纸/2-晨光（A型）/6-方案六/风罩-加定位标记.SLDPRT
3-加工图纸/2-晨光（A型）/8-其他/晨光外径+冉工内径组合.DWG
3-加工图纸/1-冉工提供（C型）/线切割/铜端子.dwg
3-加工图纸/2-晨光（A型）/1-原厂方案/电机定子铁芯-A型（测绘）.DWG
3-加工图纸/2-晨光（A型）/3-方案三/前端盖A-晨光-设计-2021.4.16+圆周筋条-风道倾角+5---方案3.SLDPRT
3-加工图纸/2-晨光（A型）/4-方案四/PPS打印/塑料模具报价/下骨架.STEP
3-加工图纸/2-晨光（A型）/4-方案四/倒扣/前端盖A-RT-自扣结构.SLDPRT
3-加工图纸/2-晨光（A型）/4-方案四/方案4-2021.5.20/26外径4极身宽度.dwg
3-加工图纸/2-晨光（A型）/4-方案四/铜端子-2021.5.21.dwg
3-加工图纸/2-晨光（A型）/5-方案五/总装配体-吸尘器电机-RT.DWG
3-加工图纸/2-晨光（A型）/6-方案六/总装配体-吸尘器电机-RT-2021-7-5.DWG
3-加工图纸/2-晨光（A型）/6-方案六/方案6.1（去掉扣点）/前端盖A（不带加强筋）.SLDPRT
3-加工图纸/2-晨光（A型）/7-定稿图纸/吸尘器电机2021.7.23/电机绕线骨架-带接线柱.STEP
3-加工图纸/2-晨光（A型）/2-方案二/前端盖A-设计-2021.4.16+圆周筋条.STEP
3-加工图纸/2-晨光（A型）/4-方案四/26外径4极身宽度-定子.dwg
3-加工图纸/2-晨光（A型）/4-方案四/PPS打印/塑料模具报价/前端盖.STEP
3-加工图纸/2-晨光（A型）/4-方案四/方案4-2021.5.20/前端盖A-晨光-设计-2021.4.16+圆周筋条-方案3-方案4.SLDPRT
3-加工图纸/2-晨光（A型）/6-方案六/总装配体-吸尘器电机-RT-2021-7-5-2004.dwg
3-加工图纸/2-晨光（A型）/7-定稿图纸/吸尘器电机2021.7.23/轴.dwg
3-加工图纸/2-晨光（A型）/4-方案四/方案4-2021.5.20/轴A-晨光-方案3-方案4.SLDPRT
3-加工图纸/1-冉工提供（C型）/3D打印/上骨架-改厚.SLDPRT
3-加工图纸/2-晨光（A型）/1-原厂方案/风罩-A型-晨光.STEP
3-加工图纸/2-晨光（A型）/2-方案二/前端盖A-晨光-设计-2021.4.16.SLDPRT
3-加工图纸/2-晨光（A型）/7-定稿图纸/吸尘器电机2021.7.23/总装配体-吸尘器电机-RT.DWG
3-加工图纸/2-晨光（A型）/1-原厂方案/电机绕线骨架2-带接线头-A型-2021.3.25.SLDPRT
3-加工图纸/2-晨光（A型）/7-定稿图纸/吸尘器电机2021.7.23/前端风罩-塑料-斜面-RT--自扣结构-方案5.SLDPRT
3-加工图纸/2-晨光（A型）/1-原厂方案/晨光方案3D图纸/轴A-晨光.SLDPRT
3-加工图纸/2-晨光（A型）/1-原厂方案/电机绕线骨架2-带接线头-A型.SLDPRT
3-加工图纸/2-晨光（A型）/3-方案三/前端盖A-晨光-设计-2021.4.16+圆周筋条-方案3.STEP
3-加工图纸/2-晨光（A型）/1-原厂方案/晨光方案3D图纸/吸尘器电机-晨光.dwg
3-加工图纸/2-晨光（A型）/1-原厂方案/电机绕线骨架1-A型.SLDPRT
3-加工图纸/2-晨光（A型）/3-方案三/电机绕线骨架2-带接线头-A型-方案3.STEP
3-加工图纸/2-晨光（A型）/7-定稿图纸/吸尘器电机2021.7.23/前端盖A-RT-自扣结构+改进-方案5.SLDPRT
3-加工图纸/2-晨光（A型）/2-方案二/前端盖A-晨光-设计-2021.4.16+圆周筋条.SLDPRT
3-加工图纸/2-晨光（A型）/3-方案三/风罩-塑料-方案3.STEP
3-加工图纸/2-晨光（A型）/1-原厂方案/晨光方案3D图纸/电机绕线骨架2-带接线头-A型-2021.3.25.SLDPRT
3-加工图纸/2-晨光（A型）/2-方案二/风罩-A型-加厚-塑料+导风槽.STEP
3-加工图纸/2-晨光（A型）/4-方案四/方案4-2021.5.20/后端盖-A型-晨光-测绘+圆周定位-方案3-方案4.SLDPRT
3-加工图纸/2-晨光（A型）/1-原厂方案/晨光方案3D图纸/M3螺母（厚）-A晨光.SLDPRT
3-加工图纸/2-晨光（A型）/2-方案二/前端风罩-A型-晨光-加厚-塑料+导风槽.SLDPRT
3-加工图纸/2-晨光（A型）/3-方案三/风罩-塑料-斜面-方案3.STEP
3-加工图纸/2-晨光（A型）/4-方案四/方案4-2021.5.20/前端风罩-塑料-方案3-方案4.SLDPRT
3-加工图纸/2-晨光（A型）/2-方案二/后端盖-A型-测绘+圆周定位.STEP
3-加工图纸/2-晨光（A型）/2-方案二/M3螺母（厚）-A晨光.SLDPRT
3-加工图纸/2-晨光（A型）/3-方案三/电机绕线骨架1-A型-方案3.STEP
3-加工图纸/2-晨光（A型）/1-原厂方案/晨光方案3D图纸/前端盖A-晨光-设计-2021.4.16.SLDPRT
3-加工图纸/1-冉工提供（C型）/3D打印/前端盖C（修改）.SLDPRT
3-加工图纸/2-晨光（A型）/1-原厂方案/前端风罩-A型-晨光-加厚-塑料.SLDPRT
3-加工图纸/2-晨光（A型）/1-原厂方案/后端盖-A型-晨光-测绘.SLDPRT
3-加工图纸/2-晨光（A型）/1-原厂方案/晨光方案3D图纸/前端风罩-A型-晨光-加厚-塑料.SLDPRT
3-加工图纸/2-晨光（A型）/1-原厂方案/风罩-A型-晨光.SLDPRT
3-加工图纸/2-晨光（A型）/2-方案二/前端风罩-A型-晨光-加厚-塑料.SLDPRT
3-加工图纸/2-晨光（A型）/2-方案二/轴A-晨光.SLDPRT
3-加工图纸/2-晨光（A型）/3-方案三/前端盖A-晨光-设计-2021.4.16+圆周筋条-方案3.SLDPRT
3-加工图纸/2-晨光（A型）/3-方案三/前端盖A-晨光-设计-2021.4.16+圆周筋条-风道倾角-5---方案3.SLDPRT
3-加工图纸/2-晨光（A型）/3-方案三/前端风罩-A型-晨光-加厚-塑料+导风槽-方案3.SLDPRT
3-加工图纸/2-晨光（A型）/3-方案三/前端风罩-塑料-斜面-方案3.SLDPRT
3-加工图纸/2-晨光（A型）/3-方案三/后端盖-A型-晨光-测绘+圆周定位-方案3.SLDPRT
3-加工图纸/2-晨光（A型）/3-方案三/电机定子铁芯-201500-A型-方案3.SLDPRT
3-加工图纸/2-晨光（A型）/3-方案三/电机绕线骨架1-A型-方案3.SLDPRT
3-加工图纸/2-晨光（A型）/3-方案三/电机绕线骨架2-带接线头-A型-方案3.SLDPRT
3-加工图纸/2-晨光（A型）/3-方案三/风罩-A型-加厚-塑料+导风槽-方案3.STEP
3-加工图纸/2-晨光（A型）/4-方案四/PPS打印/PPS打印/前端盖.STEP
3-加工图纸/2-晨光（A型）/4-方案四/PPS打印/PPS打印/后端盖.STEP
3-加工图纸/2-晨光（A型）/4-方案四/PPS打印/PPS打印/风罩.STEP
3-加工图纸/2-晨光（A型）/4-方案四/PPS打印/塑料模具报价/上骨架.SLDPRT
3-加工图纸/2-晨光（A型）/4-方案四/PPS打印/塑料模具报价/下骨架.SLDPRT
3-加工图纸/2-晨光（A型）/4-方案四/PPS打印/塑料模具报价/前端盖.SLDPRT
3-加工图纸/2-晨光（A型）/4-方案四/PPS打印/塑料模具报价/后端盖.SLDPRT
3-加工图纸/2-晨光（A型）/4-方案四/PPS打印/塑料模具报价/风罩.SLDPRT
3-加工图纸/2-晨光（A型）/4-方案四/方案4-2021.5.20/电机定子铁芯-201500-A型-方案3-方案4.DWG
3-加工图纸/2-晨光（A型）/4-方案四/波形垫圈5.6x8x0.15.SLDPRT
3-加工图纸/2-晨光（A型）/5-方案五/V26-方案5-2021.6.21-样板件/前端盖A-RT-自扣结构+改进-方案5.SLDPRT
3-加工图纸/2-晨光（A型）/5-方案五/V26-方案5-2021.6.21-样板件/前端风罩-塑料-斜面-RT--自扣结构-方案5.SLDPRT
3-加工图纸/2-晨光（A型）/5-方案五/V26-方案5-2021.6.21-样板件/吸尘器电机-RT/接线铜端子-晨光-2021.6.15-方案5.SLDPRT
3-加工图纸/2-晨光（A型）/5-方案五/V26-方案5-2021.6.21-样板件/吸尘器电机-RT/电机绕线骨架1-RT-方案5.SLDPRT
3-加工图纸/2-晨光（A型）/5-方案五/V26-方案5-2021.6.21-样板件/吸尘器电机-RT/电机绕线骨架2-带接线头-RT-方案5.SLDPRT
3-加工图纸/2-晨光（A型）/5-方案五/V26-方案5-2021.6.21-样板件/吸尘器电机-RT/装配体-电机定子-RT-方案5.SLDASM
3-加工图纸/2-晨光（A型）/5-方案五/V26-方案5-2021.6.21-样板件/方案4-2021.5.20/后端盖-A型-晨光-测绘+圆周定位-方案3-方案4-方案5.SLDPRT
3-加工图纸/2-晨光（A型）/5-方案五/V26-方案5-2021.6.21-样板件/方案4-2021.5.20/磁环A-晨光-方案3-方案4-方案5.SLDPRT
3-加工图纸/2-晨光（A型）/5-方案五/V26-方案5-2021.6.21-样板件/方案4-2021.5.20/轴A-晨光-方案3-方案4-方案5.SLDPRT
3-加工图纸/2-晨光（A型）/5-方案五/V26-方案5-2021.6.21-样板件/装配体-吸尘器电机-RT-改进-2021.6.15-方案5.SLDASM
3-加工图纸/2-晨光（A型）/5-方案五/V26-方案5-2021.6.21/前端盖A-RT-自扣结构+改进-方案5.SLDPRT
3-加工图纸/2-晨光（A型）/5-方案五/V26-方案5-2021.6.21/前端风罩-塑料-斜面-RT--自扣结构-方案5.SLDPRT
3-加工图纸/2-晨光（A型）/5-方案五/V26-方案5-2021.6.21/吸尘器电机-RT/接线铜端子-晨光-2021.6.15-方案5.SLDPRT
3-加工图纸/2-晨光（A型）/5-方案五/V26-方案5-2021.6.21/吸尘器电机-RT/电机绕线骨架1-RT-方案5.SLDPRT
3-加工图纸/2-晨光（A型）/5-方案五/V26-方案5-2021.6.21/吸尘器电机-RT/电机绕线骨架2-带接线头-RT-方案5.SLDPRT
3-加工图纸/2-晨光（A型）/5-方案五/V26-方案5-2021.6.21/吸尘器电机-RT/装配体-电机定子-RT-方案5.SLDASM
3-加工图纸/2-晨光（A型）/5-方案五/V26-方案5-2021.6.21/方案4-2021.5.20/后端盖-A型-晨光-测绘+圆周定位-方案3-方案4-方案5.SLDPRT
3-加工图纸/2-晨光（A型）/5-方案五/V26-方案5-2021.6.21/方案4-2021.5.20/磁环A-晨光-方案3-方案4-方案5.SLDPRT
3-加工图纸/2-晨光（A型）/5-方案五/V26-方案5-2021.6.21/方案4-2021.5.20/轴A-晨光-方案3-方案4-方案5.SLDPRT
3-加工图纸/2-晨光（A型）/5-方案五/V26-方案5-2021.6.21/装配体-吸尘器电机-RT-改进-2021.6.15-方案5.SLDASM
3-加工图纸/2-晨光（A型）/6-方案六/01/前端盖A-RT-自扣结构+改进-方案5.SLDPRT
3-加工图纸/2-晨光（A型）/6-方案六/01/前端风罩-塑料-斜面-RT--自扣结构-方案5.SLDPRT
3-加工图纸/2-晨光（A型）/6-方案六/01/定子组件/电机定子铁芯-RT-方案5.SLDPRT
3-加工图纸/2-晨光（A型）/6-方案六/01/定子组件/电机绕线骨架1-RT-方案5.SLDPRT
3-加工图纸/2-晨光（A型）/6-方案六/01/定子组件/电机绕线骨架2-带接线头-RT-方案5.SLDPRT
3-加工图纸/2-晨光（A型）/6-方案六/01/装配体-吸尘器电机-RT-改进-2021.6.15-方案5.SLDASM
3-加工图纸/2-晨光（A型）/7-定稿图纸/吸尘器电机2021.7.23/M3螺母（厚）-RT-方案5.SLDPRT
3-加工图纸/2-晨光（A型）/7-定稿图纸/吸尘器电机2021.7.23/T型垫柱A-RT-方案5.SLDPRT
3-加工图纸/2-晨光（A型）/7-定稿图纸/吸尘器电机2021.7.23/叶片-1-RT-方案5.SLDPRT
3-加工图纸/2-晨光（A型）/7-定稿图纸/吸尘器电机2021.7.23/圆垫片3x15x1-RT-方案5.SLDPRT
3-加工图纸/2-晨光（A型）/7-定稿图纸/吸尘器电机2021.7.23/密封棉-RT-方案5.SLDPRT
3-加工图纸/2-晨光（A型）/7-定稿图纸/吸尘器电机2021.7.23/波形垫圈5.6x8x0.15-方案5.SLDPRT
3-加工图纸/2-晨光（A型）/7-定稿图纸/吸尘器电机2021.7.23/电机定子铁芯-RT-方案5.SLDPRT
3-加工图纸/2-晨光（A型）/7-定稿图纸/吸尘器电机2021.7.23/电机绕线骨架1-RT-方案5.SLDPRT
3-加工图纸/2-晨光（A型）/7-定稿图纸/吸尘器电机2021.7.23/电机绕线骨架2-带接线头-RT-方案5.SLDPRT
3-加工图纸/2-晨光（A型）/7-定稿图纸/吸尘器电机2021.7.23/轴承3x8x4-晨光-方案3-方案4-方案5.SLDPRT
3-加工图纸/2-晨光（A型）/7-定稿图纸/吸尘器电机2021.7.23/风叶轮-1-RT-方案5.SLDPRT
3-加工图纸/2-晨光（A型）/7-定稿图纸/吸尘器电机2021.7.23/风叶轮-2-RT-方案5.SLDPRT
3-加工图纸/3-戈雷姆（B型）/后端盖-B型-测绘-戈雷姆.SLDPRT
3-加工图纸/3-戈雷姆（B型）/风罩-戈雷姆-B型.SLDPRT
5-其他/4-行业参考/3-其他图纸/超音速/8666B40003 定子冲片.dwg
5-其他/4-行业参考/3-其他图纸/超音速/8666B40004 定子冲片.dwg
5-其他/4-行业参考/3-其他图纸/超音速/8668B40003 定子铁芯组件.dwg
5-其他/4-行业参考/3-其他图纸/超音速/8668B40004 定子铁芯组件.dwg
