nbruite/vacuum/3-加工图纸/2-晨光（A型）/5-方案五/V26定子绕线图.pdf

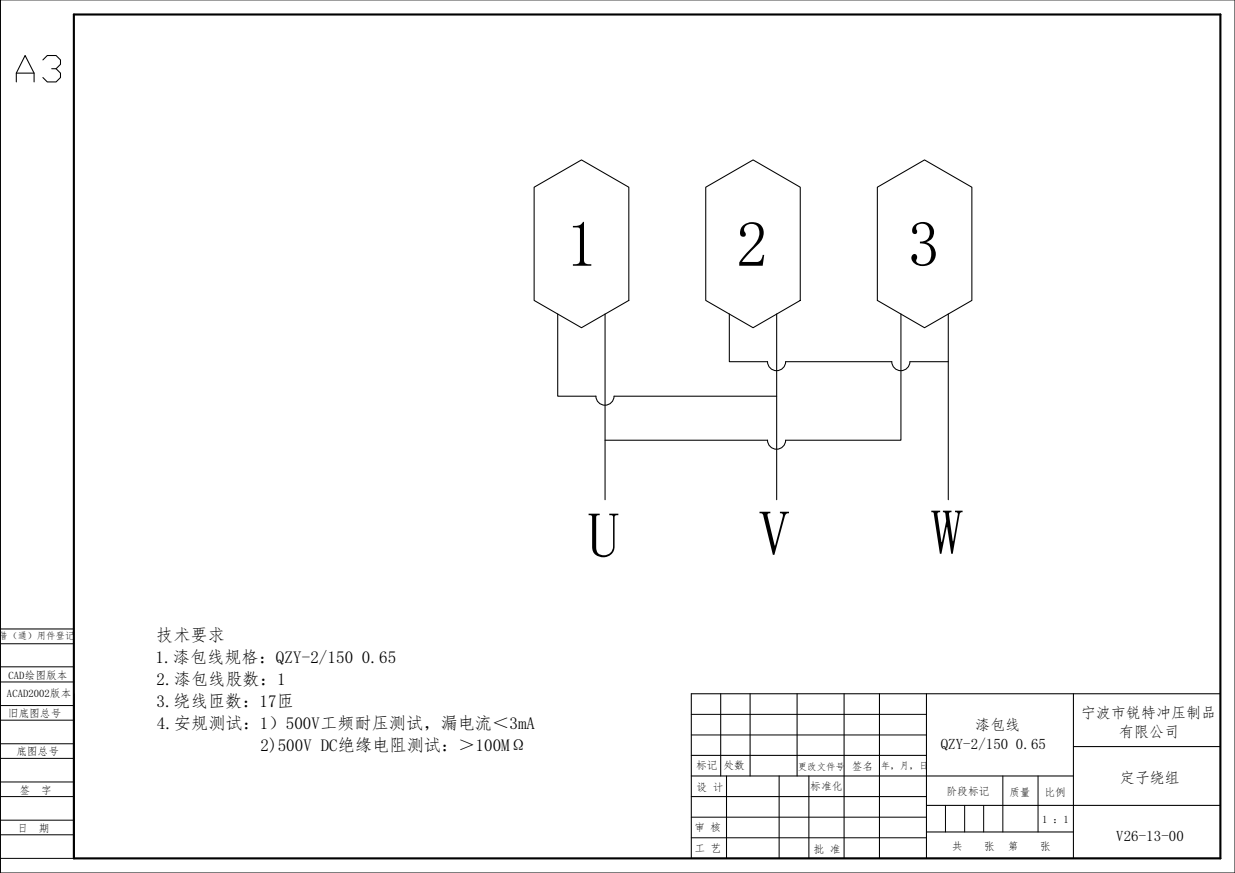
[picture p211: page 1]
1.漆包线规格：QZY-2/150 0.65; 2)500V DC绝缘电阻测试：＞100MΩ; 阶段标记; V26-13-00 宁波市锐特冲压制品 有限公司 1; W 漆包线 QZY-2/150 0.65

标记 | 处数 | 更改文件号 签名 | 年，月，日
设 计 | | 标准化
