nbruite/vacuum/4-电机测试/项目时间轴.pdf

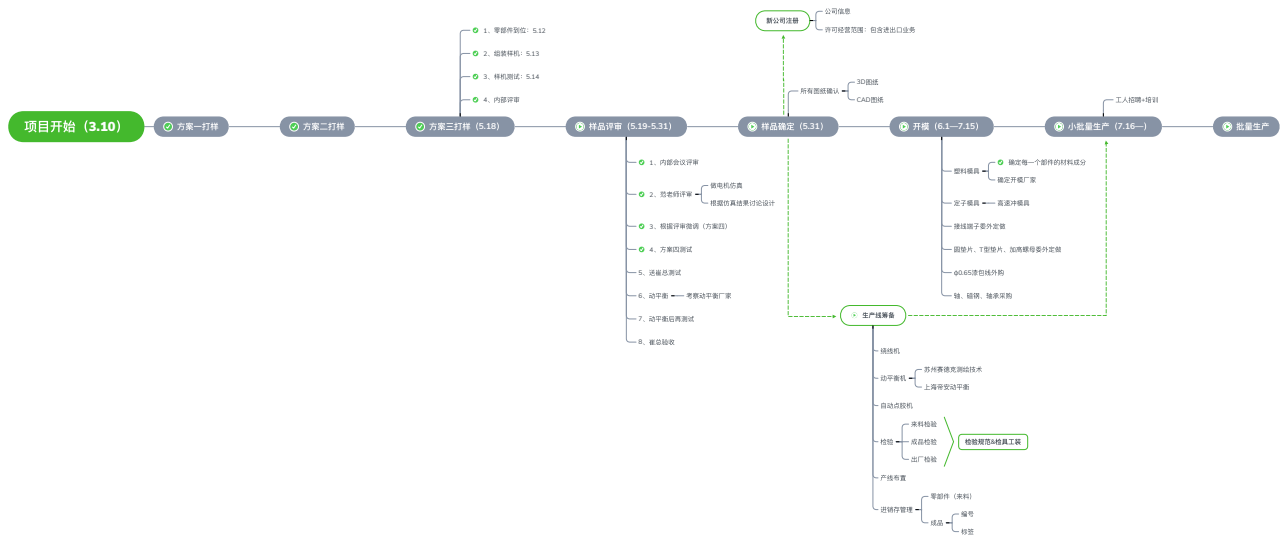
[picture p212: page 1]
项目开始（3.10）; 方案一打样; 方案二打样; 方案三打样（5.18）; 1、零部件到位：5.12; 2、组装样机：5.13; 3、样机测试：5.14; 4、内部评审; 样品评审（5.19-5.31）; 1、内部会议评审; 2、范老师评审; 做电机仿真; 根据仿真结果讨论设计; 3、根据评审微调（方案四）; 4、方案四测试; 5、送崔总测试; 6、动平衡; 考察动平衡厂家; 7、动平衡后再测试; 8、崔总验收; 样品确定（5.31）; 所有图纸确认; 3D图纸; CAD图纸; 塑料模具; 确定每一个部件的材料成分; 确定开模厂家; 定子模具; 高速冲模具; 接线端子委外定做; φ0.65漆包线外购; 轴、磁钢、轴承采购; 小批量生产（7.16—）; 工人招聘+培训; 批量生产; 生产线筹备; 绕线机; 动平衡机; 苏州赛德克测绘技术; 上海帝安动平衡; 自动点胶机; 来料检验; 成品检验; 出厂检验; 检验规范&检具工装; 产线布置; 进销存管理; 零部件（来料）; 新公司注册; 公司信息; 许可经营范围：包含进出口业务

圆垫片、T型垫片、加高螺母委外定做
