nbruite/vacuum/2-采购合同/动叶轮/C11382100DKCZ图纸.pdf

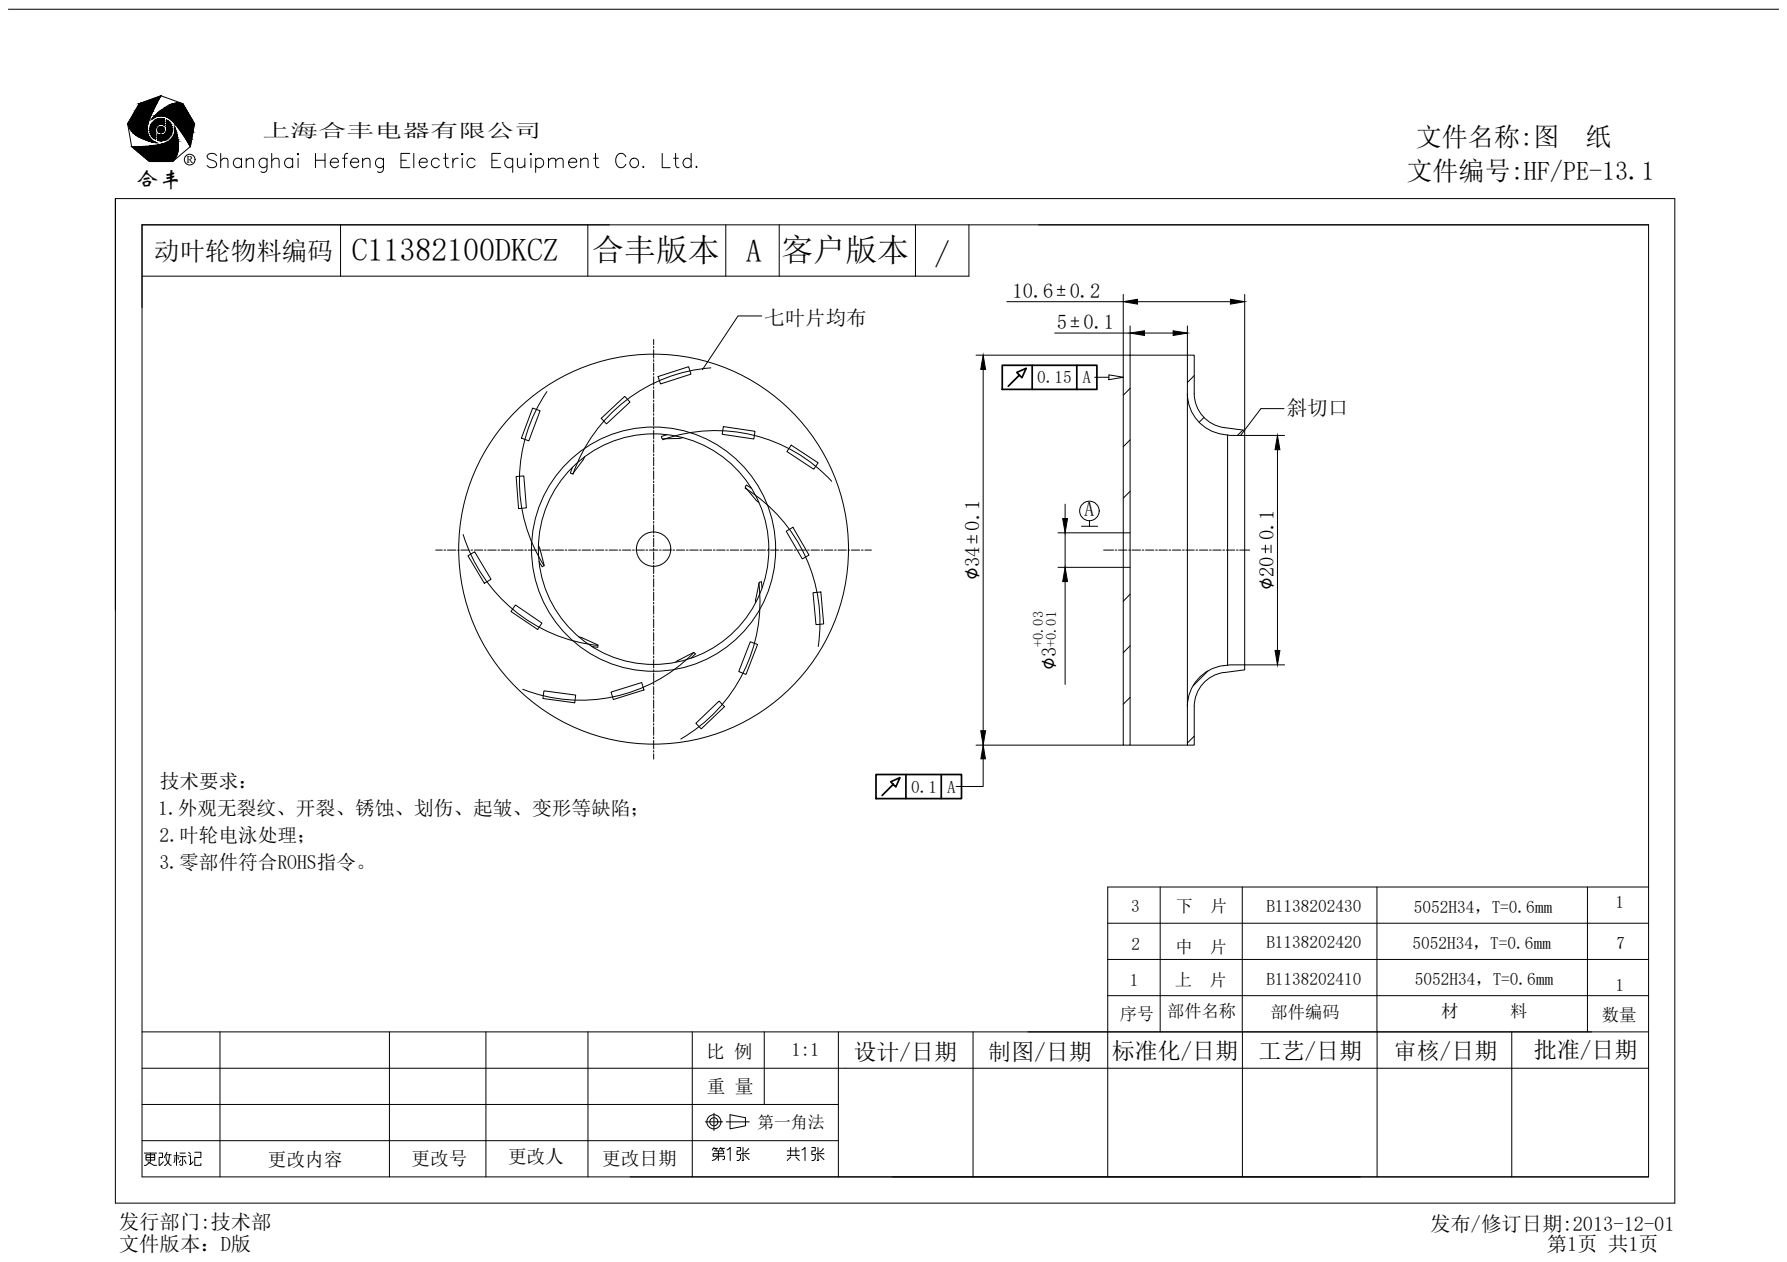
[picture p213: page 1]
技术要求： 1.外观无裂纹、开裂、锈蚀、划伤、起皱、变形等缺陷； 2.叶轮电泳处理； 3.零部件符合ROHS指令。; 标准化/日期; 工艺/日期 第一角法 合丰版本; A 更改人; 批准/日期 C11382100DKCZ; 5052H34，T=0.6mm第1页 共1页 发布/修订日期:2013-12-01 文件名称:图 纸 R 合丰; 上海合丰电器有限公司 发行部门:技术部 文件版本：D版 动叶轮物料编码; 部件名称; 部件编码; 数量 更改内容; 更改号; 更改日期; 文件编号:HF/PE-13.1 客户版本; A 七叶片均布; B1138202420 B1138202430 斜切口 0.15
