nbruite/vacuum/3-加工图纸/2-晨光（A型）/7-定稿图纸/电路板外观尺寸图纸.pdf

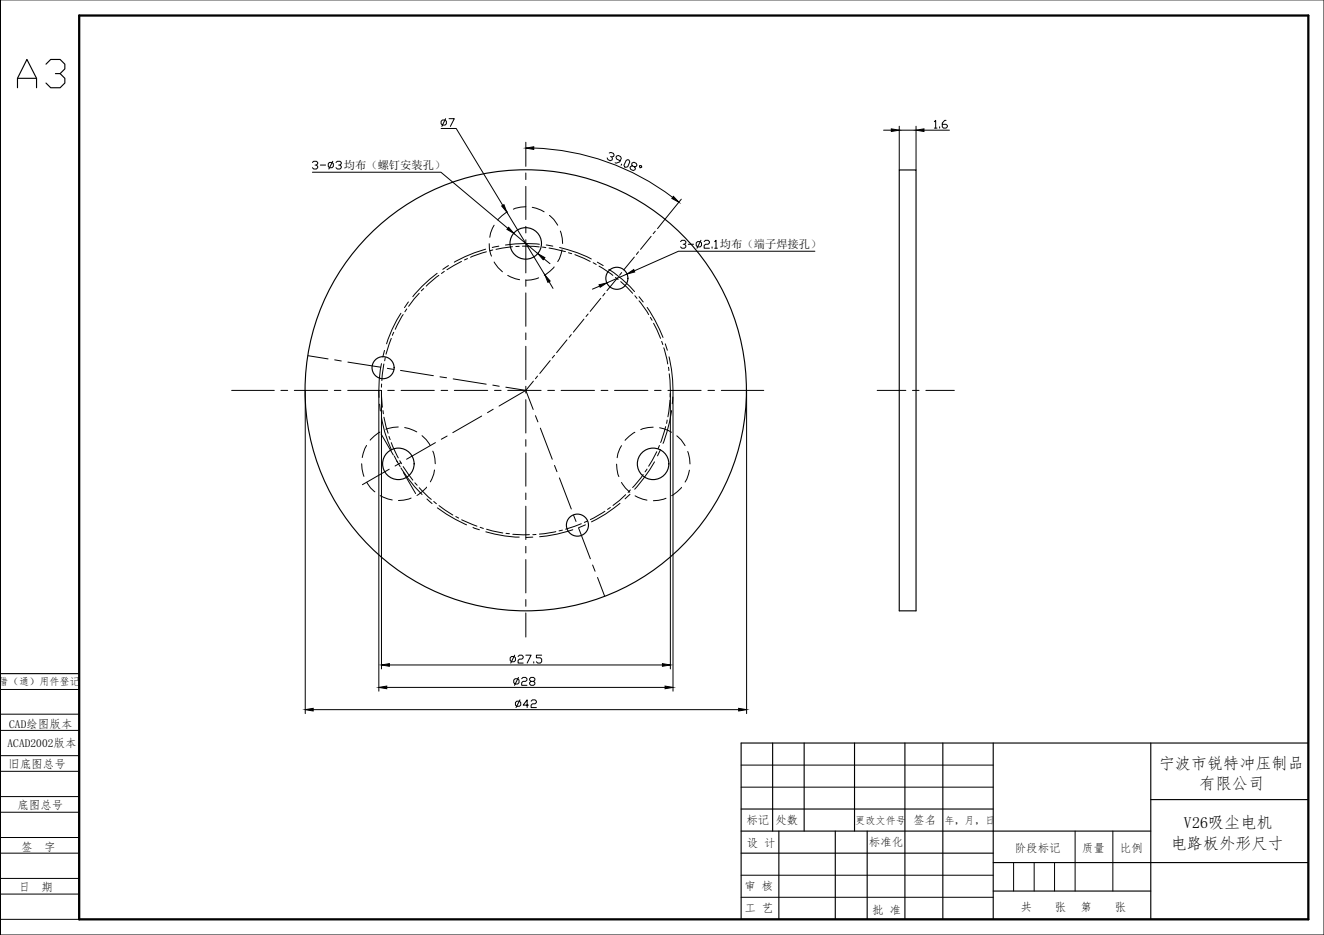
[picture p214: page 1]
标准化; 更改文件号 签名
