nbruite/vacuum/3-加工图纸/2-晨光（A型）/7-定稿图纸/轴.pdf

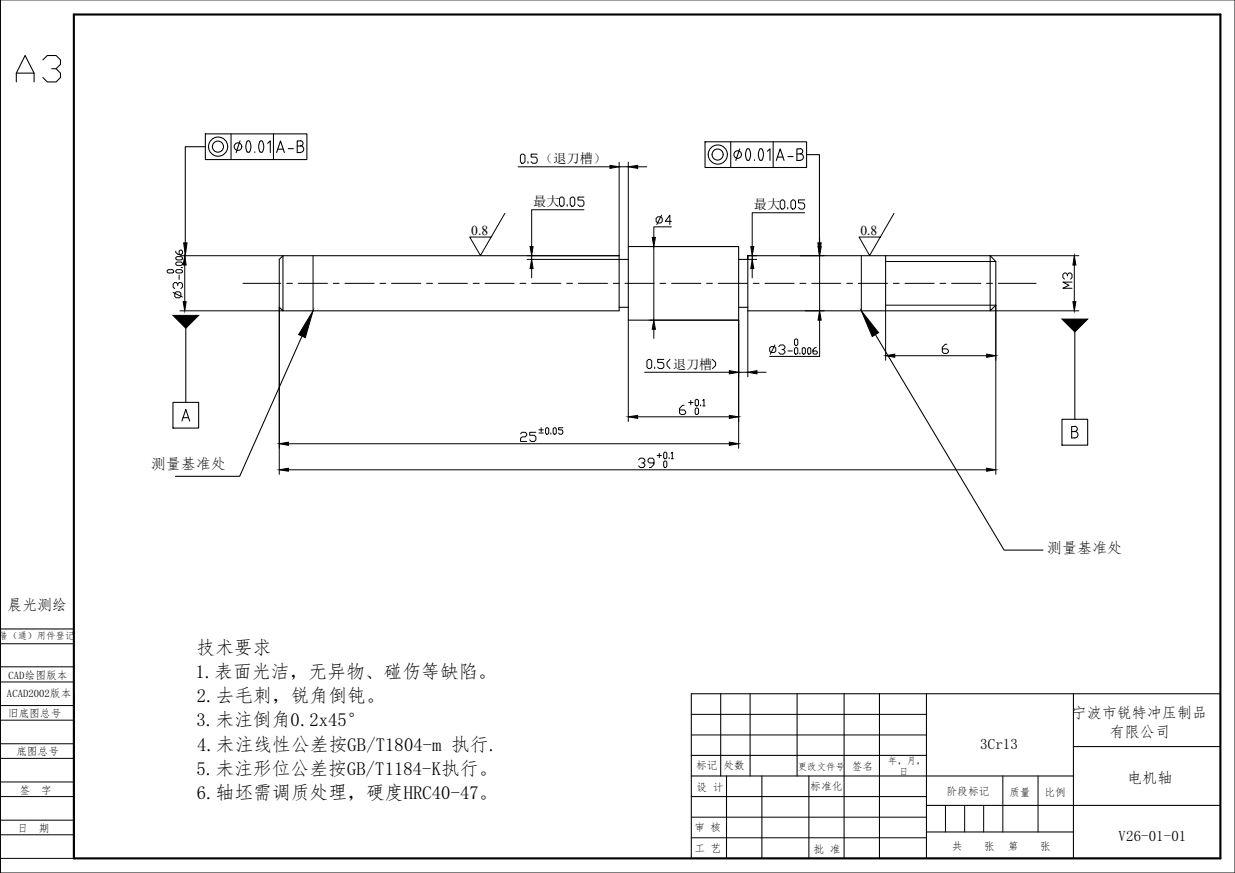
[picture p215: page 1]
电机轴 3Cr13 阶段标记; 有限公司 0.8; 0.8 退刀槽; 晨光测绘; V26-01-01 （退刀槽） 最大 测量基准处; 测量基准处

技术要求
1.表面光洁，无异物、碰伤等缺陷。
2.去毛刺，锐角倒钝。
3.未注倒角0.2x45°
4.未注线性公差按GB/T1804-m 执行.
5.未注形位公差按GB/T1184-K执行。
6.轴坯需调质处理，硬度HRC40-47。

标记 | 处数 | 更改文件号 签名 | 年，月， 日

设 计 | | 标准化
