nbruite/vacuum/3-加工图纸/2-晨光（A型）/5-方案五/V26电机定子.pdf

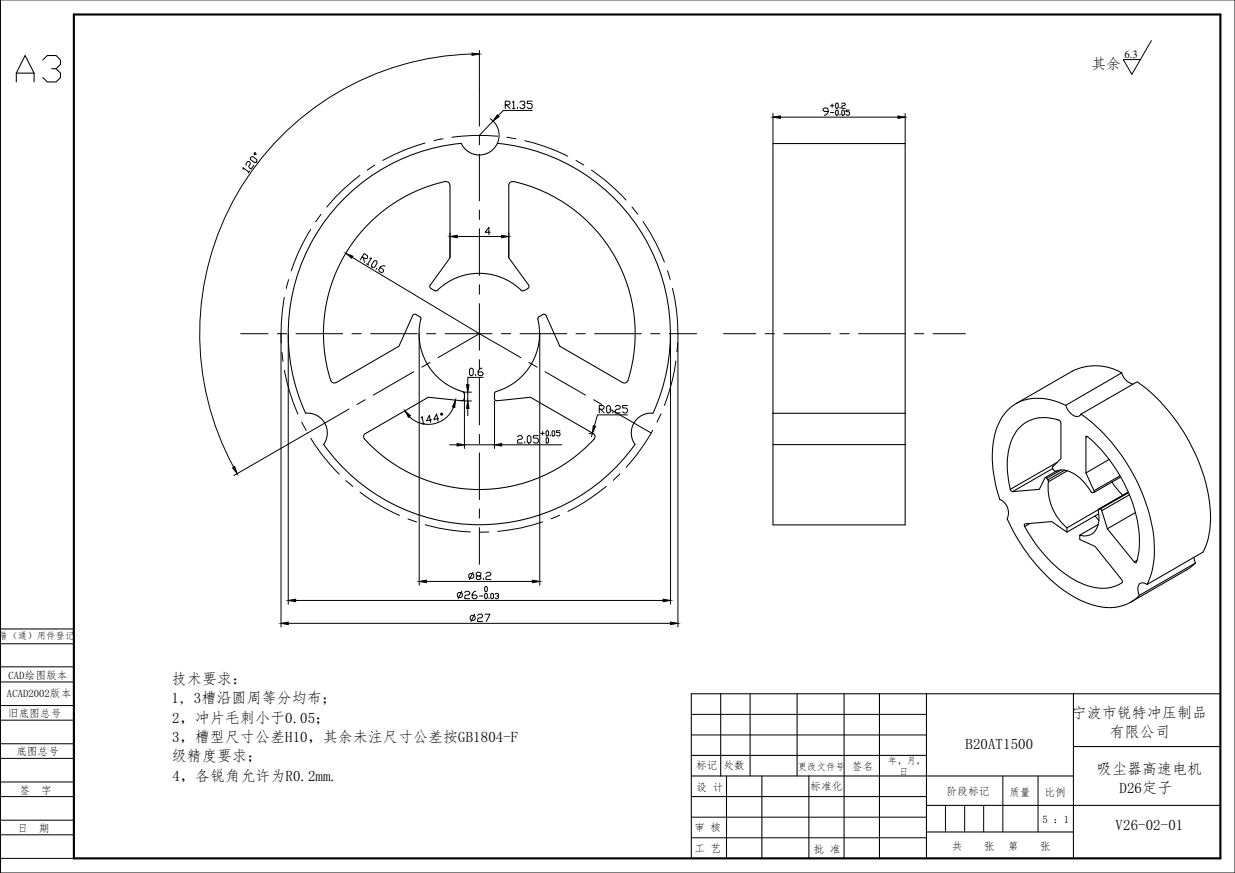
[picture p216: page 1]
D26定子 B20AT1500 阶段标记; 1, 3槽沿圆周等分均布；

标记 | 处数 | 更改文件号 签名 | 日
设 计 | | 标准化
