nbruite/vacuum/3-加工图纸/1-冉工提供（C型）/工装/前轴承压装工装 .pdf

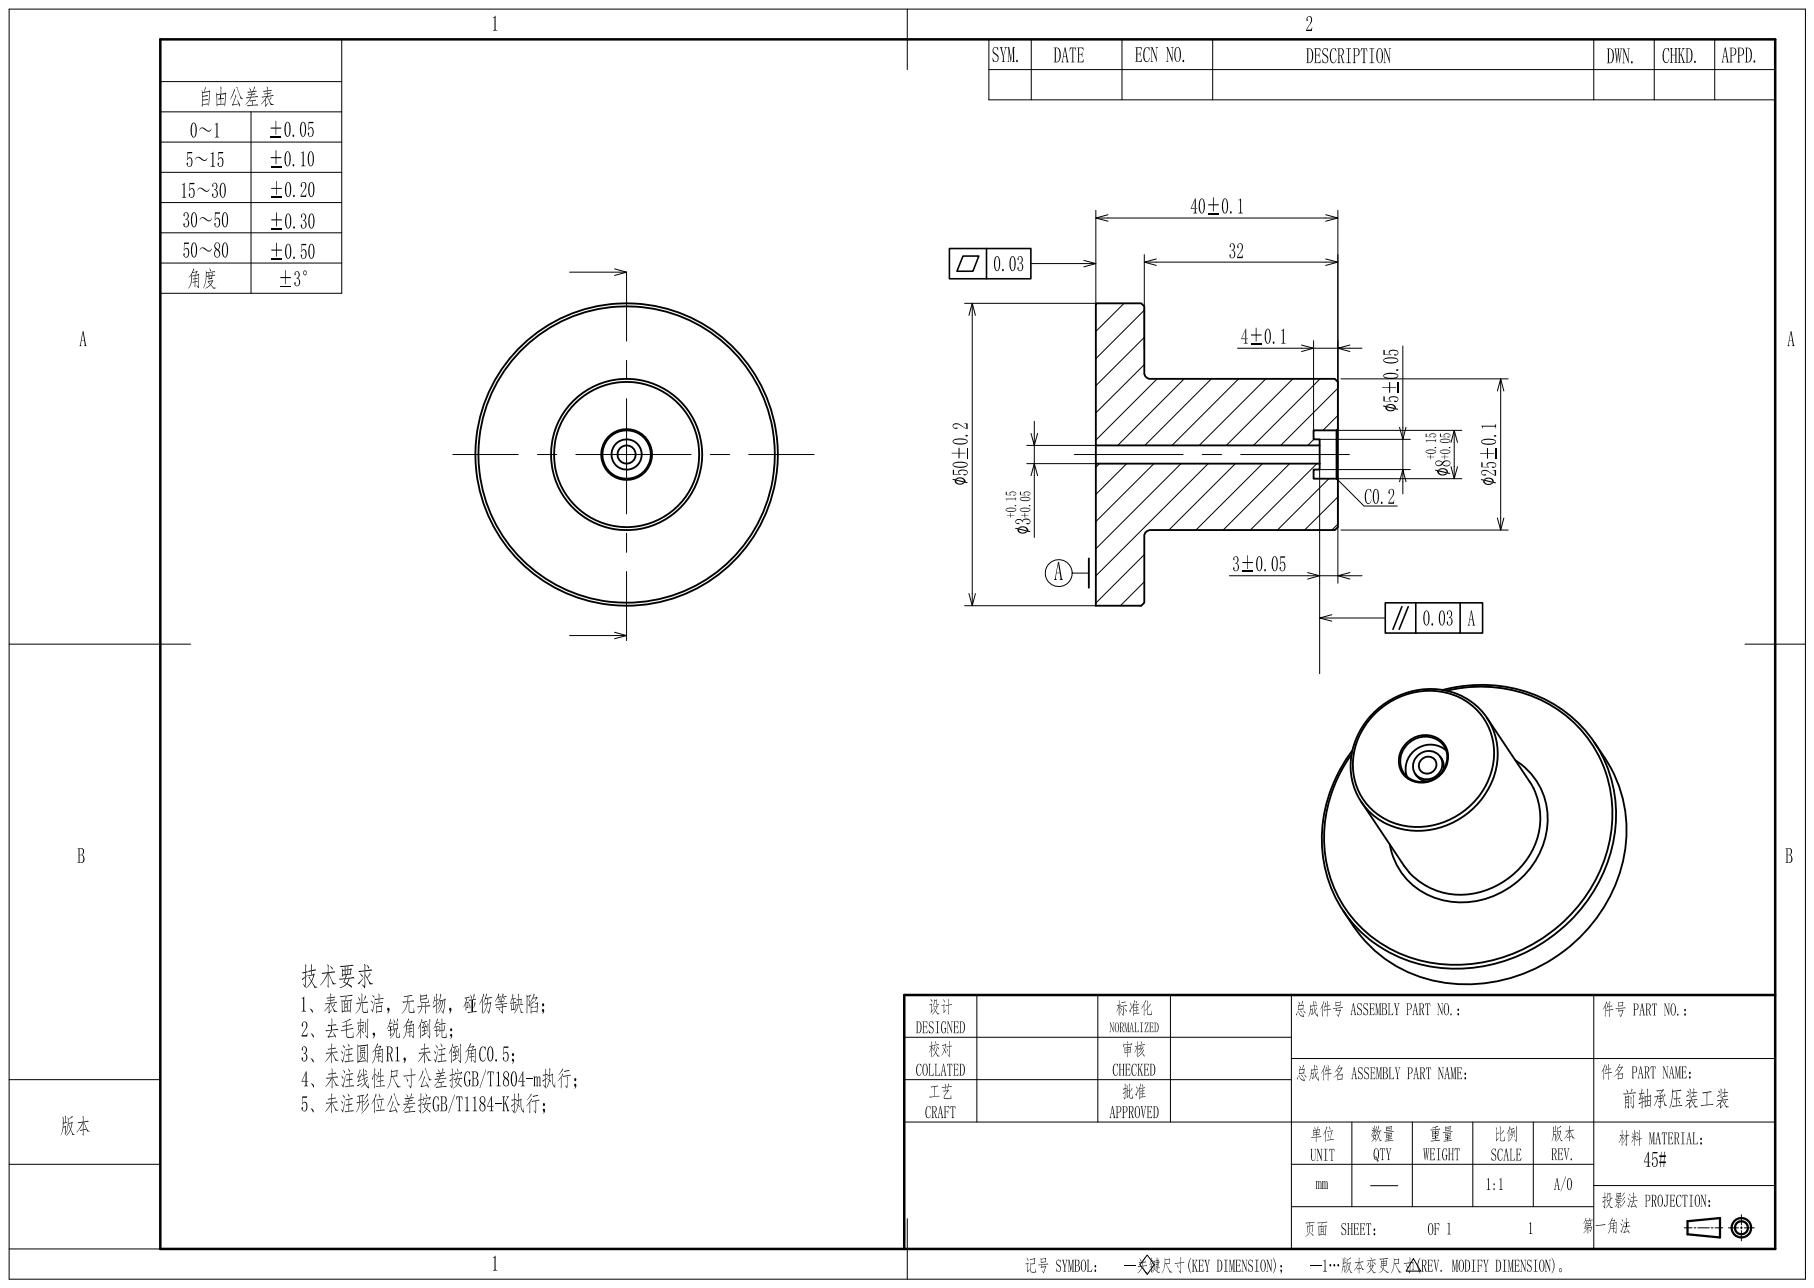
[picture p217: page 1]
