nbruite/vacuum/3-加工图纸/2-晨光（A型）/1-原厂方案/T型垫片.pdf

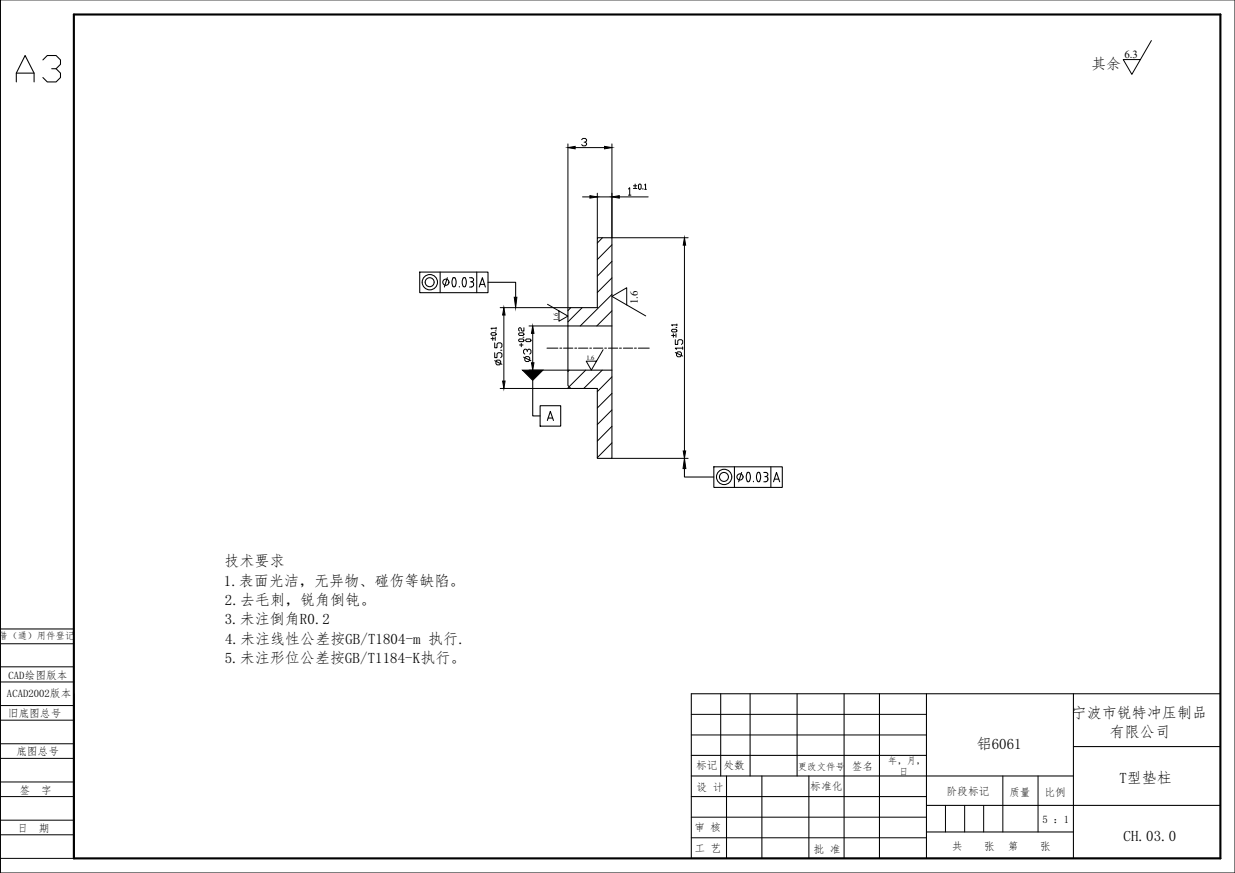
[picture p218: page 1]
阶段标记; CH.03.0 宁波市锐特冲压制品 有限公司 1.6

技术要求
1.表面光洁，无异物、碰伤等缺陷。
2.去毛刺，锐角倒钝。
3.未注倒角R0.2
4.未注线性公差按GB/T1804-m 执行.
5.未注形位公差按GB/T1184-K执行。

标记 | 处数 | 更改文件号 签名 | 日
设 计 | | 标准化
