nbruite/vacuum/3-加工图纸/1-冉工提供（C型）/机加工/M3螺母（厚).pdf

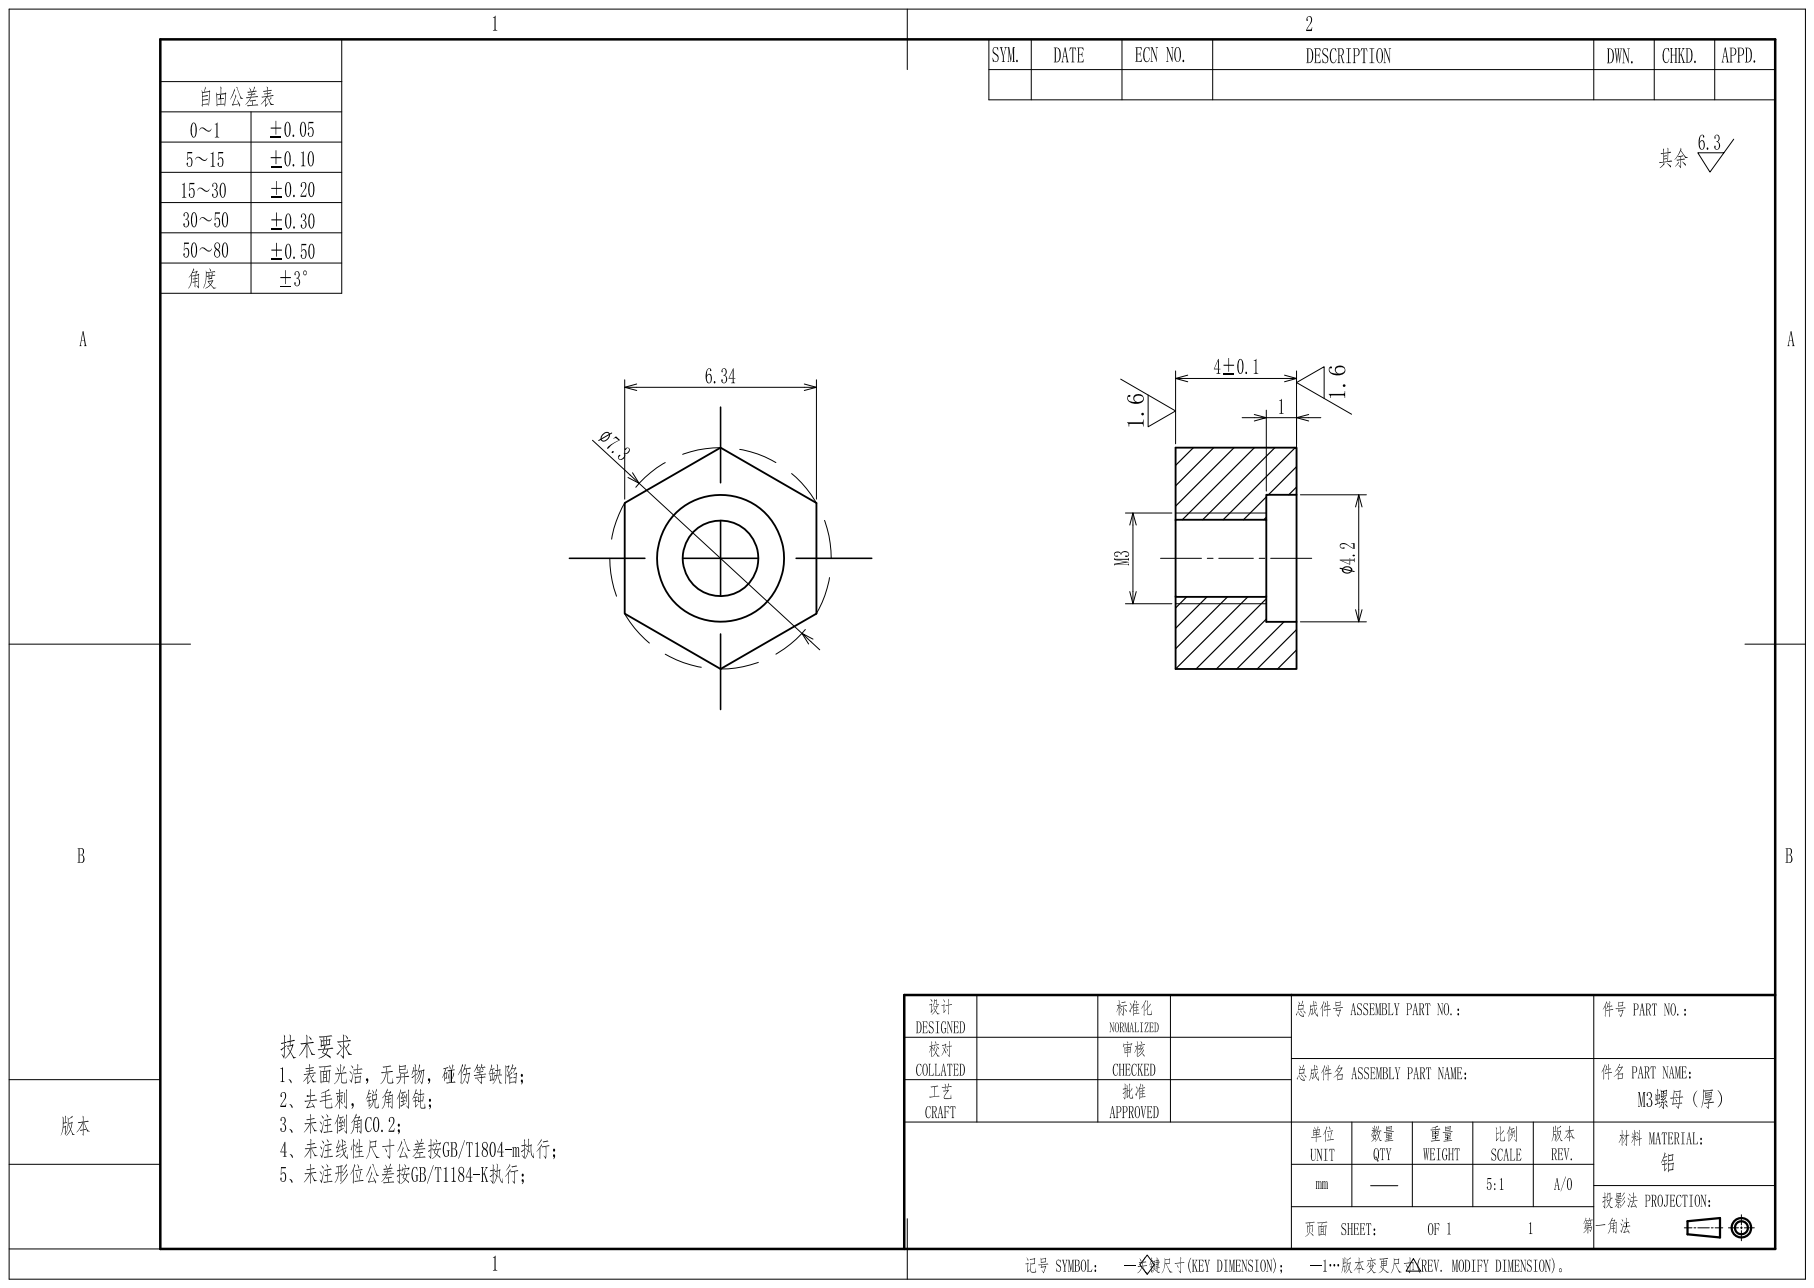
[picture p219: page 1]
