nbruite/vacuum/3-加工图纸/2-晨光（A型）/4-方案四/铜端子.pdf

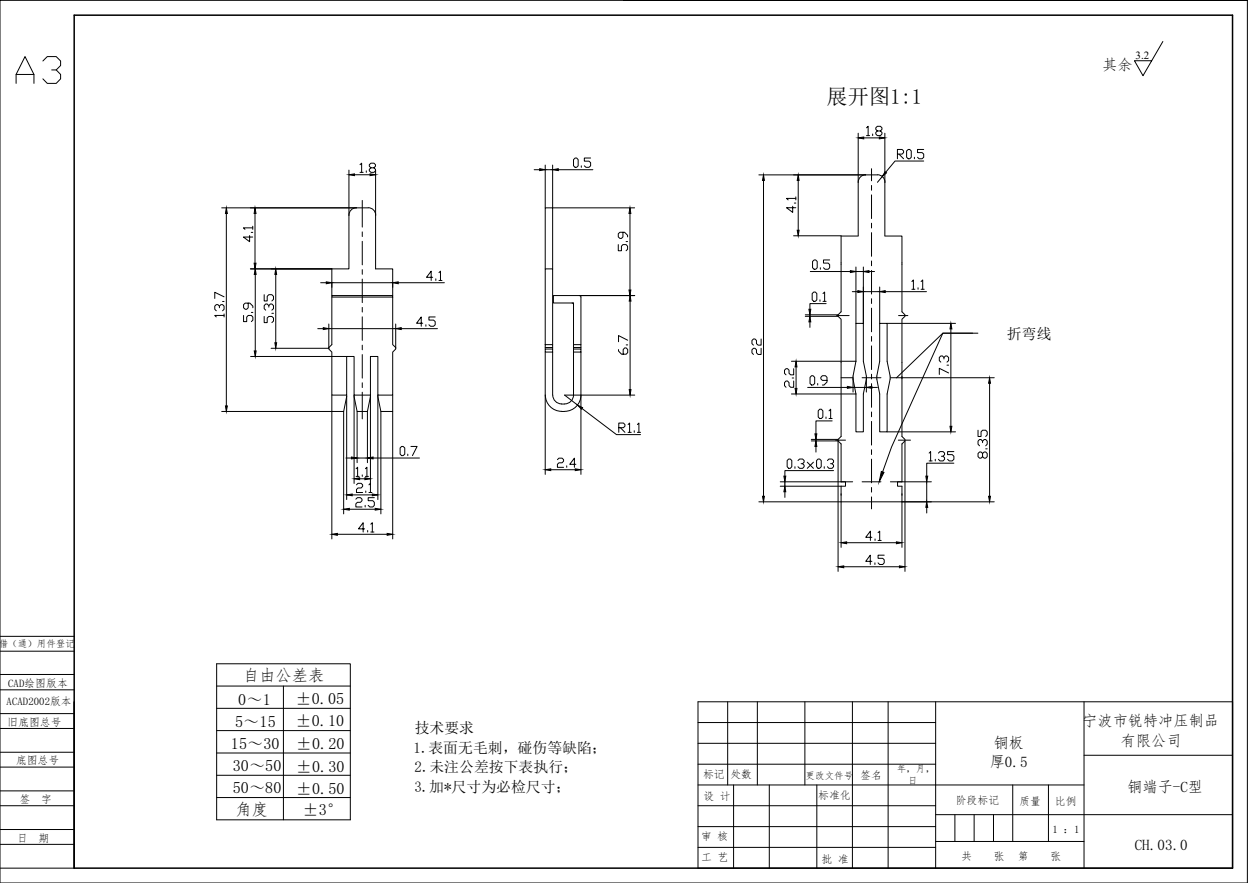
[picture p220: page 1]

0～1 | ±0.05
5～15 | ±0.10
15～30 | ±0.20

宁波市锐特冲压制品 铜板 厚0.5 | 有限公司

标记 | 处数 | 更改文件号 签名 | 年，月， 日

50～80 | ±0.50
角度 | ±3°

设 计 | | 标准化 | | 阶段标记 | 质量 | 比例
