nbruite/vacuum/3-加工图纸/2-晨光（A型）/4-方案四/26外径4极身宽度-定子.pdf

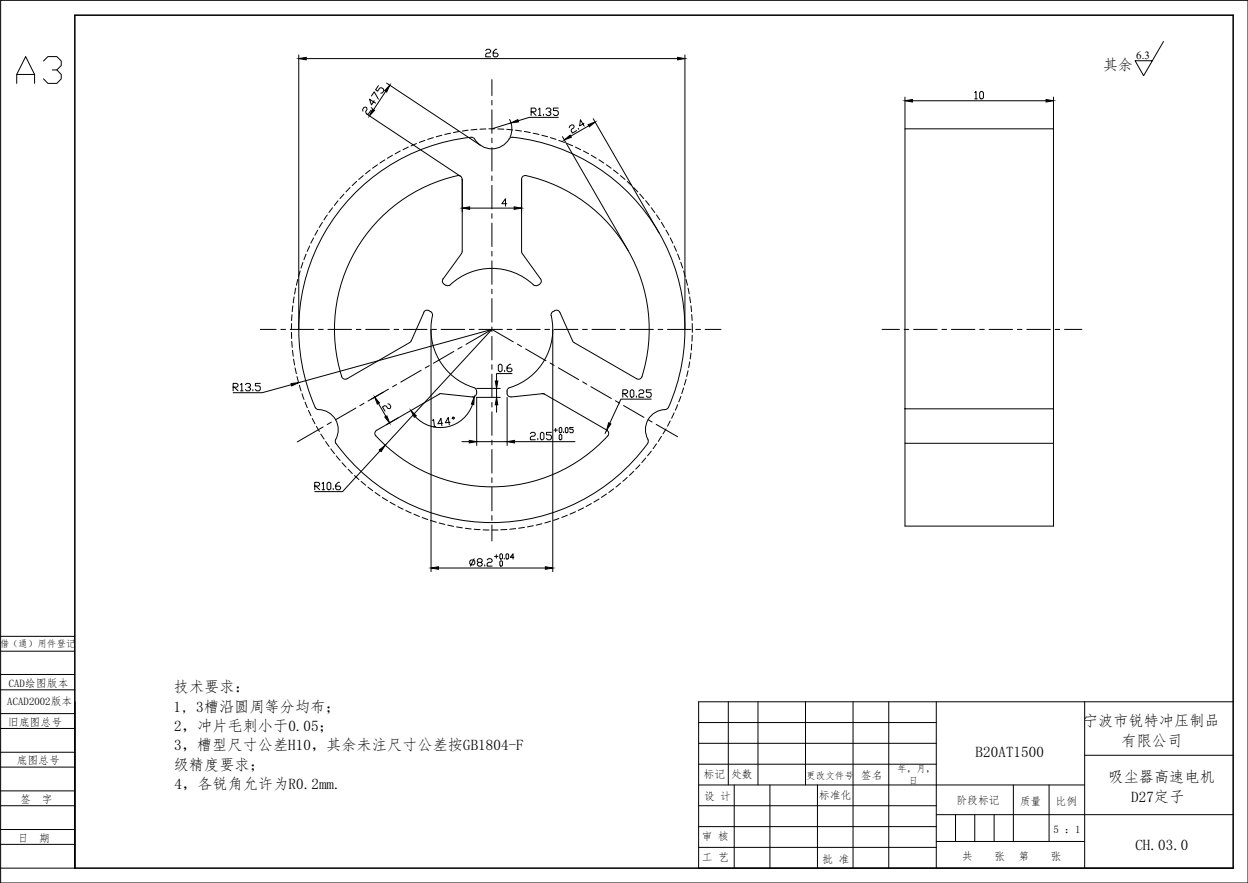
[picture p221: page 1]
D27定子 B20AT1500 阶段标记; CH.03.0 宁波市锐特冲压制品 有限公司; 1, 3槽沿圆周等分均布；

标记 | 处数 | 更改文件号 签名 | 日

设 计 | | 标准化
