nbruite/vacuum/3-加工图纸/1-冉工提供（C型）/工装/绕组 .pdf

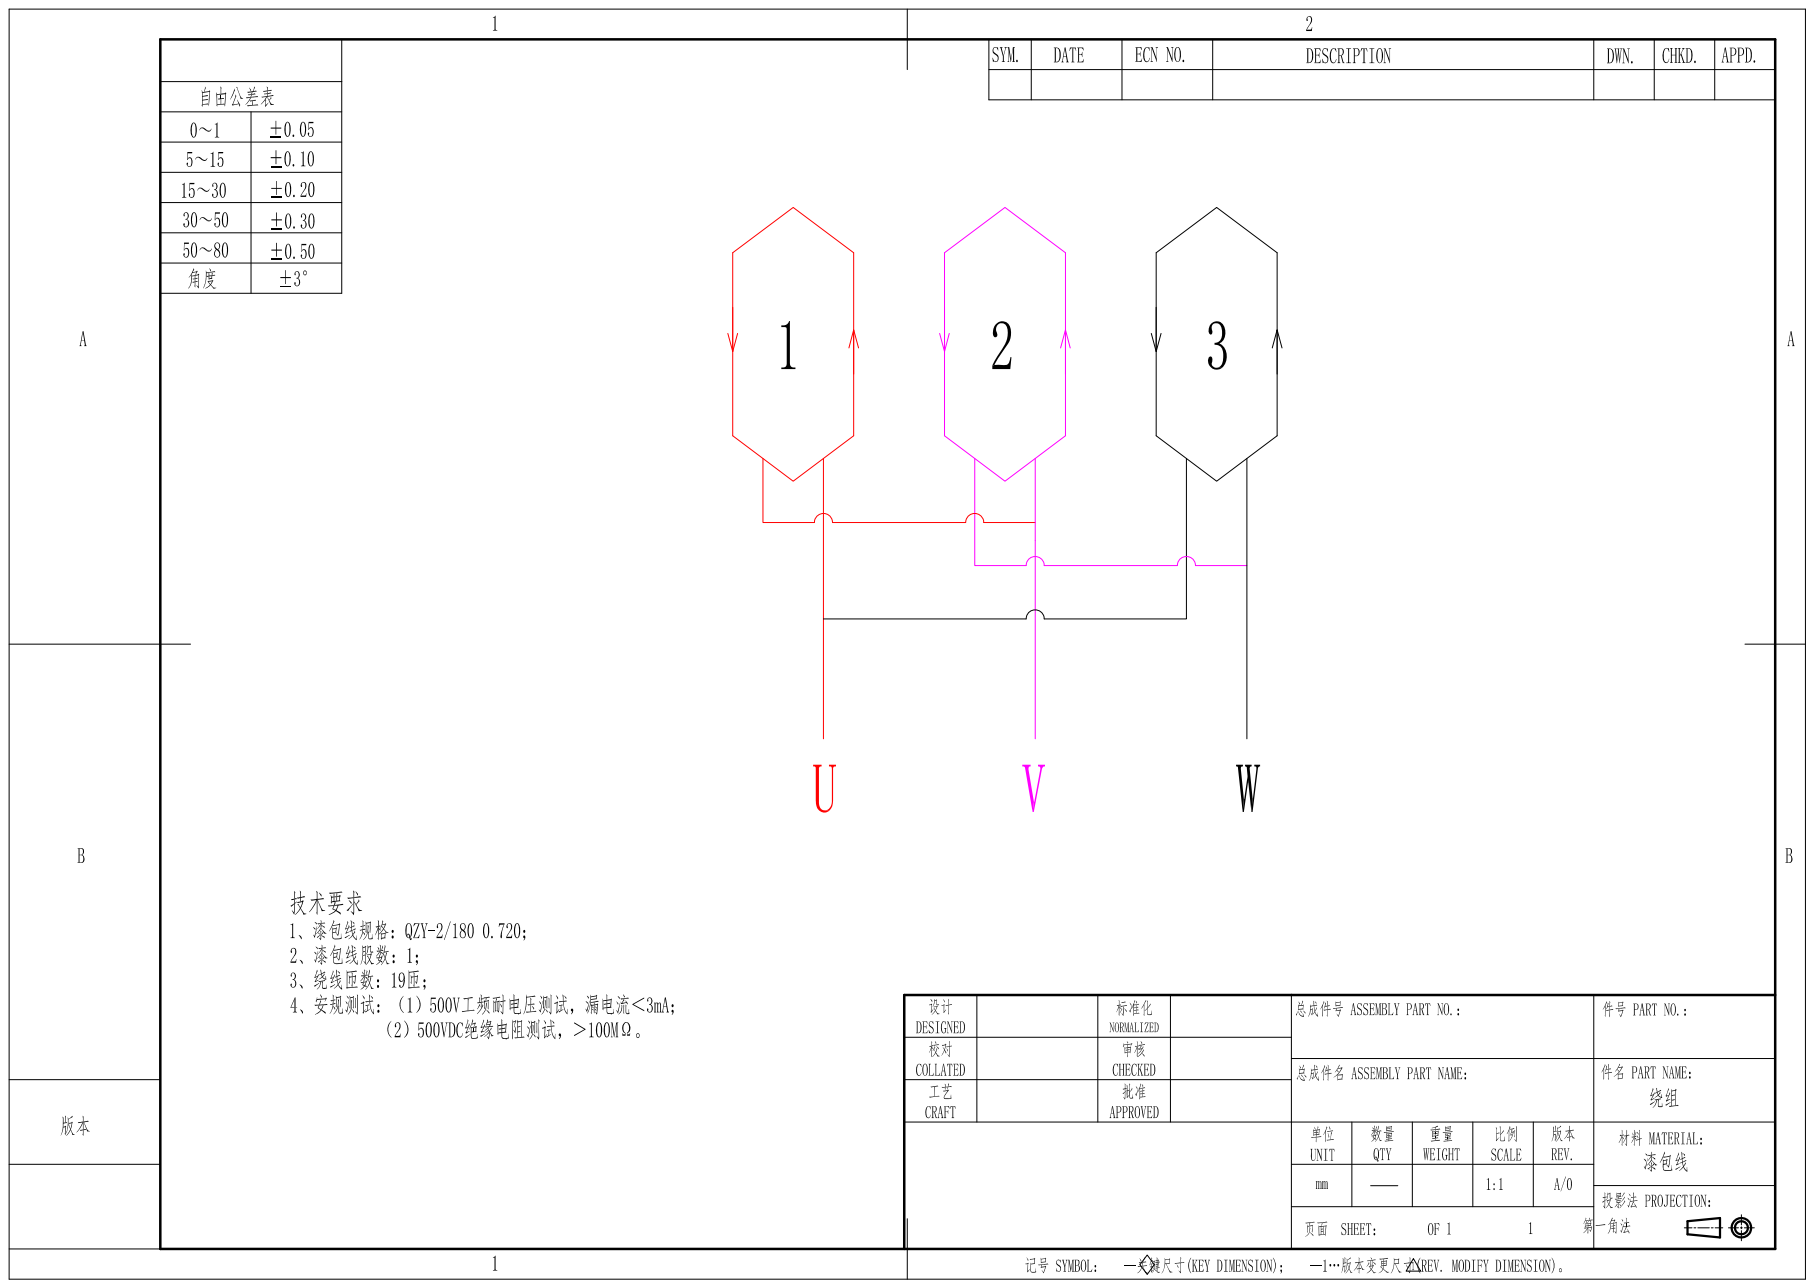
[picture p222: page 1]
