nbruite/vacuum/3-加工图纸/2-晨光（A型）/8-其他/φ26.8定子.pdf

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

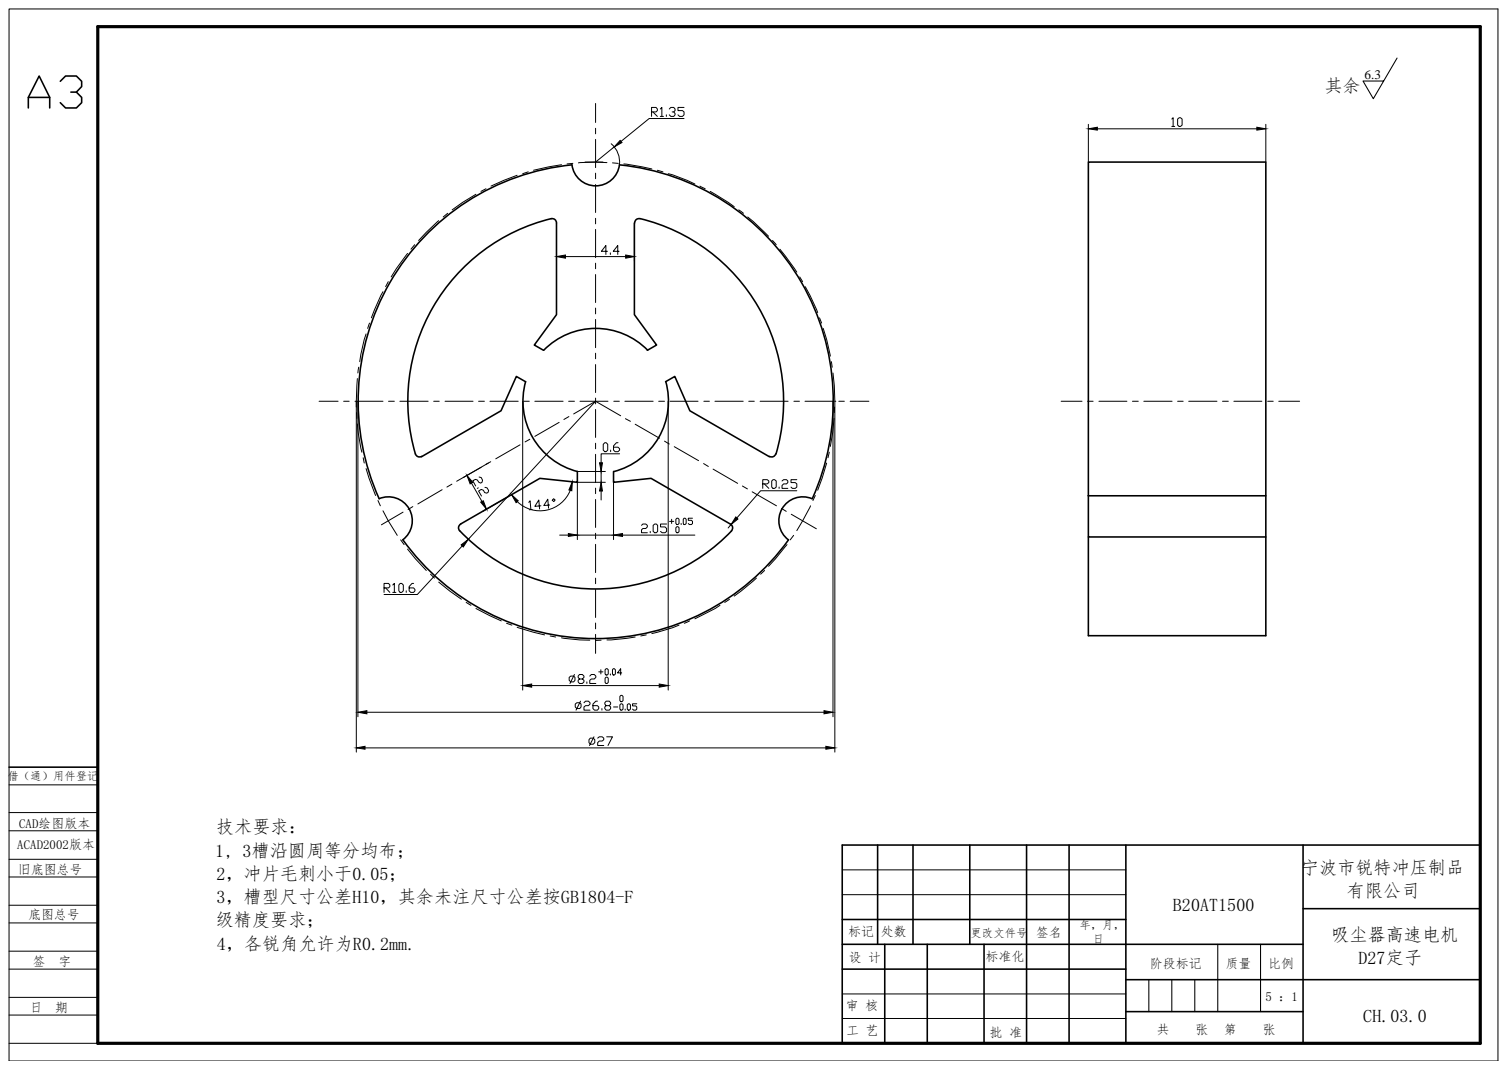
[picture p223: page 1]
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
