nbruite/vacuum/3-加工图纸/1-冉工提供（C型）/机加工/轴（原图纸）.pdf

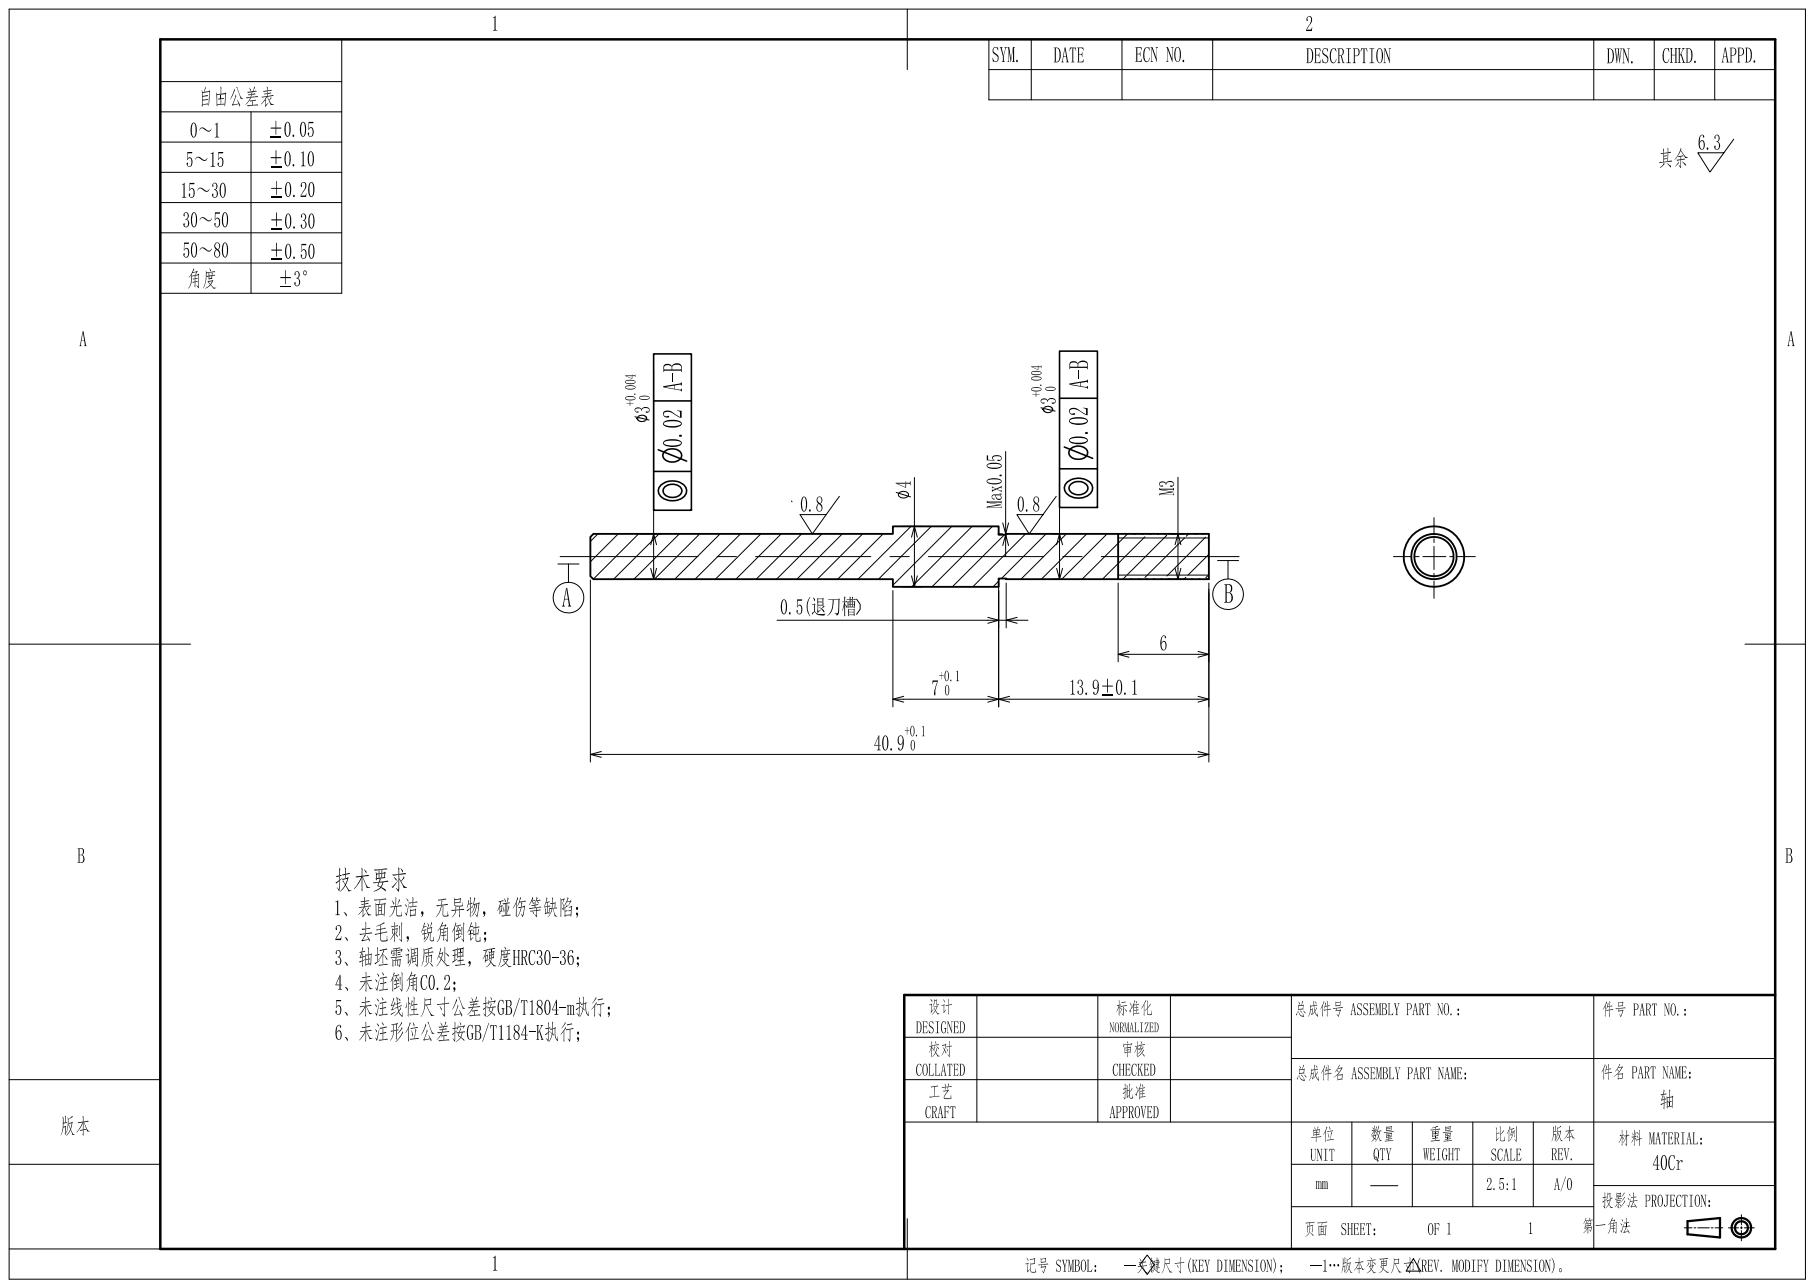
[picture p224: page 1]
