nbruite/vacuum/(commit log)

2021-03-11 创建初始文件归档
    [上骨架.STEP, 下骨架.STEP, 前端盖.STEP, 后端盖.STEP, 定子铁芯.dwg, 铜端子.dwg, 零件加工清单.xlsx, 风罩.STEP]
2021-03-11 1.修改excel为样品阶段；2.新增完成进度；3.删去不用的列
2021-03-11 3.11日进展更新
2021-03-11 更新3.11的问题与困难
2021-03-11 rename 进展文件
2021-03-12 增加工装图纸
2021-03-12 更新3.12日进展
2021-03-15 3.15进展更新
    [前端盖C.STEP]
2021-03-16 3.16进展更新
2021-03-17 3.17进展更新
2021-03-18 3.18进展更新
2021-03-25 1.图纸修改；2.新增采购合同；3.进展更新
    [3D打印费用合计.xlsx, 上骨架-改厚.SLDPRT, 上骨架-改锥型-2021.3.25.SLDPRT, 上骨架.STEP, 下骨架-改厚.SLDPRT, 下骨架.STEP, 前端盖.STEP, 前端盖C.STEP]
2021-03-25 更新图纸日志
2021-03-25 修改铜端子C型图纸
2021-03-25 增加铜端子dwg格式图纸
    [铜端子-2021.3.25-2004.dwg]
2021-03-26 1. 新增《吸尘器电机测试方案》文档；2. 2021.3.26进展更新
2021-03-31 新增图纸
    [3D打印费用合计.xlsx, 前端盖C（修改）.STEP, 吸尘器电机零部件库存明细.xlsx, 风罩-A型-晨光.SLDPRT, 风罩-A型-晨光.STEP, 风罩-戈雷姆-B型.SLDPRT, 风罩-戈雷姆-B型.STEP, 风罩.STEP]
2021-04-19 更新二轮测试
    [3D打印费用合计.xlsx, 3种电机零部件对比表.xlsx, 前端风罩-A型-晨光-加厚-塑料.SLDPRT, 前端风罩-A型-晨光-加厚-塑料.STEP, 后端盖-A型-晨光-测绘.SLDPRT, 后端盖-A型-晨光-测绘.STEP, 后端盖-B型-测绘-戈雷姆.SLDPRT, 后端盖-B型-测绘-戈雷姆.STEP]
2021-05-14 方案三更新
    [A型电机BOM（批量阶段）.xlsx, D27定子--吸尘器高速电机 - 副本.dwg, D27定子--吸尘器高速电机.dwg, M3螺母（厚）-A晨光-方案3.SLDPRT, M3螺母（厚）-A晨光.SLDPRT, R20-001电机包胶铁芯.SLDPRT, T型垫柱A-晨光-方案3.SLDPRT, T型垫柱A-晨光.SLDPRT]
2021-05-14 更新项目时间轴
2021-05-14 删除项目时间轴图片
2021-05-15 5.15更新电机测试结果
    [电机测试结果.xlsx]
2021-05-17 5.17电机测试结果
    [吸尘器电机测试记录.xlsx]
2021-05-18 上传吸尘器客户信息
    [吸尘器客户-卢方国.xlsx]
2021-05-18 上传XMY电机信息
2021-05-19 更新方案四定子图纸
    [26外径4极身宽度-定子.dwg]
2021-05-19 项目时间轴更新
2021-05-20 整理工程文件
    [吸尘器客户-卢方国.xlsx]
2021-05-21 更新接线端子图纸
    [铜端子-2021.5.21.dwg]
2021-05-22 增加pdf图纸
2021-05-22 方案四图纸确认
    [26外径4极身宽度.dwg, M3螺母（厚）-A晨光-方案3-方案4.SLDPRT, T型垫柱A-晨光-方案3-方案4.SLDPRT, 前端盖.STEP, 前端盖A-晨光-设计-2021.4.16+圆周筋条-方案3-方案4.SLDPRT, 前端风罩-A型-晨光-加厚-塑料+导风槽-方案3-方案4.SLDPRT, 前端风罩-塑料-斜面-方案3-方案4.SLDPRT, 前端风罩-塑料-方案3-方案4.SLDPRT]
2021-05-22 更新项目进展时间轴
2021-05-24 增加方案四图纸说明
    [26外径4极身宽度.dwg]
2021-05-25 更新测温仪资料
2021-05-25 更新采购合同
    [3D打印费用合计.xlsx]
2021-05-26 整理图纸
    [26外径4极身宽度-定子.dwg, 26外径4极身宽度.dwg, D27定子--吸尘器高速电机.dwg, M3螺母（厚）-A晨光-方案3-方案4.SLDPRT, M3螺母（厚）-A晨光-方案3.SLDPRT, M3螺母（厚）-A晨光.SLDPRT, T型垫柱A-晨光-方案3-方案4.SLDPRT, T型垫柱A-晨光-方案3.SLDPRT]
2021-05-26 更新文件结构
    [26外径4极身宽度-定子.dwg, 26外径4极身宽度.dwg, M3螺母（厚）-A晨光-方案3-方案4.SLDPRT, M3螺母（厚）-A晨光-方案3.SLDPRT, M3螺母（厚）-A晨光.SLDPRT, T型垫柱A-晨光-方案3-方案4.SLDPRT, T型垫柱A-晨光-方案3.SLDPRT, T型垫柱A-晨光.SLDPRT]
2021-05-27 更新测试数据和项目时间轴
    [电机测试结果.xlsx]
2021-05-27 新增加点胶槽的图纸
    [前端盖-A型-方案4-加点胶槽.SLDPRT, 后端盖-A型-方案4-加点胶槽.SLDPRT]
2021-05-27 更新电机测试结果
    [电机测试结果.xlsx]
2021-05-29 更新BOM清单
    [A型电机BOM（批量阶段）.xlsx, 前端盖.STEP, 后端盖.STEP, 电机测试结果.xlsx, 电机绕线骨架1.STEP, 电机绕线骨架2.STEP, 风罩.STEP]
2021-06-03 更新进展
    [吸尘器电机-晨光-2021.3.23.dwg, 吸尘器电机-晨光.dwg]
2021-06-08 更新项目合同
    [A型电机BOM（批量阶段）.xlsx, T型垫柱+M3厚螺母-2004.dwg, 铜端子-2021.5.21.dwg]
2021-06-10 新增塑料分析报告
2021-06-11 更新图纸
    [上骨架.SLDPRT, 下骨架.SLDPRT, 前端盖.SLDPRT, 前端盖.STEP, 前端盖A-RT-自扣结构.SLDPRT, 前端风罩-塑料-斜面-RT--自扣结构.SLDPRT, 后端盖.SLDPRT, 后端盖.STEP]
2021-06-16 更新报价合同
    [A型电机BOM（批量阶段）.xlsx, 上骨架.STEP, 下骨架.STEP, 前端盖.STEP, 后端盖.STEP, 塑料模具报价清单-发发.xlsx, 塑料模具报价清单-龚师傅.xlsx, 塑料模具报价清单.xlsx]
2021-06-18 增加波形垫圈图纸
    [波形垫圈5.6x8x0.15.SLDPRT, 波形垫圈5.6x8x0.15.STEP, 波形垫圈8x5.6x0.15.dwg]
2021-06-21 更新方案五图纸
    [M3螺母（厚）-RT-方案5.SLDPRT, T型垫柱A-RT-方案5.SLDPRT, φ26.8定子.dwg, 前端盖.STEP, 前端盖A-RT-自扣结构+改进-方案5.SLDPRT, 前端风罩-塑料-斜面-RT--自扣结构-方案5.SLDPRT, 叶片-1-RT-方案5.SLDPRT, 后端盖-A型-晨光-测绘+圆周定位-方案3-方案4-方案5.SLDPRT]
2021-06-30 新增图纸&报价合同
    [塑料模具报价清单-余姚.xlsx, 总装配体-吸尘器电机-RT-2004.dwg, 总装配体-吸尘器电机-RT.DWG, 总装配体-吸尘器电机.dwg]
2021-07-06 新增命名规范；更新图纸&BOM表
    [8666B40003 定子冲片.dwg, 8666B40004 定子冲片.dwg, 8668B40003 定子铁芯组件.dwg, 8668B40004 定子铁芯组件.dwg, A型电机BOM（批量阶段）.xlsx, φ26.8定子.dwg, 总装配体-吸尘器电机-RT-2021-7-5-2004.dwg, 总装配体-吸尘器电机-RT-2021-7-5.DWG]
2021-07-10 新增注塑合同；新增专诚达2工位绕线机报价
    [塑料模具报价清单-余姚.xlsx, 塑料模具报价清单-发发.xlsx, 塑料模具报价清单-龚师傅.xlsx]
2021-07-13 新增资料
2021-07-13 调整文件结构
2021-07-14 更新BOM表；更新报价单
    [A型电机BOM（批量阶段）.xlsx, 前端盖A（不带加强筋）.SLDPRT, 前端盖（带加强筋）.SLDPRT, 风罩.SLDPRT]
2021-07-19 新增深圳专诚达报价单
2021-07-20 新增小风机BOM表
    [小风机BOM.xlsx, 崔总小风机BOM.xlsx]
2021-07-22 新增BOM表
    [前端盖-加定位标记.SLDPRT, 定子组件.dwg, 崔总小风机BOM.xlsx, 崔总小风机BOM重新评估后.xlsx, 戴总小电机BOM.xlsx, 风罩-加定位标记.SLDPRT]
2021-07-22 归档定子组件图纸
    [M3螺母（厚）-RT-方案5.SLDPRT, T型垫柱A-RT-方案5.SLDPRT, 前端盖A-RT-自扣结构+改进-方案5.SLDPRT, 前端风罩-塑料-斜面-RT--自扣结构-方案5.SLDPRT, 叶片-1-RT-方案5.SLDPRT, 后端盖-A型-晨光-测绘+圆周定位-方案3-方案4-方案5.SLDPRT, 圆垫片3x15x1-RT-方案5.SLDPRT, 定子组件.dwg]
2021-07-23 新增定稿图纸；新增绕线机确认合同
    [M3螺母（厚）-RT-方案5.SLDPRT, T型垫柱A-RT-方案5.SLDPRT, φ26.8定子.dwg, 前端盖A-RT-自扣结构+改进-方案5.SLDPRT, 前端风罩-塑料-斜面-RT--自扣结构-方案5.SLDPRT, 叶片-1-RT-方案5.SLDPRT, 后端盖-A型-晨光-测绘+圆周定位-方案3-方案4-方案5.SLDPRT, 圆垫片3x15x1-RT-方案5.SLDPRT]
2021-07-28 更新图纸和合同
2021-07-28 更新合同；创建费用明细
    [来电科技前期投入费用汇总.xlsx]
2021-08-13 新增驱动板开发需求文档
    [永磁体供应商.xlsx, 电路板外形图.dwg]
2021-08-21 新增生产规范
    [60W电机PCB板.dwg, ZJ-WI-001-01抽樣計划.xls, 供应商信息模版.xlsx, 抽樣計划.xls, 首件检验记录表.xls]
